david-deboer/hera-cad/Node/PCB/PCB022618/README.txt

The DSUB9 cutouts on the front panel are too small for the connectors.
For the connectors to fit properly, file out 20 mills on each angled side
of the cutout.
