david-deboer/hera-cad/graphics/IMG_1570.jpg

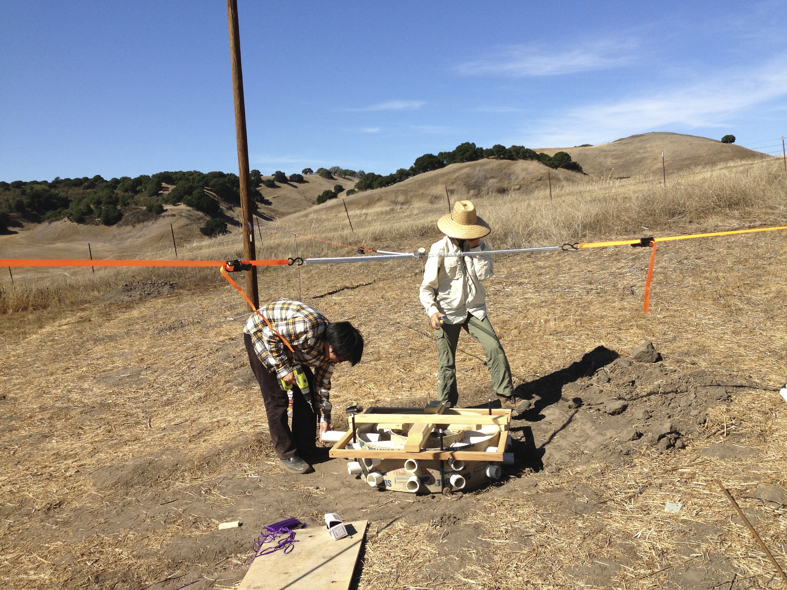
graphics/IMG_1570.jpg
