david-deboer/hera-cad/HERAbackdrop.jpg

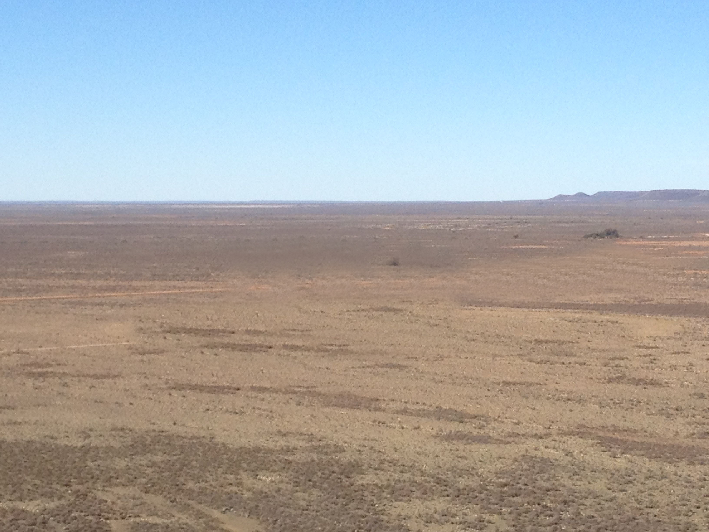
HERAbackdrop.jpg
