david-deboer/hera-cad/Node/Concept-ICTS/ICTS-20170411/image001.jpg

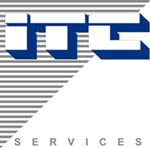
Node/Concept-ICTS/ICTS-20170411/image001.jpg
