david-deboer/hera-cad/Node/fullNewNode.png

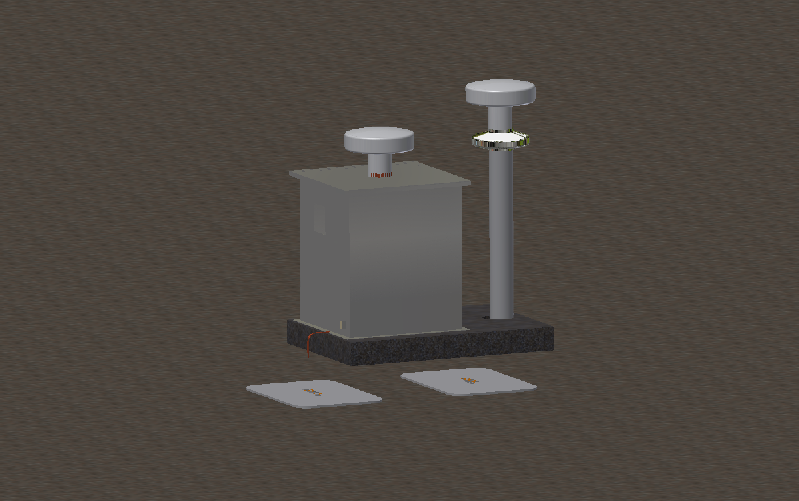
Node/fullNewNode.png
