david-deboer/hera-cad/Node/NMT/BB_OUTLINE.png

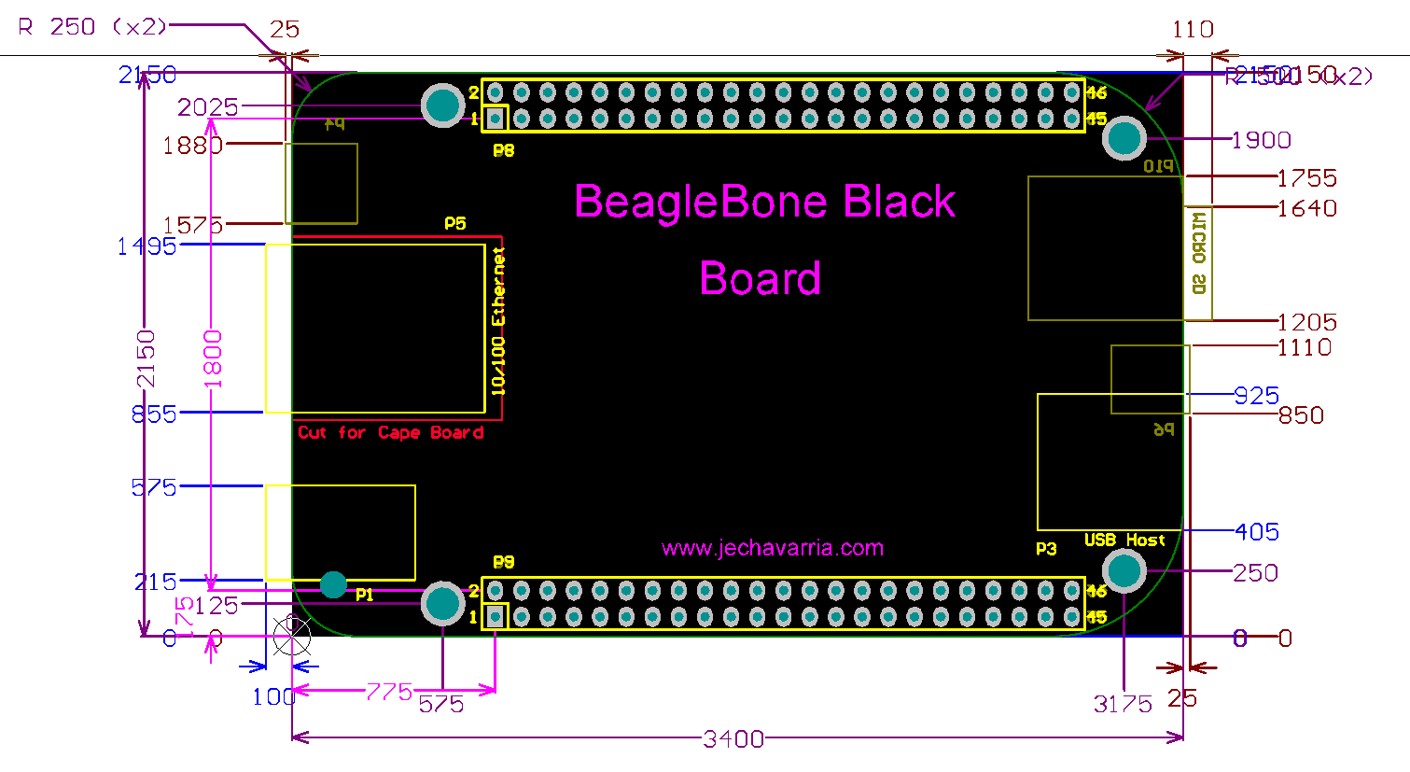
Node/NMT/BB_OUTLINE.png
