david-deboer/hera-cad/Node/node1.png

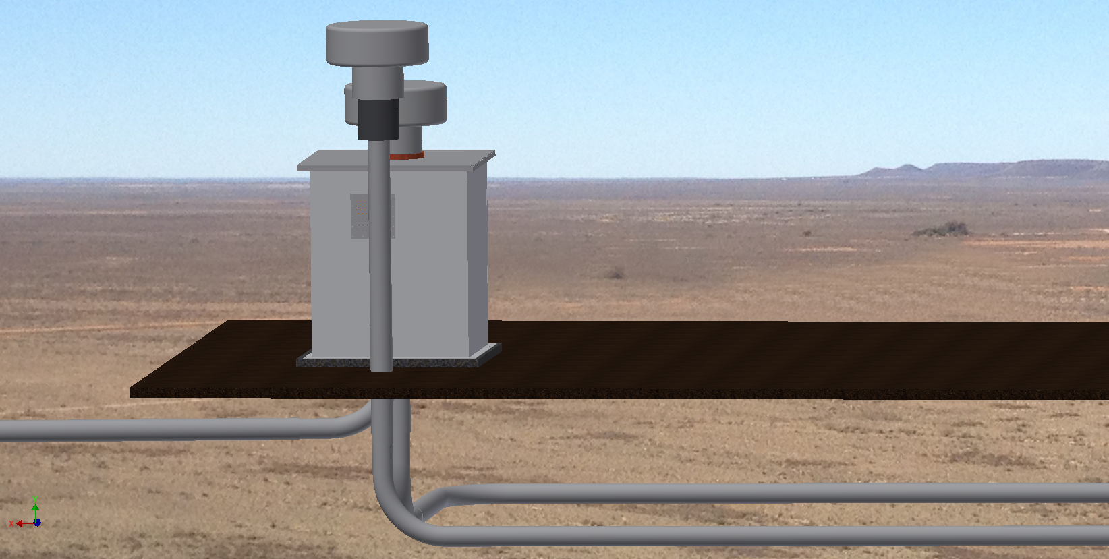
Node/node1.png
