david-deboer/hera-cad/Node/node3.png

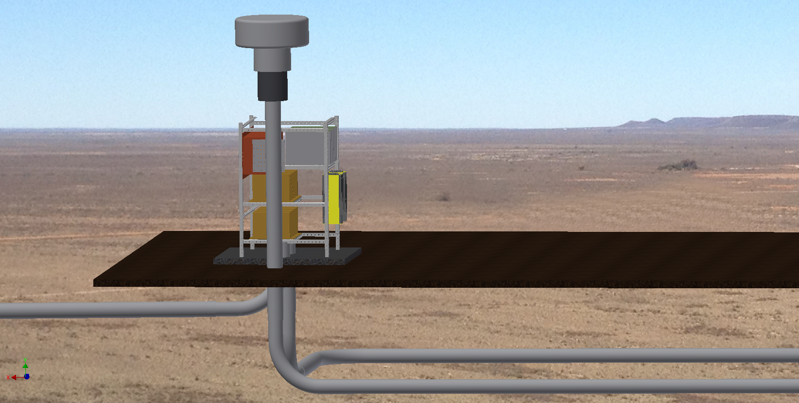
Node/node3.png
