david-deboer/hera-cad/Node/node4.png

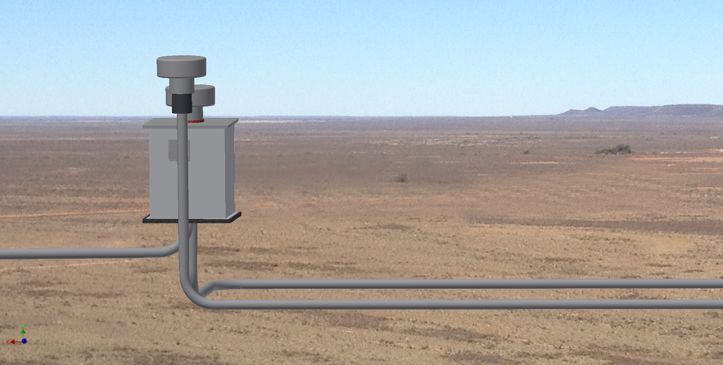
Node/node4.png
