david-deboer/hera-cad/Node/node_c.bmp

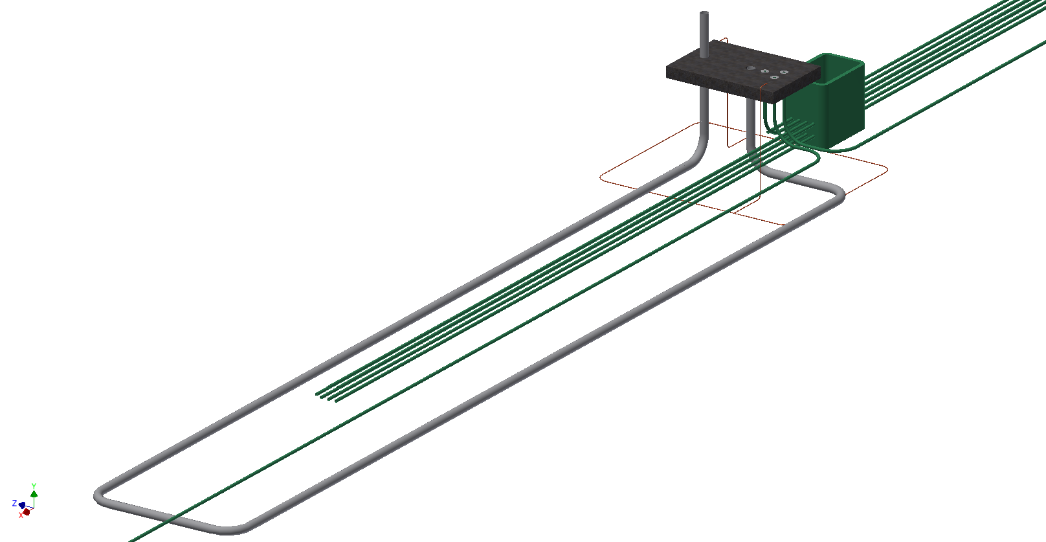
Node/node_c.bmp
