david-deboer/hera-cad/Node/PCB/PCB022618/arduino-pcb-mech-imperial.png

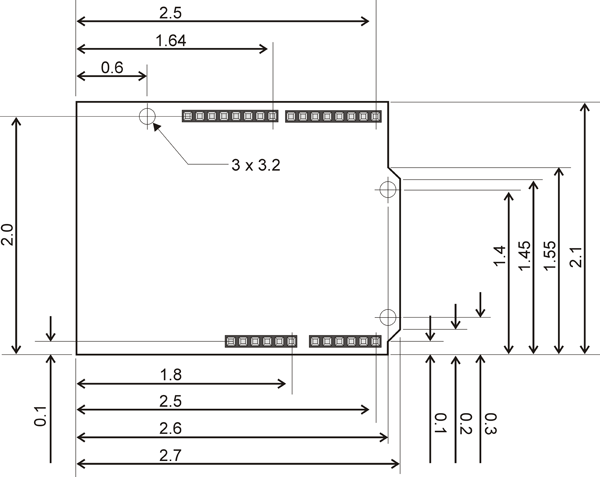
Node/PCB/PCB022618/arduino-pcb-mech-imperial.png
