david-deboer/hera-cad/PDFs/Node/grounding_layout2.PNG

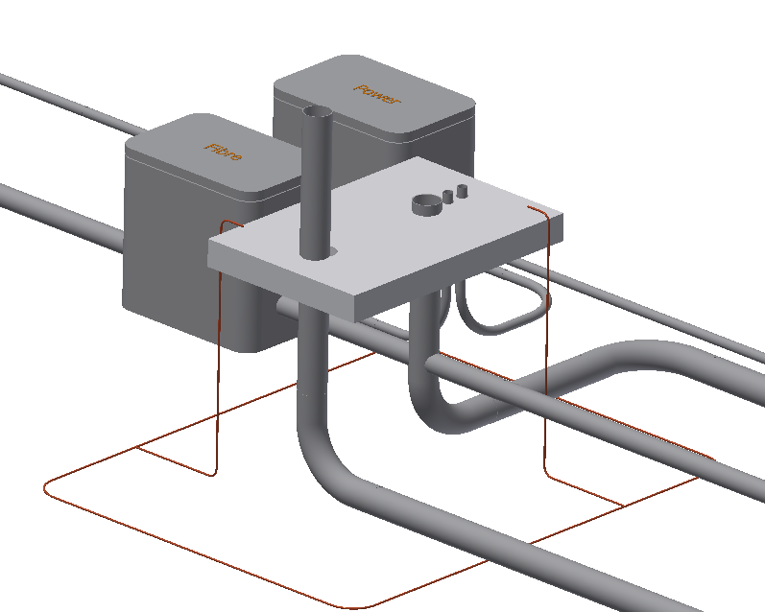
PDFs/Node/grounding_layout2.PNG
