david-deboer/hera-cad/PDFs/Node/grounding_layout.PNG

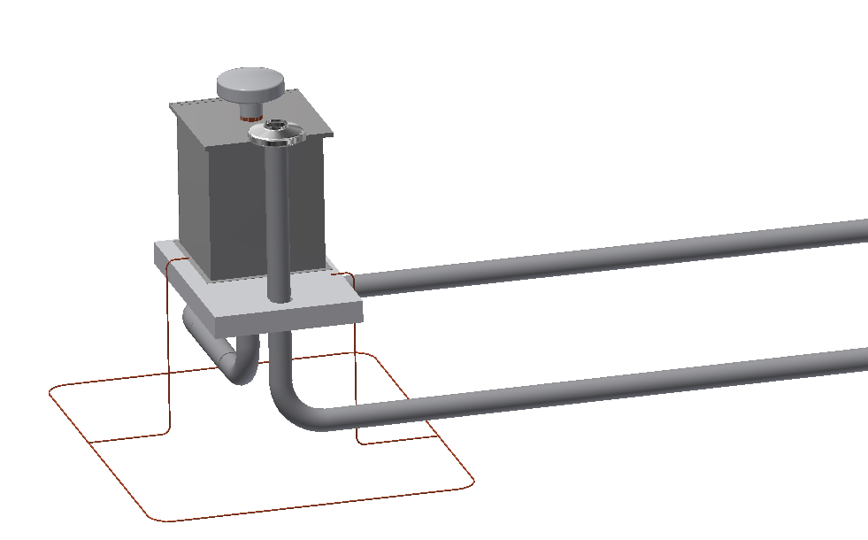
PDFs/Node/grounding_layout.PNG
