david-deboer/hera-cad/bom.xls

Sheet: PARTS LIST
ITEM | QTY | PART NUMBER | DESCRIPTION | ESTIMATED COST | FILE NAME
1 | 3 | 0D | anchor D for feed | $4.00 | D.ipt
2 | 24 | 0T2split | split 2" pvc T | $5.00 | pvc_T_2in_modSplit.ipt
3 | 19 | 0eye_ss_375 | 0.375 stainless eyebolt | $3.00 | *Varies*
4 | 1 | 0fasteners | catch all for fasteners | $200.00 | plat.ipt
5 | 1 | 0nut_ss_375 | 0.375 stainless nut | $0.30 | nut_ss_375.ipt
6 | 9 | 0pulley | feed pulley | $5.00 | pulley.ipt
7 | 6 | 0pvc_T_0.75 | 3/4" PVC Tee | $1.00 | pvc_T_0.75in.ipt
8 | 24 | 0pvc_T_2in | Support PVC T | $3.00 | pvc_T_2in.ipt
9 | 6 | 0spring | feed strong spring | $8.00 | spring.ipt
13 | 4 | 2f1ah | Arm holder | $5.00 | dipoleArmHold.ipt
14 | 4 | 2f1ar | Feed arm pipe rest | $8.00 | dipoleArmRest.ipt
15 | 4 | 2f1arm | Feed arm pipe | $8.00 | dipoleArm.ipt
16 | 2 | 2f1bd | Feed bottom disk | $10.00 | *Varies*
17 | 2 | 2f1col | Feed mast collar | $30.00 | collar.ipt
18 | 4 | 2f1ds | Feed disk spacer | $2.00 | dipoleDiscSpacer.ipt
19 | 1 | 2f1mast | Feed mast | $1.00 | dipoleMast.ipt
21 | 1 | 2f2al | Feed backplane support crosspiece | $20.00 | bpSupCross.ipt
22 | 6 | 2f2ao | Feed backplane support cross piece | $10.00 | bpSupOuter.ipt
23 | 6 | 2f2arc | feed backplane pvc arc | $2.00 | bpSupArc.ipt
24 | 2 | 2f2ax1 | Feed backplane support interior piece | $10.00 | bpSupInner1.ipt
25 | 2 | 2f2ax2 | Feed backplane support interior piece 2 | $10.00 | bpSupInner2.ipt
26 | 6 | 2f2barm | PVC arm for feed backplane | $2.00 | bpSupArm.ipt
27 | 1 | 2f2surf | Feed backplane conducting surface | $10.00 | bpScreen.ipt
28 | 1 | 2f3kcl | feed central tension line | $5.00 | centralLine.ipt
29 | 1 | 2f3lna | Feed lna dummy load | $250.00 | lna.ipt
30 | 1 | 2h1sin | Hub inner sonotube | $5.00 | sonotubeInner.ipt
31 | 1 | 2h1sout | Hub outer sonotube | $15.00 | sonotubeOuter.ipt
32 | 1 | 2h2cond | Hub signal/power conduit | $1.00 | conduit.ipt
33 | 24 | 2h2slv | Hub mating sleeve | $1.00 | *Varies*
34 | 1 | 2h3rbb | Hub rebar cross bar | $1.00 | rebarbar.ipt
35 | 1 | 2h3rbc | Hub rebar circle | $1.00 | rebarcircle.ipt
36 | 1 | 2h4cem | Hub cement | $8.00 | cement.ipt
38 | 21 | 2p1h37 | end holder 37 degree | $10.00 | end37.ipt
39 | 21 | 2p1hh | end horizontal holder | $20.00 | endHoriz.ipt
42 | 3 | 2p2kfs | Kevlar feed support | $5.00 | kevlarFeed.ipt
43 | 3 | 2p2pol | support pole | $60.00 | pole.ipt
44 | 9 | 2p2ps37 | Pole stand support 37 degree | $4.00 | poleStand37.ipt
45 | 9 | 2p2ps45 | pole stand support 45 degree | $2.00 | poleStand45.ipt
46 | 9 | 2p2psh1 | pole stand support horizontal 1 | $2.00 | poleStandHoriz1.ipt
47 | 9 | 2p2psh2 | pole stand support horizontal 2 | $2.00 | poleStandHoriz2.ipt
48 | 9 | 2p2psh3 | Pole stand support horizontal 3 | $2.00 | poleStandHoriz3.ipt
49 | 9 | 2p2psv | Pole stand vertical support | $2.00 | poleStandVert.ipt
52 | 9 | 2p3cem | Support stand cement | $10.00 | postCement.ipt
54 | 9 | 2p3post | Support stand post | $20.00 | post.ipt
55 | 9 | 2p3pse | post screen extender | $10.00 | postExtender.ipt
56 | 27 | 2p3reb | Support stand rebar | $0.20 | postRebar.ipt
58 | 9 | 2p3sono | Support stand sonotube | $3.00 | postSonotube.ipt
59 | 12 | 2p4irsh | intermediate rim spar holder | $5.00 | rimIntermediateSparHolder.ipt
60 | 12 | 2p4rim | rim piece | $10.00 | rimHoriz.ipt
61 | 12 | 2p5Tmod | modified 2" support pvc | $8.00 | pvc_T_2in_modPipe.ipt
62 | 12 | 2p5rss | Hub radial support spar | $3.20 | sparHoriz.ipt
63 | 12 | 2p5vss | support vertical spar | $2.00 | sparVert.ipt
66 | 12 | 2r1isp | 2" PVC radial spar (24') | $18.00 | sparIntermediate.ipt
68 | 24 | 2r2scs | spar cross support holder | $1.00 | cross.ipt
69 | 12 | 2r3pA | surface panel A | $15.00 | panelA.ipt
70 | 24 | 2r3pB | surface panel B | $15.00 | *Varies*
71 | 24 | 2r3pC | surface panel C | $10.00 | panelC.ipt
72 | 24 | 2r3pD | surface panel D | $10.00 | panelD.ipt
73 | 24 | 2r3pE | surface panel E | $10.00 | panelE.ipt
74 | 12 | 2r4sci | screen - intermediate | $20.00 | screenInt.ipt
81 | 18 | 1p2poscr | Pole screen holder | $10.00 | *Varies*
86 | 12 | heightMarker |  |  | heightMarker.ipt
88 | 1 | ramp |  |  | ramp.ipt
89 | 21 | endWoodblock |  |  | endWoodblock.ipt
91 | 12 | 2r1spar | full pvc spar | $25.00 | sparFull.ipt
92 | 24 | 2p6fs1 | inner furring strip | $1.00 | furringStrip1.ipt
93 | 24 | 2p6fs2 | second furring strip | $1.00 | furringStrip2.ipt
94 | 1 | matingBoard |  |  | matingBoard.ipt
95 | 21 | endChannelB |  |  | endChannel.ipt
96 | 21 | endChannel_MIR |  |  | endChannel_MIR.ipt
97 | 21 | endBlock |  |  | endBlock.ipt
98 | 2.854 in | 9916-BLK.Wire1 | 9916-BLK |  | feedAssembly.ShortRF.iam
99 | 2.559 in | 9916-BLK.Wire2 | 9916-BLK |  | feedAssembly.ShortRF.iam
100 | 2.773 in | 9916-BLK.Wire3 | 9916-BLK |  | feedAssembly.ShortRF.iam
101 | 2.867 in | 9916-BLK.Wire4 | 9916-BLK |  | feedAssembly.ShortRF.iam
102 | 3 | 0winch | winch to hoist feed | $25.00 | winch.ipt
103 | 3 | 0wrab | thick right angle for winch | $8.00 | thickRightAngle.ipt
104 | 1 | totalStation |  |  | totalStation.ipt
105 | 1 | vertex |  |  | vertex.ipt
106 | 21 | endcapTarget |  |  | endcapTarget.ipt
107 | 21 | screw_10 |  |  | screw_8.ipt
108 | 27 | washer_3_8 |  |  | washer_3-8.ipt
109 | 27 | lagBolt_38 |  |  | lagBolt_3-8.ipt
110 | 21 | angleBracket |  |  | angleBracket.ipt
113 | 9 | feedCableStay1 |  |  | feedCableStay1.ipt
114 | 9 | feedCableStay2 |  |  | feedCableStay2.ipt
115 | 12 | 2p3ph | post horizontal holder | $2.00 | postStandHoriz.ipt
116 | 12 | 2p3s37 | Post stand support 37 degree | $1.00 | postStand37.ipt
117 | 3 | kevlarCentering |  |  | centeringKevlar.ipt
118 | 1 | ringCentering |  |  | centeringRing.ipt
119 | 4 | hubjig_side1 |  |  | *Varies*
120 | 2 | hubjig_cross |  |  | hubjig_cross.ipt
121 | 2 | hubjig_spacer |  |  | hubjig_spacer.ipt
122 | 2 | hubjig_blocks |  |  | hubjig_block.ipt
123 | 4 | hubjig_tab |  |  | hubjig_tab.ipt
124 | 12 | sparSplit2_5 |  |  | sparSplit2_5.ipt

Sheet: PARTS_LIST
ITEM | QTY | PART NUMBER | DESCRIPTION | ESTIMATED COST | FILE NAME
1 | 3 | 0D | anchor D for feed | $4.00 | D.ipt
2 | 24 | 0T2split | split 2" pvc T | $5.00 | pvc_T_2in_modSplit.ipt
3 | 19 | 0eye_ss_375 | 0.375 stainless eyebolt | $3.00 | *Varies*
4 | 1 | 0fasteners | catch all for fasteners | $200.00 | plat.ipt
5 | 1 | 0nut_ss_375 | 0.375 stainless nut | $0.30 | nut_ss_375.ipt
6 | 9 | 0pulley | feed pulley | $5.00 | pulley.ipt
7 | 6 | 0pvc_T_0.75 | 3/4" PVC Tee | $1.00 | pvc_T_0.75in.ipt
8 | 24 | 0pvc_T_2in | Support PVC T | $3.00 | pvc_T_2in.ipt
9 | 6 | 0spring | feed strong spring | $8.00 | spring.ipt
13 | 4 | 2f1ah | Arm holder | $5.00 | dipoleArmHold.ipt
14 | 4 | 2f1ar | Feed arm pipe rest | $8.00 | dipoleArmRest.ipt
15 | 4 | 2f1arm | Feed arm pipe | $8.00 | dipoleArm.ipt
16 | 2 | 2f1bd | Feed bottom disk | $10.00 | *Varies*
17 | 2 | 2f1col | Feed mast collar | $30.00 | collar.ipt
18 | 4 | 2f1ds | Feed disk spacer | $2.00 | dipoleDiscSpacer.ipt
19 | 1 | 2f1mast | Feed mast | $1.00 | dipoleMast.ipt
21 | 1 | 2f2al | Feed backplane support crosspiece | $20.00 | bpSupCross.ipt
22 | 6 | 2f2ao | Feed backplane support cross piece | $10.00 | bpSupOuter.ipt
23 | 6 | 2f2arc | feed backplane pvc arc | $2.00 | bpSupArc.ipt
24 | 2 | 2f2ax1 | Feed backplane support interior piece | $10.00 | bpSupInner1.ipt
25 | 2 | 2f2ax2 | Feed backplane support interior piece 2 | $10.00 | bpSupInner2.ipt
26 | 6 | 2f2barm | PVC arm for feed backplane | $2.00 | bpSupArm.ipt
27 | 1 | 2f2surf | Feed backplane conducting surface | $10.00 | bpScreen.ipt
28 | 1 | 2f3kcl | feed central tension line | $5.00 | centralLine.ipt
29 | 1 | 2f3lna | Feed lna dummy load | $250.00 | lna.ipt
30 | 1 | 2h1sin | Hub inner sonotube | $5.00 | sonotubeInner.ipt
31 | 1 | 2h1sout | Hub outer sonotube | $15.00 | sonotubeOuter.ipt
32 | 1 | 2h2cond | Hub signal/power conduit | $1.00 | conduit.ipt
33 | 24 | 2h2slv | Hub mating sleeve | $1.00 | sleeve.ipt
34 | 1 | 2h3rbb | Hub rebar cross bar | $1.00 | rebarbar.ipt
35 | 1 | 2h3rbc | Hub rebar circle | $1.00 | rebarcircle.ipt
36 | 1 | 2h4cem | Hub cement | $8.00 | cement.ipt
38 | 21 | 2p1h37 | end holder 37 degree | $10.00 | end37.ipt
39 | 21 | 2p1hh | end horizontal holder | $20.00 | endHoriz.ipt
42 | 3 | 2p2kfs | Kevlar feed support | $5.00 | kevlarFeed.ipt
43 | 3 | 2p2pol | support pole | $60.00 | pole.ipt
44 | 9 | 2p2ps37 | Pole stand support 37 degree | $4.00 | poleStand37.ipt
45 | 9 | 2p2ps45 | pole stand support 45 degree | $2.00 | poleStand45.ipt
46 | 9 | 2p2psh1 | pole stand support horizontal 1 | $2.00 | poleStandHoriz1.ipt
47 | 9 | 2p2psh2 | pole stand support horizontal 2 | $2.00 | poleStandHoriz2.ipt
48 | 9 | 2p2psh3 | Pole stand support horizontal 3 | $2.00 | poleStandHoriz3.ipt
49 | 9 | 2p2psv | Pole stand vertical support | $2.00 | poleStandVert.ipt
52 | 9 | 2p3cem | Support stand cement | $10.00 | postCement.ipt
54 | 9 | 2p3post | Support stand post | $20.00 | post.ipt
55 | 9 | 2p3pse | post screen extender | $10.00 | postExtender.ipt
56 | 27 | 2p3reb | Support stand rebar | $0.20 | postRebar.ipt
58 | 9 | 2p3sono | Support stand sonotube | $3.00 | postSonotube.ipt
59 | 12 | 2p4irsh | intermediate rim spar holder | $5.00 | rimIntermediateSparHolder.ipt
60 | 12 | 2p4rim | rim piece | $10.00 | rimHoriz.ipt
61 | 12 | 2p5Tmod | modified 2" support pvc | $8.00 | pvc_T_2in_modPipe.ipt
62 | 12 | 2p5rss | Hub radial support spar | $3.20 | sparHoriz.ipt
63 | 12 | 2p5vss | support vertical spar | $2.00 | sparVert.ipt
66 | 12 | 2r1isp | 2" PVC radial spar (24') | $18.00 | sparIntermediate.ipt
68 | 24 | 2r2scs | spar cross support holder | $1.00 | cross.ipt
69 | 12 | 2r3pA | surface panel A | $15.00 | panelA.ipt
70 | 24 | 2r3pB | surface panel B | $15.00 | *Varies*
71 | 24 | 2r3pC | surface panel C | $10.00 | panelC.ipt
72 | 24 | 2r3pD | surface panel D | $10.00 | panelD.ipt
73 | 24 | 2r3pE | surface panel E | $10.00 | panelE.ipt
74 | 12 | 2r4sci | screen - intermediate | $20.00 | screenInt.ipt
81 | 18 | 1p2poscr | Pole screen holder | $10.00 | *Varies*
86 | 12 | heightMarker |  |  | heightMarker.ipt
88 | 1 | ramp |  |  | ramp.ipt
89 | 21 | endWoodblock |  |  | endWoodblock.ipt
91 | 12 | 2r1spar | full pvc spar | $25.00 | sparFull.ipt
92 | 24 | 2p6fs1 | inner furring strip | $1.00 | furringStrip1.ipt
93 | 24 | 2p6fs2 | second furring strip | $1.00 | furringStrip2.ipt
94 | 1 | matingBoard |  |  | matingBoard.ipt
95 | 21 | endChannelB |  |  | endChannel.ipt
96 | 21 | endChannel_MIR |  |  | endChannel_MIR.ipt
97 | 21 | endBlock |  |  | endBlock.ipt
98 | 2.854 in | 9916-BLK.Wire1 | 9916-BLK |  | feedAssembly.ShortRF.iam
99 | 2.559 in | 9916-BLK.Wire2 | 9916-BLK |  | feedAssembly.ShortRF.iam
100 | 2.773 in | 9916-BLK.Wire3 | 9916-BLK |  | feedAssembly.ShortRF.iam
101 | 2.867 in | 9916-BLK.Wire4 | 9916-BLK |  | feedAssembly.ShortRF.iam
102 | 3 | 0winch | winch to hoist feed | $25.00 | winch.ipt
103 | 3 | 0wrab | thick right angle for winch | $8.00 | thickRightAngle.ipt
104 | 1 | totalStation |  |  | totalStation.ipt
105 | 1 | vertex |  |  | vertex.ipt
106 | 21 | endcapTarget |  |  | endcapTarget.ipt
107 | 21 | screw_10 |  |  | screw_8.ipt
108 | 27 | washer_3_8 |  |  | washer_3-8.ipt
109 | 27 | lagBolt_38 |  |  | lagBolt_3-8.ipt
110 | 21 | angleBracket |  |  | angleBracket.ipt
113 | 9 | feedCableStay1 |  |  | feedCableStay1.ipt
114 | 9 | feedCableStay2 |  |  | feedCableStay2.ipt
115 | 12 | 2p3ph | post horizontal holder | $2.00 | postStandHoriz.ipt
116 | 12 | 2p3s37 | Post stand support 37 degree | $1.00 | postStand37.ipt
117 | 3 | kevlarCentering |  |  | centeringKevlar.ipt
118 | 1 | ringCentering |  |  | centeringRing.ipt
119 | 4 | hubjig_side1 |  |  | *Varies*
120 | 2 | hubjig_cross |  |  | hubjig_cross.ipt
121 | 2 | hubjig_spacer |  |  | hubjig_spacer.ipt
122 | 2 | hubjig_blocks |  |  | hubjig_block.ipt
123 | 4 | hubjig_tab |  |  | hubjig_tab.ipt
