david-deboer/hera-cad/procurement.xlsx

Sheet: PARTS_LIST
ITEM | QTY | PART NUMBER | DESCRIPTION | FILE NAME
1 | 1 | 0fasteners | catch all for fasteners | plat.ipt
2 | 1 | 2h | Hub | hub.iam
2.1 | 1 | 2h1sin | Hub inner sonotube | sonotubeInner.ipt | x
2.2 | 1 | 2h1sout | Hub outer sonotube | sonotubeOuter.ipt | x
2.3 | 1 | 2h2cond | Hub signal/power conduit | conduit.ipt
2.4 | 24 | 2h2slv | Hub mating sleeve | sleeve.ipt
2.5 | 1 | 2h3rbb | Hub rebar cross bar | rebarbar.ipt
2.6 | 1 | 2h3rbc | Hub rebar circle | rebarcircle.ipt
2.7 | 1 | 2h4cem | Hub cement | cement.ipt
3 | 3 | poleAssembly |  | poleAssembly.iam
3.1 | 1 | 2p2pol | support pole | pole.ipt
3.2 | 3 | poleStand |  | poleStandVertAssy.iam
3.2.1 | 1 | 2p2psv | Pole stand vertical support | poleStandVert.ipt
3.2.2 | 1 | 2p2ps45 | pole stand support 45 degree | poleStand45.ipt
3.2.3 | 1 | 2p2psh1 | pole stand support horizontal 1 | poleStandHoriz1.ipt
3.2.9 | 2 | 1p2poscr | Pole screen holder | *Varies*
3.2.10 | 3 | washer_3_8 |  | washer_3-8.ipt
3.2.11 | 3 | lagBolt_38 |  | lagBolt_3-8.ipt
3.3 | 6 | 0eye_ss_375 | 0.375 stainless eyebolt | *Varies*
3.5 | 1 | heightMarker |  | heightMarker.ipt
3.6 | 3 | poleStandHorizAssyB |  | poleStandHorizAssy.iam
3.7 | 3 | 0pulley | feed pulley | pulley.ipt
3.8 | 1 | winchAssembly |  | winchAssembly.iam
3.9 | 3 | feedCableStay |  | feedCableStay.iam
4 | 9 | postAssembly |  | postAssembly.iam
4.1 | 1 | 2p3sono | Support stand sonotube | postSonotube.ipt
4.2 | 3 | 2p3reb | Support stand rebar | postRebar.ipt
4.3 | 1 | 2p3post | Support stand post | post.ipt
4.4 | 1 | 2p3pse | post screen extender | postExtender.ipt
4.5 | 1 | 2p3cem | Support stand cement | postCement.ipt
4.9 | 1 | heightMarker |  | heightMarker.ipt
4.11 | 1 | postStandSupport |  | postStandSupport.iam
6 | 12 | sparAssembly |  | sparAssembly.iam
6.1 | 1 | 2p5rss | Hub radial support spar | sparHoriz.ipt
6.2 | 1 | 2p5Tmod | modified 2" support pvc | pvc_T_2in_modPipe.ipt
6.3 | 1 | 2p5vss | support vertical spar | sparVert.ipt
6.4 | 1 | 0pvc_T_2in | Support PVC T | pvc_T_2in.ipt
7 | 12 | crossAssembly |  | crossAssembly.iam
7.1 | 2 | 0T2split | split 2" pvc T | pvc_T_2in_modSplit.ipt
7.2 | 2 | 2r2scs | spar cross support holder | cross.ipt
7.3 | 1 | 0pvc_T_2in | Support PVC T | pvc_T_2in.ipt
8 | 12 | 2r1isp | 2" PVC radial spar (24') | sparIntermediate.ipt
9 | 12 | 2r3pA | surface panel A | panelA.ipt
10 | 24 | 2r3pE | surface panel E | panelE.ipt
11 | 12 | rimAssembly |  | rimAssembly.iam
11.1 | 1 | 2p4rim | rim piece | rimHoriz.ipt
11.2 | 1 | 2p4irsh | intermediate rim spar holder | rimIntermediateSparHolder.ipt
12 | 1 | 2f | Feed assembly | feedAssembly.iam
12.1 | 1 | 2f2 | Feed backplane support assembly | bpSupAssembly.iam
12.1.1 | 1 | 2f2al | Feed backplane support crosspiece | bpSupCross.ipt
12.1.2 | 6 | 2f2ao | Feed backplane support cross piece | bpSupOuter.ipt
12.1.3 | 2 | 2f2ax1 | Feed backplane support interior piece | bpSupInner1.ipt
12.1.4 | 2 | 2f2ax2 | Feed backplane support interior piece 2 | bpSupInner2.ipt
12.1.5 | 1 | 2f1col | Feed mast collar | collar.ipt
12.1.6 | 6 | 2f2barm | PVC arm for feed backplane | bpSupArm.ipt
12.1.7 | 1 | 0eye_ss_375 | 0.375 stainless eyebolt | eyebolt_ss_375.ipt
12.1.8 | 1 | 0nut_ss_375 | 0.375 stainless nut | nut_ss_375.ipt
12.1.9 | 6 | 0pvc_T_0.75 | 3/4" PVC Tee | pvc_T_0.75in.ipt
12.1.10 | 6 | 2f2arc | feed backplane pvc arc | bpSupArc.ipt
12.1.11 | 1 | 2f2surf | Feed backplane conducting surface | bpScreen.ipt
12.1.12 | 3 | 0D | anchor D for feed | D.ipt
12.2 | 1 | 2f1 | Feed dipole | dipole.iam
12.2.1 | 2 | 2f1bd | Feed bottom disk | *Varies*
12.2.3 | 4 | 2f1arm | Feed arm pipe | dipoleArm.ipt
12.2.4 | 4 | 2f1ds | Feed disk spacer | dipoleDiscSpacer.ipt
12.2.6 | 1 | 2f1col | Feed mast collar | collar.ipt
12.2.7 | 1 | 2f1mast | Feed mast | dipoleMast.ipt
12.2.8 | 4 | 2f1ah | Arm holder | dipoleArmHold.ipt
12.2.9 | 4 | 2f1ar | Feed arm pipe rest | dipoleArmRest.ipt
12.2.10 | 1 | matingBoard |  | matingBoard.ipt
12.3 | 1 | 2f3lna | Feed lna dummy load | lna.ipt
12.4 | 3 | 0spring | feed strong spring | spring.ipt
12.5 | 1 | 2f3kcl | feed central tension line | centralLine.ipt
12.7 | 1 | feedAssembly.ShortRF |  | feedAssembly.ShortRF.iam
14 | 3 | 2p2kfs | Kevlar feed support | kevlarFeed.ipt
21 | 24 | 2r3pB | surface panel B | *Varies*
22 | 24 | 2r3pC | surface panel C | panelC.ipt
23 | 24 | 2r3pD | surface panel D | panelD.ipt
24 | 12 | 2r4sci | screen - intermediate | screenInt.ipt
26 | 1 | ramp |  | ramp.ipt
27 | 12 | 2r1spar | full pvc spar | sparFull.ipt
28 | 24 | 2p6fs1 | inner furring strip | furringStrip1.ipt
29 | 24 | 2p6fs2 | second furring strip | furringStrip2.ipt
30 | 1 | totalStation |  | totalStation.ipt
31 | 1 | vertex |  | vertex.ipt
33 | 3 | postStandSupport |  | postStandSupport.iam
34 | 1 | centering |  | centering.iam
35 | 1 | hubjig |  | hubjig.iam

Sheet: Procurement
Poles
30 | 7+ m | 6-8" diameter
 |  |  |  |  | Meters needed
Hubs
25 | 1' | 36" sonotube (in 10" lengths)
25 | 1' | 18" sonotube (in 10" lengths)
30 | 10' | 3"conduit (in 12" lengths) |  |  | 7.62
40 | 10' | 2.5" conduit (in 12" lengths) |  |  | 10.16
20 | 10' | 3/8" rebar
PVC
1775 | 10' | 2" sch 40 pvc | 71 |  | 450.85
1500 |  | 2" T | 60
900 |  | 2" couplers | 36
 |  |  |  | 741.68 | 914.4

Sheet: SA
 |  |  |  | Antenna Number
Item | qty | #/antenna | qty/antenna | 19 | 37 | 91 | 331 | 352 | Unit
spar (long) | 7.45 | 12 | 89.4 | 1698.6 | 3307.8 | 8135.4 | 29591.4 | 31468.8 | m
spar (short) | 3.07 | 12 | 36.84 | 699.96 | 1363.08 | 3352.44 | 12194.04 | 12967.68 | m
support (horiz) | 3 | 12 | 36 | 684 | 1332 | 3276 | 11916 | 12672 | m
support (vert) | 0.5 | 12 | 6 | 114 | 222 | 546 | 1986 | 2112 | m
63mm PVC-M class 20 | 14.02 | 12 | 168.24 | 3196.56 | 6224.88 | 15309.84 | 55687.44 | 59220.48 | m
90mm PVC-M class 20 | 0.3 | 12 | 3.6 | 68.4 | 133.2 | 327.6 | 1191.6 | 1267.2 | m
63mm T couplers | 1 | 12 | 12 | 228 | 444 | 1092 | 3972 | 4224 | m
63mm couplers | 1 | 12 | 12 | 228 | 444 | 1092 | 3972 | 4224 | m
rim (wood 40x150mm x 3.7m) | 3.66 | 12 | 43.92 | 834.48 | 1625.04 | 3996.72 | 14537.52 | 15459.84 | m
concrete | 1 | 1 | 1 | 19 | 37 | 91 | 331 | 352 | m3
poles |  |  |  | 27 | 48 | 108 | 363 | 426 | #
posts | 3 |  |  | 129 | 243 | 579 | 2049 | 2238 | #
mesh (10x10mm welded square - 1.2m rolls) | 180 | 1 | 180 | 3420 | 6660 | 16380 | 59580 | 63360 | m2
chicken wire (1.5m rolls?) | 131.9468915 | 1 | 131.9468915 | 2506.990938 | 4882.034984 | 12007.16712 | 43674.42107 | 46445.30579 | m2
kevlar guy line | 12 | 3 | 36 | 684 | 1332 | 3276 | 11916 | 12672 | m
high-tension springs | 1 | 3 | 3 | 57 | 111 | 273 | 993 | 1056 | #
feed backplanes (assembled light structure) | 1 | 1 | 1 | 19 | 37 | 91 | 331 | 352 | #
feed support plate (welded structure) | 1 | 1 | 1 | 19 | 37 | 91 | 331 | 352 | #
ratchet hoist | 1 | 3 |  | 81 | 144 | 324 | 1089 | 1278 | #
support endcaps (welded structure) | 1 | 12 | 12 | 228 | 444 | 1092 | 3972 | 4224 | #
