david-deboer/hera-cad/Node/SNAP_V2/Design Data/XLS/en-US/Thread.xls

Sheet: ANSI Unified Screw Threads
I Q | ANSI Unified Screw Threads |  | Sort Order -1 |  | External |  |  |  |  |  |  | Internal
 |  |  |  |  |  | Major Dia |  | Pitch Dia |  | Minor Dia |  |  | Minor Dia |  | Pitch Dia |  | Major Dia |  | Tap Drill
Size | Size Suffix | Thread Designation | Custom Thread Designation | TPI | Class | Max | Min | Max | Min | Max | Min | Class | Min | Max | Min | Max | Min | Max | Basic
0.0118 |  | 30-318 UNM | 30-318 UNM | 318 | 2A | 0.0118 | 0.0112 | 0.0098 | 0.0092 | 0.0080 |  | 2B | 0.0085 | 0.0100 | 0.0098 | 0.0103 | 0.0120 |  | 0.0083
0.0138 |  | 35-282 UNM | 35-282 UNM | 282 | 2A | 0.0138 | 0.0131 | 0.0115 | 0.0109 | 0.0095 |  | 2B | 0.0101 | 0.0117 | 0.0115 | 0.0121 | 0.0140 |  | 0.0096
0.0157 |  | 40-254 UNM | 40-254 UNM | 254 | 2A | 0.0157 | 0.0150 | 0.0132 | 0.0126 | 0.0110 |  | 2B | 0.0117 | 0.0134 | 0.0132 | 0.0138 | 0.0160 |  | 0.0110
0.0177 |  | 45-254 UNM | 45-254 UNM | 254 | 2A | 0.0177 | 0.0170 | 0.0152 | 0.0145 | 0.0130 |  | 2B | 0.0136 | 0.0154 | 0.0152 | 0.0158 | 0.0180 |  | 0.0124
0.0197 |  | 50-203 UNM | 50-203 UNM | 203 | 2A | 0.0197 | 0.0189 | 0.0165 | 0.0158 | 0.0138 |  | 2B | 0.0146 | 0.0166 | 0.0165 | 0.0172 | 0.0200 |  | 0.0138
0.021 |  | 0000-160 NS | 0000-160 NS | 160 | 2A | 0.021 | 0.0195 | 0.0169 | 0.0158 | 0.0128 |  | 2B | 0.0169 | 0.0181 | 0.0169 | 0.0181 | 0.021
0.0217 |  | 55-203 UNM | 55-203 UNM | 203 | 2A | 0.0217 | 0.0208 | 0.0185 | 0.0178 | 0.0157 |  | 2B | 0.0165 | 0.0186 | 0.0185 | 0.0192 | 0.0220 |  | 0.0150
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
2.25 |  | 2 1/4-6 UN | 2 1/4-6 UN | 6 | 3A | 2.25 | 2.2318 | 2.1417 | 2.1351 | 2.0516 |  | 3B | 2.07 | 2.0896 | 2.1417 | 2.1502 | 2.25 |  | 2.0938
2.25 |  | 2 1/4-8 UN | 2 1/4-8 UN | 8 | 2A | 2.2476 | 2.2326 | 2.1664 | 2.1584 | 2.0988 |  | 2B | 2.115 | 2.14 | 2.1688 | 2.1792 | 2.25 |  | 2.125

Sheet: Inch Tapping Threads
I Q X | Inch Tapping Threads |  | Sort Order - 5 |  | External |  |  |  |  |  |  | Internal
 |  |  |  |  |  | Major Dia |  | Pitch Dia |  | Minor Dia |  |  | Minor Dia |  | Pitch Dia |  | Major Dia |  | Tap Drill
Size | Size Suffix | Thread Designation | Custom Thread Designation | TPI | Class | Max | Min | Max | Min | Max | Min | Class | Min | Max | Min | Max | Min | Max | Basic
0.0600 |  | 0-48 | 0-48 | 48 | 2B | 0.0600 | 0.0540 | 0.0480 | 0.0435 | 0.0360 | 0.0330
0.0730 |  | 1-42 | 1-42 | 42 | 2B | 0.0750 | 0.0690 | 0.0620 | 0.0575 | 0.0490 | 0.0460
0.0860 |  | 2-32 | 2-32 | 32 | 2B | 0.0880 | 0.0820 | 0.0760 | 0.0710 | 0.0640 | 0.0600
0.0990 |  | 3-28 | 3-28 | 28 | 2B | 0.1010 | 0.0950 | 0.0880 | 0.0830 | 0.0750 | 0.0710
0.1120 |  | 4-24 | 4-24 | 24 | 2B | 0.1140 | 0.1080 | 0.1000 | 0.0950 | 0.0860 | 0.0820
0.1250 |  | 5-20 | 5-20 | 20 | 2B | 0.1300 | 0.1230 | 0.1120 | 0.1065 | 0.0940 | 0.0900
0.1380 |  | 6-20 | 6-20 | 20 | 2B | 0.1390 | 0.1320 | 0.1215 | 0.1155 | 0.1040 | 0.0990
0.1510 |  | 7-19 | 7-19 | 19 | 2B | 0.1540 | 0.1470 | 0.1345 | 0.1280 | 0.1150 | 0.1090
0.1640 |  | 8-18 | 8-18 | 18 | 2B | 0.1660 | 0.1590 | 0.1440 | 0.1375 | 0.1220 | 0.1160
0.1900 |  | 10-16 | 10-16 | 16 | 2B | 0.1890 | 0.1820 | 0.1650 | 0.1585 | 0.1410 | 0.1350
0.2160 |  | 12-14 | 12-14 | 14 | 2B | 0.2150 | 0.2080 | 0.1895 | 0.1825 | 0.1640 | 0.1570
0.2420 |  | 14-14 | 14-14 | 14 | 2B | 0.2410 | 0.2340 | 0.2130 | 0.2060 | 0.1850 | 0.1780
0.2500 |  | 1/4-14 | 1/4-14 | 14 | 2B | 0.2460 | 0.2370 | 0.2190 | 0.2110 | 0.1920 | 0.1850
0.3125 |  | 5/16-12 | 5/16-12 | 12 | 2B | 0.3150 | 0.3060 | 0.2795 | 0.2710 | 0.2440 | 0.2360
0.3750 |  | 3/8-12 | 3/8-12 | 12 | 2B | 0.3800 | 0.3710 | 0.3445 | 0.3350 | 0.3090 | 0.2990
0.4375 |  | 7/16-10 | 7/16-10 | 10 | 2B | 0.4400 | 0.4290 | 0.3995 | 0.3890 | 0.3590 | 0.3490
0.5000 |  | 1/2-10 | 1/2-10 | 10 | 2B | 0.5040 | 0.4930 | 0.4635 | 0.4530 | 0.4230 | 0.4130

Sheet: Metric Forming Screw Threads
M P X | Metric Forming Screw Threads |  | Sort Order - 6 |  | External |  |  |  |  |  |  | Internal
 |  |  |  |  |  | Major Dia |  | Pitch Dia |  | Minor Dia |  |  | Minor Dia |  | Pitch Dia |  | Major Dia |  | Tap Drill
Size | Size Suffix | Thread Designation | Custom Thread Designation | Pitch | Class | Max | Min | Max | Min | Max | Min | Class | Min | Max | Min | Max | Min | Max | Basic
1.5 |  | 1.5x0.5 | 1.5x0.5 | 0.5 | 6g | 1.520 | 1.380 | 1.215 | 1.110 | 0.910 | 0.840
1.5 |  | ST1.5x0.5 | ST1.5x0.5 | 0.5 | 6g | 1.520 | 1.380 | 1.215 | 1.110 | 0.910 | 0.840
1.9 |  | 1.9x0.6 | 1.9x0.6 | 0.6 | 6g | 1.900 | 1.760 | 1.570 | 1.465 | 1.240 | 1.170
1.9 |  | ST1.9x0.6 | ST1.9x0.6 | 0.6 | 6g | 1.900 | 1.760 | 1.570 | 1.465 | 1.240 | 1.170
2.2 |  | 2.2x0.8 | 2.2x0.8 | 0.8 | 6g | 2.240 | 2.100 | 1.935 | 1.810 | 1.630 | 1.520
2.2 |  | ST2.2x0.8 | ST2.2x0.8 | 0.8 | 6g | 2.240 | 2.100 | 1.935 | 1.810 | 1.630 | 1.520
2.6 |  | 2.6x0.9 | 2.6x0.9 | 0.9 | 6g | 2.570 | 2.430 | 2.235 | 2.115 | 1.900 | 1.800
2.6 |  | ST2.6x0.9 | ST2.6x0.9 | 0.9 | 6g | 2.570 | 2.430 | 2.235 | 2.115 | 1.900 | 1.800
2.9 |  | 2.9x1 | 2.9x1 | 1 | 6g | 2.900 | 2.760 | 2.540 | 2.420 | 2.180 | 2.080
2.9 |  | 2.9x1.1 | 2.9x1.1 | 1.1 | 6g | 2.900 | 2.760 | 2.540 | 2.420 | 2.180 | 2.080
2.9 |  | ST2.9x1.1 | ST2.9x1.1 | 1.1 | 6g | 2.900 | 2.760 | 2.540 | 2.420 | 2.180 | 2.080
2.9 |  | 2.9x1.3 | 2.9x1.3 | 1.3 | 6g | 2.900 | 2.720 | 2.540 | 2.355 | 1.890 | 1.700
2.9 |  | 2.9x1.4 | 2.9x1.4 | 1.4 | 6g | 2.900 | 2.720 | 2.340 | 2.175 | 1.780 | 1.630
3.3 |  | 3.3x1.3 | 3.3x1.3 | 1.3 | 6g | 3.300 | 3.120 | 2.795 | 2.665 | 2.290 | 2.210
3.3 |  | ST3.3x1.3 | ST3.3x1.3 | 1.3 | 6g | 3.300 | 3.120 | 2.795 | 2.665 | 2.290 | 2.210
3.5 |  | 3.5x1.3 | 3.5x1.3 | 1.3 | 6g | 3.530 | 3.350 | 3.085 | 2.930 | 2.640 | 2.510
3.5 |  | ST3.5x1.3 | ST3.5x1.3 | 1.3 | 6g | 3.530 | 3.350 | 3.085 | 2.930 | 2.640 | 2.510
3.5 |  | 3.5x1.6 | 3.5x1.6 | 1.6 | 6g | 3.530 | 3.350 | 2.920 | 2.755 | 2.310 | 2.160
3.5 |  | 3.5x3.2 | 3.5x3.2 | 3.2 | 6g | 3.530 | 3.310 | 2.800 | 2.600 | 2.070 | 1.890
3.9 |  | 3.9x1.3 | 3.9x1.3 | 1.3 | 6g | 3.910 | 3.730 | 3.415 | 3.250 | 2.920 | 2.770
3.9 |  | ST3.9x1.3 | ST3.9x1.3 | 1.3 | 6g | 3.910 | 3.730 | 3.415 | 3.250 | 2.920 | 2.770
3.9 |  | 3.9x1.6 | 3.9x1.6 | 1.6 | 6g | 3.910 | 3.730 | 3.300 | 3.135 | 2.690 | 2.540
3.9 |  | 3.9x3.2 | 3.9x3.2 | 3.2 | 6g | 3.910 | 3.690 | 3.180 | 2.980 | 2.450 | 2.270
4.2 |  | 4.2x1.4 | 4.2x1.4 | 1.4 | 6g | 4.220 | 4.040 | 3.660 | 3.495 | 3.100 | 2.950
4.2 |  | ST4.2x1.4 | ST4.2x1.4 | 1.4 | 6g | 4.220 | 4.040 | 3.660 | 3.495 | 3.100 | 2.950
4.2 |  | 4.2x1.6 | 4.2x1.6 | 1.6 | 6g | 4.220 | 4.040 | 3.610 | 3.445 | 3.000 | 2.850
4.2 |  | 4.2x3.2 | 4.2x3.2 | 3.2 | 6g | 4.220 | 4.000 | 3.380 | 3.180 | 2.540 | 2.360
4.8 |  | 4.8x1.6 | 4.8x1.6 | 1.6 | 6g | 4.800 | 4.620 | 4.190 | 4.025 | 3.580 | 3.430
4.8 |  | ST4.8x1.6 | ST4.8x1.6 | 1.6 | 6g | 4.800 | 4.620 | 4.190 | 4.025 | 3.580 | 3.430
4.8 |  | 4.8x1.8 | 4.8x1.8 | 1.8 | 6g | 4.800 | 4.620 | 4.065 | 3.885 | 3.330 | 3.150
4.8 |  | 4.8x3.2 | 4.8x3.2 | 3.2 | 6g | 4.800 | 4.580 | 3.960 | 3.760 | 3.120 | 2.940
5.5 |  | 5.5x1.8 | 5.5x1.8 | 1.8 | 6g | 5.460 | 5.280 | 4.815 | 4.635 | 4.170 | 3.990
5.5 |  | ST5.5x1.8 | ST5.5x1.8 | 1.8 | 6g | 5.460 | 5.280 | 4.815 | 4.635 | 4.170 | 3.990
6.3 |  | 6.3x1.8 | 6.3x1.8 | 1.8 | 6g | 6.250 | 6.030 | 5.565 | 5.365 | 4.880 | 4.700
6.3 |  | ST6.3x1.8 | ST6.3x1.8 | 1.8 | 6g | 6.250 | 6.030 | 5.565 | 5.365 | 4.880 | 4.700
8.0 |  | 8x2.1 | 8x2.1 | 2.1 | 6g | 8.000 | 7.780 | 7.100 | 6.885 | 6.200 | 5.990
8.0 |  | ST8x2.1 | ST8x2.1 | 2.1 | 6g | 8.000 | 7.780 | 7.100 | 6.885 | 6.200 | 5.990
9.5 |  | 9.5x2.1 | 9.5x2.1 | 2.1 | 6g | 9.650 | 9.430 | 8.750 | 8.510 | 7.850 | 7.590
9.5 |  | ST9.5x2.1 | ST9.5x2.1 | 2.1 | 6g | 9.650 | 9.430 | 8.750 | 8.510 | 7.850 | 7.590

Sheet: ISO Pipe Threads
M Q | ISO Pipe Threads |  | Sort Order - 9 |  | External |  |  |  |  |  |  | Internal
 |  |  |  |  |  | Major Dia |  | Pitch Dia |  | Minor Dia |  |  | Minor Dia |  | Pitch Dia |  | Major Dia |  | Tap Drill
Size | Size Suffix | Thread Designation | Custom Thread Designation | TPI | Class | Max | Min | Max | Min | Max | Min | Class | Min | Max | Min | Max | Min | Max | Basic
7.723 |  | G7.723x0.907 | G 1/16 | 28 | A | 7.723 | 7.509 | 7.142 | 7.035 | 6.561 |  |  | 6.561 | 6.834 | 7.142 | 7.249 | 7.723 |  | 1.5875
7.723 |  | G7.723x0.907 | G 1/16 | 28 | B | 7.723 | 7.509 | 7.142 | 6.928 | 6.561
9.728 |  | G9.728x0.907 | G 1/8 | 28 | A | 9.728 | 9.514 | 9.147 | 9.040 | 8.566 |  |  | 8.566 | 8.848 | 9.147 | 9.254 | 9.728 |  | 3.1750
9.728 |  | G9.728x0.907 | G 1/8 | 28 | B | 9.728 | 9.514 | 9.147 | 8.933 | 8.566
13.157 |  | G13.157x1.337 | G 1/4 | 19 | A | 13.157 | 12.907 | 12.301 | 12.176 | 11.445 |  |  | 11.445 | 11.89 | 12.301 | 12.426 | 13.157 |  | 6.3500
13.157 |  | G13.157x1.337 | G 1/4 | 19 | B | 13.157 | 12.907 | 12.301 | 12.051 | 11.445
16.662 |  | G16.662x1.337 | G 3/8 | 19 | A | 16.662 | 16.412 | 15.806 | 15.681 | 14.950 |  |  | 14.95 | 15.395 | 15.806 | 15.931 | 16.662 |  | 9.5250
16.662 |  | G16.662x1.337 | G 3/8 | 19 | B | 16.662 | 16.412 | 15.806 | 15.556 | 14.950
20.955 |  | G20.955x1.814 | G 1/2 | 14 | A | 20.955 | 20.671 | 19.793 | 19.651 | 18.631 |  |  | 18.631 | 19.172 | 19.793 | 19.935 | 20.955 |  | 12.7000
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
151.130 |  | G151.13x2.309 | G 5 1/2 | 11 | A | 151.130 | 150.696 | 149.651 | 149.434 | 148.172 |  |  | 148.172 | 148.812 | 149.651 | 149.868 | 151.130 |  | 139.7000
151.130 |  | G151.13x2.309 | G 5 1/2 | 11 | B | 151.130 | 150.696 | 149.651 | 149.217 | 148.172
163.830 |  | G163.83x2.309 | G 6 | 11 | A | 163.830 | 163.396 | 162.351 | 162.134 | 160.872 |  |  | 160.872 | 161.512 | 162.351 | 162.568 | 163.830 |  | 152.4000
163.830 |  | G163.83x2.309 | G 6 | 11 | B | 163.830 | 163.396 | 162.351 | 161.917 | 160.872

Sheet: JIS Pipe Threads
M Q | JIS Pipe Threads |  | Sort Order -12 |  | External |  |  |  |  |  |  | Internal
 |  |  |  |  |  | Major Dia |  | Pitch Dia |  | Minor Dia |  |  | Minor Dia |  | Pitch Dia |  | Major Dia |  | Tap Drill
Size | Size Suffix | Thread Designation | Custom Thread Designation | TPI | Class | Max | Min | Max | Min | Max | Min | Class | Min | Max | Min | Max | Min | Max | Basic
7.723 |  | G7.723x0.907 | G 1/16 | 28 | A | 7.723 | 7.509 | 7.142 | 7.035 | 6.561 |  |  | 6.561 | 6.834 | 7.142 | 7.249 | 7.723 |  | 1.5875
7.723 |  | G7.723x0.907 | G 1/16 | 28 | B | 7.723 | 7.509 | 7.142 | 6.928 | 6.561
9.728 |  | G9.728x0.907 | G 1/8 | 28 | A | 9.728 | 9.514 | 9.147 | 9.040 | 8.566 |  |  | 8.566 | 8.848 | 9.147 | 9.254 | 9.728 |  | 3.1750
9.728 |  | G9.728x0.907 | G 1/8 | 28 | B | 9.728 | 9.514 | 9.147 | 8.933 | 8.566
13.157 |  | G13.157x1.337 | G 1/4 | 19 | A | 13.157 | 12.907 | 12.301 | 12.176 | 11.445 |  |  | 11.445 | 11.89 | 12.301 | 12.426 | 13.157 |  | 6.3500
13.157 |  | G13.157x1.337 | G 1/4 | 19 | B | 13.157 | 12.907 | 12.301 | 12.051 | 11.445
16.662 |  | G16.662x1.337 | G 3/8 | 19 | A | 16.662 | 16.412 | 15.806 | 15.681 | 14.950 |  |  | 14.95 | 15.395 | 15.806 | 15.931 | 16.662 |  | 9.5250
16.662 |  | G16.662x1.337 | G 3/8 | 19 | B | 16.662 | 16.412 | 15.806 | 15.556 | 14.950
20.955 |  | G20.955x1.814 | G 1/2 | 14 | A | 20.955 | 20.671 | 19.793 | 19.651 | 18.631 |  |  | 18.631 | 19.172 | 19.793 | 19.935 | 20.955 |  | 12.7000
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
151.130 |  | G151.13x2.309 | G 5 1/2 | 11 | A | 151.130 | 150.696 | 149.651 | 149.434 | 148.172 |  |  | 148.172 | 148.812 | 149.651 | 149.868 | 151.130 |  | 139.7000
151.130 |  | G151.13x2.309 | G 5 1/2 | 11 | B | 151.130 | 150.696 | 149.651 | 149.217 | 148.172
163.830 |  | G163.83x2.309 | G 6 | 11 | A | 163.830 | 163.396 | 162.351 | 162.134 | 160.872 |  |  | 160.872 | 161.512 | 162.351 | 162.568 | 163.830 |  | 152.4000
163.830 |  | G163.83x2.309 | G 6 | 11 | B | 163.830 | 163.396 | 162.351 | 161.917 | 160.872

Sheet: DIN Pipe Threads
M Q | DIN Pipe Threads |  | Sort Order - 18 |  | External |  |  |  |  |  |  | Internal
 |  |  |  |  |  | Major Dia |  | Pitch Dia |  | Minor Dia |  |  | Minor Dia |  | Pitch Dia |  | Major Dia |  | Tap Drill
Size | Size Suffix | Thread Designation | Custom Thread Designation | TPI | Class | Max | Min | Max | Min | Max | Min | Class | Min | Max | Min | Max | Min | Max | Basic
7.723 |  | G7.723x0.907 | G 1/16 | 28 | A | 7.723 | 7.509 | 7.142 | 7.035 | 6.561 |  |  | 6.561 | 6.834 | 7.142 | 7.249 | 7.723 |  | 1.5875
7.723 |  | G7.723x0.907 | G 1/16 | 28 | B | 7.723 | 7.509 | 7.142 | 6.928 | 6.561
9.728 |  | G9.728x0.907 | G 1/8 | 28 | A | 9.728 | 9.514 | 9.147 | 9.040 | 8.566 |  |  | 8.566 | 8.848 | 9.147 | 9.254 | 9.728 |  | 3.1750
9.728 |  | G9.728x0.907 | G 1/8 | 28 | B | 9.728 | 9.514 | 9.147 | 8.933 | 8.566
13.157 |  | G13.157x1.337 | G 1/4 | 19 | A | 13.157 | 12.907 | 12.301 | 12.176 | 11.445 |  |  | 11.445 | 11.89 | 12.301 | 12.426 | 13.157 |  | 6.3500
13.157 |  | G13.157x1.337 | G 1/4 | 19 | B | 13.157 | 12.907 | 12.301 | 12.051 | 11.445
16.662 |  | G16.662x1.337 | G 3/8 | 19 | A | 16.662 | 16.412 | 15.806 | 15.681 | 14.950 |  |  | 14.95 | 15.395 | 15.806 | 15.931 | 16.662 |  | 9.5250
16.662 |  | G16.662x1.337 | G 3/8 | 19 | B | 16.662 | 16.412 | 15.806 | 15.556 | 14.950
20.955 |  | G20.955x1.814 | G 1/2 | 14 | A | 20.955 | 20.671 | 19.793 | 19.651 | 18.631 |  |  | 18.631 | 19.172 | 19.793 | 19.935 | 20.955 |  | 12.7000
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
151.130 |  | G151.13x2.309 | G 5 1/2 | 11 | A | 151.130 | 150.696 | 149.651 | 149.434 | 148.172 |  |  | 148.172 | 148.812 | 149.651 | 149.868 | 151.130 |  | 139.7000
151.130 |  | G151.13x2.309 | G 5 1/2 | 11 | B | 151.130 | 150.696 | 149.651 | 149.217 | 148.172
163.830 |  | G163.83x2.309 | G 6 | 11 | A | 163.830 | 163.396 | 162.351 | 162.134 | 160.872 |  |  | 160.872 | 161.512 | 162.351 | 162.568 | 163.830 |  | 152.4000
163.830 |  | G163.83x2.309 | G 6 | 11 | B | 163.830 | 163.396 | 162.351 | 161.917 | 160.872

Sheet: BSP Pipe Threads
M Q | BSP Pipe Threads |  | Sort Order - 19 |  | External |  |  |  |  |  |  | Internal
 |  |  |  |  |  | Major Dia |  | Pitch Dia |  | Minor Dia |  |  | Minor Dia |  | Pitch Dia |  | Major Dia |  | Tap Drill
Size | Size Suffix | Thread Designation | Custom Thread Designation | TPI | Class | Max | Min | Max | Min | Max | Min | Class | Min | Max | Min | Max | Min | Max | Basic
1/16 |  | G 1/16-28 | G 1/16-28 | 28 | A | 7.723 | 7.509 | 7.142 | 7.035 | 6.561 |  |  | 6.561 | 6.834 | 7.142 | 7.249 | 7.723 |  | 6.6000
1/16 |  | G 1/16-28 | G 1/16-28 | 28 | B | 7.723 | 7.509 | 7.142 | 7.035 | 6.561
1/8 |  | G 1/8-28 | G 1/8-28 | 28 | A | 9.728 | 9.514 | 9.147 | 9.040 | 8.566 |  |  | 8.566 | 8.848 | 9.147 | 9.254 | 9.728 |  | 8.7300
1/8 |  | G 1/8-28 | G 1/8-28 | 28 | B | 9.728 | 9.514 | 9.147 | 9.040 | 8.566
1/4 |  | G 1/4-19 | G 1/4-19 | 19 | A | 13.157 | 12.907 | 12.301 | 12.176 | 11.445 |  |  | 11.445 | 11.89 | 12.301 | 12.426 | 13.157 |  | 11.8000
1/4 |  | G 1/4-19 | G 1/4-19 | 19 | B | 13.157 | 12.907 | 12.301 | 12.176 | 11.445
3/8 |  | G 3/8-19 | G 3/8-19 | 19 | A | 16.662 | 16.412 | 15.806 | 15.681 | 14.950 |  |  | 14.95 | 15.395 | 15.806 | 15.931 | 16.662 |  | 15.2500
3/8 |  | G 3/8-19 | G 3/8-19 | 19 | B | 16.662 | 16.412 | 15.806 | 15.681 | 14.950
1/2 |  | G 1/2-14 | G 1/2-14 | 14 | A | 20.955 | 20.671 | 19.793 | 19.651 | 18.631 |  |  | 18.631 | 19.172 | 19.793 | 19.935 | 20.955 |  | 19.0500
1/2 |  | G 1/2-14 | G 1/2-14 | 14 | B | 20.955 | 20.671 | 19.793 | 19.651 | 18.631
5/8 |  | G 5/8-14 | G 5/8-14 | 14 | A | 22.911 | 22.627 | 21.749 | 21.607 | 20.587 |  |  | 20.587 | 21.128 | 21.749 | 21.891 | 22.911 |  | 21.0000
5/8 |  | G 5/8-14 | G 5/8-14 | 14 | B | 22.911 | 22.627 | 21.749 | 21.607 | 20.587
3/4 |  | G 3/4-14 | G 3/4-14 | 14 | A | 26.441 | 26.157 | 25.279 | 25.137 | 24.117 |  |  | 24.117 | 24.658 | 25.279 | 25.421 | 26.441 |  | 24.5000
3/4 |  | G 3/4-14 | G 3/4-14 | 14 | B | 26.441 | 26.157 | 25.279 | 25.137 | 24.117
7/8 |  | G 7/8-14 | G 7/8-14 | 14 | A | 30.201 | 29.917 | 29.039 | 28.897 | 27.877 |  |  | 27.877 | 28.418 | 29.039 | 29.181 | 30.201 |  | 28.2500
7/8 |  | G 7/8-14 | G 7/8-14 | 14 | B | 30.201 | 29.917 | 29.039 | 28.897 | 27.877
1 |  | G 1-11 | G 1-11 | 11 | A | 33.249 | 32.889 | 31.770 | 31.590 | 30.291 |  |  | 30.291 | 30.931 | 31.77 | 31.95 | 33.249 |  | 30.7500
1 |  | G 1-11 | G 1-11 | 11 | B | 33.249 | 32.889 | 31.770 | 31.590 | 30.291
1 1/4 |  | G 1 1/4-11 | G 1 1/4-11 | 11 | A | 41.910 | 41.550 | 40.431 | 40.251 | 38.952 |  |  | 38.952 | 39.592 | 40.431 | 40.611 | 41.910 |  | 39.5000
1 1/4 |  | G 1 1/4-11 | G 1 1/4-11 | 11 | B | 41.910 | 41.550 | 40.431 | 40.251 | 38.952
1 1/2 |  | G 1 1/2-11 | G 1 1/2-11 | 11 | A | 47.803 | 47.443 | 46.324 | 46.144 | 44.845 |  |  | 44.845 | 45.485 | 46.324 | 46.504 | 47.803 |  | 45.5000
1 1/2 |  | G 1 1/2-11 | G 1 1/2-11 | 11 | B | 47.803 | 47.443 | 46.324 | 46.144 | 44.845
1 3/4 |  | G 1 3/4-11 | G 1 3/4-11 | 11 | A | 53.746 | 53.386 | 52.267 | 52.087 | 50.788 |  |  | 50.788 | 51.428 | 52.267 | 52.447 | 53.746 |  | 51.0000
1 3/4 |  | G 1 3/4-11 | G 1 3/4-11 | 11 | B | 53.746 | 53.386 | 52.267 | 52.087 | 50.788
2 |  | G 2-11 | G 2-11 | 11 | A | 59.614 | 59.254 | 58.135 | 57.955 | 56.656 |  |  | 56.656 | 57.296 | 58.135 | 58.315 | 59.614 |  | 57.0000
2 |  | G 2-11 | G 2-11 | 11 | B | 59.614 | 59.254 | 58.135 | 57.955 | 56.656

Sheet: GB Pipe Threads without seal
M Q | GB Pipe Threads |  | Sort Order - 23 |  | External |  |  |  |  |  |  | Internal
 |  |  |  |  |  | Major Dia |  | Pitch Dia |  | Minor Dia |  |  | Minor Dia |  | Pitch Dia |  | Major Dia |  | Tap Drill
Size | Size Suffix | Thread Designation | Custom Thread Designation | TPI | Class | Max | Min | Max | Min | Max | Min | Class | Min | Max | Min | Max | Min | Max | Basic
7.723 |  | G7.723x0.907 | G 1/16 | 28 | A | 7.723 | 7.509 | 7.142 | 7.035 | 6.561 |  |  | 6.561 | 6.834 | 7.142 | 7.249 | 7.723 |  | 1.5875
7.723 |  | G7.723x0.907 | G 1/16 | 28 | B | 7.723 | 7.509 | 7.142 | 6.928 | 6.561
9.728 |  | G9.728x0.907 | G 1/8 | 28 | A | 9.728 | 9.514 | 9.147 | 9.040 | 8.566 |  |  | 8.566 | 8.848 | 9.147 | 9.254 | 9.728 |  | 3.1750
9.728 |  | G9.728x0.907 | G 1/8 | 28 | B | 9.728 | 9.514 | 9.147 | 8.933 | 8.566
13.157 |  | G13.157x1.337 | G 1/4 | 19 | A | 13.157 | 12.907 | 12.301 | 12.176 | 11.445 |  |  | 11.445 | 11.89 | 12.301 | 12.426 | 13.157 |  | 6.3500
13.157 |  | G13.157x1.337 | G 1/4 | 19 | B | 13.157 | 12.907 | 12.301 | 12.051 | 11.445
16.662 |  | G16.662x1.337 | G 3/8 | 19 | A | 16.662 | 16.412 | 15.806 | 15.681 | 14.950 |  |  | 14.95 | 15.395 | 15.806 | 15.931 | 16.662 |  | 9.5250
16.662 |  | G16.662x1.337 | G 3/8 | 19 | B | 16.662 | 16.412 | 15.806 | 15.556 | 14.950
20.955 |  | G20.955x1.814 | G 1/2 | 14 | A | 20.955 | 20.671 | 19.793 | 19.651 | 18.631 |  |  | 18.631 | 19.172 | 19.793 | 19.935 | 20.955 |  | 12.7000
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
151.130 |  | G151.13x2.309 | G 5 1/2 | 11 | A | 151.130 | 150.696 | 149.651 | 149.434 | 148.172 |  |  | 148.172 | 148.812 | 149.651 | 149.868 | 151.130 |  | 139.7000
151.130 |  | G151.13x2.309 | G 5 1/2 | 11 | B | 151.130 | 150.696 | 149.651 | 149.217 | 148.172
163.830 |  | G163.83x2.309 | G 6 | 11 | A | 163.830 | 163.396 | 162.351 | 162.134 | 160.872 |  |  | 160.872 | 161.512 | 162.351 | 162.568 | 163.830 |  | 152.4000
163.830 |  | G163.83x2.309 | G 6 | 11 | B | 163.830 | 163.396 | 162.351 | 161.917 | 160.872

Sheet: AFBMA Standard Locknuts
I Q | AFBMA Standard Locknuts |  | Sort Order -24 |  | External |  |  |  |  |  |  | Internal
 |  |  |  |  |  | Major Dia |  | Pitch Dia |  | Minor Dia |  |  | Minor Dia |  | Pitch Dia |  | Major Dia |  | Tap Drill
Size | Size Suffix | Thread Designation | Custom Thread Designation | TPI | Class | Max | Min | Max | Min | Max | Min | Class | Min | Max | Min | Max | Min | Max | Basic
0.391 |  | N 00 | N 00-32 | 32 | 3A | 0.3910 | 0.3856 | 0.3707 | 0.3681 | 0.3527 |  | 3B | 0.3572 | 0.3606 | 0.3707 | 0.3733 | 0.3910 |  | 0.3527
0.469 |  | N 01 | N 01-32 | 32 | 3A | 0.4690 | 0.4636 | 0.4487 | 0.4461 | 0.4307 |  | 3B | 0.4352 | 0.4386 | 0.4487 | 0.4513 | 0.4690 |  | 0.4307
0.586 |  | N 02 | N 02-32 | 32 | 3A | 0.5860 | 0.5806 | 0.5657 | 0.5627 | 0.5477 |  | 3B | 0.5522 | 0.5556 | 0.5657 | 0.5687 | 0.5860 |  | 0.5477
0.664 |  | N 03 | N 03-32 | 32 | 3A | 0.6640 | 0.6586 | 0.6437 | 0.6407 | 0.6257 |  | 3B | 0.6302 | 0.6336 | 0.6437 | 0.6467 | 0.6640 |  | 0.6257
0.781 |  | N 04 | N 04-32 | 32 | 3A | 0.7810 | 0.7756 | 0.7607 | 0.7573 | 0.7427 |  | 3B | 0.7472 | 0.7506 | 0.7607 | 0.7641 | 0.7810 |  | 0.7427
0.969 |  | N 05 | N 05-32 | 32 | 3A | 0.9690 | 0.9636 | 0.9487 | 0.9453 | 0.9307 |  | 3B | 0.9352 | 0.9386 | 0.9487 | 0.9521 | 0.9690 |  | 0.9307
1.173 |  | N 06 | N 06-18 | 18 | 3A | 1.1730 | 1.1648 | 1.1369 | 1.1329 | 1.1048 |  | 3B | 1.1129 | 1.1189 | 1.1369 | 1.1409 | 1.1730 |  | 1.1048
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
7.066 |  | TAN 136 | TAN 136-8 | 8 | 3A | 7.0660 | 7.0508 | 6.9848 | 6.9757 | 6.9126
7.472 |  | TAN 138 | TAN 138-8 | 8 | 3A | 7.4720 | 7.4568 | 7.3908 | 7.3817 | 7.3186
7.847 |  | TAN 140 | TAN 140-8 | 8 | 3A | 7.8470 | 7.8318 | 7.7658 | 7.7544 | 7.6936
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
