david-deboer/hera-cad/hub/H1HO-B_a_hub_outer_sheetmetal.dxf

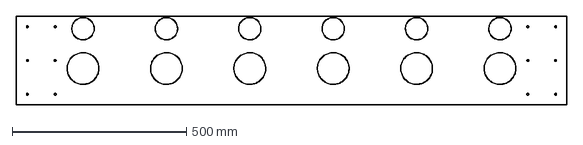
[picture p21: CAD file, 2016-02-03]
hub/H1HO-B_a_hub_outer_sheetmetal.dxf
1581.5 x 254.0 mm
