david-deboer/hera-cad/jigs/hubRingJig.stp

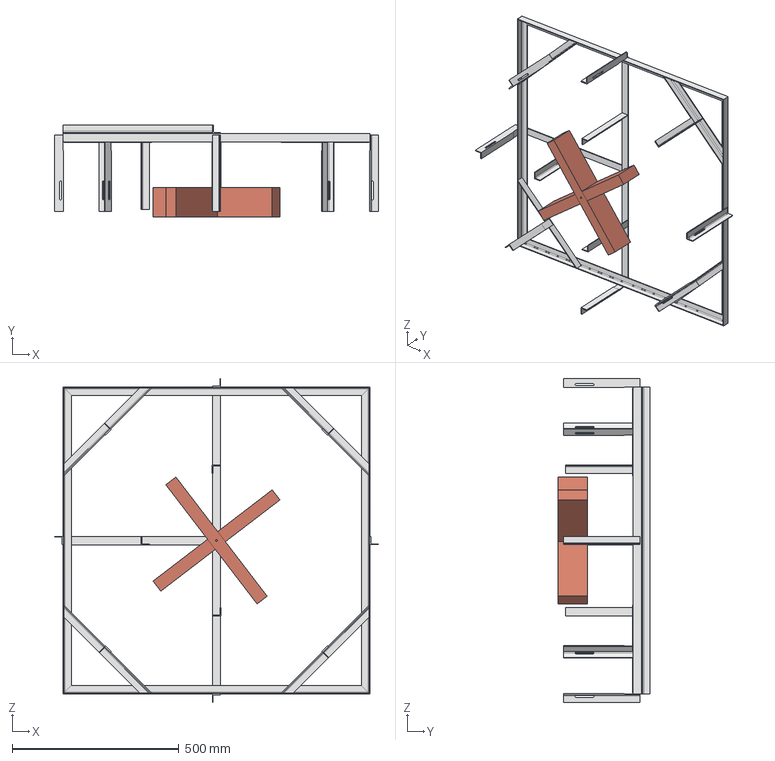
[picture p22: CAD file, 2015-01-15]
jigs/hubRingJig.stp
970.3 x 276.4 x 970.3 mm
