david-deboer/hera-cad/Node/Concept-ICTS/ICTS-20170411/ssl-version/waveguide.stp

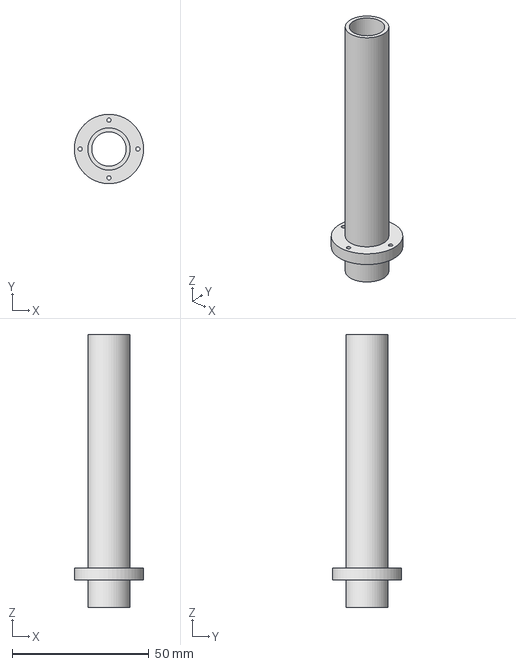
[picture p23: CAD file, 2017-11-21]
Node/Concept-ICTS/ICTS-20170411/ssl-version/waveguide.stp
25.4 x 25.4 x 100.0 mm
