david-deboer/hera-cad/Node/NMT/nmt_bottom.stp

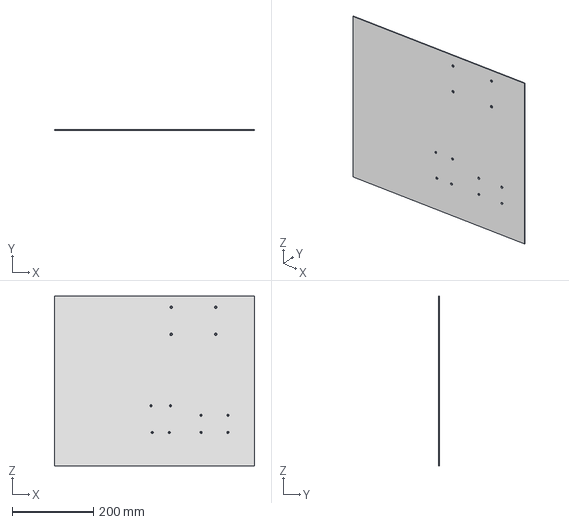
[picture p24: CAD file, 2017-03-25]
Node/NMT/nmt_bottom.stp
492.0 x 1.78 x 417.8 mm
