david-deboer/hera-cad/Node/SNAP_V2/Workspaces/Workspace/3d prototyping/dsub37_cutout_2052.stl

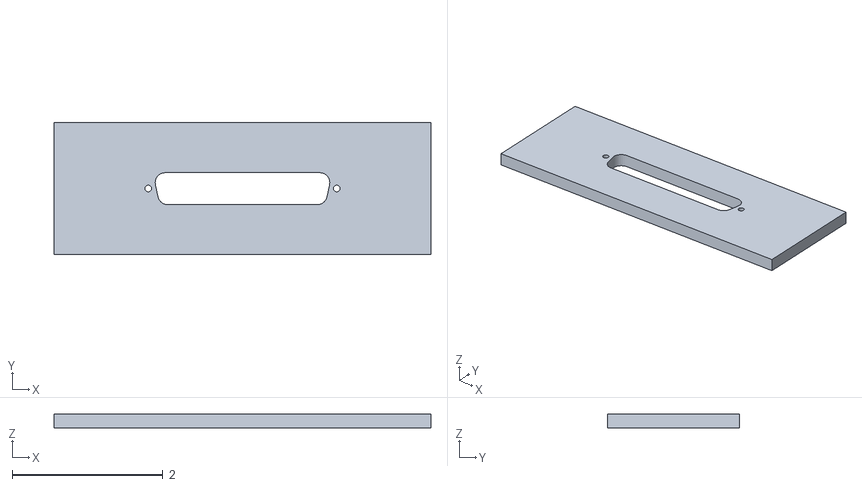
[picture p25: CAD file, 2016-11-03]
Node/SNAP_V2/Workspaces/Workspace/3d prototyping/dsub37_cutout_2052.stl
5.00 x 1.75 x 0.187
