david-deboer/hera-cad/Node/SNAP_V2/Workspaces/Workspace/components/ENG_CVM_CVM_745777-4_D.3d_stp/c-745777-4-d-3d.stp

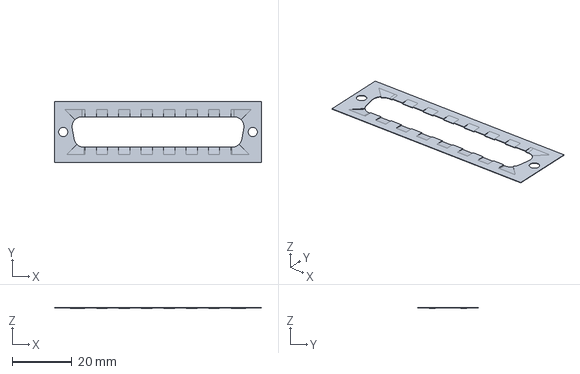
[picture p26: CAD file, 2016-10-25]
Node/SNAP_V2/Workspaces/Workspace/components/ENG_CVM_CVM_745777-4_D.3d_stp/c-745777-4-d-3d.stp
69.3 x 20.3 x 0.406 mm
