david-deboer/hera-cad/Node/SNAP_V2/Workspaces/Workspace/drawings/quote_step_031617/RFT 8x10 Cover-alt-base.stp

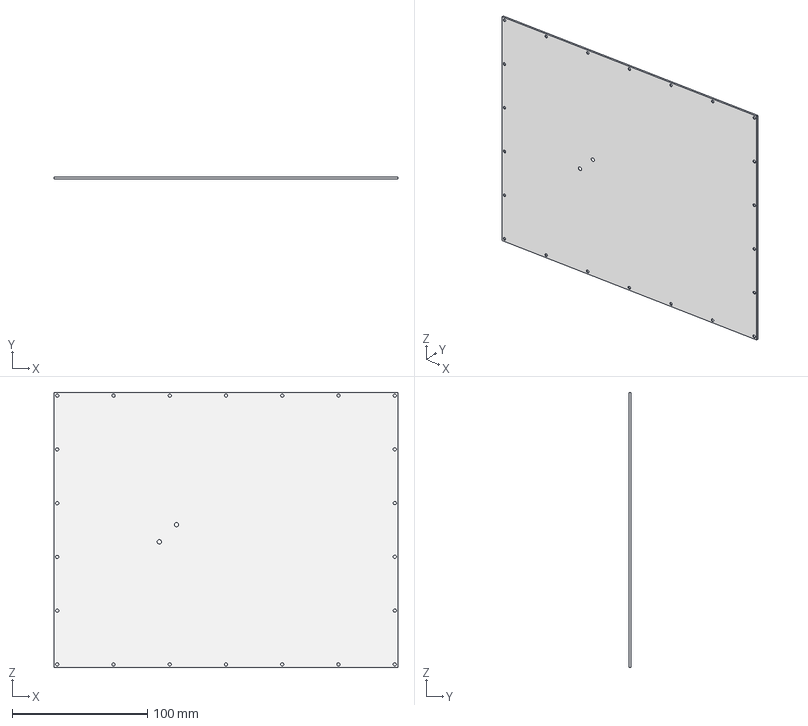
[picture p27: CAD file, 2017-03-25]
Node/SNAP_V2/Workspaces/Workspace/drawings/quote_step_031617/RFT 8x10 Cover-alt-base.stp
254.0 x 1.52 x 203.2 mm
