david-deboer/hera-cad/Node/SNAP_V2/Workspaces/Workspace/SNAP 8x10x1.75 Ver1.stp

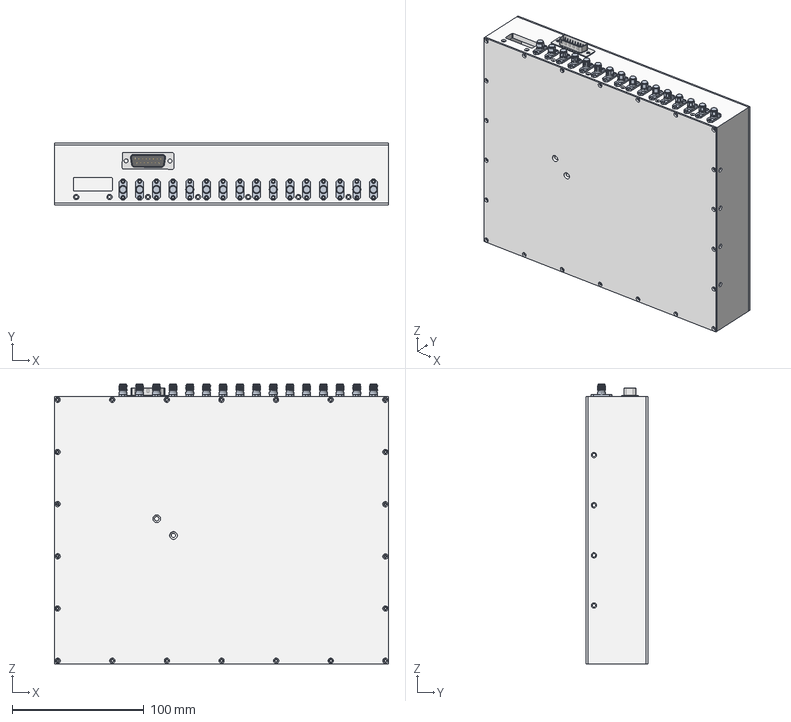
[picture p28: CAD file, 2016-09-06]
Node/SNAP_V2/Workspaces/Workspace/SNAP 8x10x1.75 Ver1.stp
254.0 x 47.5 x 212.7 mm
R58010-175-with SNAP V2 features
132143_iges_file x 16
RFT 8x10 Cover
BOARD
INDC1005X55L_L30
INDC1005X55L_L31
NRAO-LOGO_NOREFDES
MOLEX_SD-74754-0220_M23
SHDRRA14W55P200_7X2_1665X100-1_J11
SHDRV14W55P200_7X2_1665X630H-1_J3
TE_CONN_6367550-5_P3
TO170P1430X470-6N-ALT1_U18
SMA_END_LAUNCH_SMATP1
SMA_END_LAUNCH_SMATP2
SMA_END_LAUNCH_SMATP3
SMA_END_LAUNCH_SMATP4
SMA_END_LAUNCH_SMATP5
SMA_END_LAUNCH_SMATP6
SMA_END_LAUNCH_SMATP7
SMA_END_LAUNCH_SMATP8
SMA_END_LAUNCH_SMATP9
SMA_END_LAUNCH_SMATP10
SMA_END_LAUNCH_SMATP11
SMA_END_LAUNCH_SMATP12
SMA_END_LAUNCH_SMATP13
SMA_END_LAUNCH_SMATP14
SMA_END_LAUNCH_SMATP15
SMA_END_LAUNCH_SMATP16
HDRV254W64P254R1L508T254H838_JP3
HDRV254W64P254R1L508T254H838_JP2
HDRV254W64P254R1L508T254H838_JP1
HDRV254W64P254R1L508T254H838_JP4
HDRV6X2_J9
HDRV6X2_J7
HDRV6X2_J5
HDRV6X2_J6
HDRV2X20_PI2
CAPPRD350W60D820H1170P_C259
CAPPRD350W60D820H1170P_C250
CAPPRD350W60D820H1170P_C241
CAPPRD350W60D820H1170P_C234
CAPPRD350W60D820H1170P_C227
QFN50P500X500X100-28N_U29
FID100X125_NOREFDES x 8
DIOAD1365W102L865D350B_D4
DIOAD1365W102L865D350B_D5
DIOAD1365W102L865D350B_D6
DIOAD1365W102L865D350B_D7
DIOAD1365W102L865D350B_D8
BGA676C100P26X26_2700X2700X260_U25
EMERSON_RFCONN_SMA-V_TP2
FIL_BNX01X_U24
MOLEX_744410010_P2
MOLEX_744410010_P1
SOT89_Q5
SOT89_Q6
QFN80P1000X1000X440-42T320X130X2N-ALT1_U20
HDR_1X2_LOCK_MOLEX_J61
DIOMELF3514_D14
SOT230P700X180-4L050N_Q17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
