david-deboer/hera-cad/element.stp

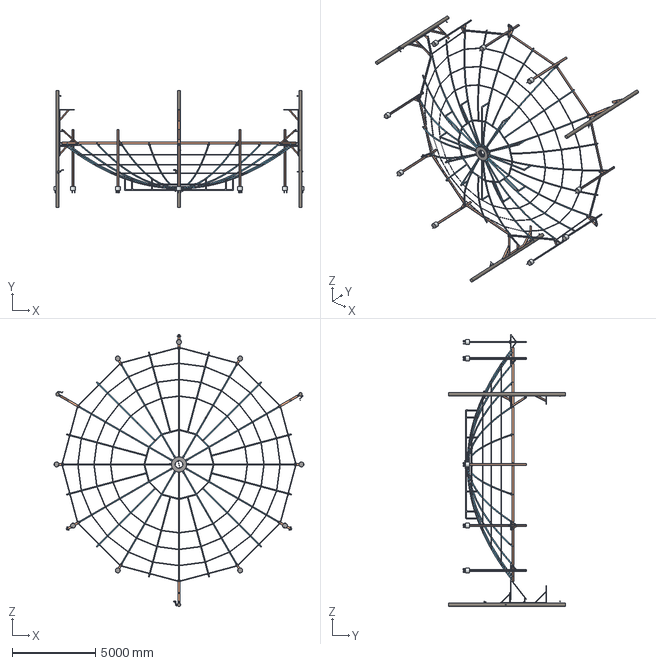
[picture p29: CAD file, 2015-03-26]
element.stp
15004.7 x 7000.0 x 16336.0 mm
