david-deboer/hera-cad/hub/H1HI-B_a_hub_inner_sheetmetal.dxf

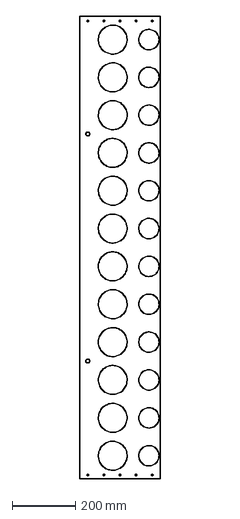
[picture p30: CAD file, 2016-02-03]
hub/H1HI-B_a_hub_inner_sheetmetal.dxf
254.0 x 1462.9 mm
