david-deboer/hera-cad/Node/Concept-ICTS/ICTS-20170411/panel_waveguide_part.dxf

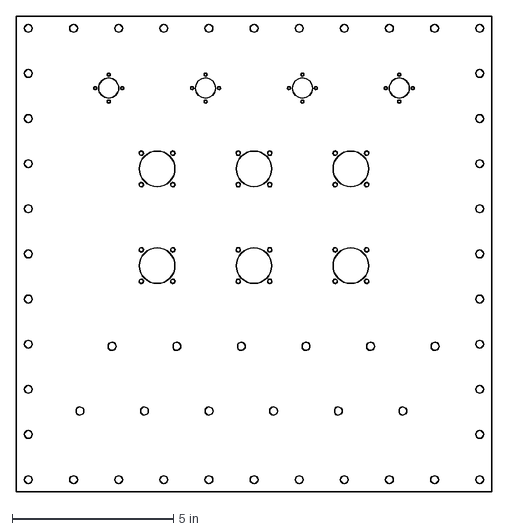
[picture p31: CAD file, 2017-09-29]
Node/Concept-ICTS/ICTS-20170411/panel_waveguide_part.dxf
14.7 x 14.7 in
