david-deboer/hera-cad/Node/Concept-ICTS/ICTS-20170411/ssl-version/panel.stp

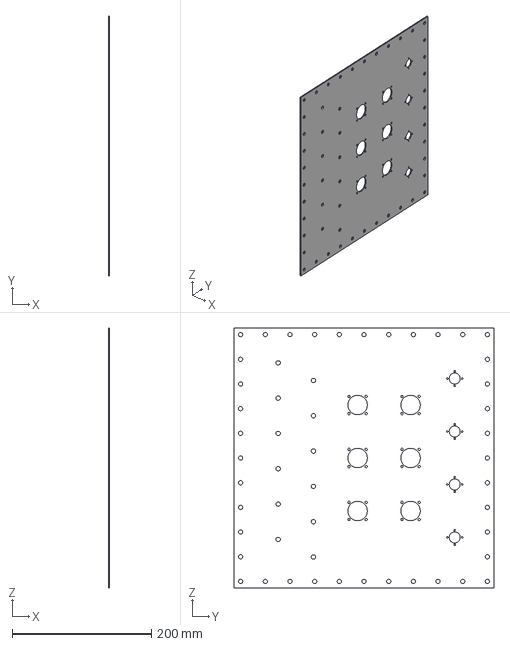
[picture p32: CAD file, 2017-11-21]
Node/Concept-ICTS/ICTS-20170411/ssl-version/panel.stp
2.00 x 374.0 x 374.0 mm
