david-deboer/hera-cad/Node/NMT/nmt_backpanel.stp

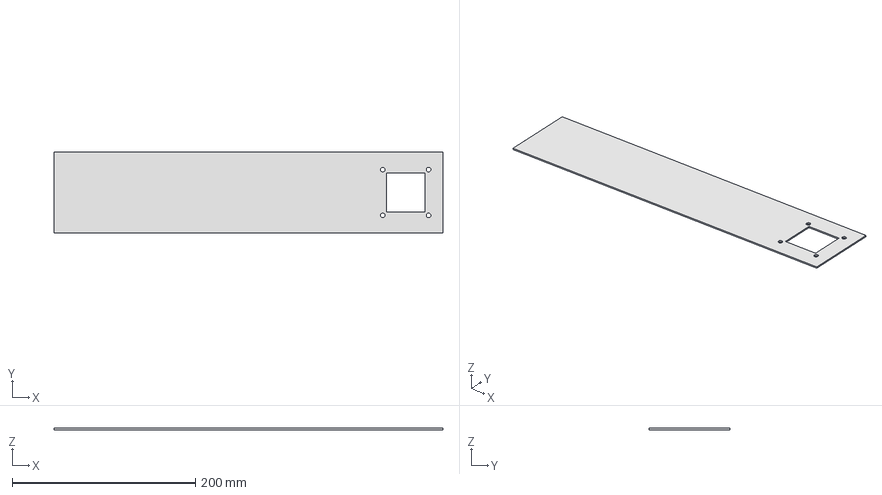
[picture p33: CAD file, 2017-03-25]
Node/NMT/nmt_backpanel.stp
424.9 x 88.1 x 1.65 mm
