david-deboer/hera-cad/Node/PCB/PCB022618/PCB_metalplate.stp

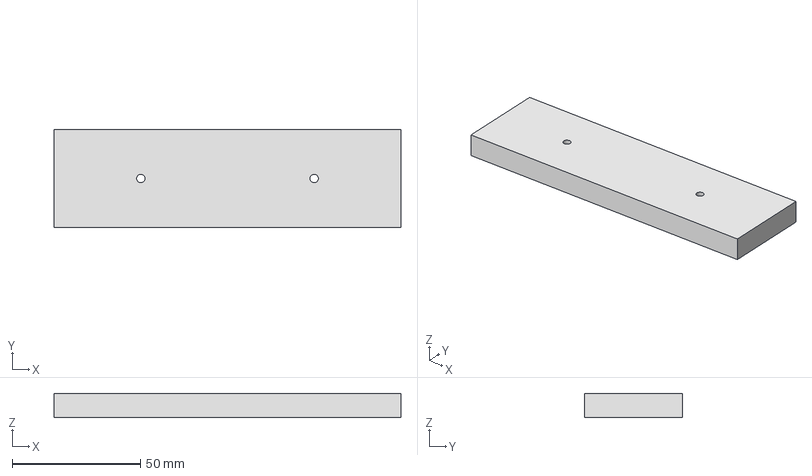
[picture p34: CAD file, 2018-04-02]
Node/PCB/PCB022618/PCB_metalplate.stp
135.3 x 38.1 x 9.52 mm
