david-deboer/hera-cad/Node/SNAP_V2/Workspaces/Workspace/3d prototyping/dsub9_cutout.stl

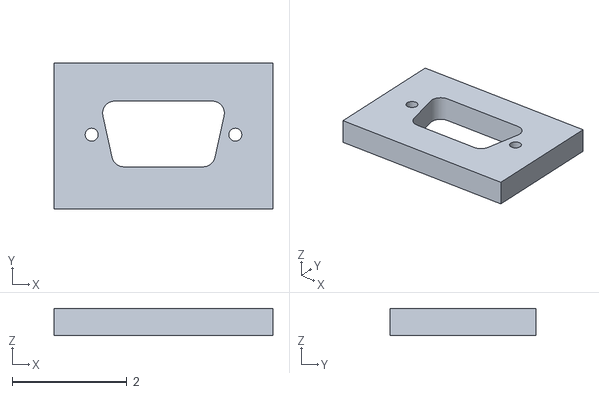
[picture p35: CAD file, 2016-10-25]
Node/SNAP_V2/Workspaces/Workspace/3d prototyping/dsub9_cutout.stl
3.81 x 2.54 x 0.475
