david-deboer/hera-cad/Node/SNAP_V2/Workspaces/Workspace/drawings/quote_step_031617/mezzanineBracketRight.stp

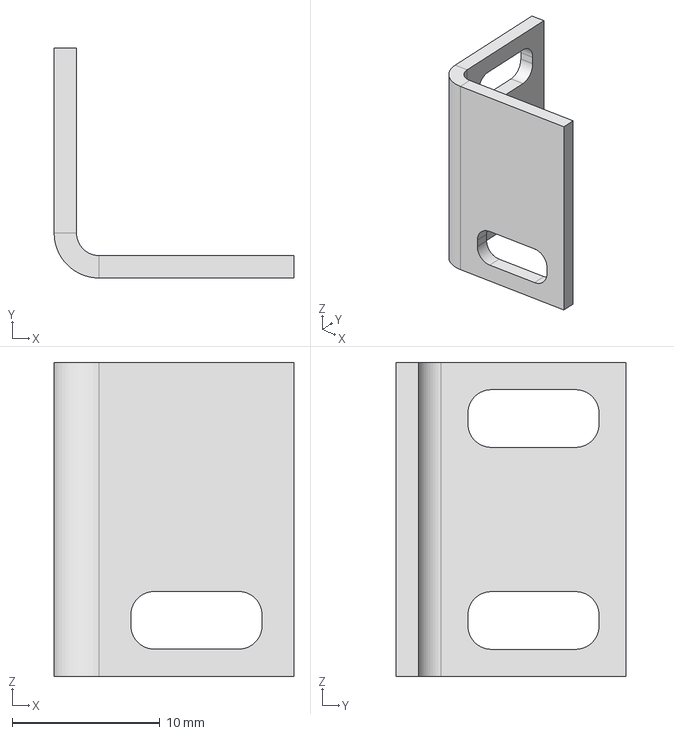
[picture p36: CAD file, 2017-03-25]
Node/SNAP_V2/Workspaces/Workspace/drawings/quote_step_031617/mezzanineBracketRight.stp
16.3 x 15.6 x 21.3 mm
