david-deboer/hera-cad/hub/ringOuter_Split_Flat_MIR.stp

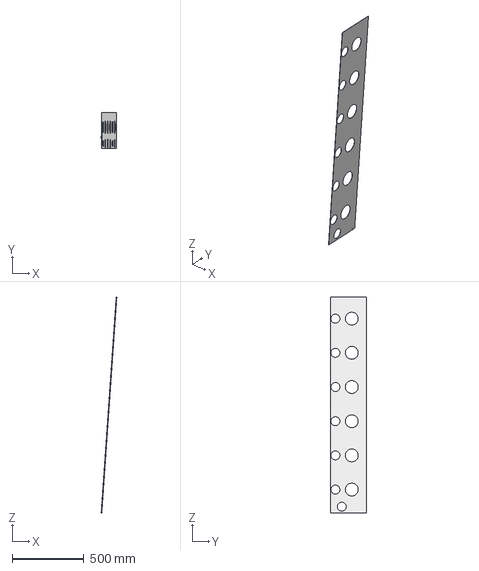
[picture p37: CAD file, 2015-01-30]
hub/ringOuter_Split_Flat_MIR.stp
106.5 x 254.0 x 1508.8 mm
