david-deboer/hera-cad/Node/Concept-ICTS/ICTS-20170411/ssl-version/panel_waveguide.stp

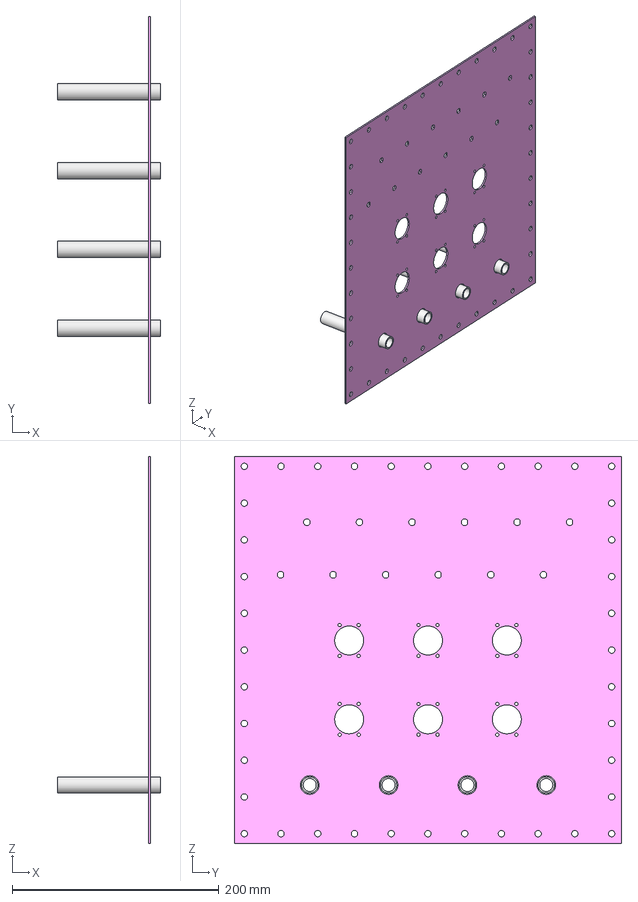
[picture p38: CAD file, 2017-09-29]
Node/Concept-ICTS/ICTS-20170411/ssl-version/panel_waveguide.stp
100.0 x 374.0 x 374.0 mm
waveguide x 4
RD-A001-P001-REV0-cutouts
