david-deboer/hera-cad/Node/PCB/PCB022618/PCB_sidepanel_right_20.stp

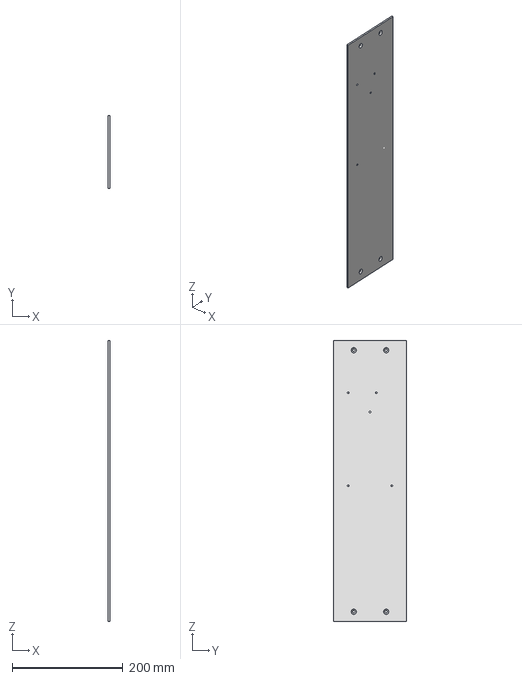
[picture p39: CAD file, 2018-03-14]
Node/PCB/PCB022618/PCB_sidepanel_right_20.stp
3.18 x 132.6 x 508.0 mm
