david-deboer/hera-cad/Node/PDU/PDU_chassis_back.stp

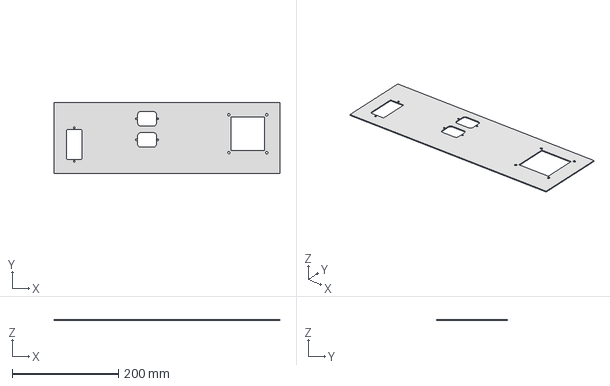
[picture p40: CAD file, 2017-03-25]
Node/PDU/PDU_chassis_back.stp
424.9 x 132.6 x 1.65 mm
