david-deboer/hera-cad/Node/173-E37-113.STEP

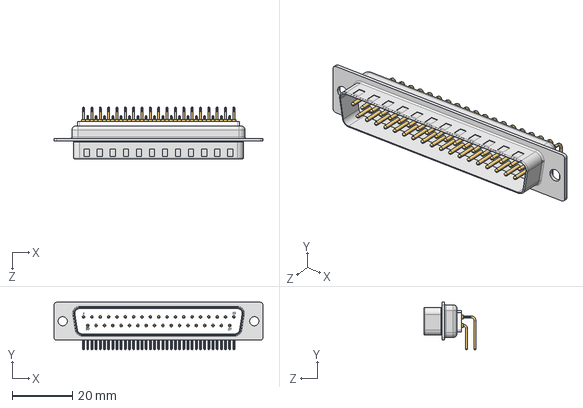
[picture p41: CAD file, 2016-10-06]
Node/173-E37-113.STEP
69.3 x 15.8 x 17.2 mm
