david-deboer/hera-cad/Node/NMT/nmt_frontpanel.stp

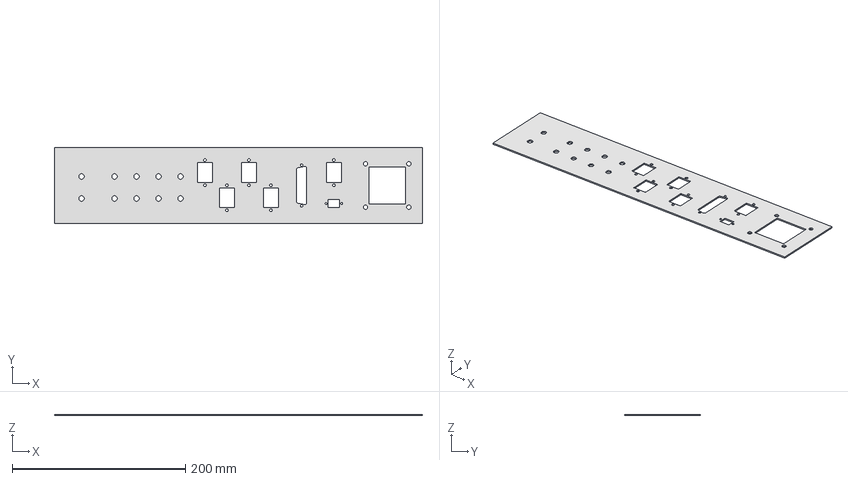
[picture p42: CAD file, 2017-03-25]
Node/NMT/nmt_frontpanel.stp
424.9 x 88.1 x 1.65 mm
