david-deboer/hera-cad/Node/PCB/socorro/PDU_chassis.DXF

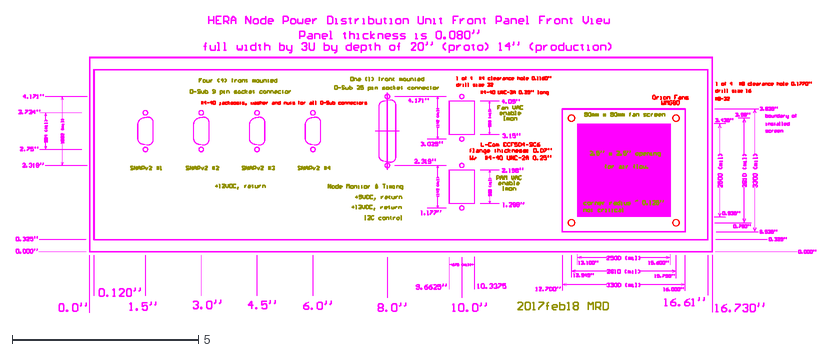
[picture p43: CAD file, 2017-11-21]
Node/PCB/socorro/PDU_chassis.DXF
21.5 x 7.96
