david-deboer/hera-cad/Node/SNAP_V2/Workspaces/Workspace/3d prototyping/dsub37Bracket_right.stl

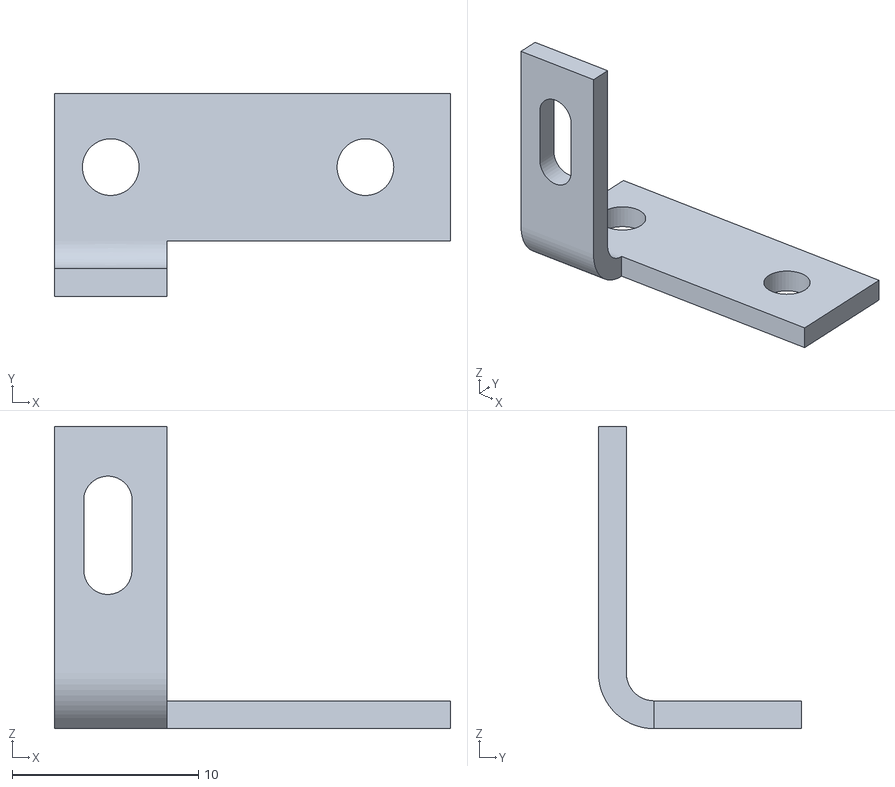
[picture p44: CAD file, 2016-10-25]
Node/SNAP_V2/Workspaces/Workspace/3d prototyping/dsub37Bracket_right.stl
21.3 x 10.9 x 16.3
