david-deboer/hera-cad/Node/NMT/nmt_sidepanel_12in.stp

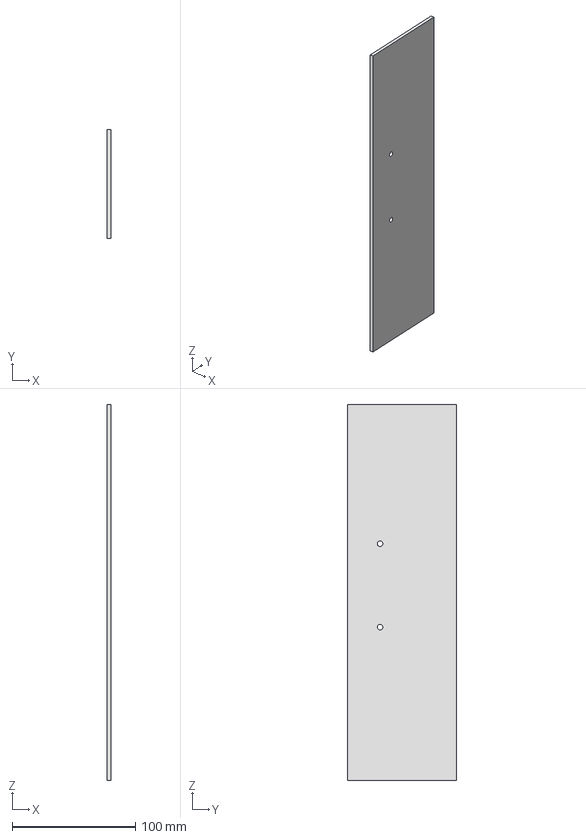
[picture p46: CAD file, 2017-03-25]
Node/NMT/nmt_sidepanel_12in.stp
3.17 x 88.1 x 304.8 mm
