david-deboer/hera-cad/Node/PCB/PCB022618/PCB_bottom.stp

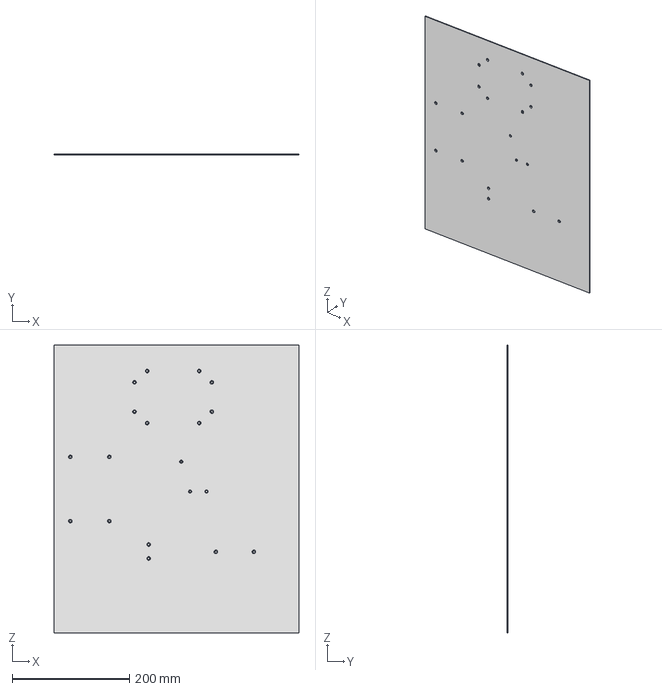
[picture p47: CAD file, 2018-03-14]
Node/PCB/PCB022618/PCB_bottom.stp
417.8 x 1.65 x 492.0 mm
