david-deboer/hera-cad/Node/SNAP_V2/Workspaces/Workspace/components/dsub9API.step

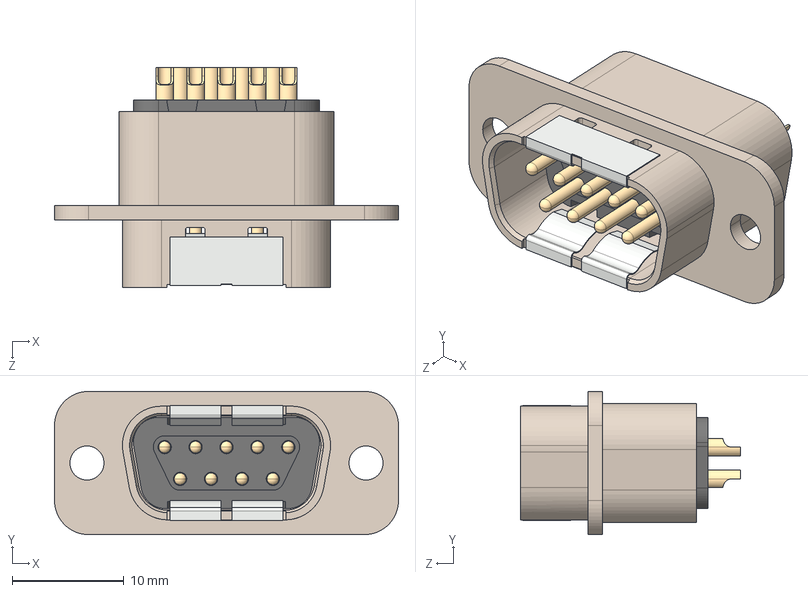
[picture p48: CAD file, 2016-10-25]
Node/SNAP_V2/Workspaces/Workspace/components/dsub9API.step
30.8 x 12.8 x 19.7 mm
