david-deboer/hera-cad/Node/enclosureNode.stp

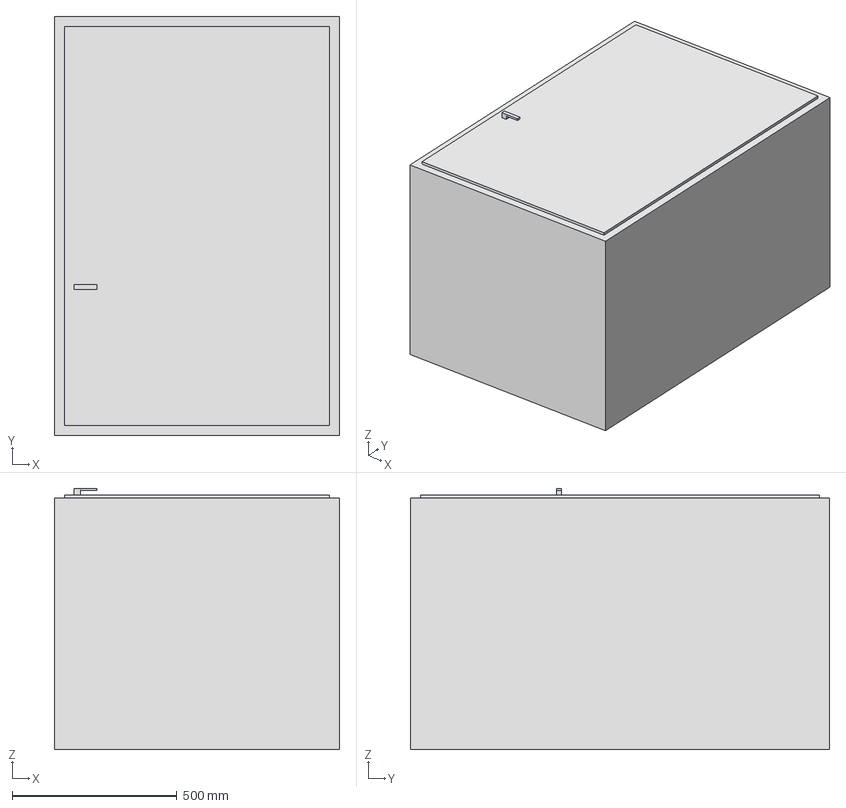
[picture p49: CAD file, 2016-07-19]
Node/enclosureNode.stp
864.0 x 1270.0 x 792.0 mm
