david-deboer/hera-cad/Node/NMT/nmt_sidepanel_20in.stp

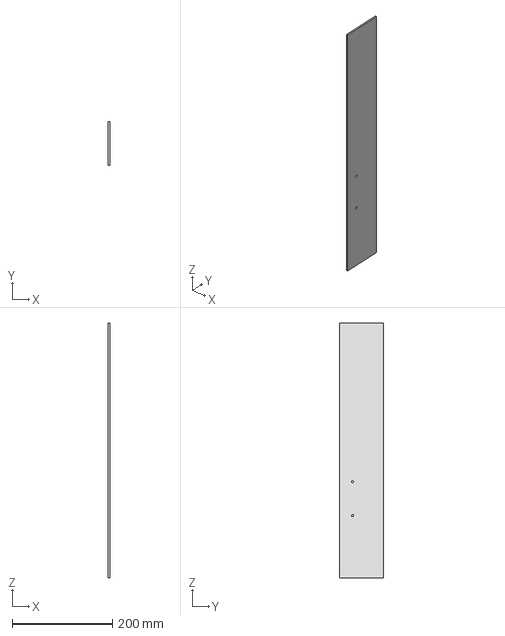
[picture p50: CAD file, 2017-03-25]
Node/NMT/nmt_sidepanel_20in.stp
3.18 x 88.1 x 508.0 mm
