david-deboer/hera-cad/Node/PCB/PCB022618/PCB_brackets.stp

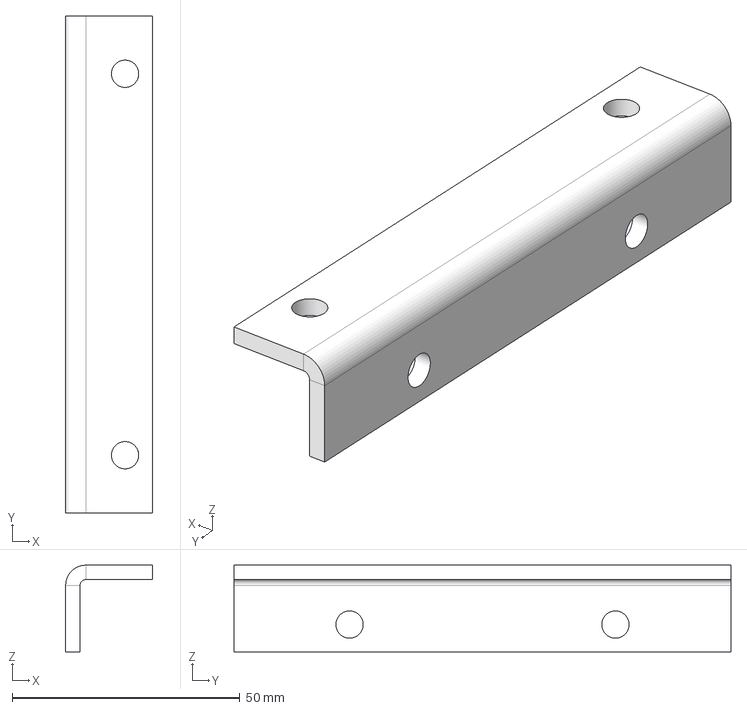
[picture p51: CAD file, 2018-03-14]
Node/PCB/PCB022618/PCB_brackets.stp
19.0 x 109.2 x 19.0 mm
