david-deboer/hera-cad/Node/SNAP_V2/Workspaces/Workspace/components/174E-037-213.STEP

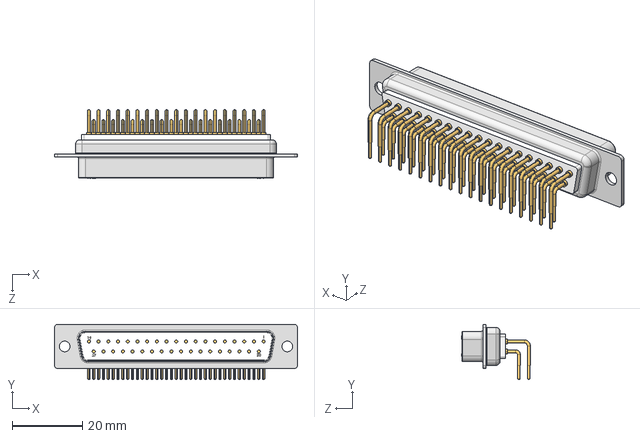
[picture p52: CAD file, 2016-10-25]
Node/SNAP_V2/Workspaces/Workspace/components/174E-037-213.STEP
69.3 x 15.8 x 19.6 mm
