david-deboer/hera-cad/Node/SNAP_V2/Workspaces/Workspace/drawings/quote_step_031617/mounting rail 7.0 x.250 x .250.stp

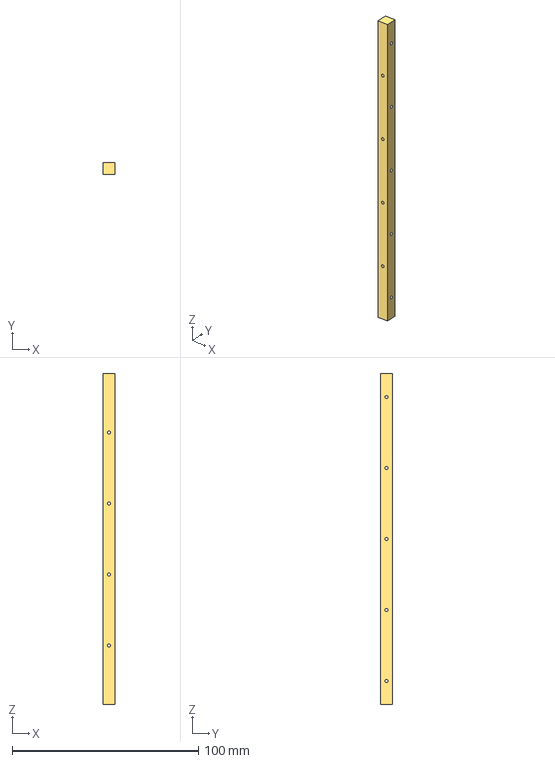
[picture p53: CAD file, 2017-03-25]
Node/SNAP_V2/Workspaces/Workspace/drawings/quote_step_031617/mounting rail 7.0 x.250 x .250.stp
6.35 x 6.35 x 177.8 mm
