david-deboer/hera-cad/Node/PCB/socorro/PDU_chassis_bottom.DXF

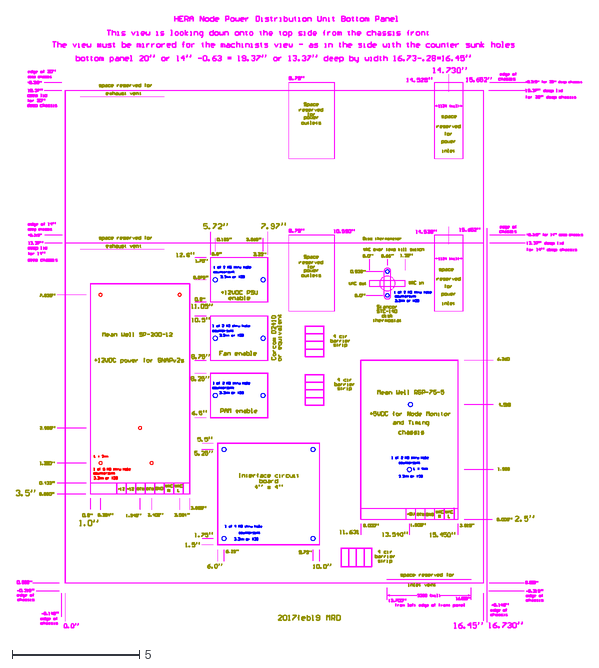
[picture p54: CAD file, 2017-11-21]
Node/PCB/socorro/PDU_chassis_bottom.DXF
22.3 x 24.1
