david-deboer/hera-cad/Node/SNAP_V2/Workspaces/Workspace/components/c-5747024-3-a-3d.stp

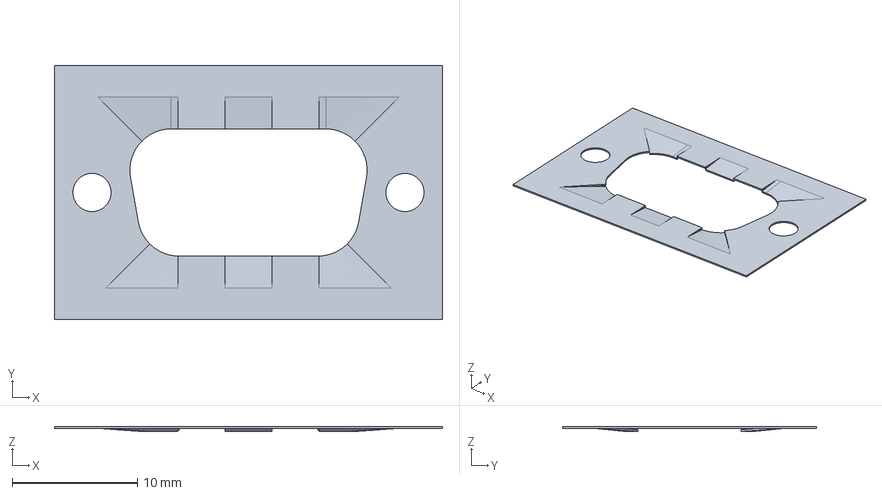
[picture p55: CAD file, 2016-10-25]
Node/SNAP_V2/Workspaces/Workspace/components/c-5747024-3-a-3d.stp
31.0 x 20.3 x 0.406 mm
