david-deboer/hera-cad/Node/PCB/socorro/PDU_chassis_back.DXF

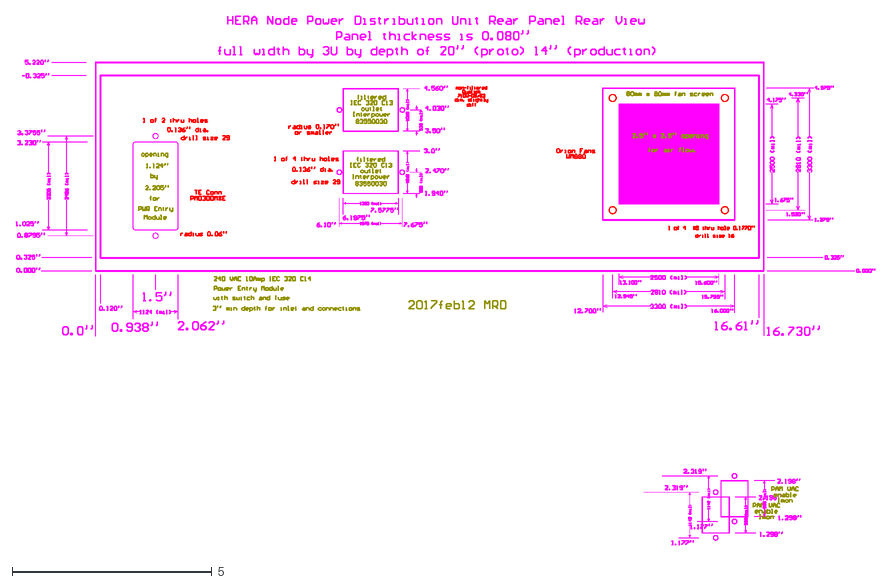
[picture p58: CAD file, 2017-11-21]
Node/PCB/socorro/PDU_chassis_back.DXF
21.5 x 13.2
