david-deboer/hera-cad/Node/SNAP_V2/Workspaces/Workspace/drawings/quote_step_031617/mounting rail 9.0 x.250 x.500-A-sfpcutouts.stp

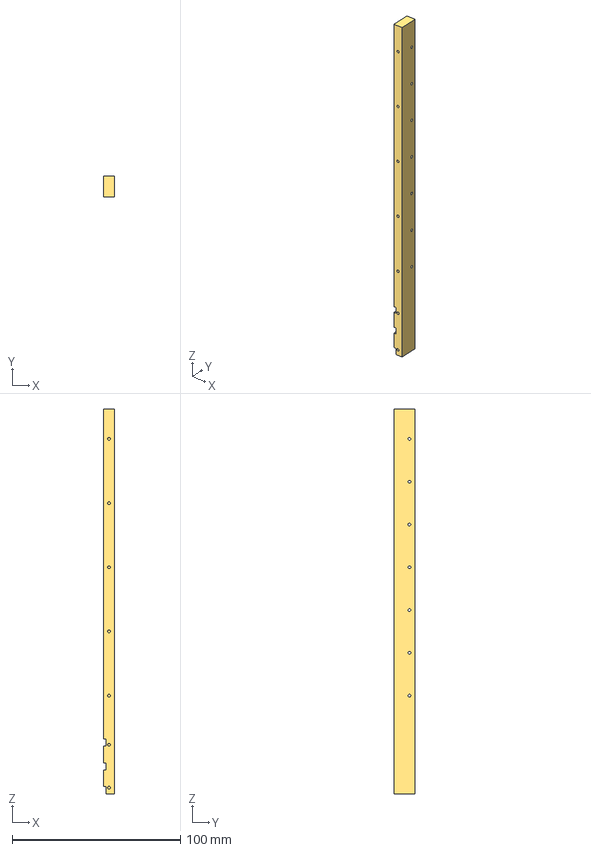
[picture p59: CAD file, 2017-03-25]
Node/SNAP_V2/Workspaces/Workspace/drawings/quote_step_031617/mounting rail 9.0 x.250 x.500-A-sfpcutouts.stp
6.35 x 12.7 x 228.6 mm
