david-deboer/hera-cad/Node/PCB/socorro/PDU_NMT_front.dxf

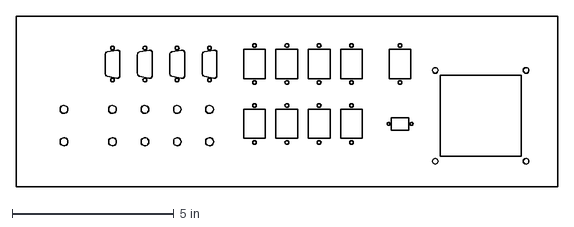
[picture p60: CAD file, 2017-11-21]
Node/PCB/socorro/PDU_NMT_front.dxf
16.7 x 5.26 in
