david-deboer/hera-cad/(list of files, cad)

Other CAD files:
feed/feedAssembly2.dwg
Node/Concept-ICTS/ICTS-20170411/panel_waveguide_assembly.dwg
Node/Concept-ICTS/ICTS-20170411/ssl-version/panel_waveguide_assembly.dwg
heraSite.dwg
Node/FEM_PSU.dwg
Node/Node Layout/node_layout_birdeye.dwg
Node/PCB/PCB022618/white_rabbit_bottom_holes.dwg
Node/PCB/socorro/PCB_sidepanel_left_20.dwg
Node/PDU/PDU_chassis_dsubs.dwg
Node/PDU/updated_drawings_082817/PDU_chassis_decreased_dsubs.dwg
Node/SNAP_mount/ubracket.dwg
Node/SNAP_V2/Templates/English/ANSI (in).dwg
Node/SNAP_V2/Templates/Metric/am_din.dwg
Node/SNAP_V2/Templates/Standard.dwg
Node/SNAP_V2/Workspaces/Workspace/components/dsub37bracket_redraw_right.dwg
Node/SNAP_V2/Workspaces/Workspace/drawings/BOM_front.dwg
Node/SNAP_V2/Workspaces/Workspace/drawings/SNAP Ver2 pack-n-go/Workgroups/NotInProject/SNAP-V2_1_0.dwg
support/endcaps-ChannelVersion/Horizontal channel right.dwg
support/endcaps/H1pe.l_SCa-endCapLeft.dwg
surface/overlapCrossSection.dwg
surface/panels/H1RS-B_Sa-PanelB.dwg
Node/nmt_frontpanel.dwg
Node/PCB/socorro/PCB_sidepanel_right_20.dwg
Node/PDU/dimcheck_PDU_chassis_bottom.dwg
Node/SNAP_mount/uchannel.dwg
Node/SNAP_V2/Templates/English/am_ansi.dwg
Node/SNAP_V2/Templates/Metric/ISO.dwg
Node/SNAP_V2/Workspaces/Workspace/components/dsub37bracket_redraw_left.dwg
Node/SNAP_V2/Workspaces/Workspace/drawings/SNAP 8x10x1.75 Ver1_exploded_side.dwg
support/endcaps-ChannelVersion/HERA_end_cap_right.dwg
surface/panels/H1RS-E_Sa-PanelE.dwg
Node/NMT/nmt_frontpanel_rj45_sc.dwg
Node/NodeLayout.dwg
Node/PCB/socorro/PCB_NMT_bottom.dwg
Node/SNAP_V2/Templates/Metric/am_iso.dwg
Node/SNAP_V2/Workspaces/Workspace/3d prototyping/dsub37_cutout.stl
Node/SNAP_V2/Workspaces/Workspace/components/dsub37bracket_redraw.dwg
Node/SNAP_V2/Workspaces/Workspace/drawings/BOM_top.dwg
Node/SNAP_V2/Workspaces/Workspace/drawings/quote_step_031617/RFT 8x10 Cover.stp
support/endcaps-ChannelVersion/side plate.dwg
surface/panels/H1RS-D_Sa-PanelD.dwg
hub/ringOuter_Split_Flat.stp
Node/PCB/PCB022618/PCB_sidepanel_left_20.stp
Node/PDU/PDU_chassis.stp
Node/SNAP_V2/Templates/Metric/GB.dwg
Node/SNAP_V2/Workspaces/Workspace/drawings/BOM_bottom.dwg
support/endcaps-ChannelVersion/ring support right.dwg
surface/panels/H1RS-C_Sa-PanelC.dwg
Node/Concept-ICTS/ICTS-20170411/ssl-version/panel_waveguide_page2.dwg
Node/node_outline.stp
Node/PCB/socorro/PCB_NMT_front.dwg
Node/PDU/PDU_chassis_bottom.stp
Node/SNAP_V2/Templates/Metric/am_bsi.dwg
Node/SNAP_V2/Workspaces/Workspace/drawings/BOM_left.dwg
surface/panels/H1RS.A_SSA-PanelA.dwg
Node/PCB/socorro/PCB_front_origin.dwg
Node/SNAP_V2/Templates/Metric/ANSI (mm).dwg
Node/SNAP_V2/Workspaces/Workspace/drawings/BOM_top_nolid.dwg
Node/SNAP_V2/Workspaces/Workspace/drawings/quote_drawings_030518_productionRobotics/mounting rail 9.0 x.250 x.500-A-sfpcutouts_pr.dwg
surface/panels/panels.dwg
Node/H3_trench_elevation.dwg
Node/PCB/PCB022618/PCB_bracket.stp
Node/SNAP_V2/Templates/Metric/am_gb.dwg
Node/SNAP_V2/Workspaces/Workspace/drawings/BOM_right.dwg
Node/SNAP_V2/Workspaces/Workspace/drawings/quote_drawings_030518_productionRobotics/mounting rail 7.0 x.250 x .250_pr.dwg
Node/PCB/PCB022618/PCB_back.stp
Node/PCB/socorro/PCB_chassis_back.dwg
Node/SNAP_V2/Templates/Metric/BSI.dwg
Node/SNAP_V2/Workspaces/Workspace/drawings/BOM_back.dwg
Node/SNAP_V2/Workspaces/Workspace/drawings/quote_drawings_030518_productionRobotics/mounting rail 9.0 x.250 x.500-B_pr.dwg
Node/PCB/PCB022618/PCB_front.stp
Node/SNAP_V2/Templates/Metric/JIS.dwg
Node/SNAP_V2/Workspaces/Workspace/drawings/snapEnclosure.dwg
Node/SNAP_V2/Templates/Metric/am_jis.dwg
Node/SNAP_V2/Workspaces/Workspace/drawings/mounting rail 9.0 x.250 x.500-A.dwg
Node/SNAP_V2/Workspaces/Workspace/drawings/quote_step_031617/mezzanineBracketLeft.stp
Node/SNAP_V2/Templates/Metric/GOST.dwg
Node/SNAP_V2/Templates/Metric/DIN.dwg
Node/40mm_flange.ipt
Node/8-32ventScrew.ipt
Node/Acopian-M13-Case.iam
Node/Concept-ICTS/HERA_NODE_SHIELDED_ENCLOSURE_ITC_CONCEPT.iam
Node/Concept-ICTS/HERA_NODE_SHIELDED_ENCLOSURE_ITC_CONCEPT1.ipt
Node/Concept-ICTS/HERA_NODE_SHIELDED_ENCLOSURE_ITC_CONCEPT10.ipt
Node/Concept-ICTS/HERA_NODE_SHIELDED_ENCLOSURE_ITC_CONCEPT11.ipt
Node/Concept-ICTS/HERA_NODE_SHIELDED_ENCLOSURE_ITC_CONCEPT12.ipt
Node/Concept-ICTS/HERA_NODE_SHIELDED_ENCLOSURE_ITC_CONCEPT13.ipt
Node/Concept-ICTS/HERA_NODE_SHIELDED_ENCLOSURE_ITC_CONCEPT14.ipt
Node/Concept-ICTS/HERA_NODE_SHIELDED_ENCLOSURE_ITC_CONCEPT15.ipt
Node/Concept-ICTS/HERA_NODE_SHIELDED_ENCLOSURE_ITC_CONCEPT16.ipt
Node/Concept-ICTS/HERA_NODE_SHIELDED_ENCLOSURE_ITC_CONCEPT17.ipt
Node/Concept-ICTS/HERA_NODE_SHIELDED_ENCLOSURE_ITC_CONCEPT18.ipt
Node/Concept-ICTS/HERA_NODE_SHIELDED_ENCLOSURE_ITC_CONCEPT19.ipt
Node/Concept-ICTS/HERA_NODE_SHIELDED_ENCLOSURE_ITC_CONCEPT2.ipt
Node/Concept-ICTS/HERA_NODE_SHIELDED_ENCLOSURE_ITC_CONCEPT20.ipt
Node/Concept-ICTS/HERA_NODE_SHIELDED_ENCLOSURE_ITC_CONCEPT21.ipt
Node/Concept-ICTS/HERA_NODE_SHIELDED_ENCLOSURE_ITC_CONCEPT3.ipt
Node/Concept-ICTS/HERA_NODE_SHIELDED_ENCLOSURE_ITC_CONCEPT4.ipt
Node/Concept-ICTS/HERA_NODE_SHIELDED_ENCLOSURE_ITC_CONCEPT5.ipt
Node/Concept-ICTS/HERA_NODE_SHIELDED_ENCLOSURE_ITC_CONCEPT6.ipt
Node/Concept-ICTS/HERA_NODE_SHIELDED_ENCLOSURE_ITC_CONCEPT7.ipt
Node/Concept-ICTS/HERA_NODE_SHIELDED_ENCLOSURE_ITC_CONCEPT8.ipt
Node/Concept-ICTS/HERA_NODE_SHIELDED_ENCLOSURE_ITC_CONCEPT9.ipt
Node/Concept-ICTS/ICTS-20170411/EYE-BOLT FREE ISSUE.ipt
Node/Concept-ICTS/ICTS-20170411/P-FHS-M6-18.ipt
Node/Concept-ICTS/ICTS-20170411/RD-A001-P001-REV0-cutouts.ipt
Node/Concept-ICTS/ICTS-20170411/RD-A001-P001-REV0.ipt
Node/Concept-ICTS/ICTS-20170411/RD-A001-P002-REV0.ipt
Node/Concept-ICTS/ICTS-20170411/RD-A001-P003-REV0(Default).ipt
Node/Concept-ICTS/ICTS-20170411/RD-A001-P003.iam
Node/Concept-ICTS/ICTS-20170411/RD-A001-P003_1.iam
Node/Concept-ICTS/ICTS-20170411/RD-A001-P004-REV0.ipt
Node/Concept-ICTS/ICTS-20170411/RD-A001-P006-REV0.ipt
Node/Concept-ICTS/ICTS-20170411/RD-A001-P007-REV0.ipt
Node/Concept-ICTS/ICTS-20170411/RD-A001-P007.iam
Node/Concept-ICTS/ICTS-20170411/RD-A001-P008(Default).iam
Node/Concept-ICTS/ICTS-20170411/RD-A001-P008-REV0.ipt
Node/Concept-ICTS/ICTS-20170411/RD-A001-P009-REV0.ipt
Node/Concept-ICTS/ICTS-20170411/RD-A001-P010-REV0(DefaultSM-FLAT-PATTERN).ipt
Node/Concept-ICTS/ICTS-20170411/RD-A001-P011-REV0.ipt
Node/Concept-ICTS/ICTS-20170411/RD-A001-P012-REV0.ipt
Node/Concept-ICTS/ICTS-20170411/RD-A001-P013-REV0.ipt
Node/Concept-ICTS/ICTS-20170411/RD-A001-P014-REV0.ipt
Node/Concept-ICTS/ICTS-20170411/RD-A001-P015-REV0.ipt
Node/Concept-ICTS/ICTS-20170411/RD-A001-P016-REV0.ipt
Node/Concept-ICTS/ICTS-20170411/RD-A001-P017-REV0(Default).ipt
Node/Concept-ICTS/ICTS-20170411/RD-A001-P018-REV0.ipt
Node/Concept-ICTS/ICTS-20170411/RD-A001-P019-REV0.ipt
Node/Concept-ICTS/ICTS-20170411/RD-A001-P020-REV0.ipt
Node/Concept-ICTS/ICTS-20170411/RD-A001-P021-REV0.ipt
Node/Concept-ICTS/ICTS-20170411/RD-A001-P022-REV0.ipt
Node/Concept-ICTS/ICTS-20170411/RD-A001-P023-REV0.ipt
Node/Concept-ICTS/ICTS-20170411/RD-A001-P024-REV0.ipt
Node/Concept-ICTS/ICTS-20170411/RD-A001-P025-REV0.ipt
Node/Concept-ICTS/ICTS-20170411/RD-A001-P026-REV0.ipt
Node/Concept-ICTS/ICTS-20170411/RD-A001-P027-REV0.ipt
Node/Concept-ICTS/ICTS-20170411/RD-A001-P028-REV0.ipt
Node/Concept-ICTS/ICTS-20170411/RD-A001-P029-REV0.ipt
Node/Concept-ICTS/ICTS-20170411/RD-A001-P030-REV0.ipt
Node/Concept-ICTS/ICTS-20170411/RD-A001-P031-REV0.ipt
Node/Concept-ICTS/ICTS-20170411/RD-A001-P032-REV0.ipt
Node/Concept-ICTS/ICTS-20170411/RD-A001-P033-REV0.ipt
Node/Concept-ICTS/ICTS-20170411/RD-A001-P034-REV0.iam
Node/Concept-ICTS/ICTS-20170411/RD-A001-P034-REV0.ipt
Node/Concept-ICTS/ICTS-20170411/RD-A001-P034-REV0_1.iam
Node/Concept-ICTS/ICTS-20170411/RD-A001-P034-REV0_2.iam
Node/Concept-ICTS/ICTS-20170411/RD-A001-P034-REV0_3.iam
Node/Concept-ICTS/ICTS-20170411/RD-A001-P034-REV0_4.iam
Node/Concept-ICTS/ICTS-20170411/RD-A001-P034-REV0_5.iam
Node/Concept-ICTS/ICTS-20170411/RD-A001-P035-REV0.ipt
Node/Concept-ICTS/ICTS-20170411/RD-A001-P036-REV0.ipt
Node/Concept-ICTS/ICTS-20170411/RD-A002-P000-REV0.iam
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
