david-deboer/hera-cad/surface/splash/splashAssembly.pdf

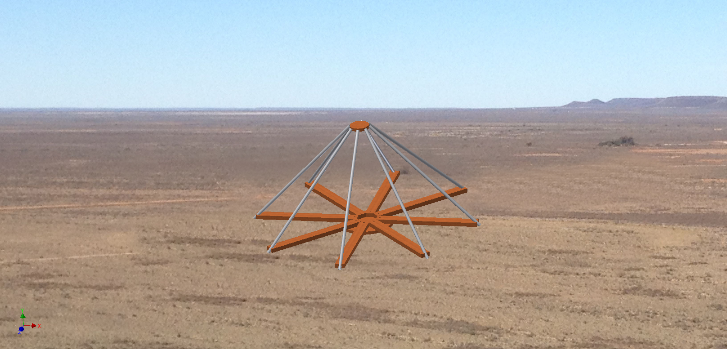
[picture p63: page 1]
