david-deboer/hera-cad/feed/bpSupAssembly.png

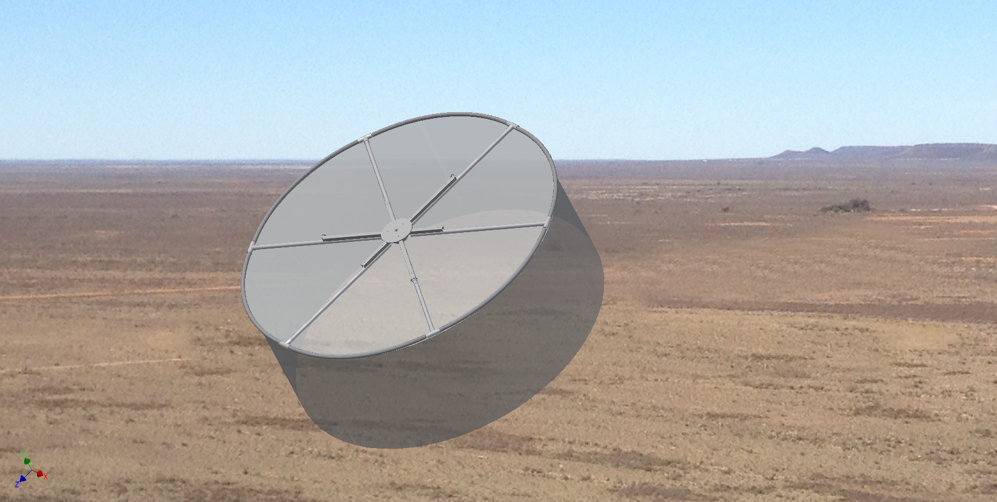
feed/bpSupAssembly.png
