david-deboer/hera-cad/feed/feedAssemblyBottom.png

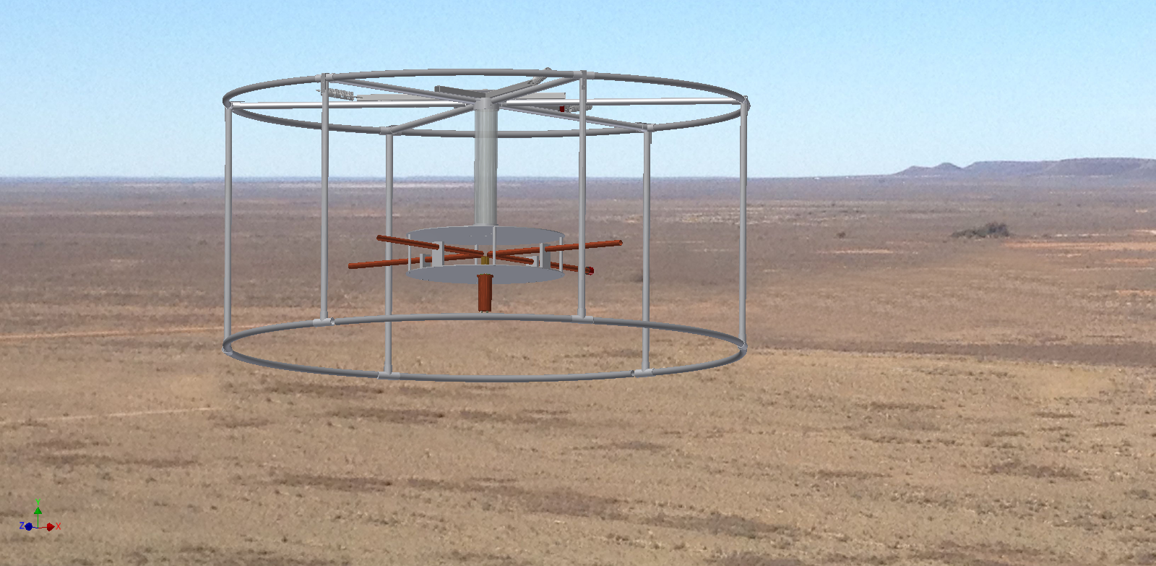
feed/feedAssemblyBottom.png
