david-deboer/hera-cad/feed/feedAssemblyTop.png

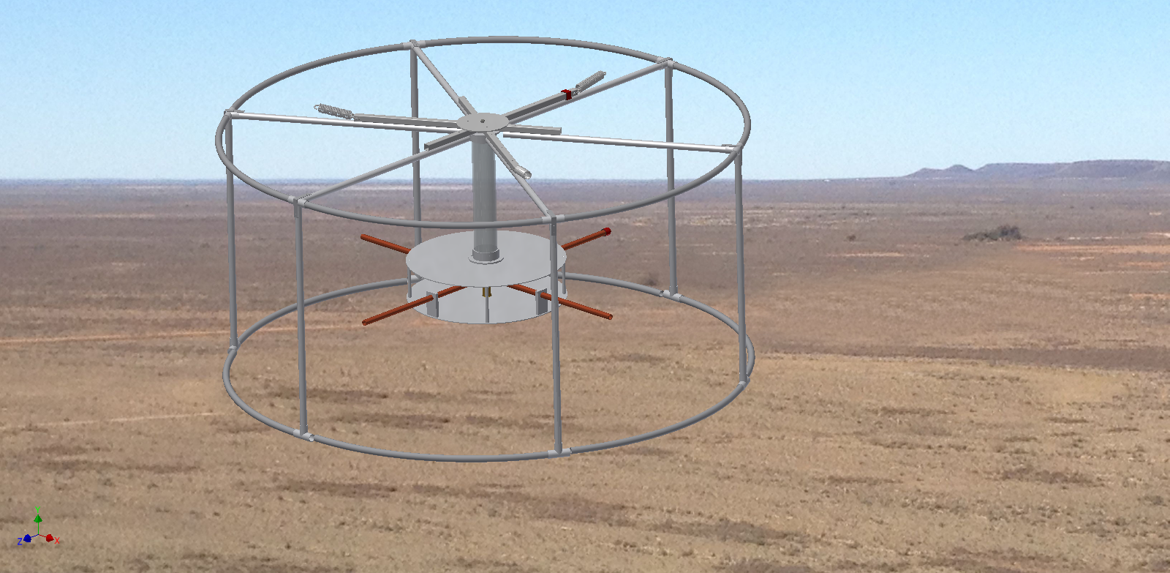
feed/feedAssemblyTop.png
