david-deboer/hera-cad/feed/H2bmA_5a_bpMechSupAssembly.pdf

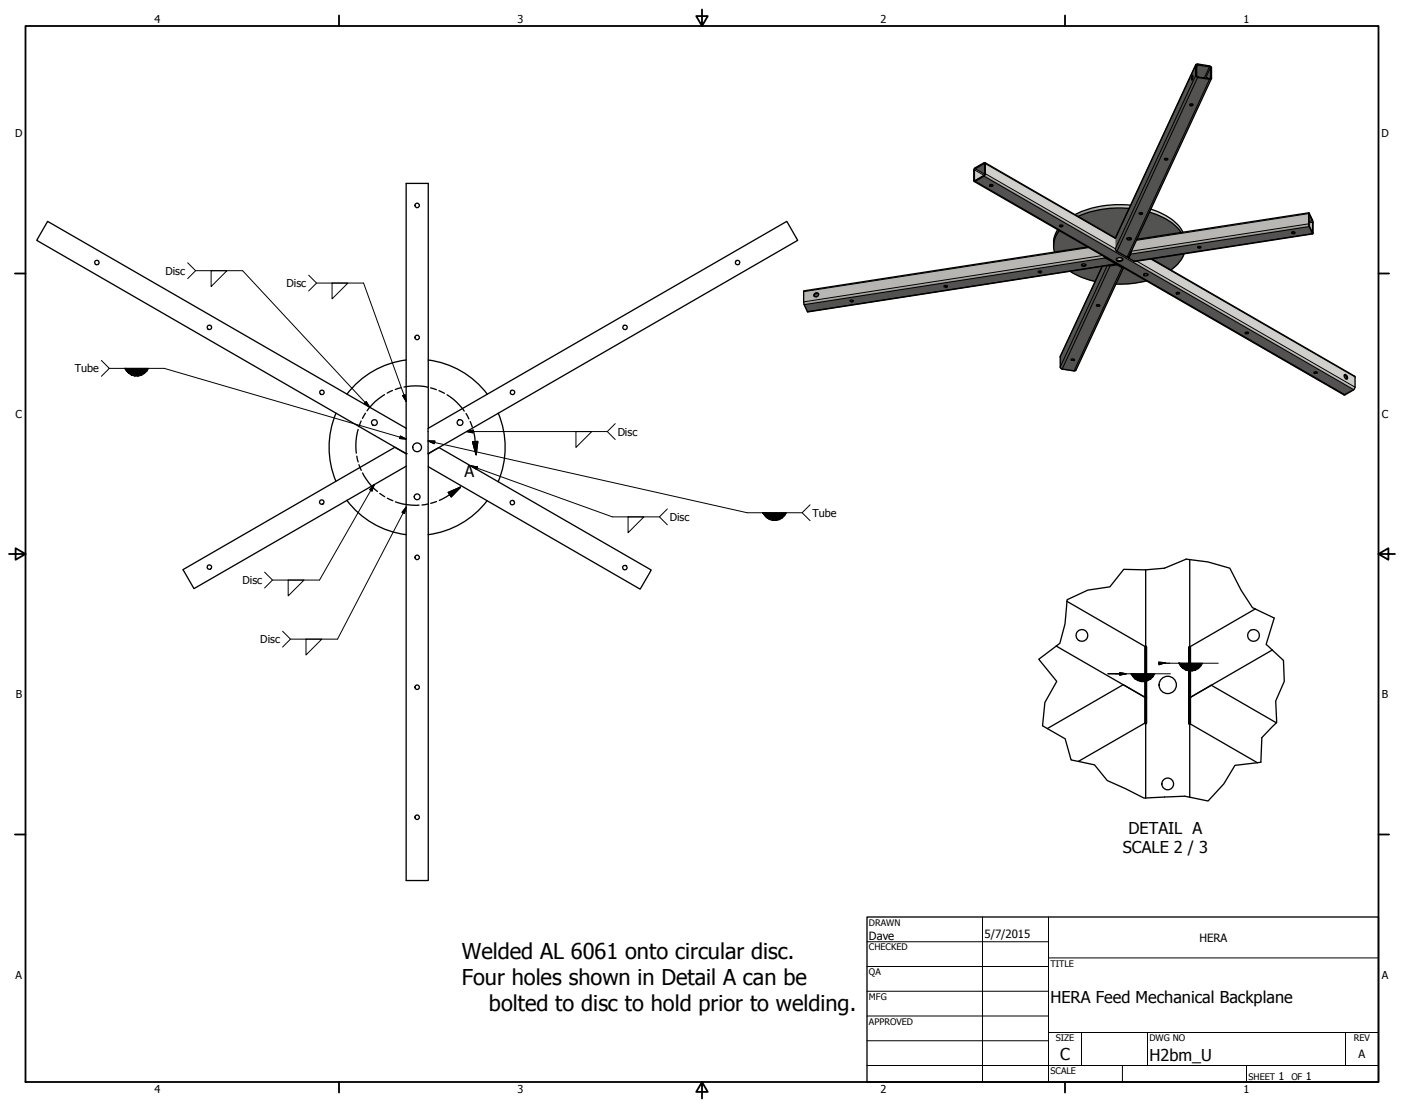
[picture p67: page 1]
DETAIL A SCALE 2 / 3; SHEET 1 OF 1; DRAWN; CHECKED; MFG; APPROVED; Dave; DWG NO H2bm_U; SIZE C; SCALE; HERA; REV A; Disc; Tube

Welded AL 6061 onto circular disc.
Four holes shown in Detail A can be
bolted to disc to hold prior to welding.

TITLE
HERA Feed Mechanical Backplane

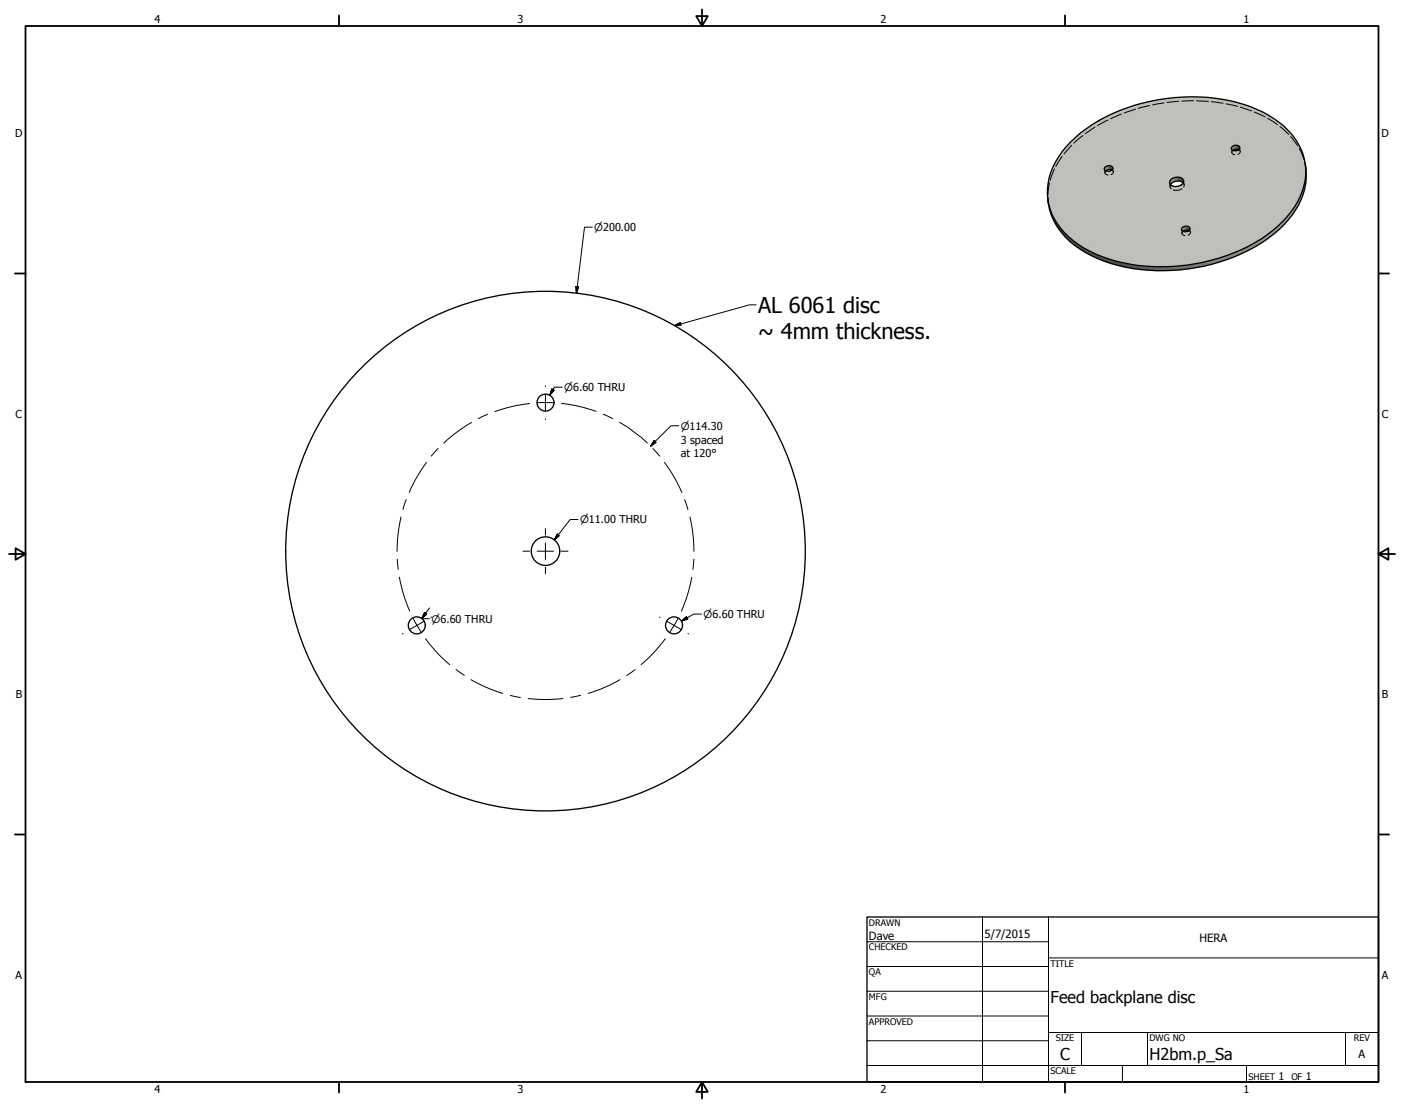
[picture p68: page 2]
DRAWN; CHECKED; MFG; Dave; HERA; P11.00 THRU; P6.60 THRU; AL 6061 disc ~ 4mm thickness.; P114.30 3 spaced at 120°

TITLE
Feed backplane disc

Top | Side

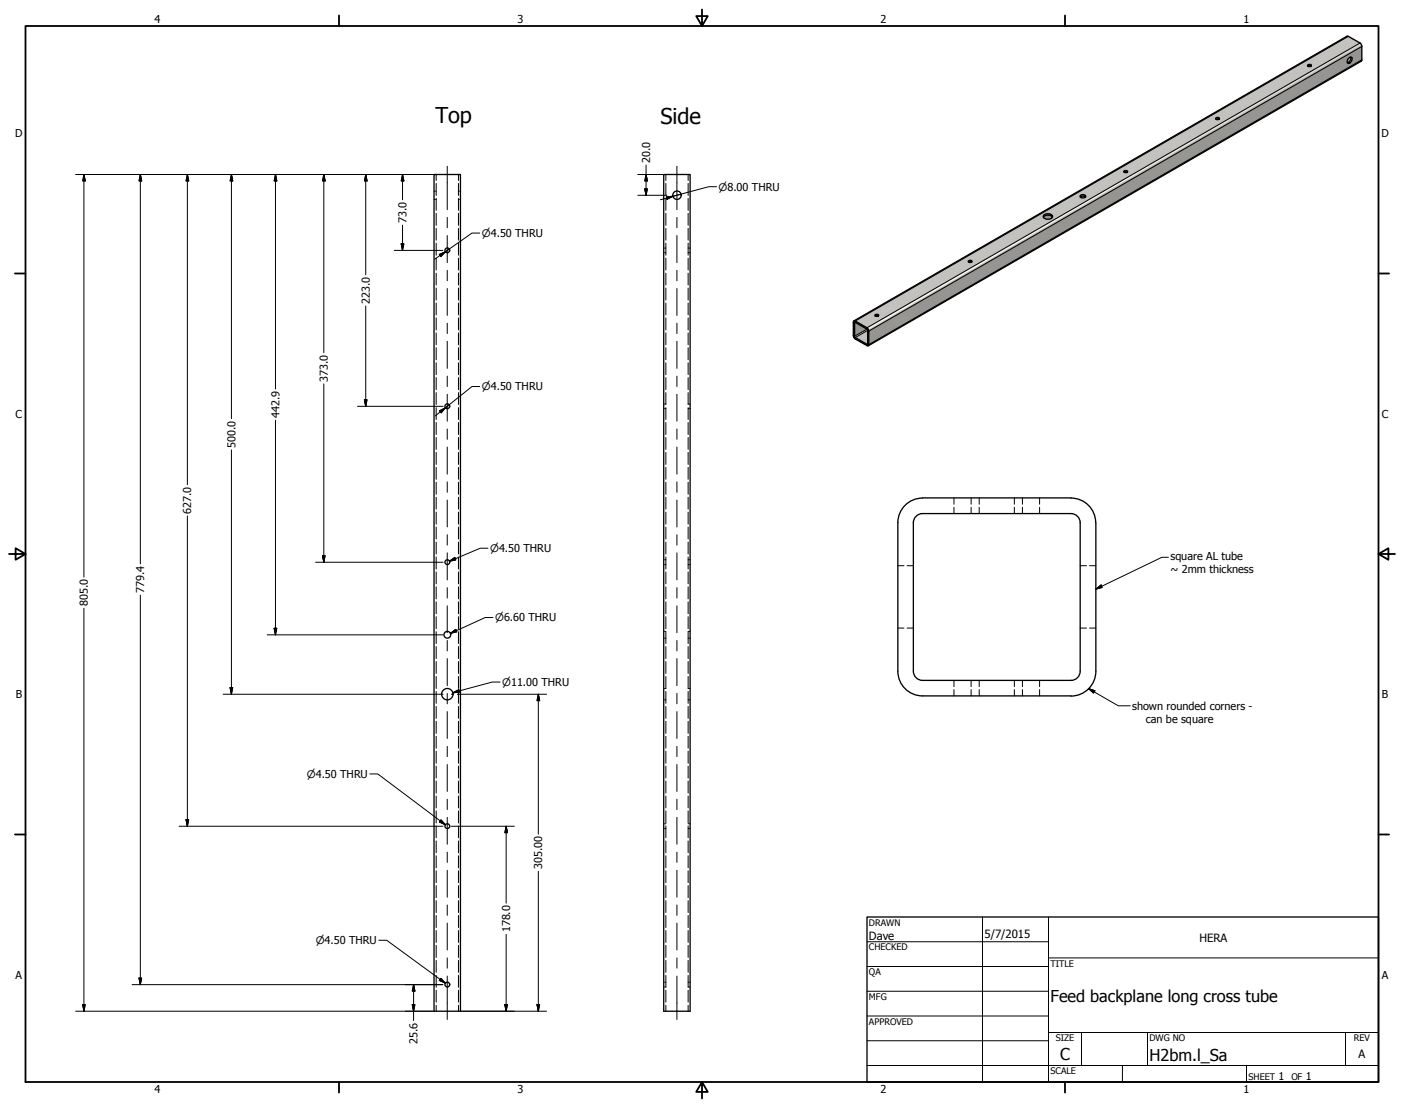
[picture p69: page 3]
DRAWN; CHECKED; MFG; Dave; HERA; P8.00 THRU; P4.50 THRU; P6.60 THRU; P11.00 THRU

square AL tube
~ 2mm thickness

shown rounded corners -
can be square

TITLE
Feed backplane long cross tube

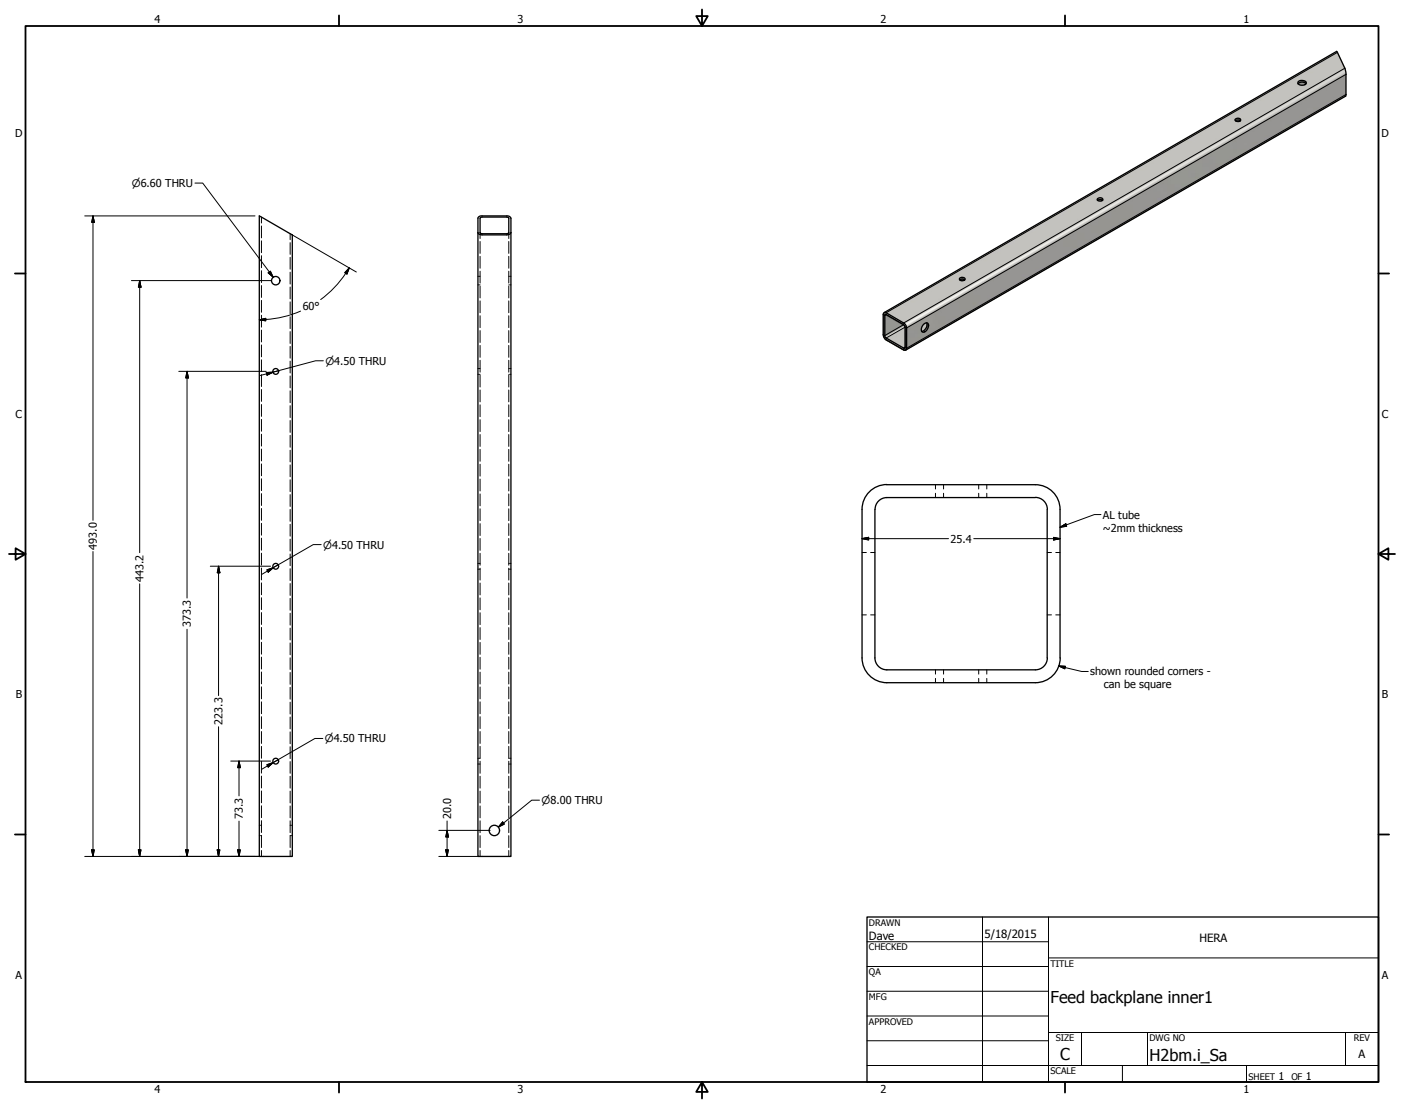
[picture p70: page 4]
DRAWN; CHECKED; MFG; Dave; TITLE Feed backplane inner1; HERA; AL tube ~2mm thickness; P6.60 THRU; P4.50 THRU; P8.00 THRU

shown rounded corners -
can be square

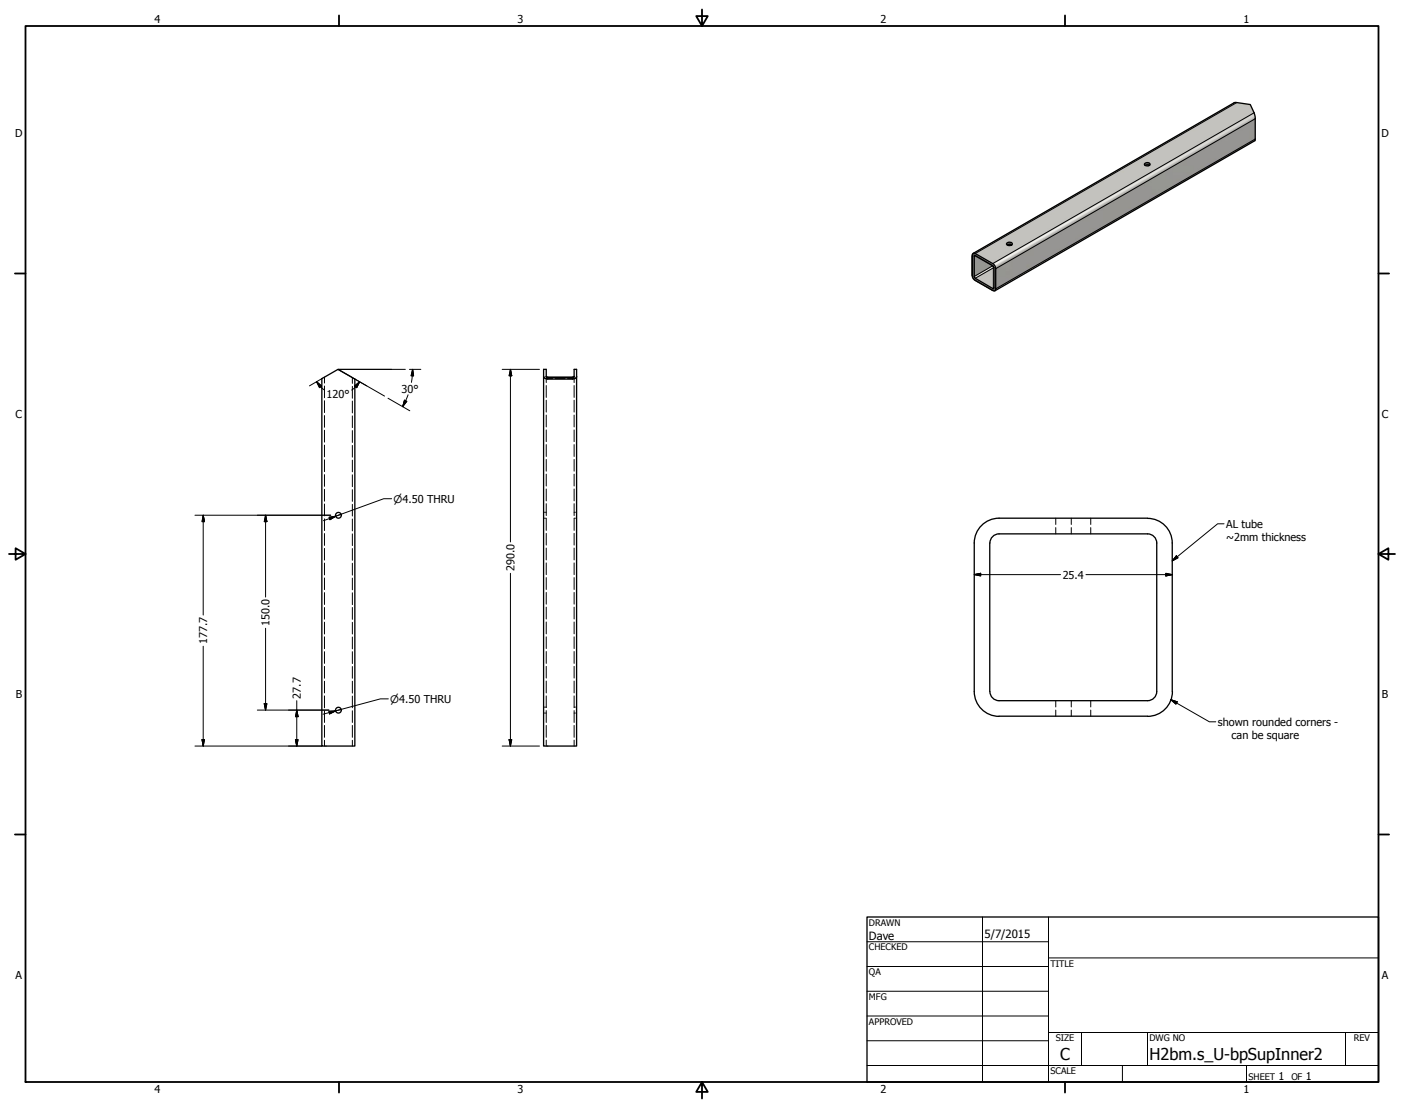
[picture p71: page 5]
DRAWN; CHECKED; MFG; Dave; H2bm.s_U-bpSupInner2; TITLE; P4.50 THRU; AL tube ~2mm thickness

shown rounded corners -
can be square
