david-deboer/hera-cad/surface/H1rcAU_a_crossAssembly-US.pdf

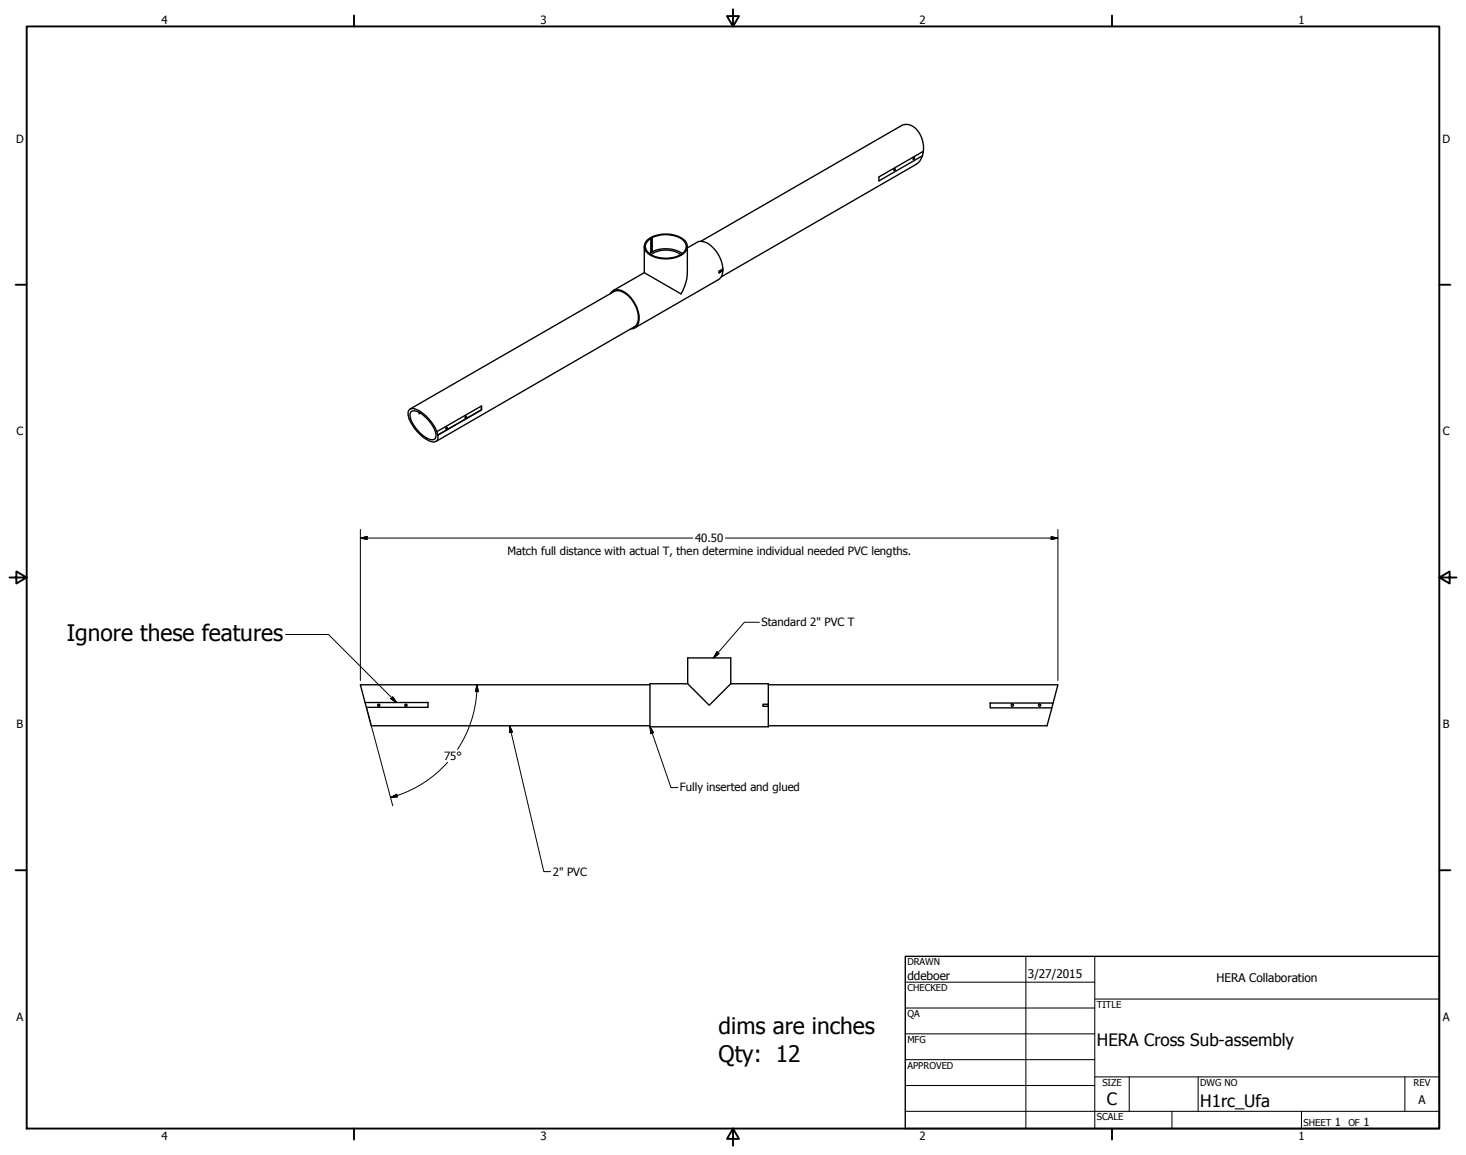
[picture p72: page 1]
SHEET 1 OF 1; DRAWN; CHECKED; MFG; APPROVED; ddeboer; DWG NO H1rc_Ufa; TITLE; SIZE C; SCALE; HERA Collaboration; REV A; Standard 2" PVC T; 2" PVC

Match full distance with actual T, then determine individual needed PVC lengths.

Ignore these features

Fully inserted and glued

dims are inches
Qty: 12

HERA Cross Sub-assembly
