david-deboer/hera-cad/support/H1pvAU_a_sparAssembly.pdf

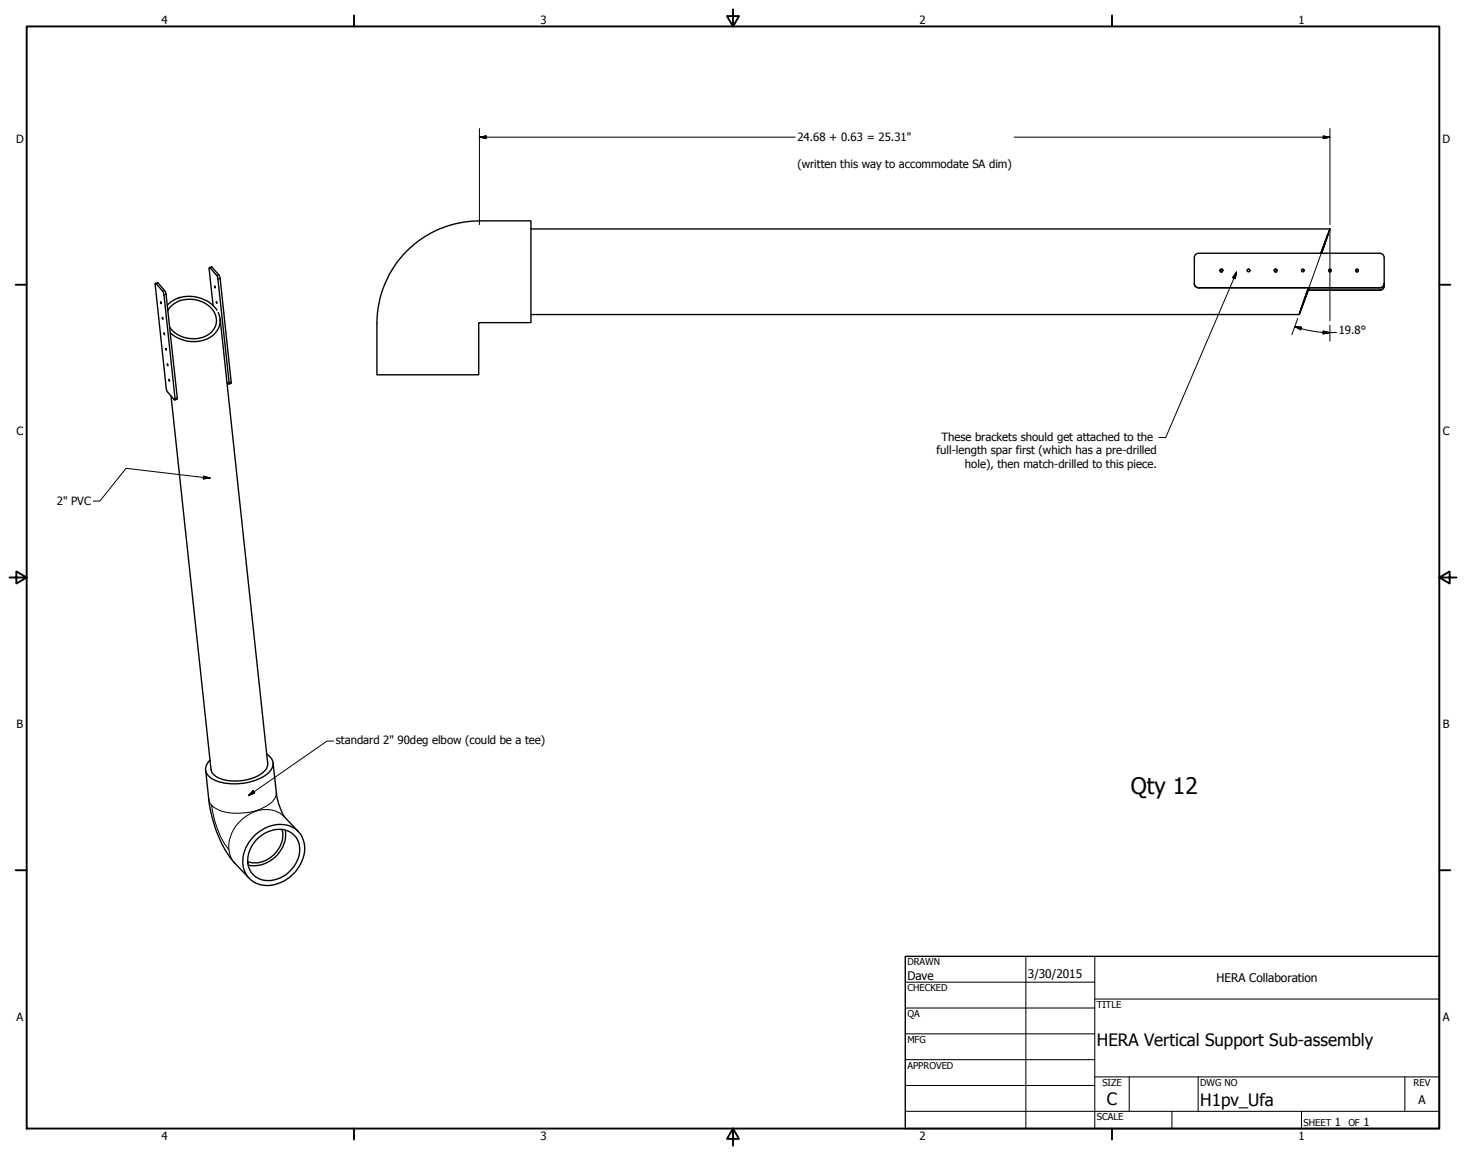
[picture p73: page 1]
SHEET 1 OF 1; DRAWN; CHECKED; MFG; APPROVED; Dave; DWG NO H1pv_Ufa; TITLE; SIZE C; SCALE; HERA Collaboration; REV A; 2" PVC; Qty 12

(written this way to accommodate SA dim)

These brackets should get attached to the
full-length spar first (which has a pre-drilled
hole), then match-drilled to this piece.

standard 2" 90deg elbow (could be a tee)

HERA Vertical Support Sub-assembly
