david-deboer/hera-cad/surface/H1rcA_a_crossAssembly-SA.pdf

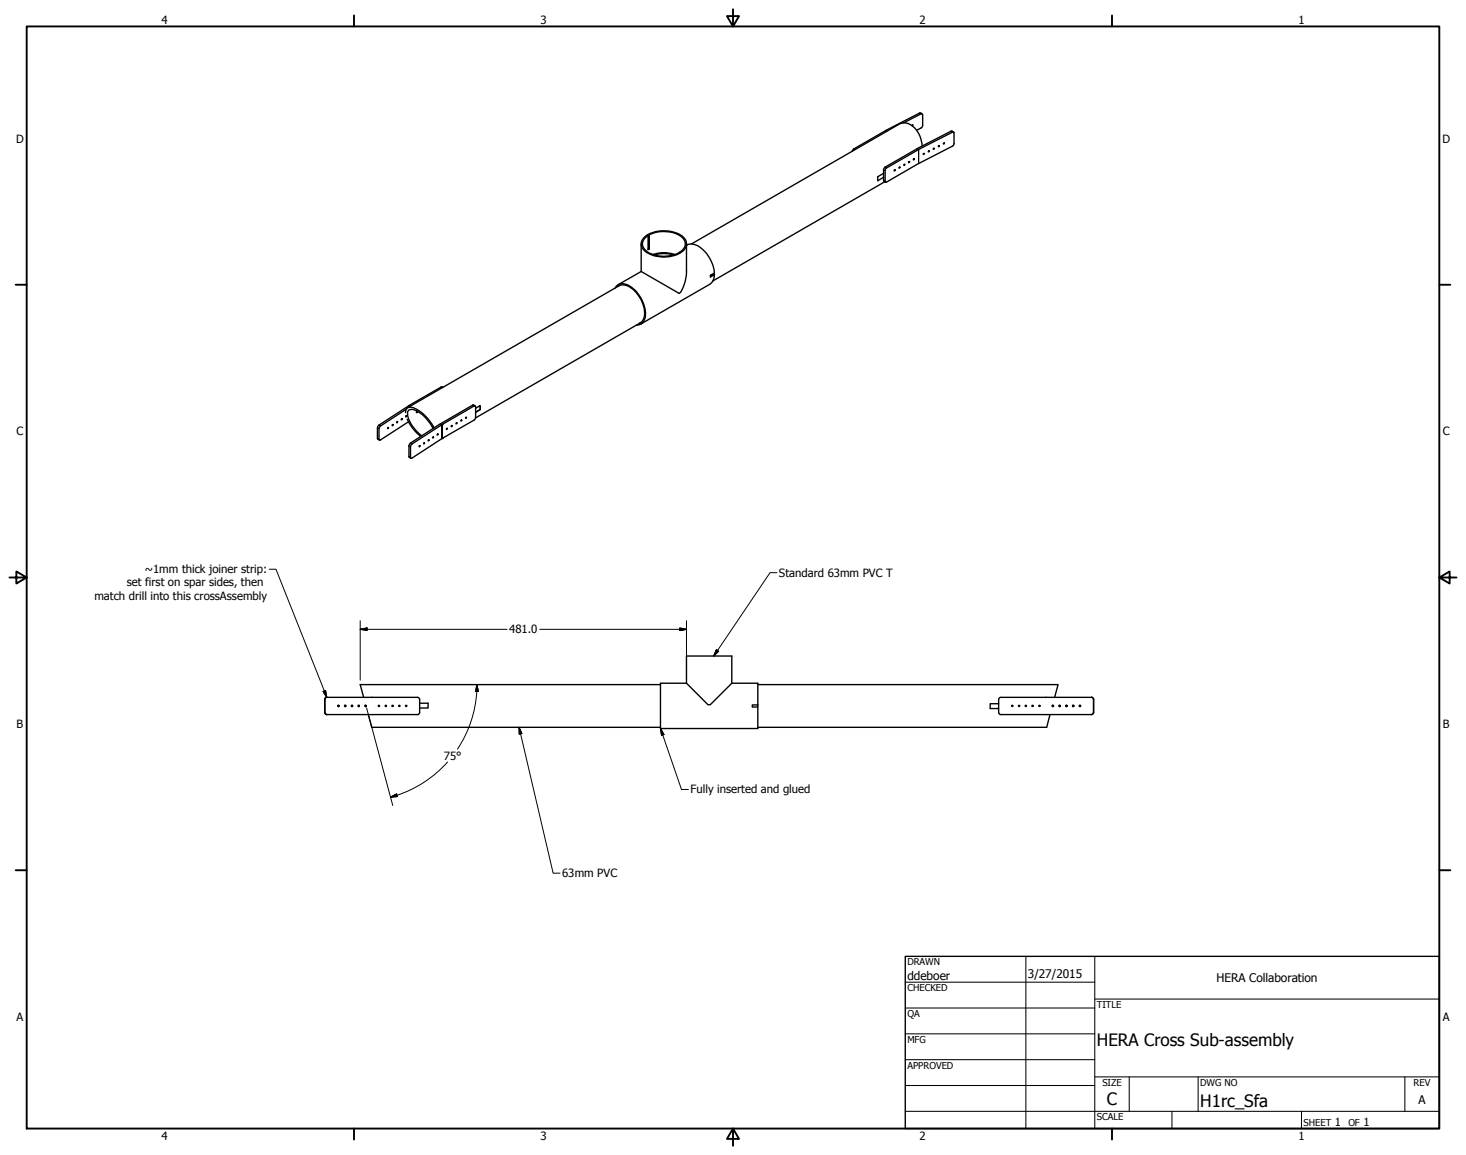
[picture p74: page 1]
SHEET 1 OF 1; DRAWN; CHECKED; MFG; APPROVED; ddeboer; DWG NO H1rc_Sfa; TITLE; SIZE C; SCALE; HERA Collaboration; REV A; Standard 63mm PVC T; 63mm PVC

~1mm thick joiner strip:
set first on spar sides, then
match drill into this crossAssembly

Fully inserted and glued

HERA Cross Sub-assembly
