david-deboer/hera-cad/support/pole/H1plAU_3a_poleAssembly.pdf

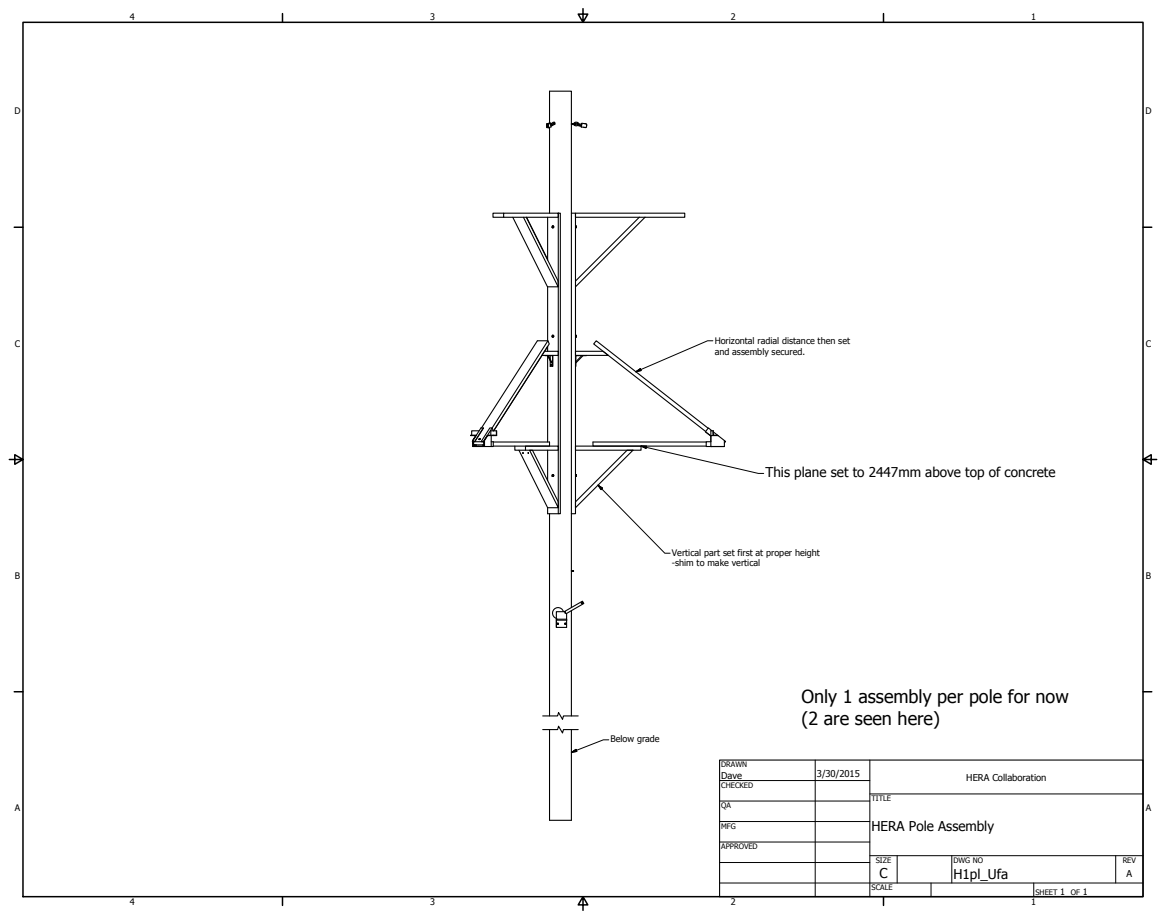
[picture p75: page 1]
SHEET 1 OF 1; DRAWN; CHECKED; MFG; APPROVED; Dave; DWG NO H1pl_Ufa; SIZE C; SCALE; HERA Collaboration; REV A; Below grade

Horizontal radial distance then set
and assembly secured.

This plane set to 2447mm above top of concrete

Vertical part set first at proper height
-shim to make vertical

Only 1 assembly per pole for now
(2 are seen here)

TITLE
HERA Pole Assembly

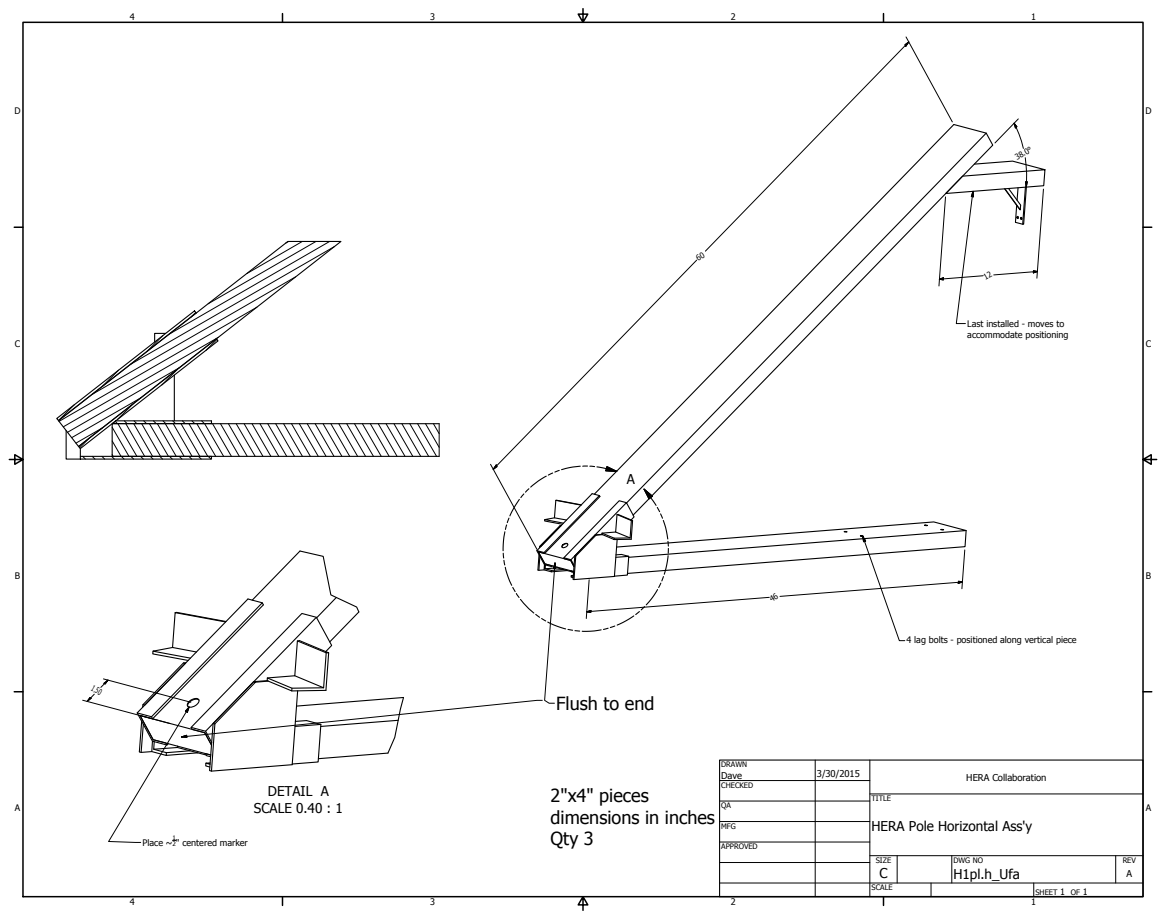
[picture p76: page 2]
DETAIL A SCALE 0.40 : 1; DRAWN; CHECKED; MFG; Dave; H1pl.h_Ufa; HERA Collaboration; Place ~¹ 2" centered marker

Last installed - moves to
accommodate positioning

4 lag bolts - positioned along vertical piece

Flush to end

2"x4" pieces
dimensions in inches
Qty 3

TITLE
HERA Pole Horizontal Ass'y

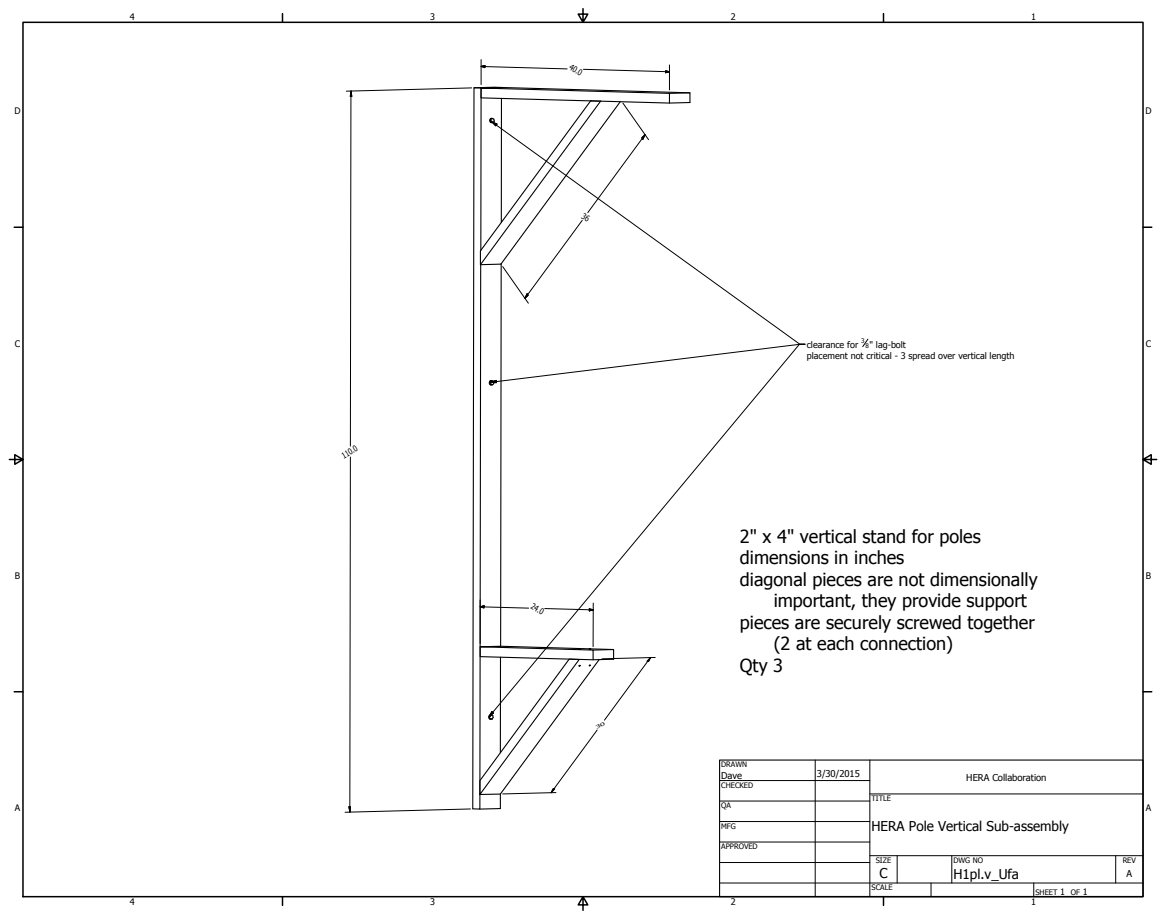
[picture p77: page 3]
DRAWN; CHECKED; MFG; Dave; H1pl.v_Ufa; HERA Collaboration; 8" lag-bolt

clearance for 3
placement not critical - 3 spread over vertical length

2" x 4" vertical stand for poles
dimensions in inches
diagonal pieces are not dimensionally
important, they provide support
pieces are securely screwed together
(2 at each connection)
Qty 3

TITLE
HERA Pole Vertical Sub-assembly
