david-deboer/hera-cad/support/post/H1psAU_a_postAssembly.pdf

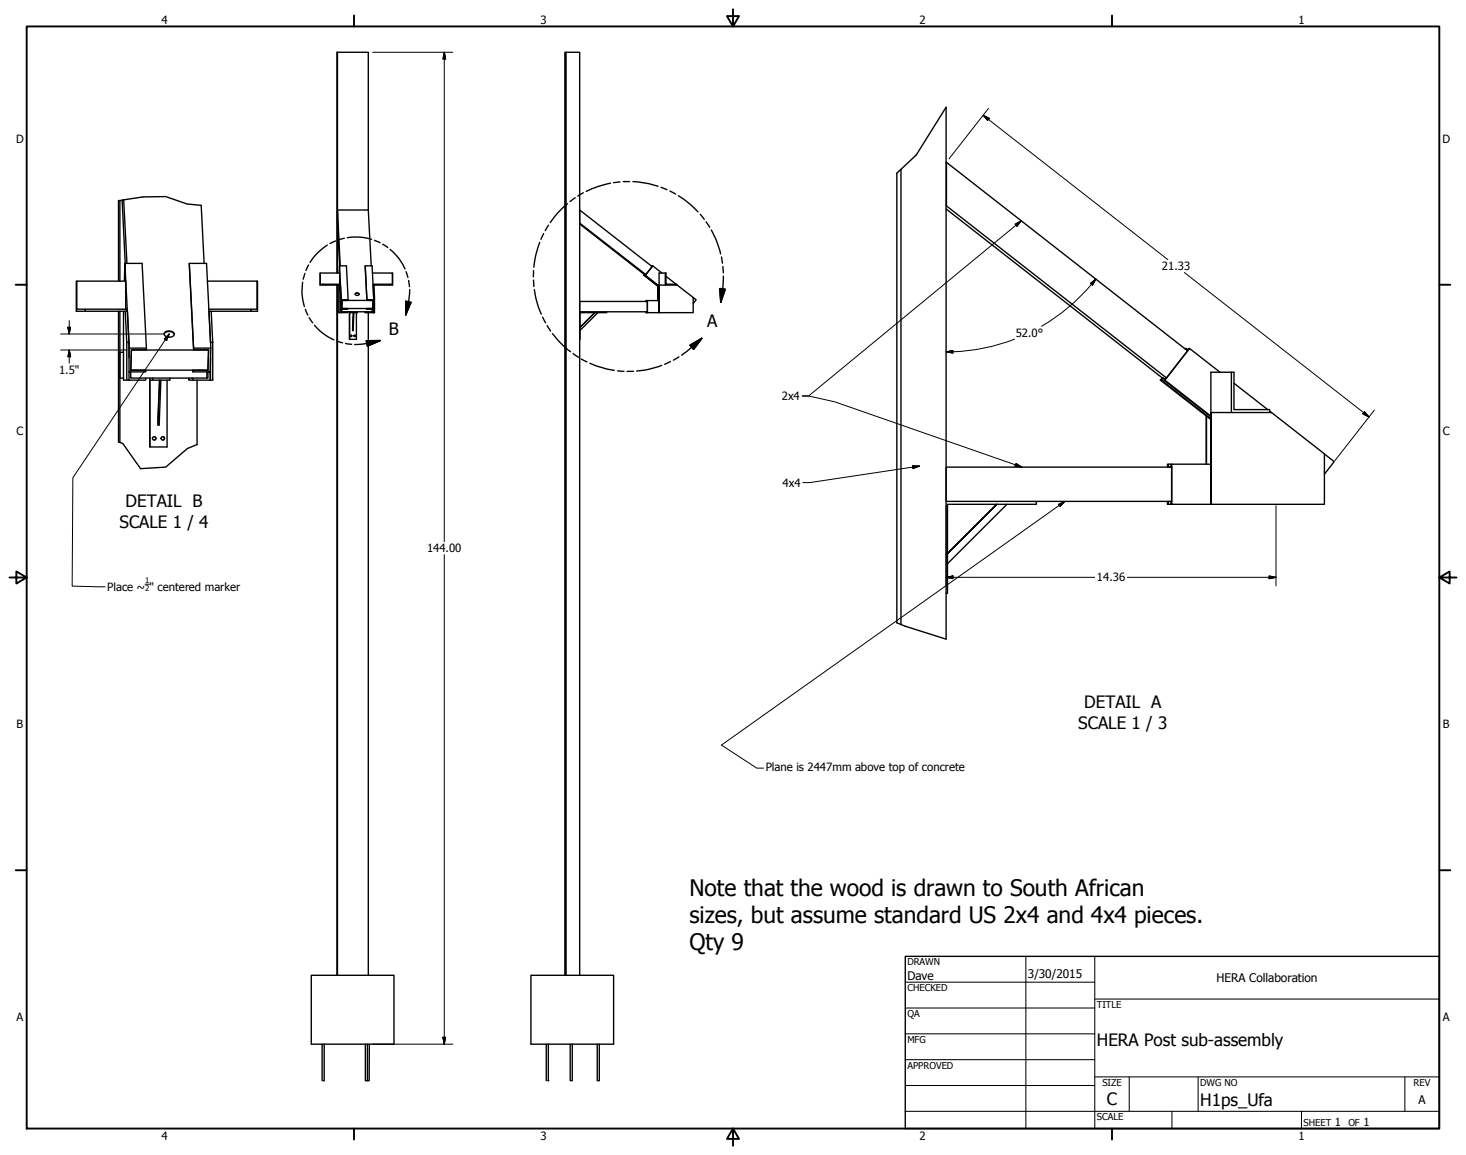
[picture p78: page 1]
DETAIL A SCALE 1 / 3; DETAIL B SCALE 1 / 4; SHEET 1 OF 1; DRAWN; CHECKED; MFG; APPROVED; Dave; DWG NO H1ps_Ufa; TITLE; SIZE C; SCALE; HERA Collaboration; REV A; Place ~; 1 2" centered marker

Plane is 2447mm above top of concrete

Note that the wood is drawn to South African
sizes, but assume standard US 2x4 and 4x4 pieces.
Qty 9

HERA Post sub-assembly
