david-deboer/hera-cad/Node/PDU/updated_drawings_082817/PDU_chassis_decreased_dsubs.pdf

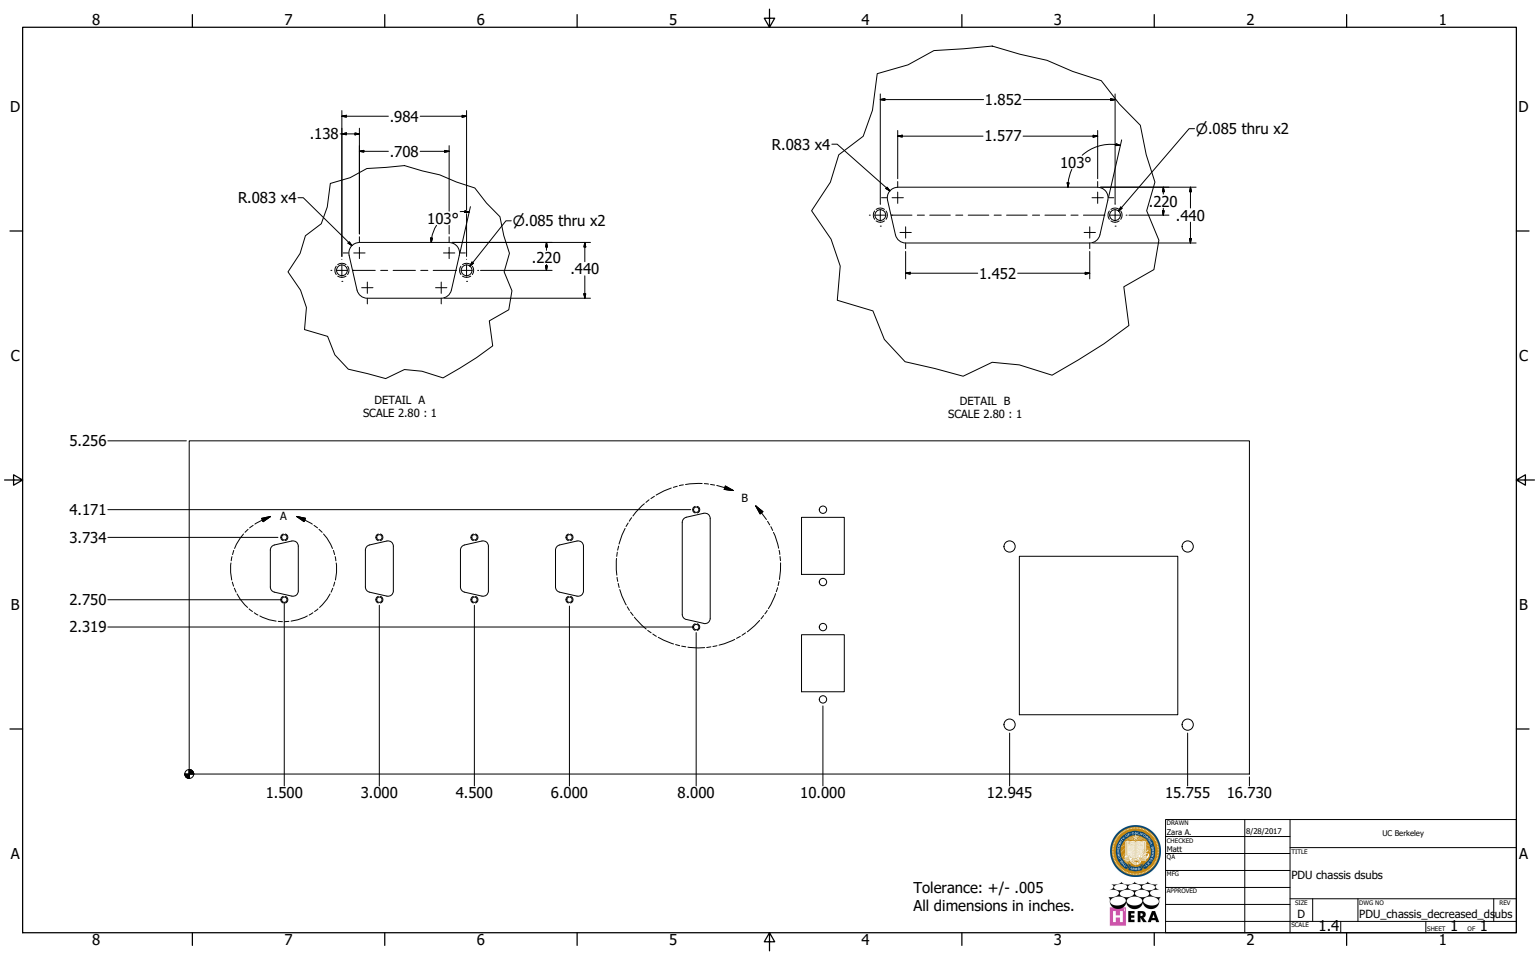
[picture p79: page 1]
DETAIL A SCALE 2.80 : 1; DETAIL B SCALE 2.80 : 1; SHEET 1 OF 1; DRAWN; CHECKED; MFG; APPROVED; Zara A.; Matt; DWG NO PDU_chassis_decreased_dsubs; TITLE; SIZE D; SCALE; UC Berkeley; REV; P.085 thru x2

PDU chassis dsubs

Tolerance: +/- .005
All dimensions in inches.
