david-deboer/hera-cad/Node/PDU/quote_drawings_022317/PDU_chassis.pdf

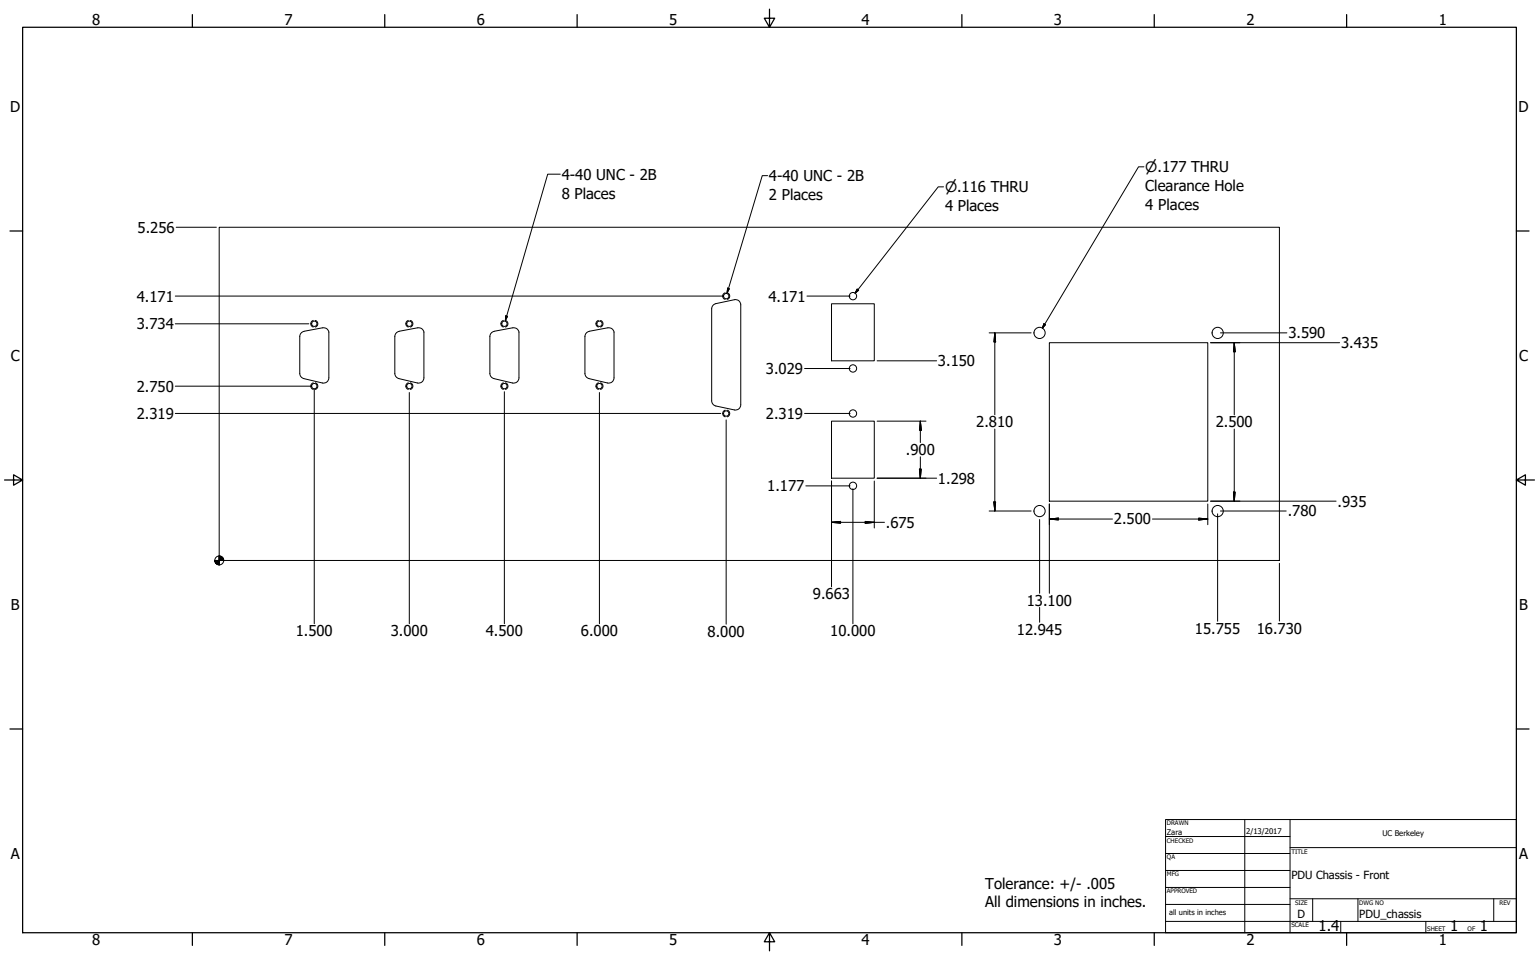
[picture p80: page 1]
SHEET 1 OF 1; DRAWN; CHECKED; MFG; APPROVED; Zara; DWG NO PDU_chassis; TITLE; SIZE D; SCALE; UC Berkeley; REV; 4-40 UNC - 2B 8 Places; 4-40 UNC - 2B 2 Places; P.177 THRU; Clearance Hole 4 Places; P.116 THRU; 4 Places

PDU Chassis - Front

Tolerance: +/- .005
All dimensions in inches.

all units in inches
