david-deboer/hera-cad/Node/PDU/quote_drawings_022317/PDU_chassis_back.pdf

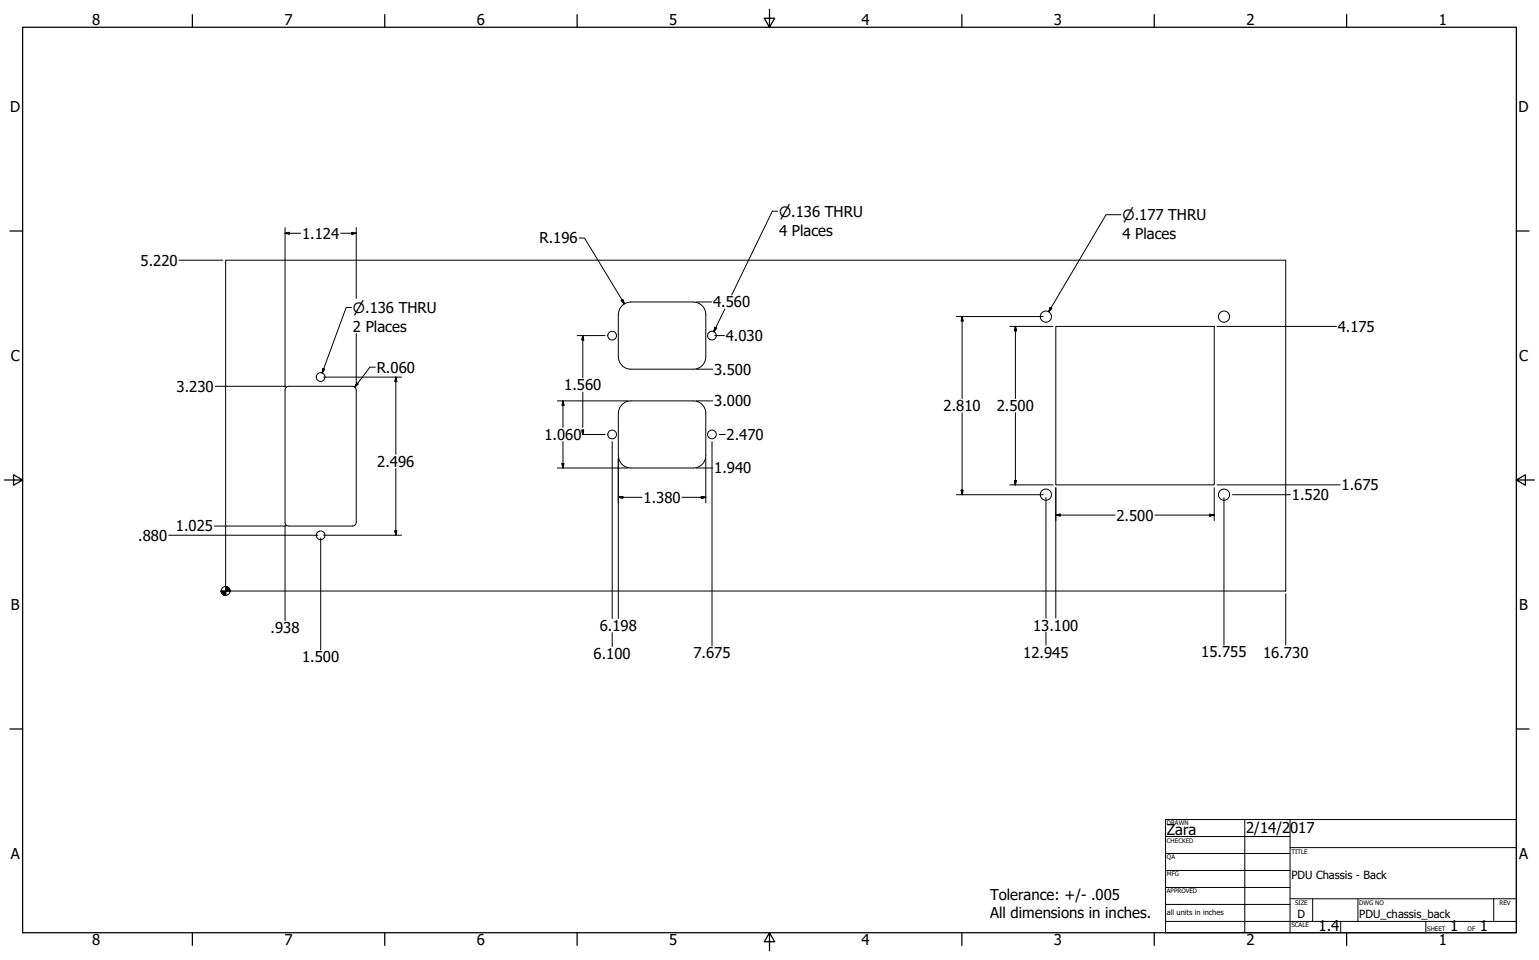
[picture p81: page 1]
SHEET 1 OF 1; DRAWN; CHECKED; MFG; APPROVED; Zara; DWG NO PDU_chassis_back; TITLE; SIZE D; SCALE; REV; P.136 THRU; 2 Places; 4 Places; P.177 THRU

PDU Chassis - Back

Tolerance: +/- .005
All dimensions in inches.

all units in inches
