david-deboer/hera-cad/Node/PDU/quote_drawings_022317/PDU_chassis_bottom.pdf

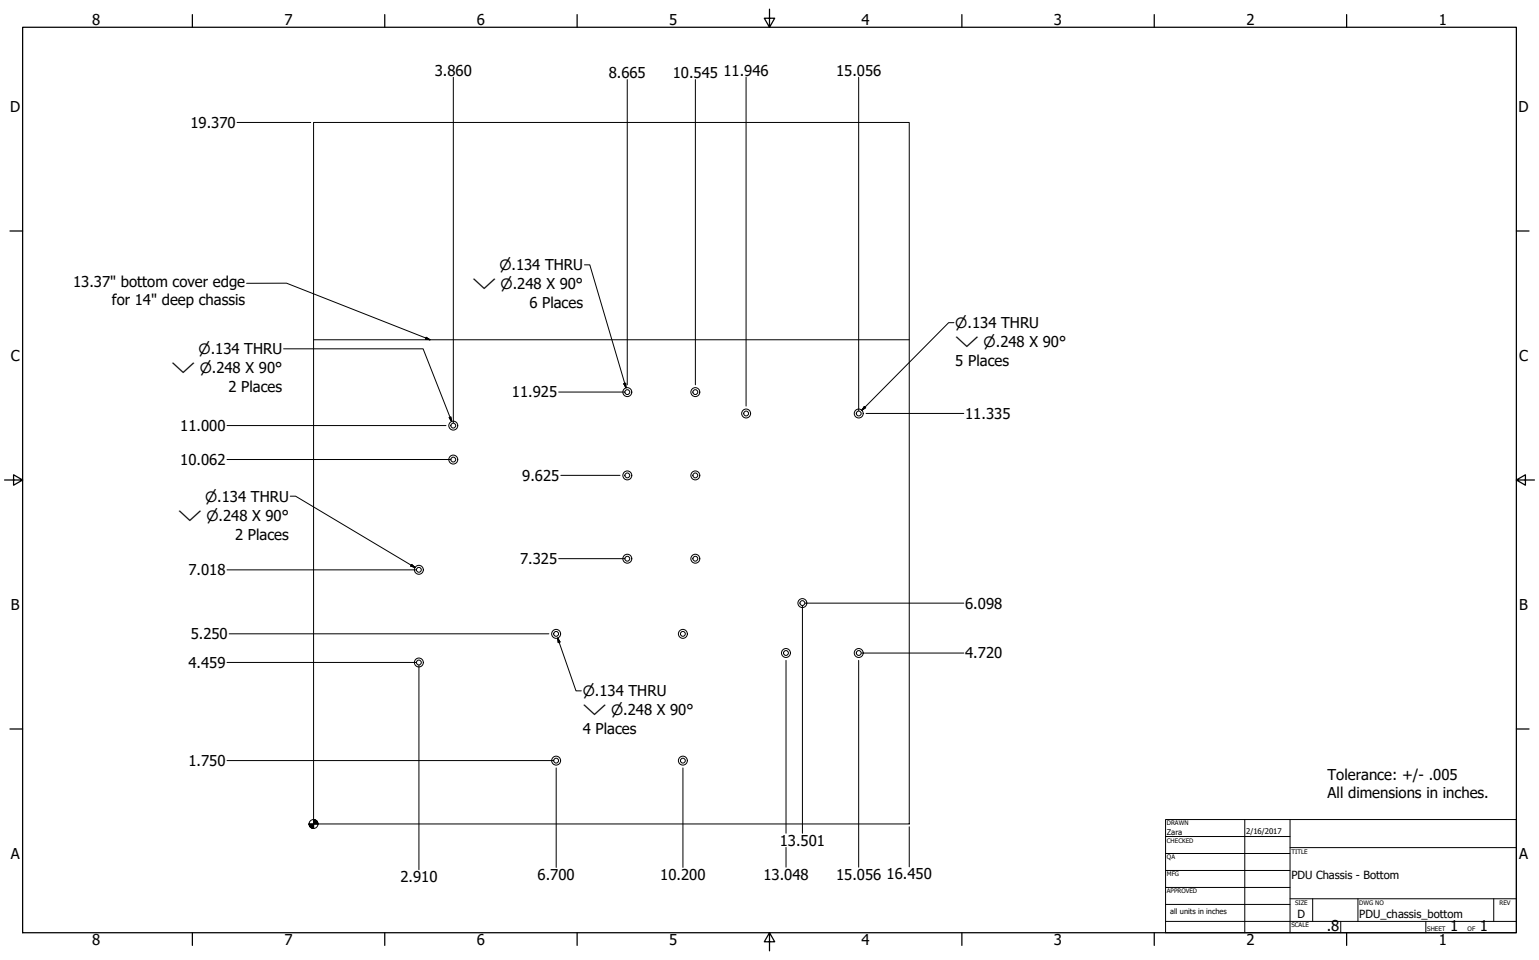
[picture p82: page 1]
SHEET 1 OF 1; DRAWN; CHECKED; MFG; APPROVED; Zara; DWG NO PDU_chassis_bottom; TITLE; SIZE D; SCALE; REV; P.134 THRU Y P.248 X 90°; 5 Places; 6 Places; 4 Places; 2 Places

13.37" bottom cover edge
for 14" deep chassis

Tolerance: +/- .005
All dimensions in inches.

PDU Chassis - Bottom

all units in inches
