david-deboer/hera-cad/Node/PDU/quote_drawings_022317/PDU_chassis_dsubs.pdf

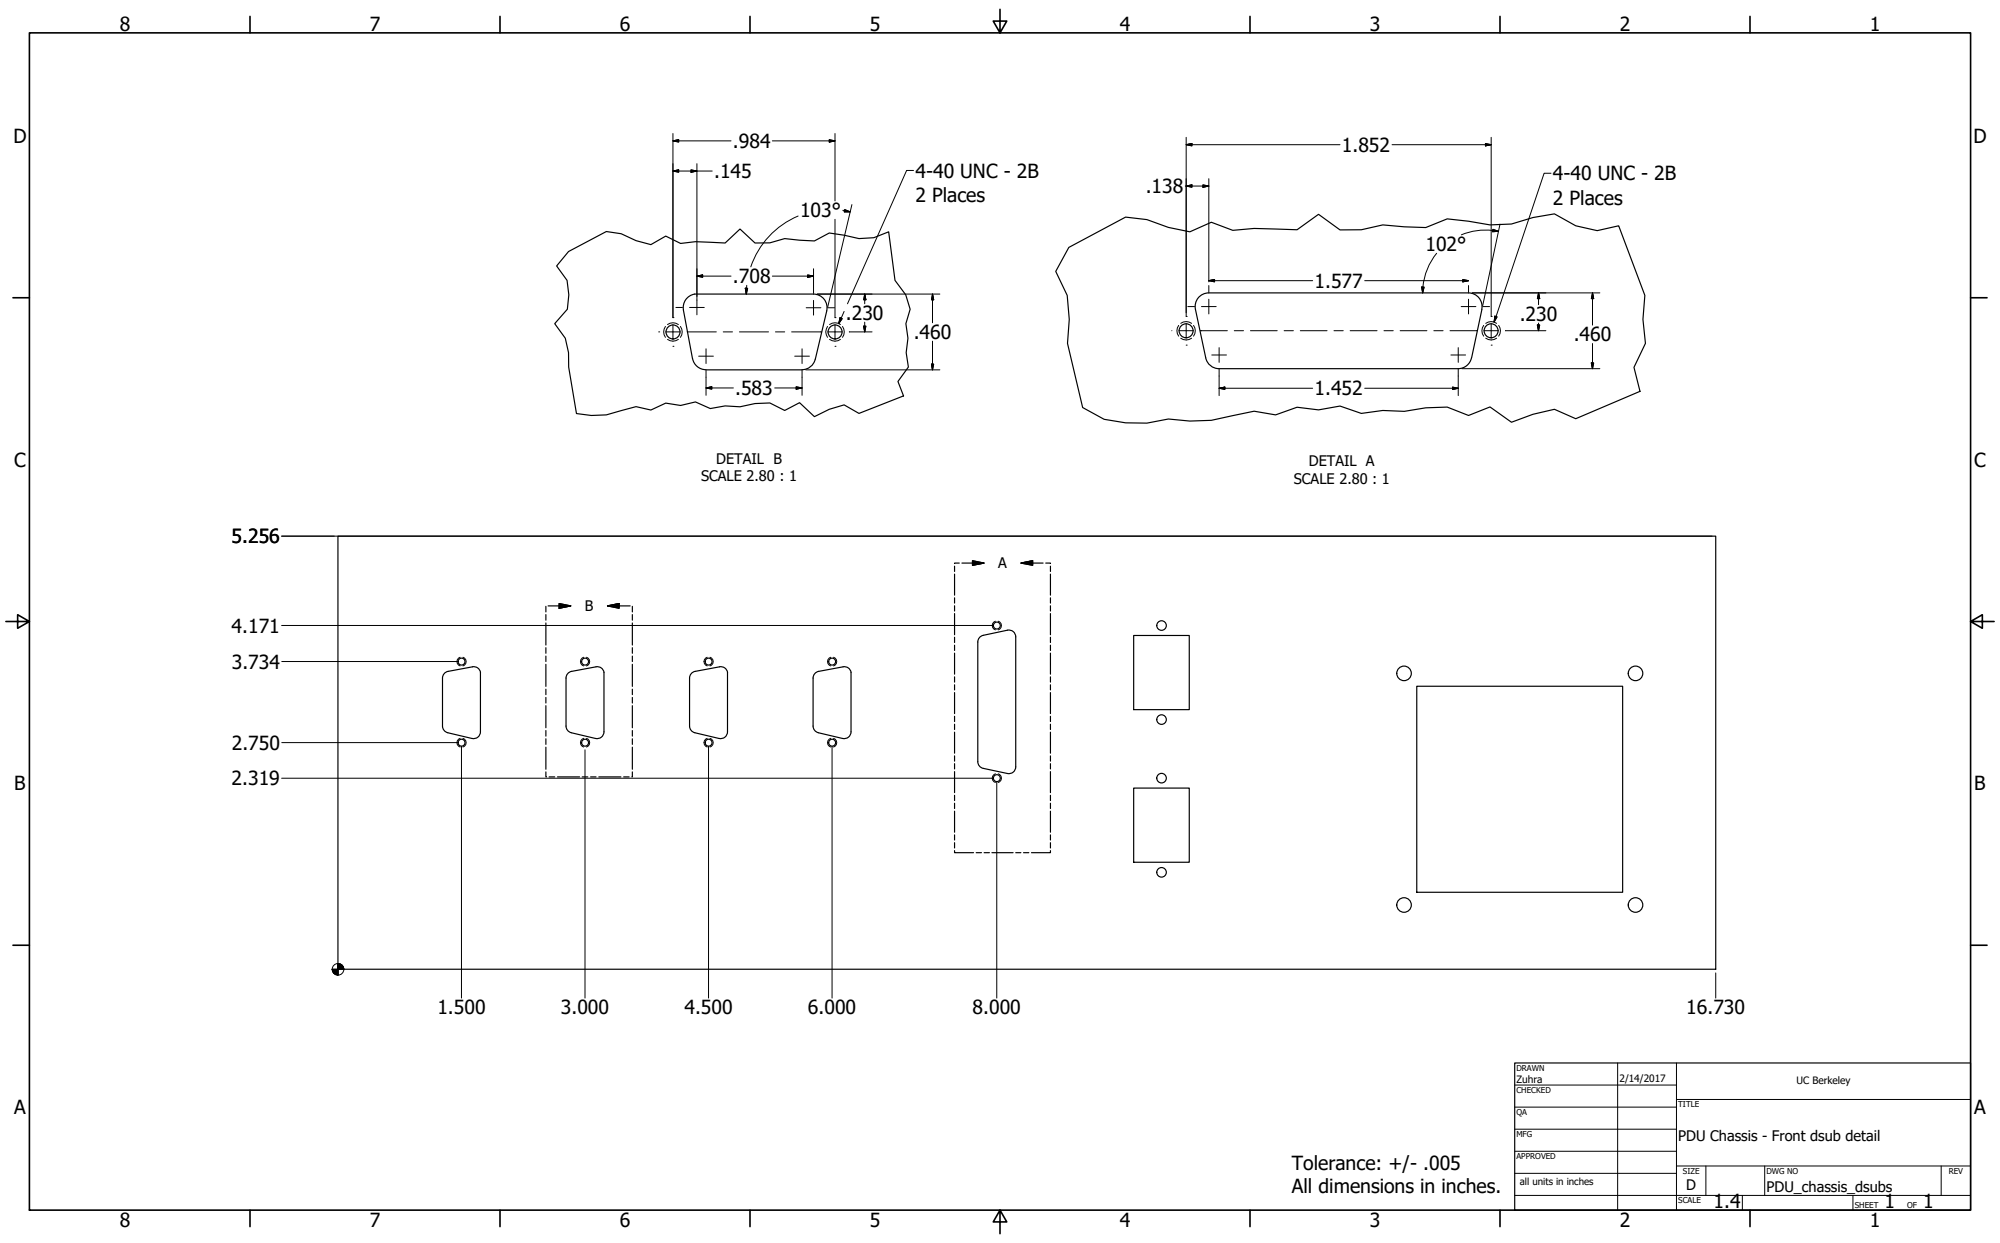
[picture p83: page 1]
DETAIL A SCALE 2.80 : 1; DETAIL B SCALE 2.80 : 1; SHEET 1 OF 1; DRAWN; CHECKED; MFG; APPROVED; Zuhra; DWG NO PDU_chassis_dsubs; TITLE; SIZE D; SCALE; UC Berkeley; REV; 4-40 UNC - 2B 2 Places

PDU Chassis - Front dsub detail

Tolerance: +/- .005
All dimensions in inches.

all units in inches
