david-deboer/hera-cad/PDFs/Element/Support/SupportManufacturingDpk.pdf

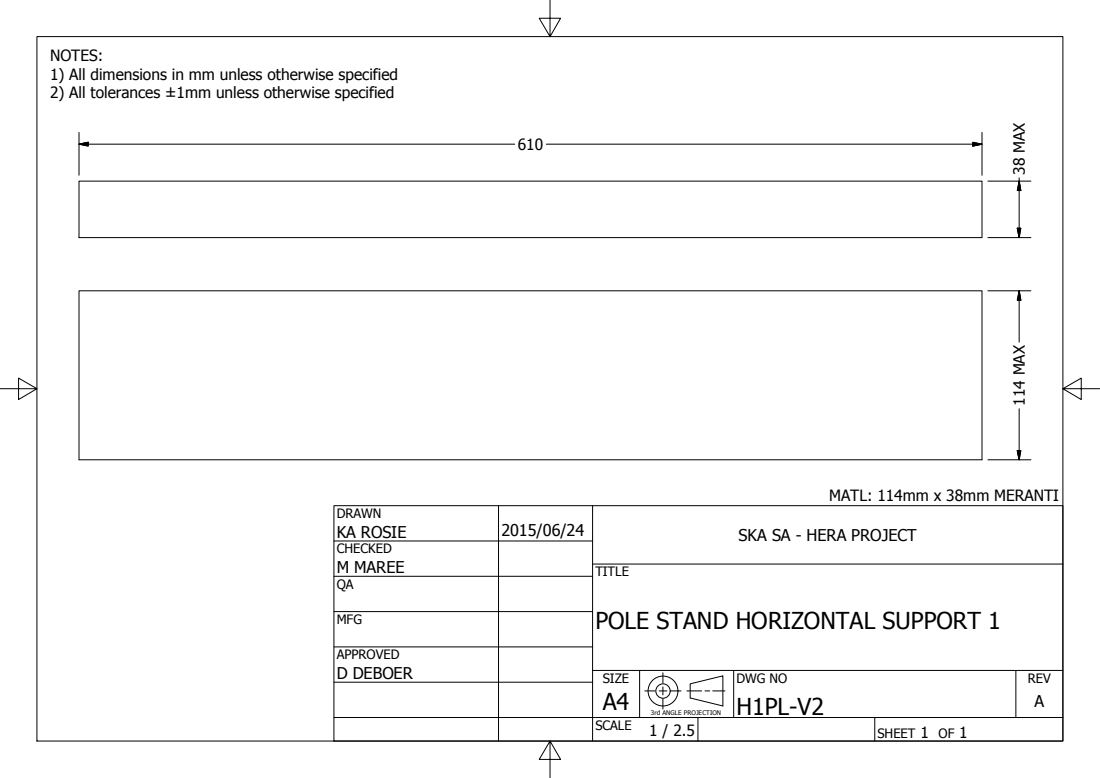
[picture p84: page 1]
SHEET 1 OF 1; DRAWN; CHECKED; MFG; APPROVED D DEBOER; KA ROSIE; M MAREE; DWG NO H1PL-V2; TITLE; SIZE A4; SCALE; REV A; 3rd ANGLE PROJECTION; MATL: 114mm x 38mm MERANTI

NOTES:
1) All dimensions in mm unless otherwise specified
2) All tolerances ±1mm unless otherwise specified

SKA SA - HERA PROJECT

POLE STAND HORIZONTAL SUPPORT 1

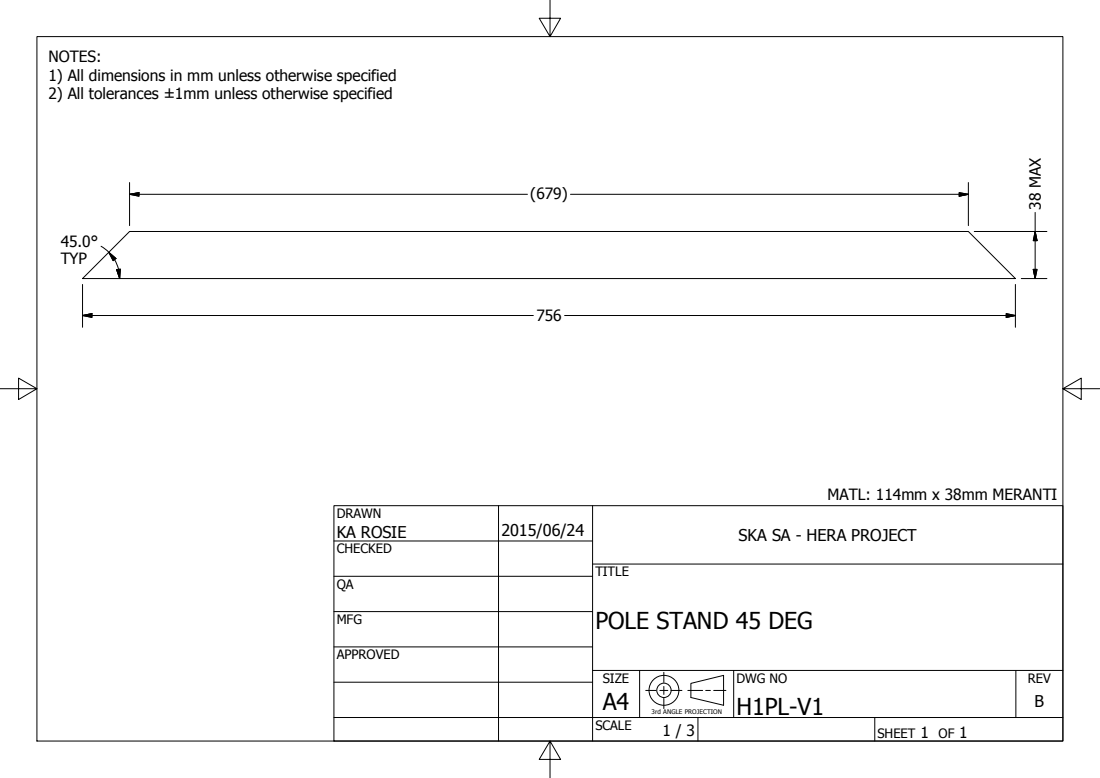
[picture p85: page 2]
DRAWN; CHECKED; MFG; APPROVED; KA ROSIE; DWG NO H1PL-V1; TITLE; SIZE A4; REV B; 45.0° TYP; MATL: 114mm x 38mm MERANTI

1) All dimensions in mm unless otherwise specified
2) All tolerances ±1mm unless otherwise specified

SKA SA - HERA PROJECT

POLE STAND 45 DEG

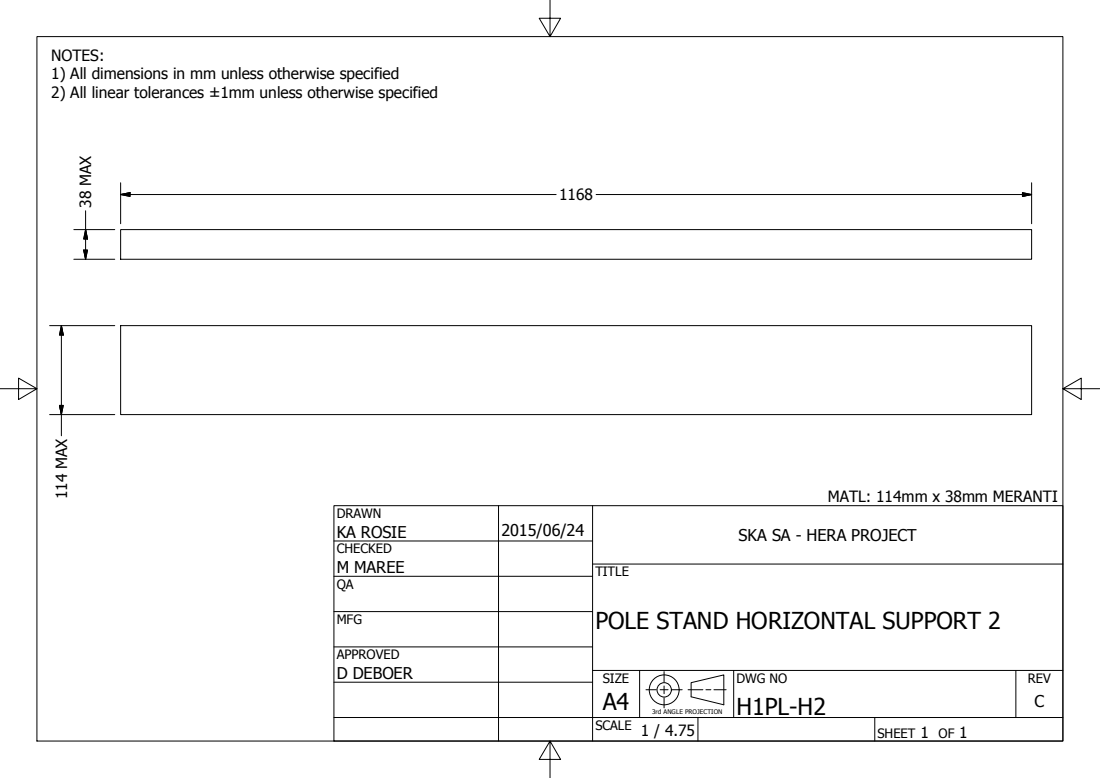
[picture p86: page 3]
DRAWN; CHECKED; MFG; APPROVED D DEBOER; KA ROSIE; M MAREE; DWG NO H1PL-H2; TITLE; SIZE A4; REV C; MATL: 114mm x 38mm MERANTI

1) All dimensions in mm unless otherwise specified
2) All linear tolerances ±1mm unless otherwise specified

SKA SA - HERA PROJECT

POLE STAND HORIZONTAL SUPPORT 2

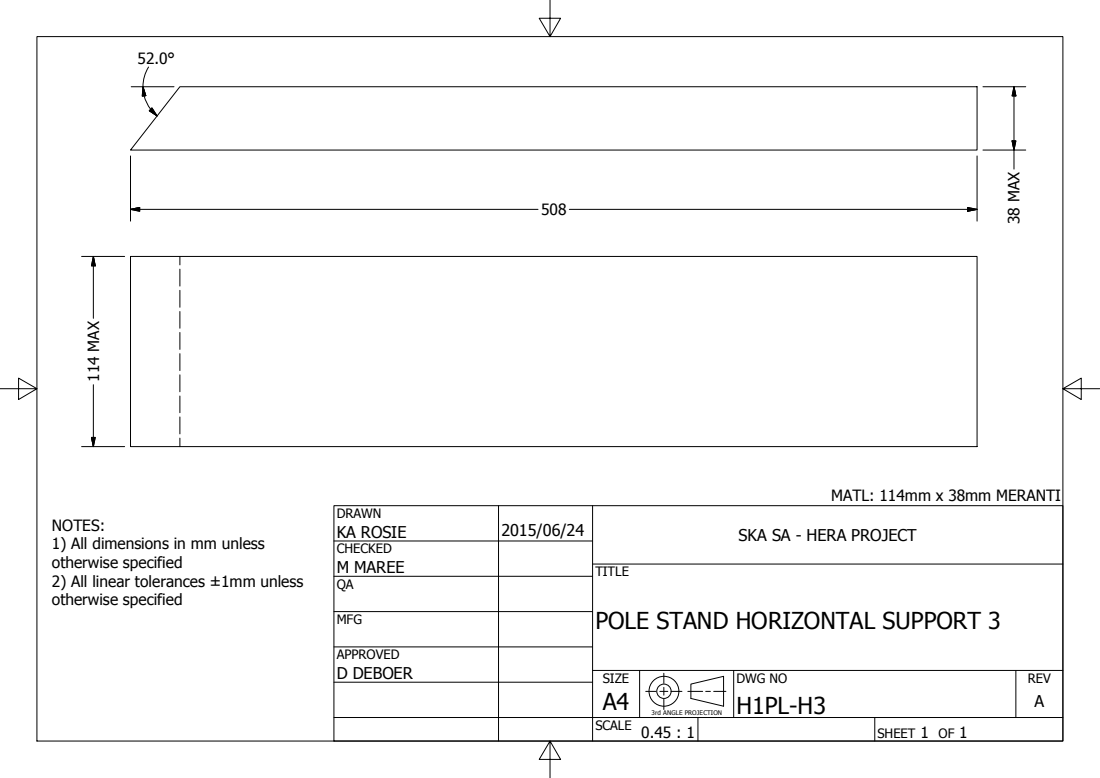
[picture p87: page 4]
DRAWN; CHECKED; MFG; APPROVED D DEBOER; KA ROSIE; M MAREE; DWG NO H1PL-H3; TITLE; SIZE A4; REV A; MATL: 114mm x 38mm MERANTI

NOTES:
1) All dimensions in mm unless
otherwise specified
2) All linear tolerances ±1mm unless

SKA SA - HERA PROJECT

POLE STAND HORIZONTAL SUPPORT 3

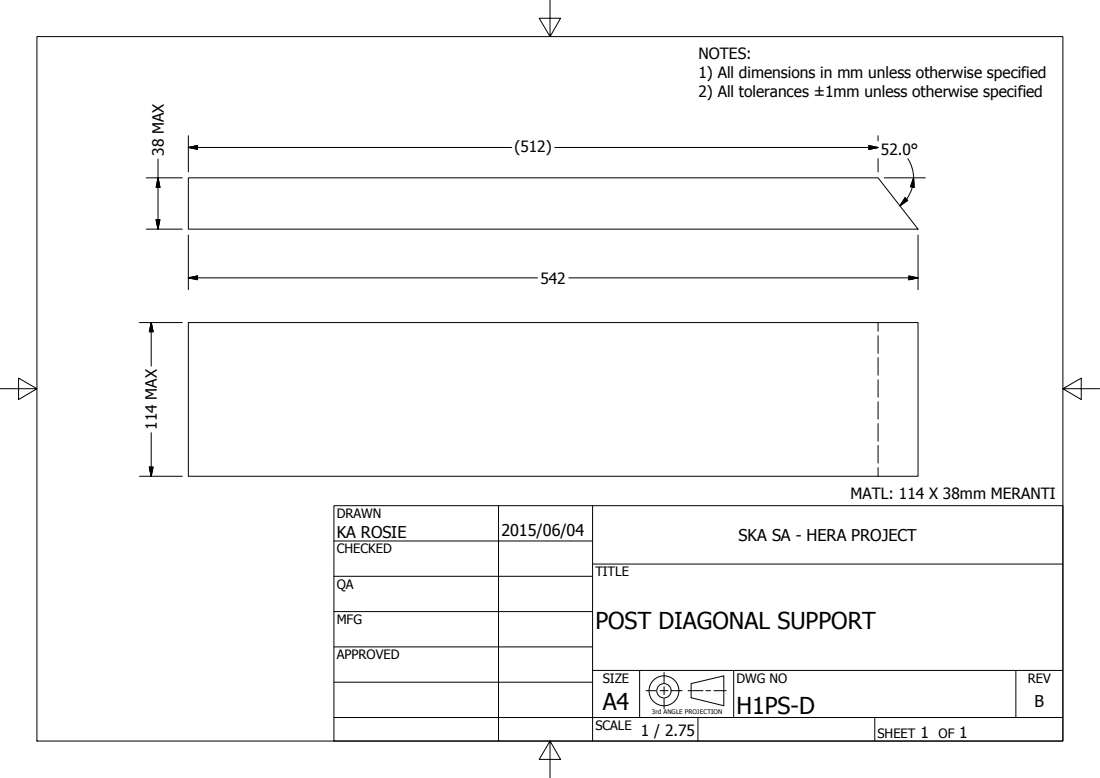
[picture p88: page 5]
DRAWN; CHECKED; MFG; APPROVED; KA ROSIE; DWG NO H1PS-D; TITLE; SIZE A4; REV B; MATL: 114 X 38mm MERANTI

1) All dimensions in mm unless otherwise specified
2) All tolerances ±1mm unless otherwise specified

SKA SA - HERA PROJECT

POST DIAGONAL SUPPORT

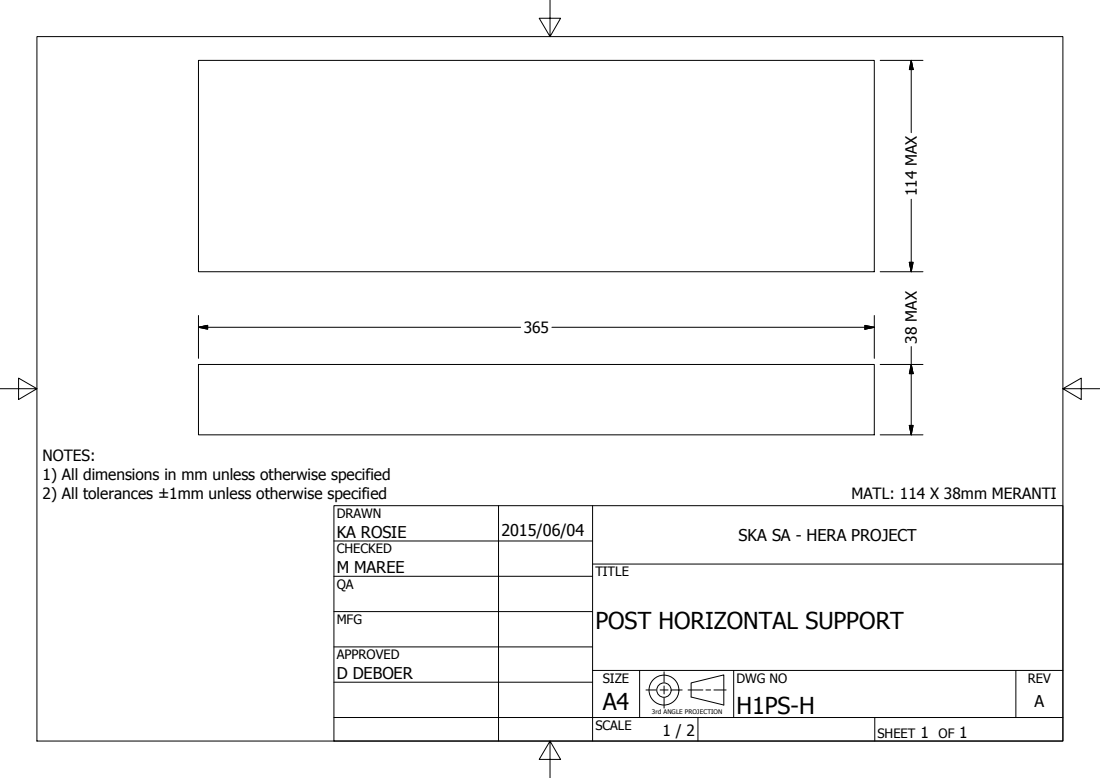
[picture p89: page 6]
DRAWN; CHECKED; MFG; APPROVED D DEBOER; KA ROSIE; M MAREE; DWG NO H1PS-H; TITLE; SIZE A4; REV A; MATL: 114 X 38mm MERANTI

NOTES:
1) All dimensions in mm unless otherwise specified
2) All tolerances ±1mm unless otherwise specified

SKA SA - HERA PROJECT

POST HORIZONTAL SUPPORT

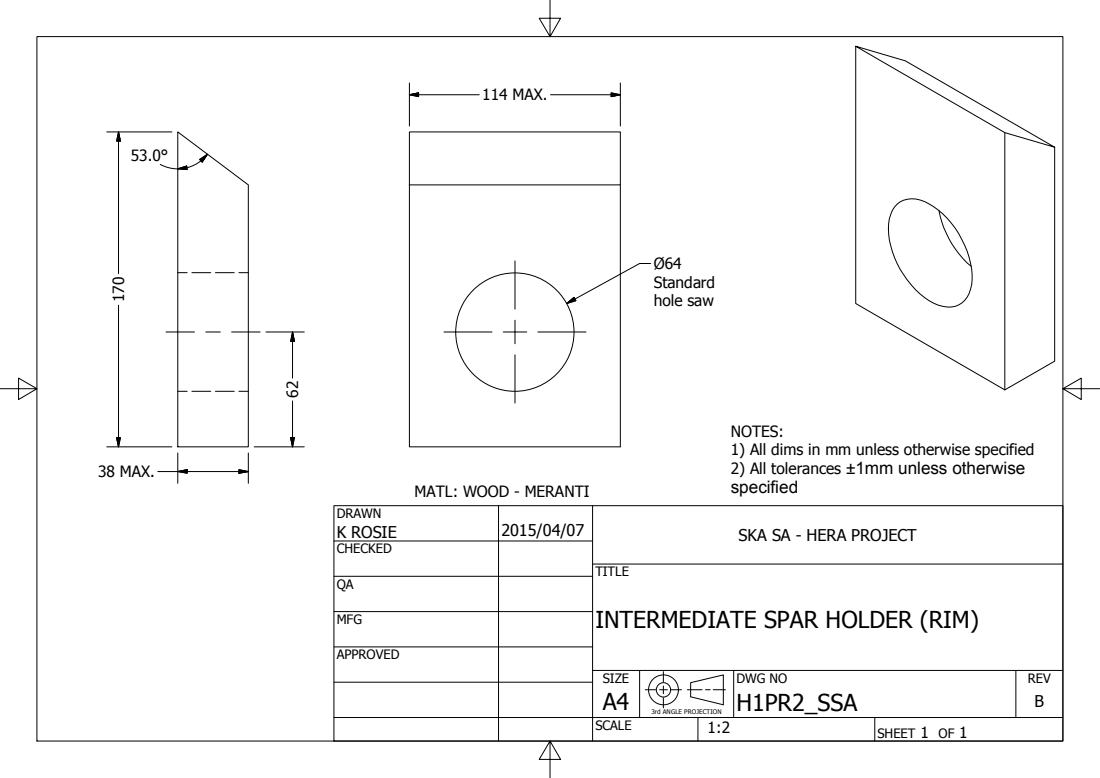
[picture p90: page 7]
DRAWN; CHECKED; MFG; APPROVED; K ROSIE; DWG NO H1PR2_SSA; SIZE A4; REV B; 114 MAX.; 38 MAX.; Ø64 Standard hole saw

NOTES:
1) All dims in mm unless otherwise specified
2) All tolerances ±1mm unless otherwise
specified

MATL: WOOD - MERANTI

SKA SA - HERA PROJECT

TITLE
INTERMEDIATE SPAR HOLDER (RIM)
