david-deboer/hera-cad/PDFs/Element/Surface/H1RC-C_a_crossSparSubAssembly.pdf

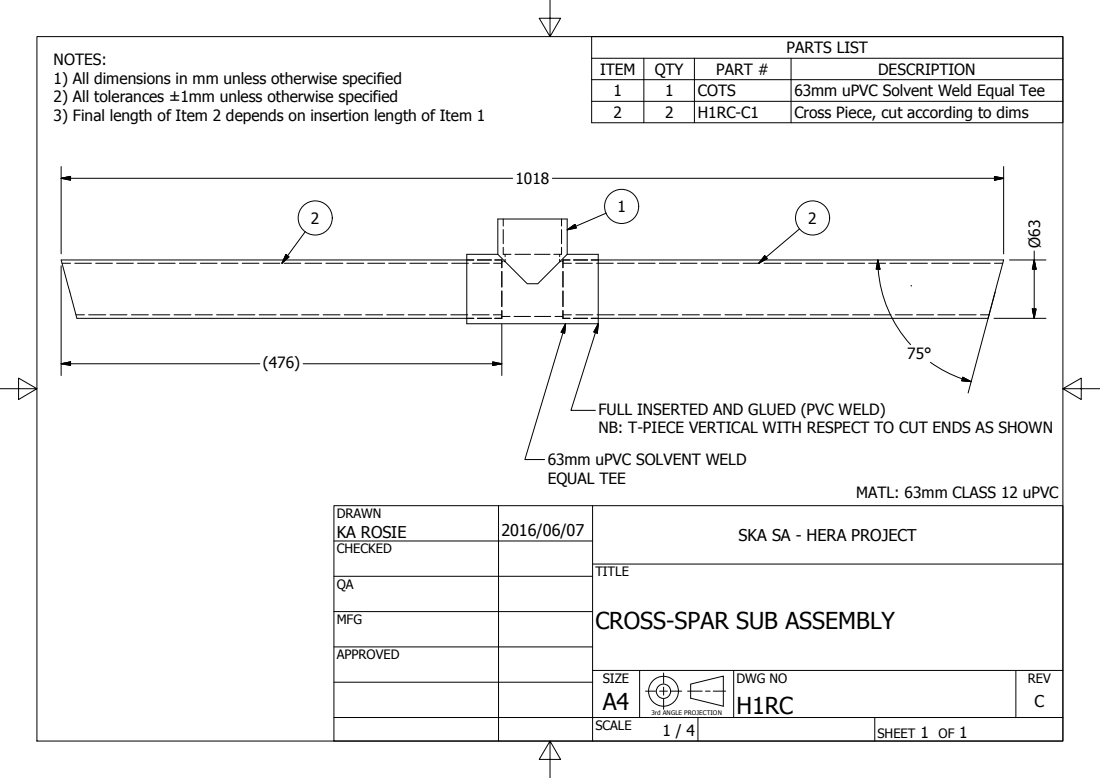
[picture p91: page 1]
PARTS LIST; ITEM; QTY; PART #; DESCRIPTION; COTS; 63mm uPVC Solvent Weld Equal Tee; Cross Piece, cut according to dims; SHEET 1 OF 1; DRAWN; CHECKED; MFG; APPROVED; KA ROSIE; DWG NO H1RC; TITLE; SIZE A4; SCALE; REV C; 3rd ANGLE PROJECTION

NOTES:
1) All dimensions in mm unless otherwise specified
2) All tolerances ±1mm unless otherwise specified
3) Final length of Item 2 depends on insertion length of Item 1

FULL INSERTED AND GLUED (PVC WELD)
NB: T-PIECE VERTICAL WITH RESPECT TO CUT ENDS AS SHOWN

63mm uPVC SOLVENT WELD
EQUAL TEE

MATL: 63mm CLASS 12 uPVC

SKA SA - HERA PROJECT

CROSS-SPAR SUB ASSEMBLY
