david-deboer/hera-cad/PDFs/Element/Feed/H2BM-B_a_bpMechSupAssembly.pdf

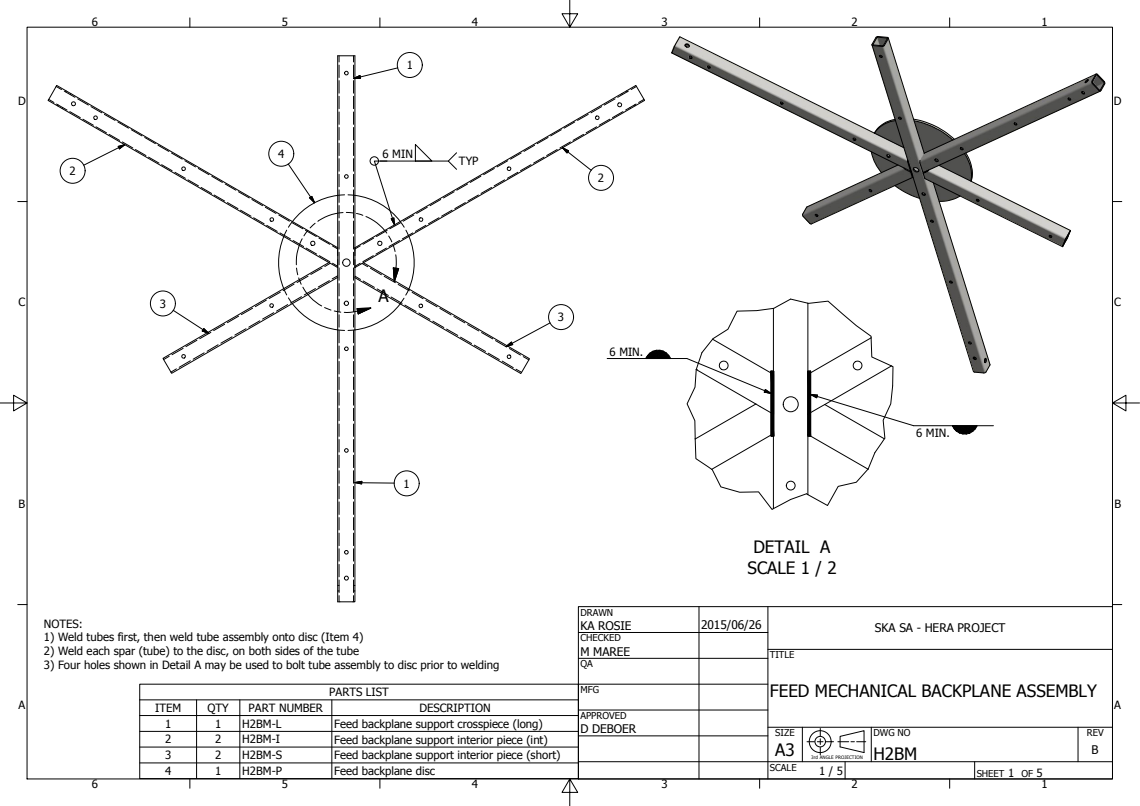
[picture p92: page 1]
DETAIL A SCALE 1 / 2; PARTS LIST; ITEM; QTY; PART NUMBER; DESCRIPTION; Feed backplane support crosspiece (long); Feed backplane support interior piece (int); Feed backplane support interior piece (short); Feed backplane disc; SHEET 1 OF 5; DRAWN; CHECKED; MFG; APPROVED D DEBOER; KA ROSIE; M MAREE; DWG NO H2BM; TITLE; SIZE A3; SCALE; REV B; 3rd ANGLE PROJECTION; 6 MIN.; 6 MIN; TYP

NOTES:
1) Weld tubes first, then weld tube assembly onto disc (Item 4)
2) Weld each spar (tube) to the disc, on both sides of the tube
3) Four holes shown in Detail A may be used to bolt tube assembly to disc prior to welding

SKA SA - HERA PROJECT

FEED MECHANICAL BACKPLANE ASSEMBLY

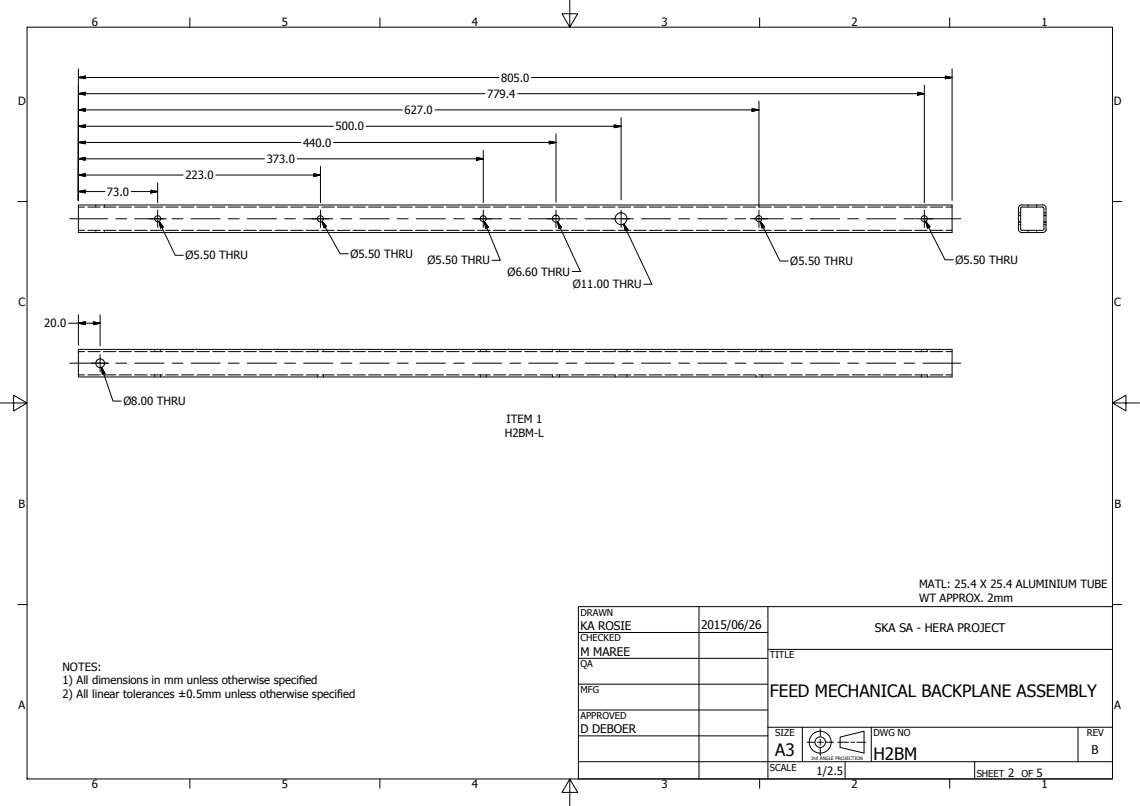
[picture p93: page 2]
DRAWN; CHECKED; MFG; APPROVED D DEBOER; KA ROSIE; M MAREE; DWG NO; TITLE; SIZE; REV; Ø5.50 THRU; Ø6.60 THRU; Ø11.00 THRU; Ø8.00 THRU; ITEM 1 H2BM-L

MATL: 25.4 X 25.4 ALUMINIUM TUBE
WT APPROX. 2mm

SKA SA - HERA PROJECT

NOTES:
1) All dimensions in mm unless otherwise specified
2) All linear tolerances ±0.5mm unless otherwise specified

FEED MECHANICAL BACKPLANE ASSEMBLY

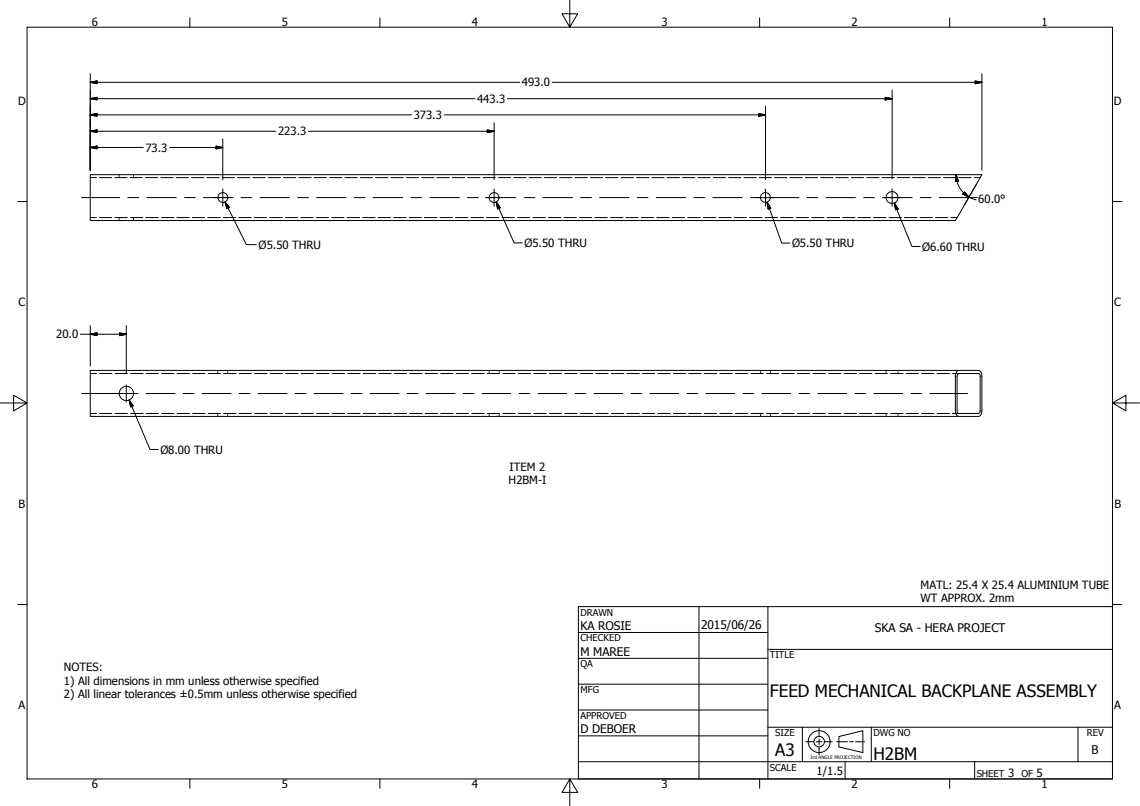
[picture p94: page 3]
DRAWN; CHECKED; MFG; APPROVED D DEBOER; KA ROSIE; M MAREE; DWG NO; TITLE; SIZE; REV; Ø5.50 THRU; Ø6.60 THRU; Ø8.00 THRU; ITEM 2 H2BM-I

MATL: 25.4 X 25.4 ALUMINIUM TUBE
WT APPROX. 2mm

SKA SA - HERA PROJECT

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

FEED MECHANICAL BACKPLANE ASSEMBLY

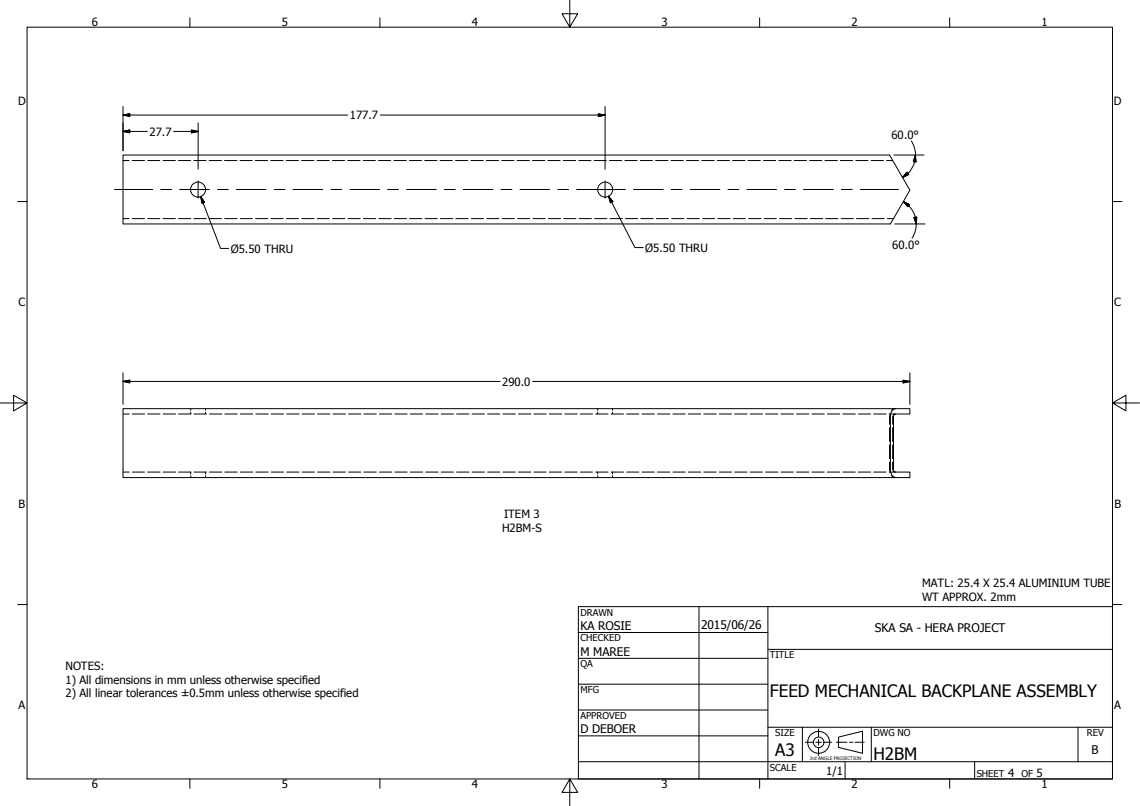
[picture p95: page 4]
DRAWN; CHECKED; MFG; APPROVED D DEBOER; KA ROSIE; M MAREE; DWG NO; TITLE; SIZE; REV; Ø5.50 THRU; ITEM 3 H2BM-S

MATL: 25.4 X 25.4 ALUMINIUM TUBE
WT APPROX. 2mm

SKA SA - HERA PROJECT

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

FEED MECHANICAL BACKPLANE ASSEMBLY

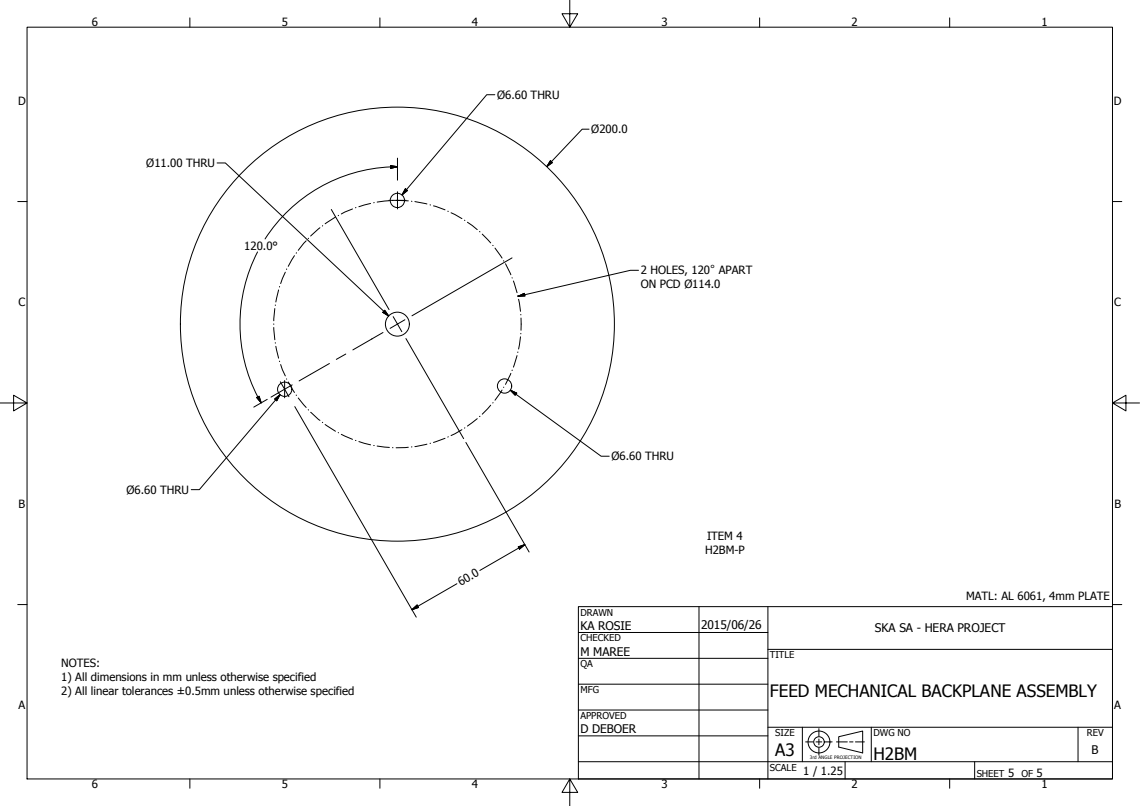
[picture p96: page 5]
DRAWN; CHECKED; MFG; APPROVED D DEBOER; KA ROSIE; M MAREE; DWG NO; TITLE; SIZE; REV; 2 HOLES, 120° APART ON PCD Ø114.0; Ø6.60 THRU; Ø11.00 THRU; ITEM 4 H2BM-P

MATL: AL 6061, 4mm PLATE

SKA SA - HERA PROJECT

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

FEED MECHANICAL BACKPLANE ASSEMBLY
