david-deboer/hera-cad/Node/Concept-ICTS/ICTS-20170411/ssl-version/panel_waveguide_assembly.pdf

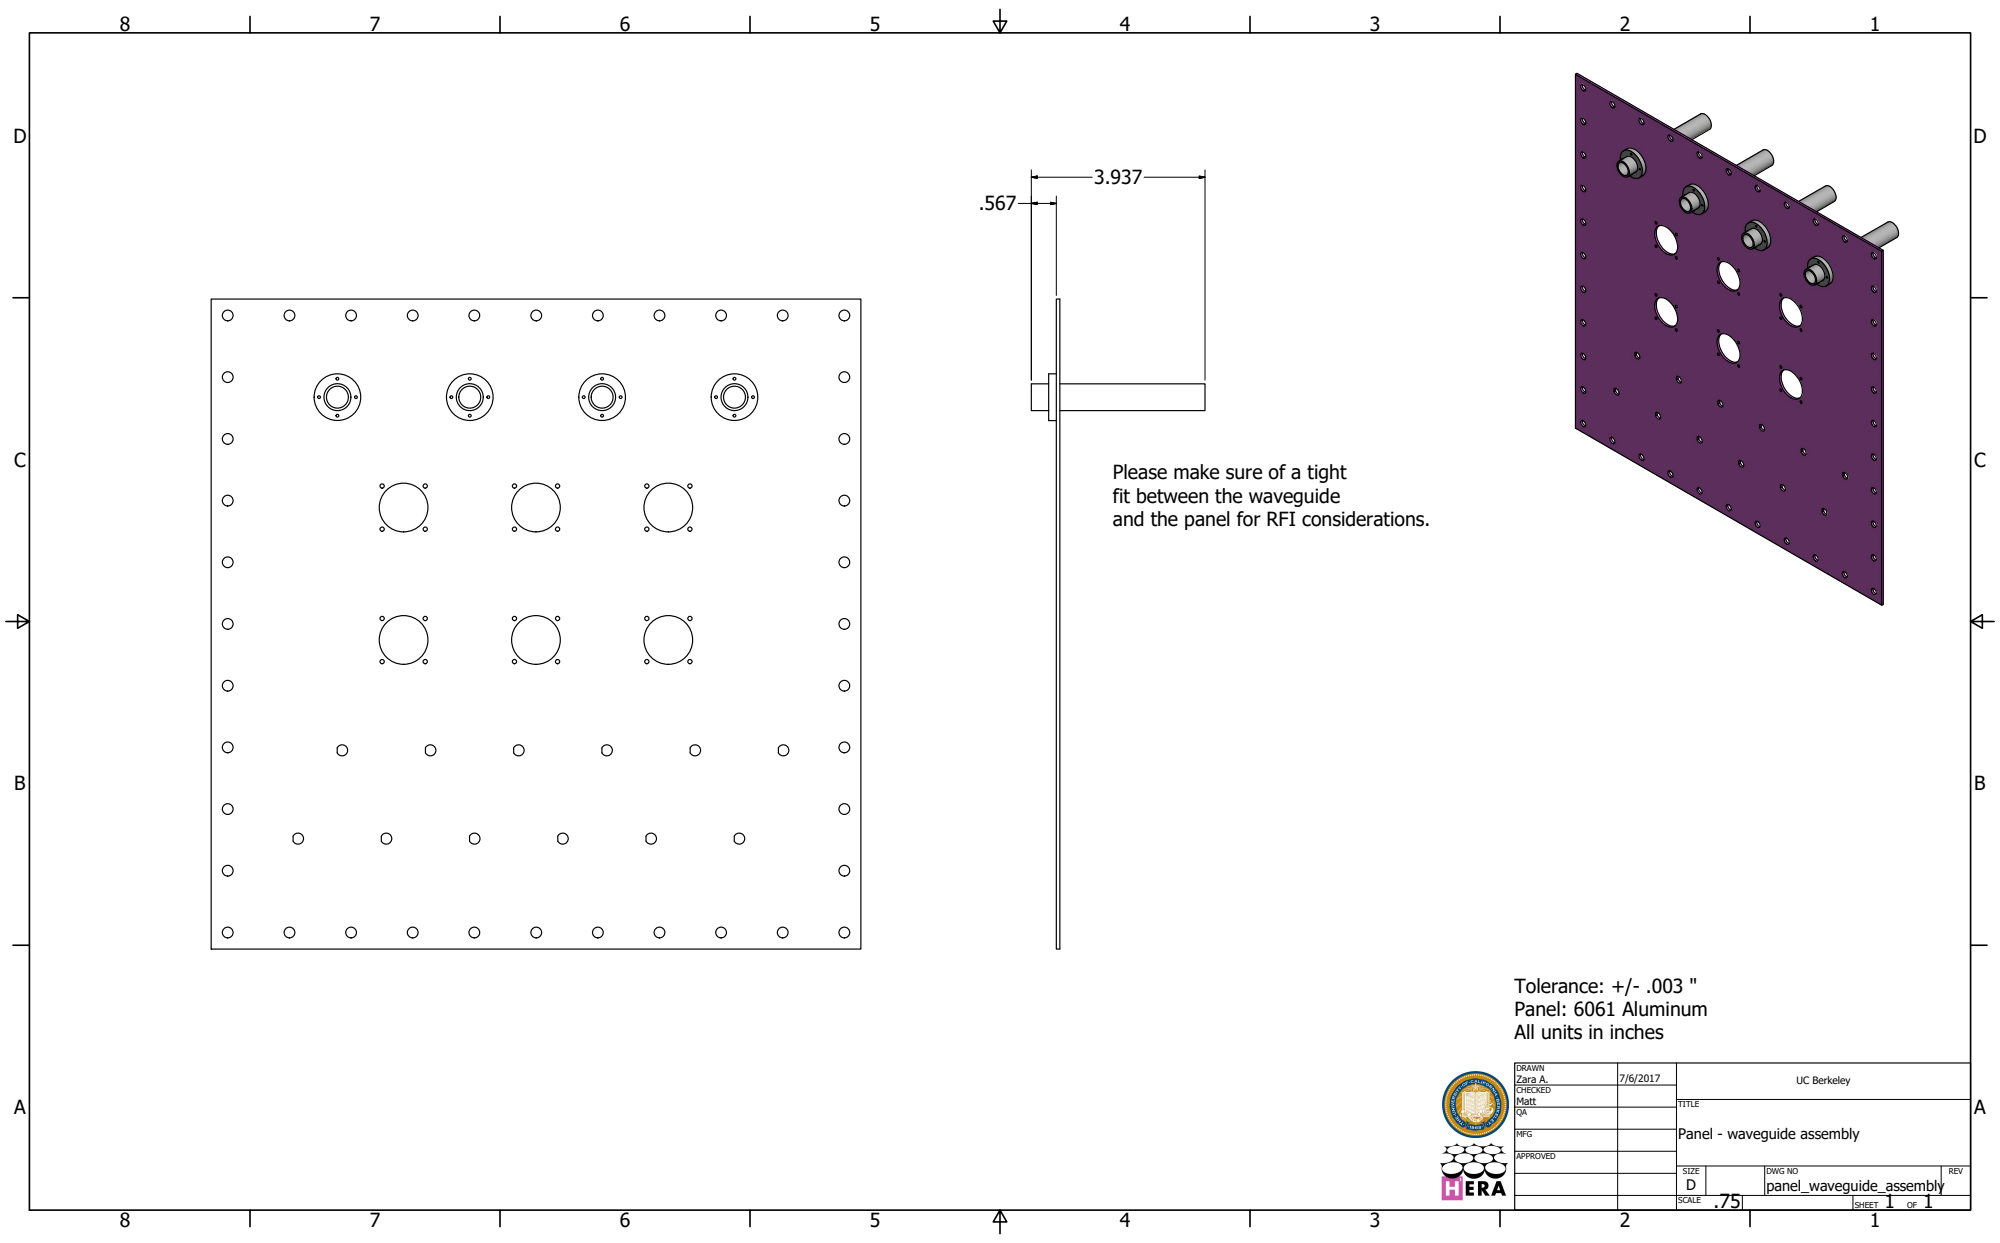
[picture p97: page 1]
SHEET 1 OF 1; DRAWN; CHECKED; MFG; APPROVED; Zara A.; Matt; DWG NO panel_waveguide_assembly; SIZE D; SCALE; UC Berkeley; REV

Please make sure of a tight
fit between the waveguide
and the panel for RFI considerations.

Tolerance: +/- .003 "
Panel: 6061 Aluminum
All units in inches

TITLE
Panel - waveguide assembly
