david-deboer/hera-cad/Node/Concept-ICTS/ICTS-20170411/ssl-version/waveguide.pdf

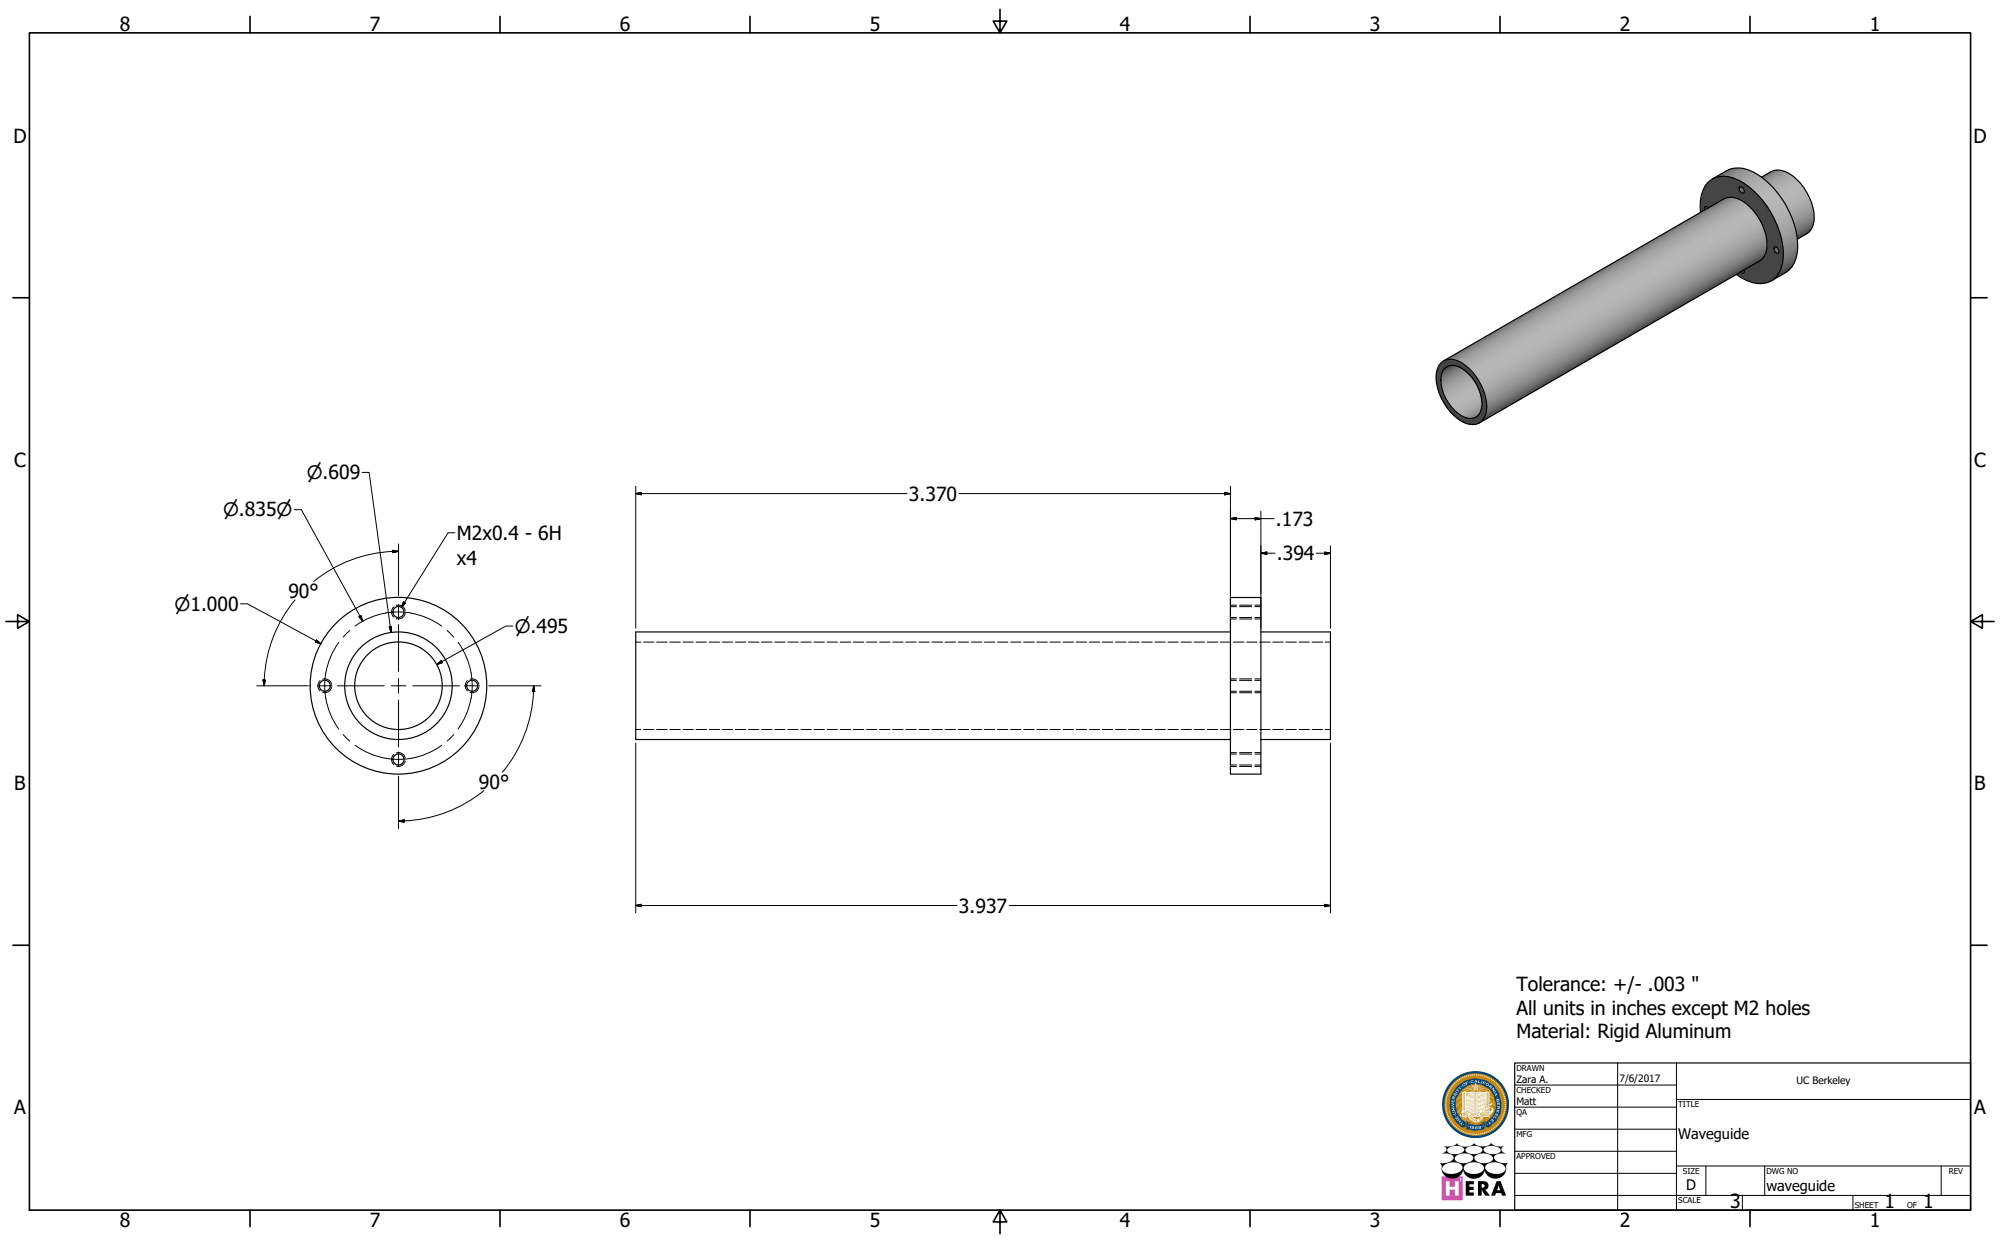
[picture p98: page 1]
SHEET 1 OF 1; DRAWN; CHECKED; MFG; APPROVED; Zara A.; Matt; DWG NO waveguide; TITLE; Waveguide; SIZE D; SCALE; UC Berkeley; REV

Tolerance: +/- .003 "
All units in inches except M2 holes
Material: Rigid Aluminum
