david-deboer/hera-cad/Node/SNAP_V2/Workspaces/Workspace/drawings/quote_step_031617/mounting rail 7.0 x.250 x .250.pdf

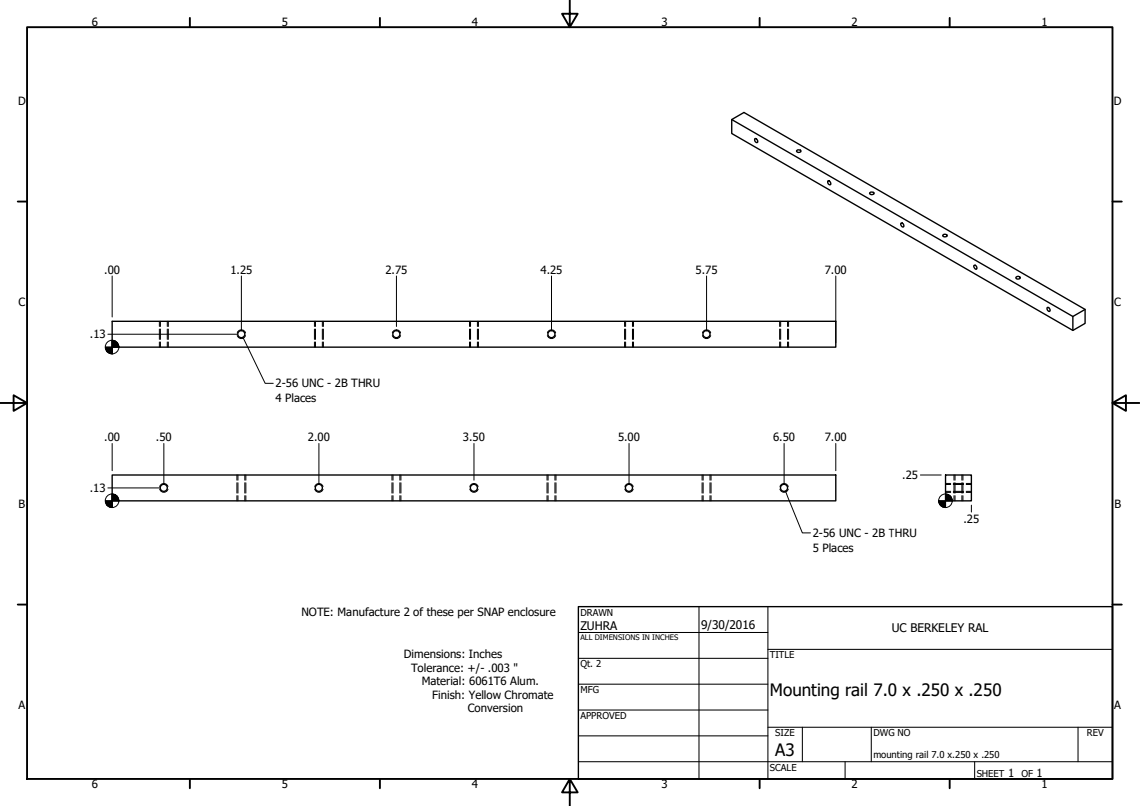
[picture p99: page 1]
SHEET 1 OF 1; DRAWN; MFG; APPROVED; ZUHRA; DWG NO; mounting rail 7.0 x.250 x .250; TITLE; Mounting rail 7.0 x .250 x .250; SIZE A3; SCALE; REV; Conversion; 2-56 UNC - 2B 6HRU; 5 Places; 2-56 UNC - 2B THRU 4 Places

NOTE: Manufacture 2 of these per SNAP enclosure

UC BERKELEY RAL

ALL DIMENSIONS IN INCHES

Dimensions: Inches
Tolerance: +/- .003 "
Material: 6061T6 Alum.
Finish: Yellow Chromate
