david-deboer/hera-cad/Node/SNAP_V2/Workspaces/Workspace/drawings/quote_step_031617/mounting rail 9.0 x.250 x.500-A-sfpcutouts.pdf

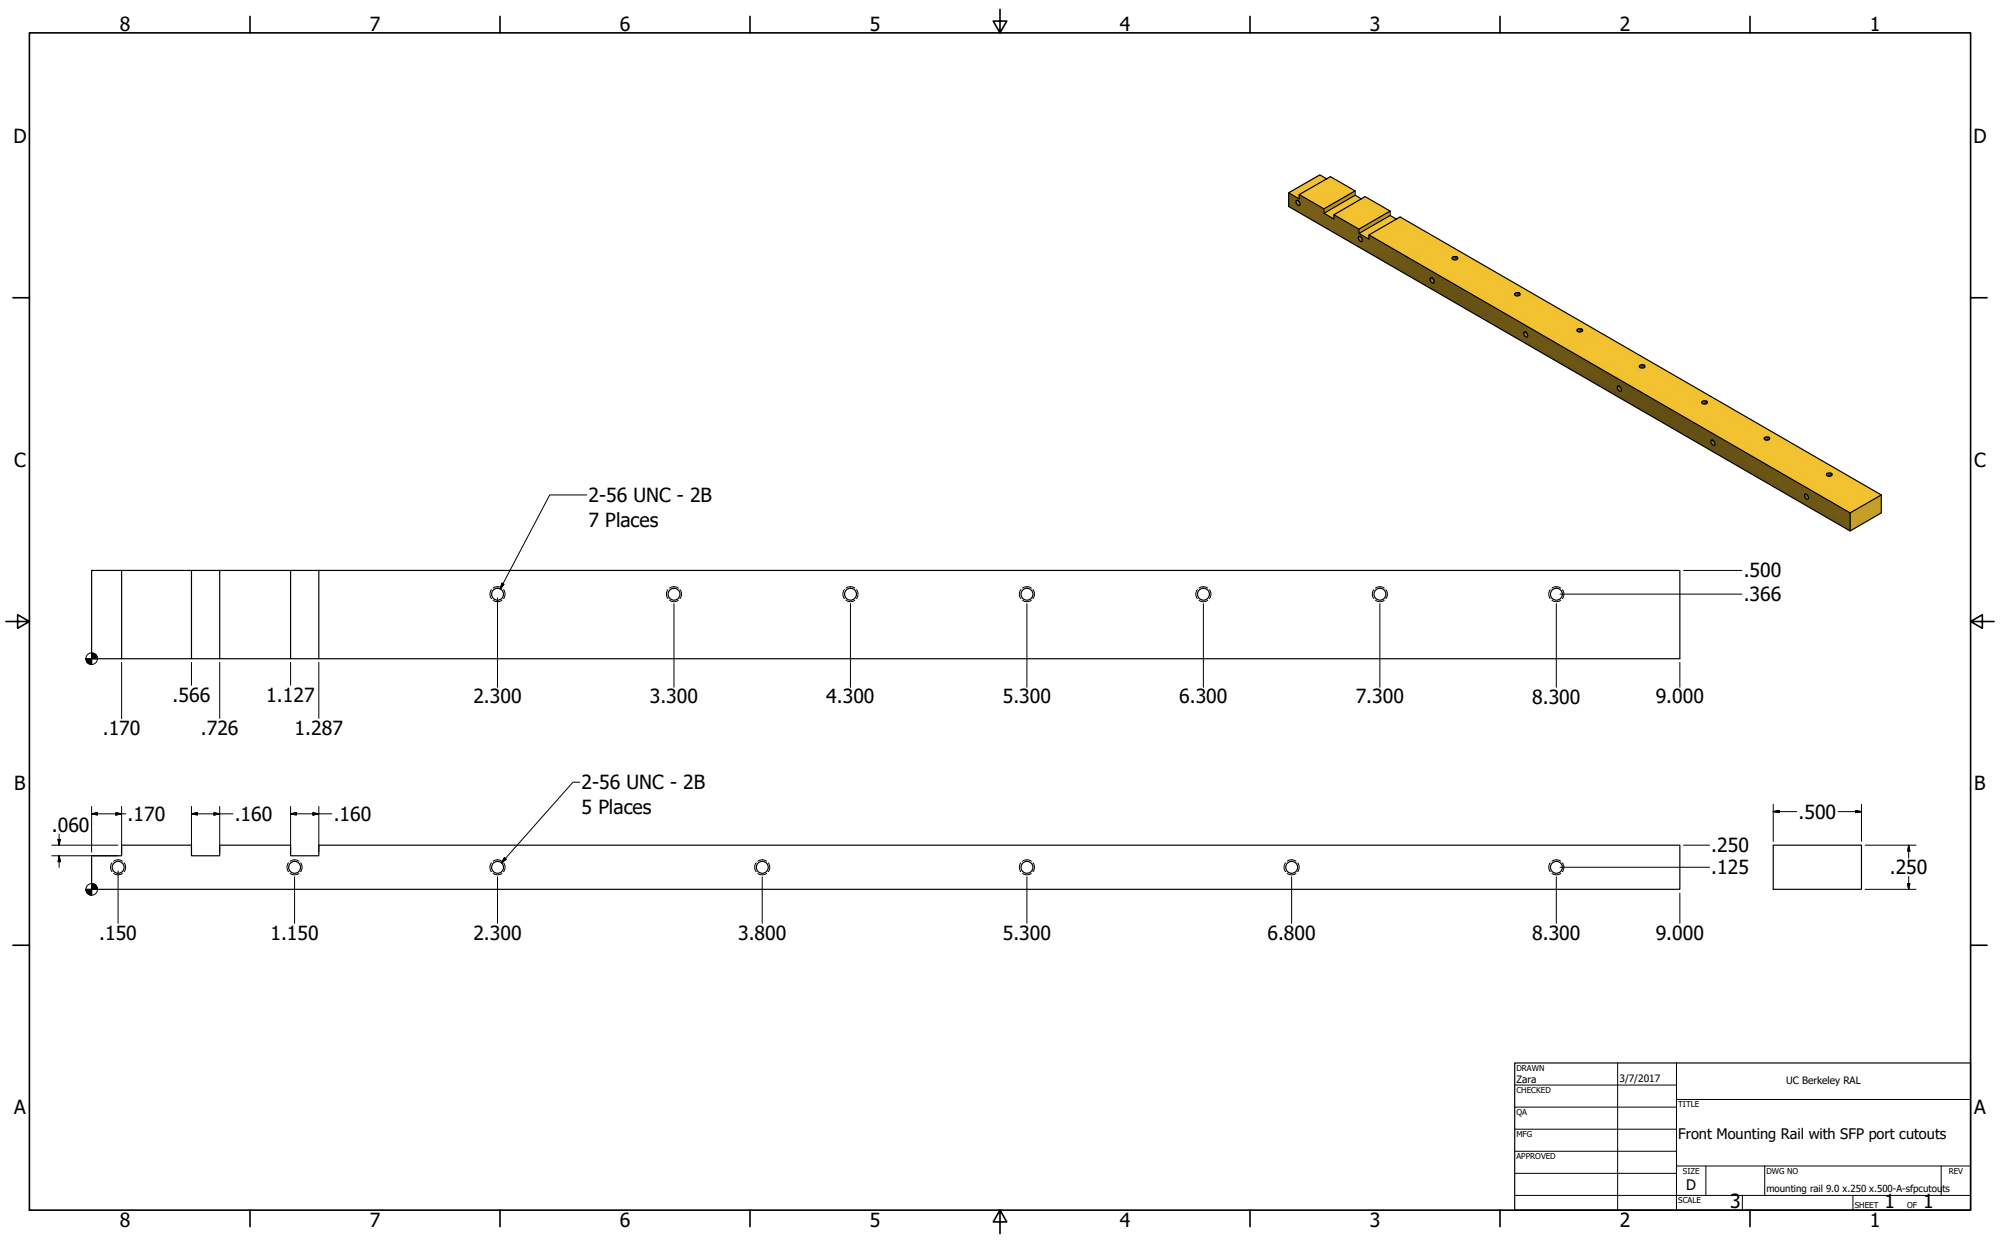
[picture p100: page 1]
SHEET 1 OF 1; DRAWN; CHECKED; MFG; APPROVED; Zara; SIZE D; SCALE; REV; 2-56 UNC - 2B 7 Places; 2-56 UNC - 2B 5 Places

UC Berkeley RAL

TITLE
Front Mounting Rail with SFP port cutouts

DWG NO
mounting rail 9.0 x.250 x.500-A-sfpcutouts
