david-deboer/hera-cad/Node/SNAP_V2/Workspaces/Workspace/drawings/quote_step_031617/mounting rail 9.0 x.250 x.500-B.pdf

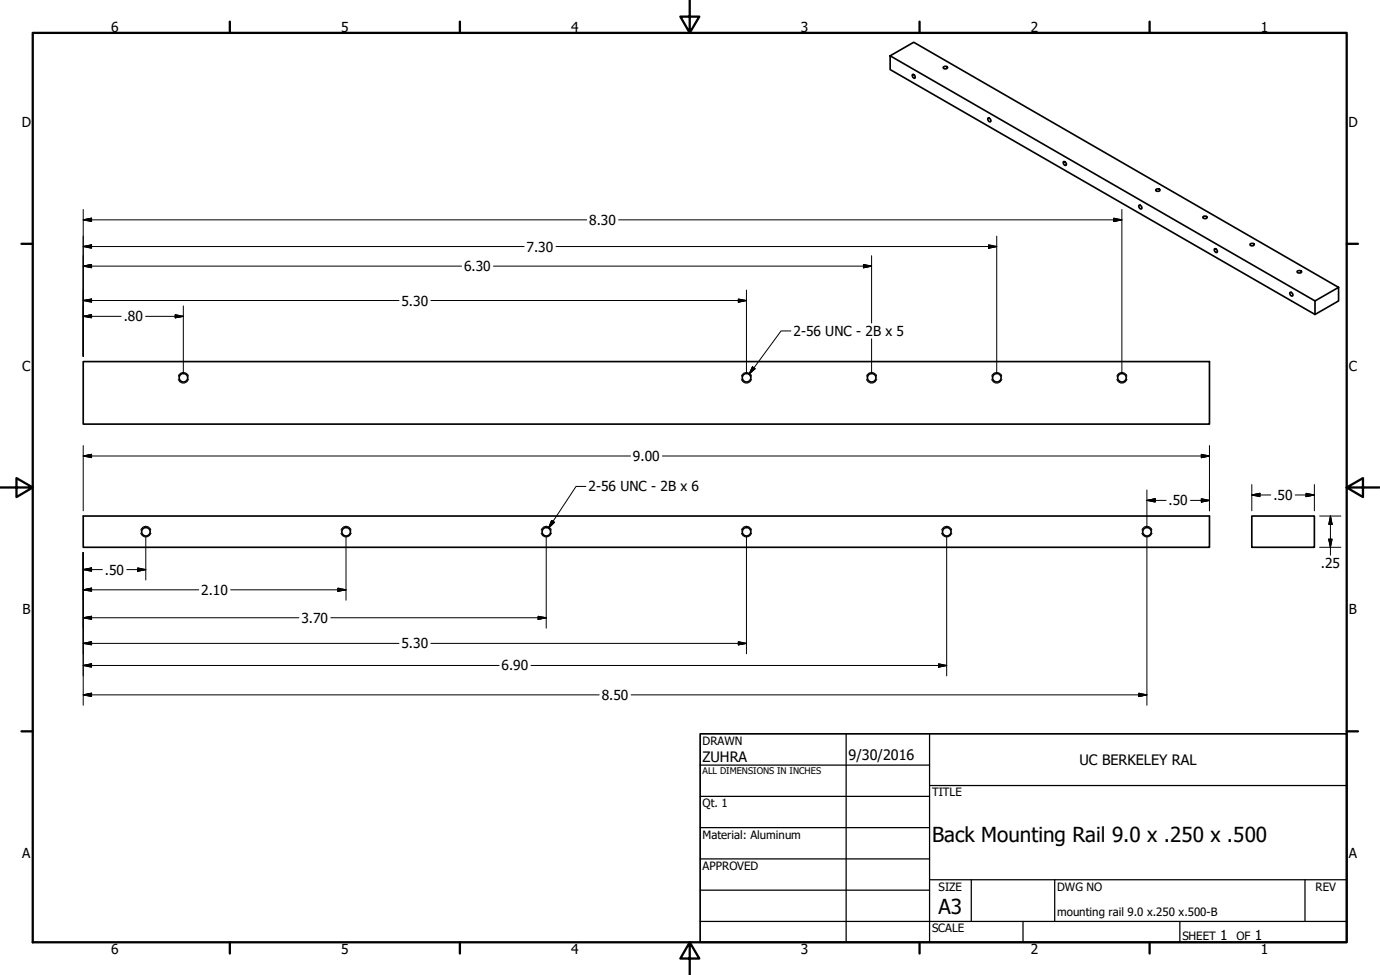
[picture p101: page 1]
SHEET 1 OF 1; DRAWN; Material: Aluminum; APPROVED; ZUHRA; DWG NO; mounting rail 9.0 x.250 x.500-B; SIZE A3; SCALE; REV; 2-56 UNC - 2B x 5; 2-56 UNC - 2B x 6

UC BERKELEY RAL

ALL DIMENSIONS IN INCHES

TITLE
Back Mounting Rail 9.0 x .250 x .500
