david-deboer/hera-cad/Node/SNAP_V2/Workspaces/Workspace/drawings/quote_step_031617/R58010-175_ALL.pdf

## REAR

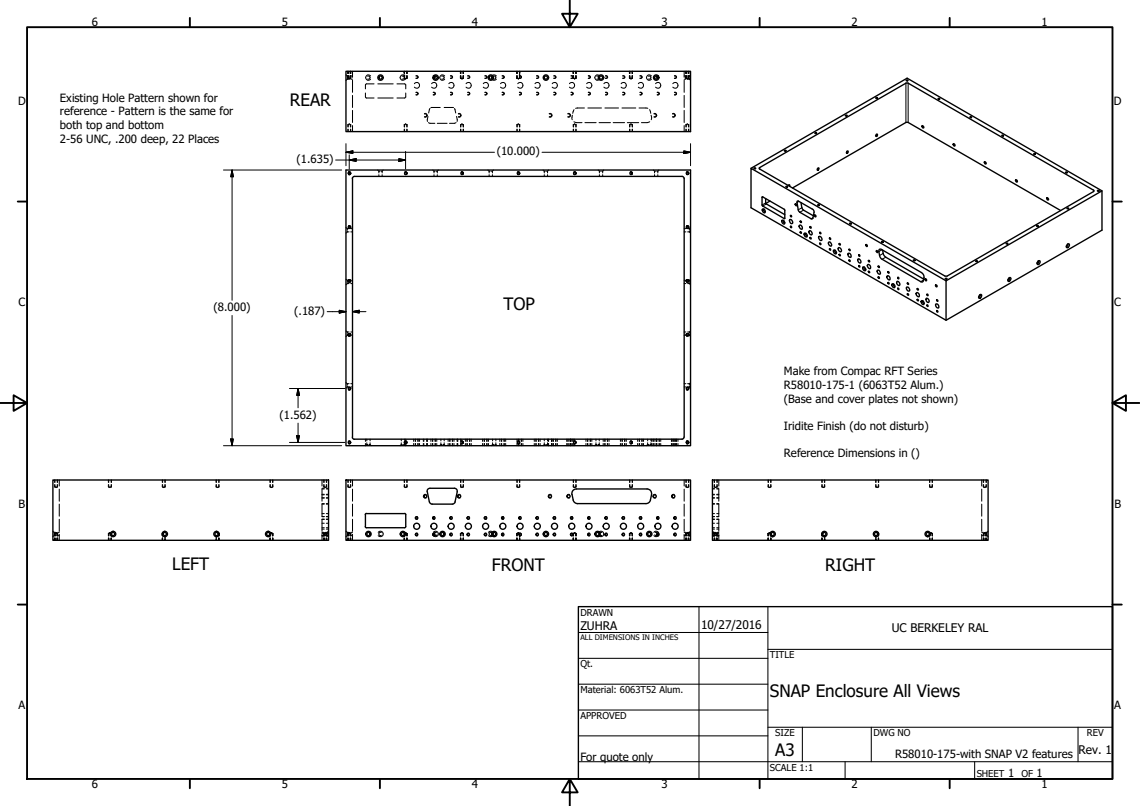
[picture p102: page 1]
FRONT; TOP; LEFT; RIGHT; SHEET 1 OF 1; DRAWN; Material: 6063T52 Alum.; APPROVED; ZUHRA; DWG NO; TITLE; SIZE A3; SCALE 1:1; REV Rev. 1; For quote only; R58010-175-with SNAP V2 features

Existing Hole Pattern shown for
reference - Pattern is the same for
both top and bottom
2-56 UNC, .200 deep, 22 Places

Make from Compac RFT Series
R58010-175-1 (6063T52 Alum.)
(Base and cover plates not shown)

Iridite Finish (do not disturb)

Reference Dimensions in ()

UC BERKELEY RAL

ALL DIMENSIONS IN INCHES

SNAP Enclosure All Views
