david-deboer/hera-cad/Node/SNAP_V2/Workspaces/Workspace/drawings/quote_step_031617/R58010-175_FRONT.pdf

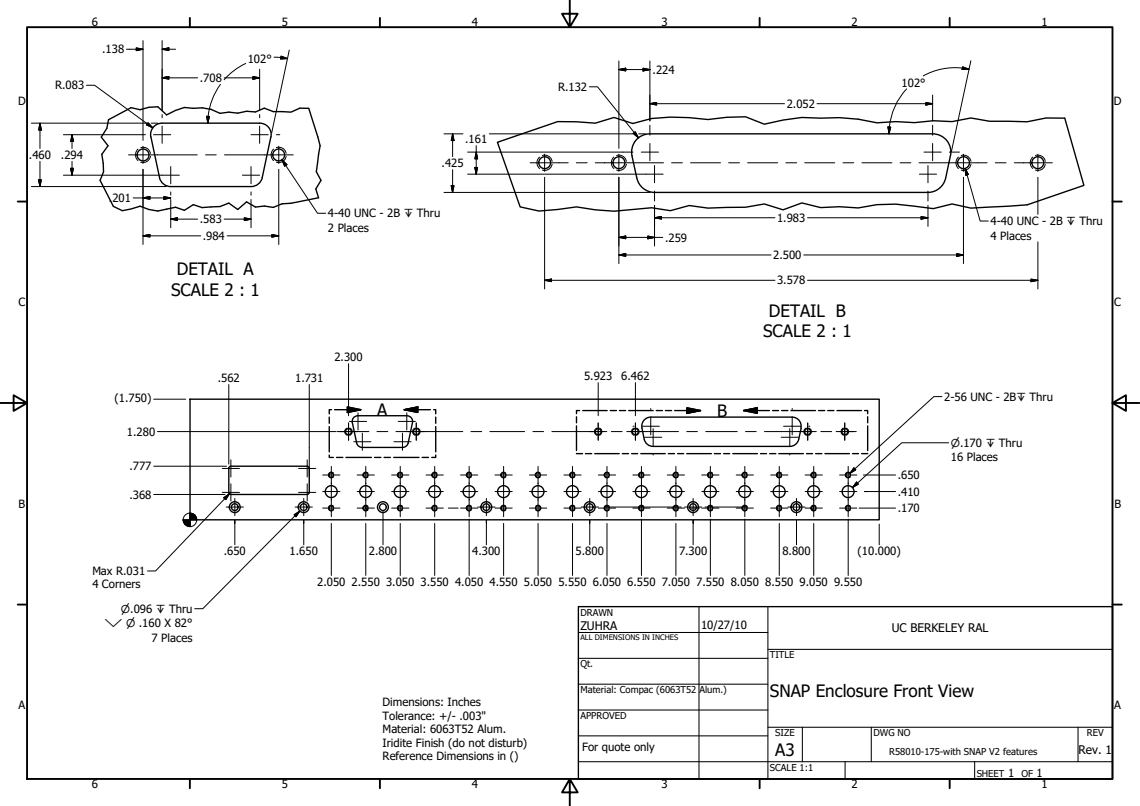
[picture p103: page 1]
DETAIL A SCALE 2 : 1; DETAIL B SCALE 2 : 1; SHEET 1 OF 1; DRAWN; Material: Compac (6063T52; Alum.); APPROVED; ZUHRA; DWG NO; TITLE; SIZE A3; SCALE 1:1; REV; For quote only; R58010-175-with SNAP V2 features; Rev. 1; 4-40 UNC - 2B Z Thru; 2 Places; 4 Places; P.096 Z Thru Y P .160 X 82°; 7 Places; P.170 Z Thru; 16 Places; 2-56 UNC - 2BZ Thru; Max R.031 4 Corners

UC BERKELEY RAL

ALL DIMENSIONS IN INCHES

SNAP Enclosure Front View

Dimensions: Inches
Tolerance: +/- .003"
Material: 6063T52 Alum.
Iridite Finish (do not disturb)
Reference Dimensions in ()
