david-deboer/hera-cad/Node/SNAP_V2/Workspaces/Workspace/drawings/quote_step_031617/R58010-175_LEFT.pdf

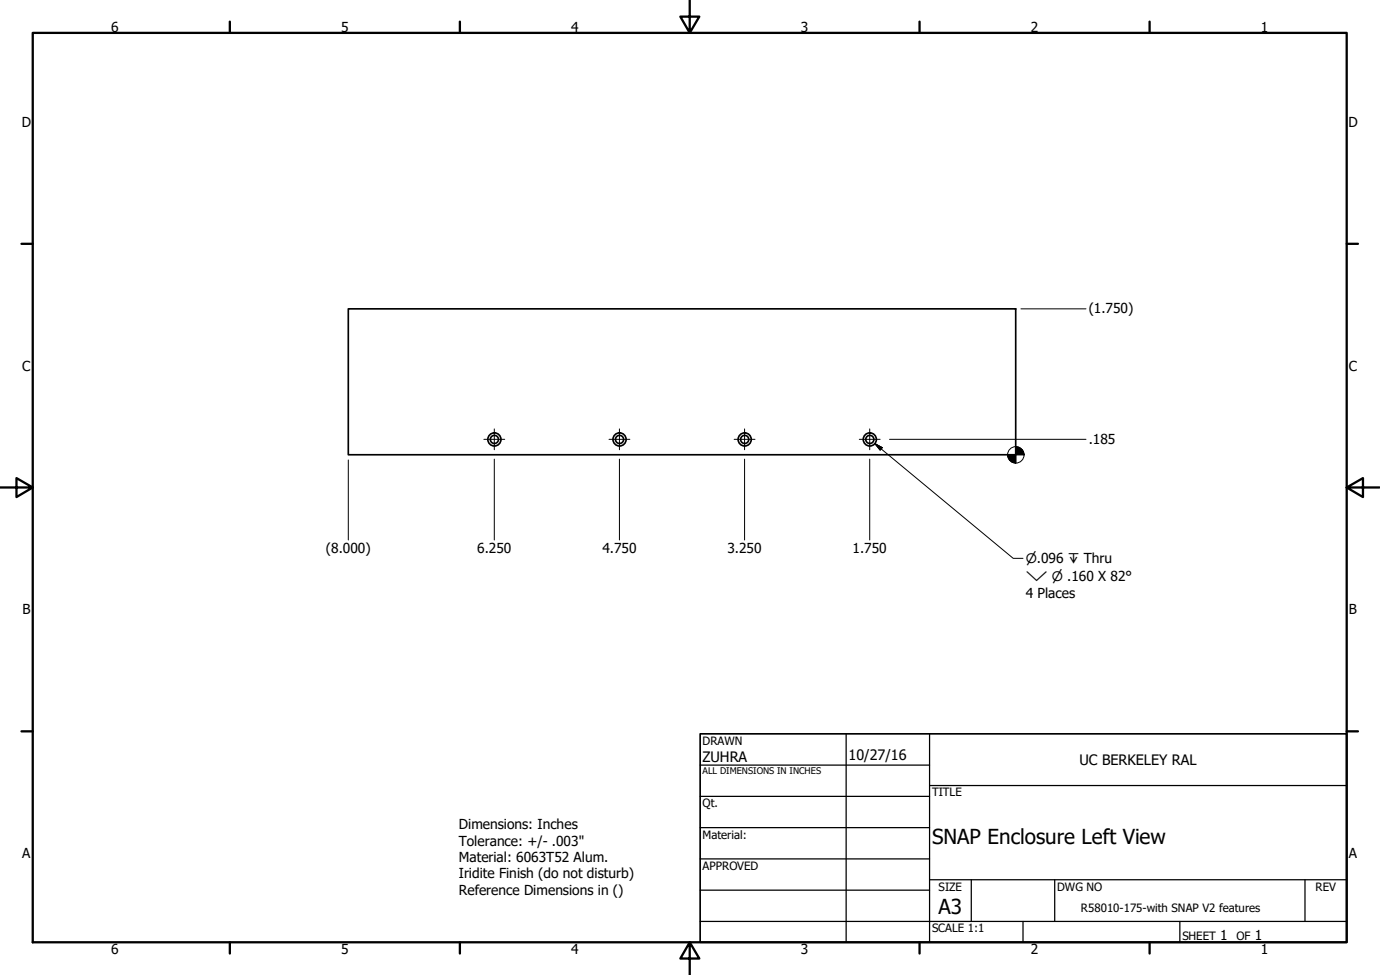
[picture p104: page 1]
SHEET 1 OF 1; DRAWN; Material:; APPROVED; ZUHRA; DWG NO; TITLE; SIZE A3; SCALE 1:1; REV; P.096 Z Thru Y P .160 X 82°; 4 Places

UC BERKELEY RAL

ALL DIMENSIONS IN INCHES

Dimensions: Inches
Tolerance: +/- .003"
Material: 6063T52 Alum.
Iridite Finish (do not disturb)
Reference Dimensions in ()

SNAP Enclosure Left View

R58010-175-with SNAP V2 features
