david-deboer/hera-cad/Node/SNAP_V2/Workspaces/Workspace/drawings/quote_step_031617/R58010-175_RIGHT.pdf

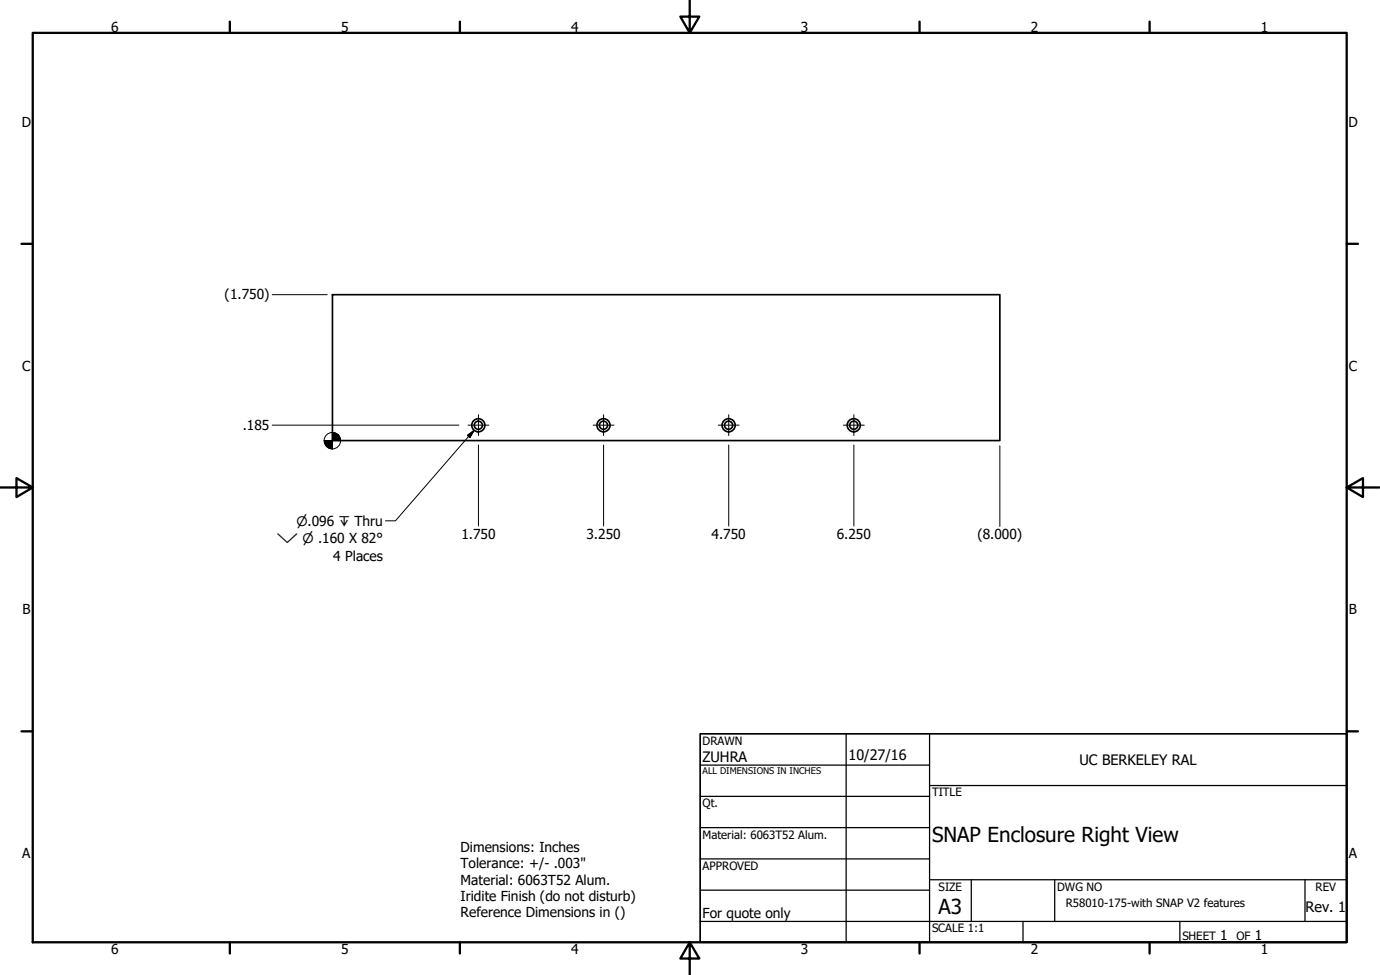
[picture p106: page 1]
SHEET 1 OF 1; DRAWN; Material: 6063T52 Alum.; APPROVED; ZUHRA; SIZE A3; SCALE 1:1; REV Rev. 1; P.096 Z Thru Y P .160 X 82°; 4 Places

UC BERKELEY RAL

ALL DIMENSIONS IN INCHES

TITLE
SNAP Enclosure Right View

Dimensions: Inches
Tolerance: +/- .003"
Material: 6063T52 Alum.
Iridite Finish (do not disturb)
Reference Dimensions in ()

DWG NO
R58010-175-with SNAP V2 features

For quote only
