david-deboer/hera-cad/Node/H3NE-B_A_EnclosureBody.pdf

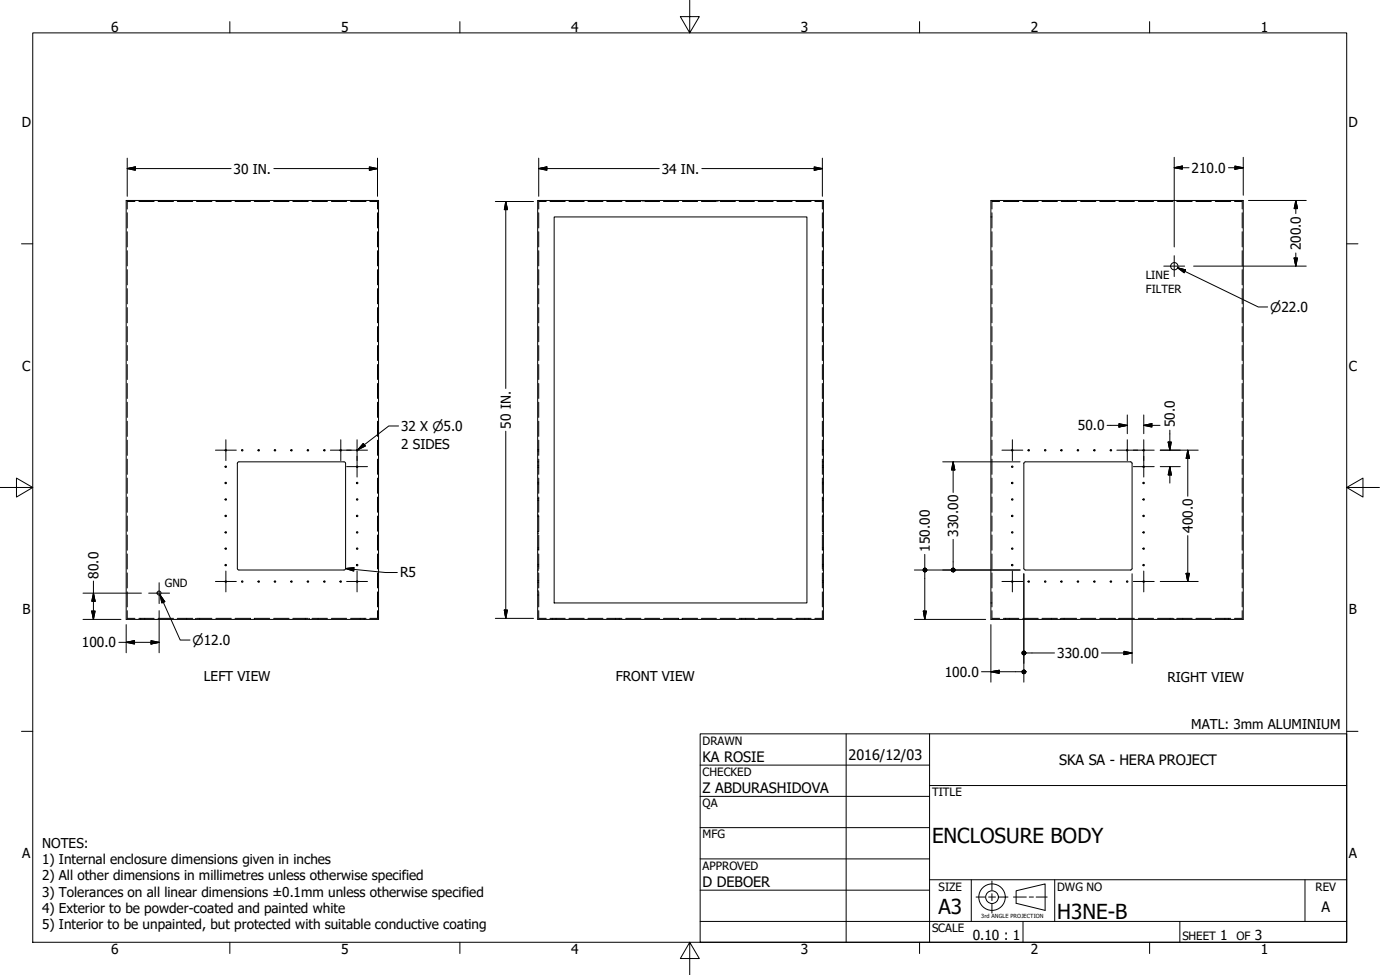
[picture p107: page 1]
SHEET 1 OF 3; DRAWN; CHECKED; MFG; APPROVED D DEBOER; KA ROSIE; Z ABDURASHIDOVA; DWG NO H3NE-B; TITLE; ENCLOSURE BODY; SIZE A3; SCALE; REV A; 2 SIDES; MATL: 3mm ALUMINIUM; 3rd ANGLE PROJECTION; LEFT VIEW; FRONT VIEW; RIGHT VIEW; LINE FILTER; GND

SKA SA - HERA PROJECT

NOTES:
1) Internal enclosure dimensions given in inches
2) All other dimensions in millimetres unless otherwise specified
3) Tolerances on all linear dimensions ±0.1mm unless otherwise specified
4) Exterior to be powder-coated and painted white
5) Interior to be unpainted, but protected with suitable conductive coating

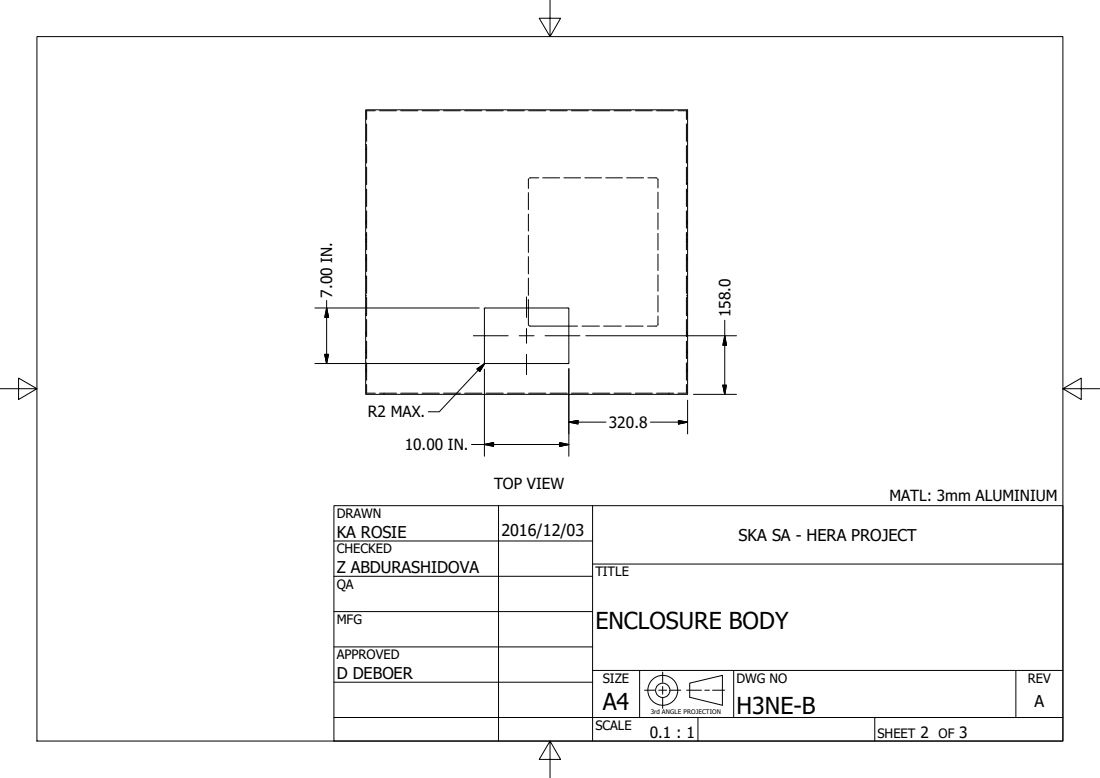
[picture p108: page 2]
DRAWN; CHECKED; MFG; APPROVED D DEBOER; KA ROSIE; Z ABDURASHIDOVA; DWG NO H3NE-B; TITLE; ENCLOSURE BODY; SIZE A4; REV A; TOP VIEW; R2 MAX.; MATL: 3mm ALUMINIUM

SKA SA - HERA PROJECT

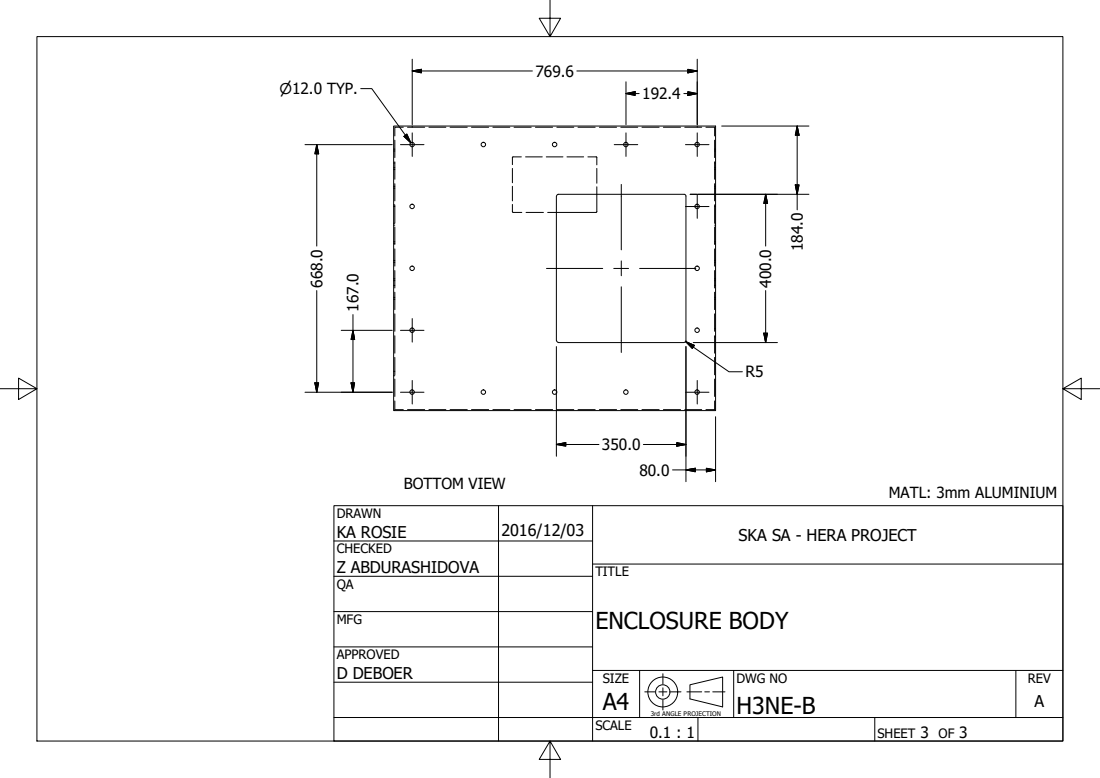
[picture p109: page 3]
DRAWN; CHECKED; MFG; APPROVED D DEBOER; KA ROSIE; Z ABDURASHIDOVA; DWG NO H3NE-B; TITLE; ENCLOSURE BODY; SIZE A4; REV A; P12.0 TYP.; BOTTOM VIEW; MATL: 3mm ALUMINIUM

SKA SA - HERA PROJECT
