david-deboer/hera-cad/Node/H3NE-FF_A_FloorFrame.pdf

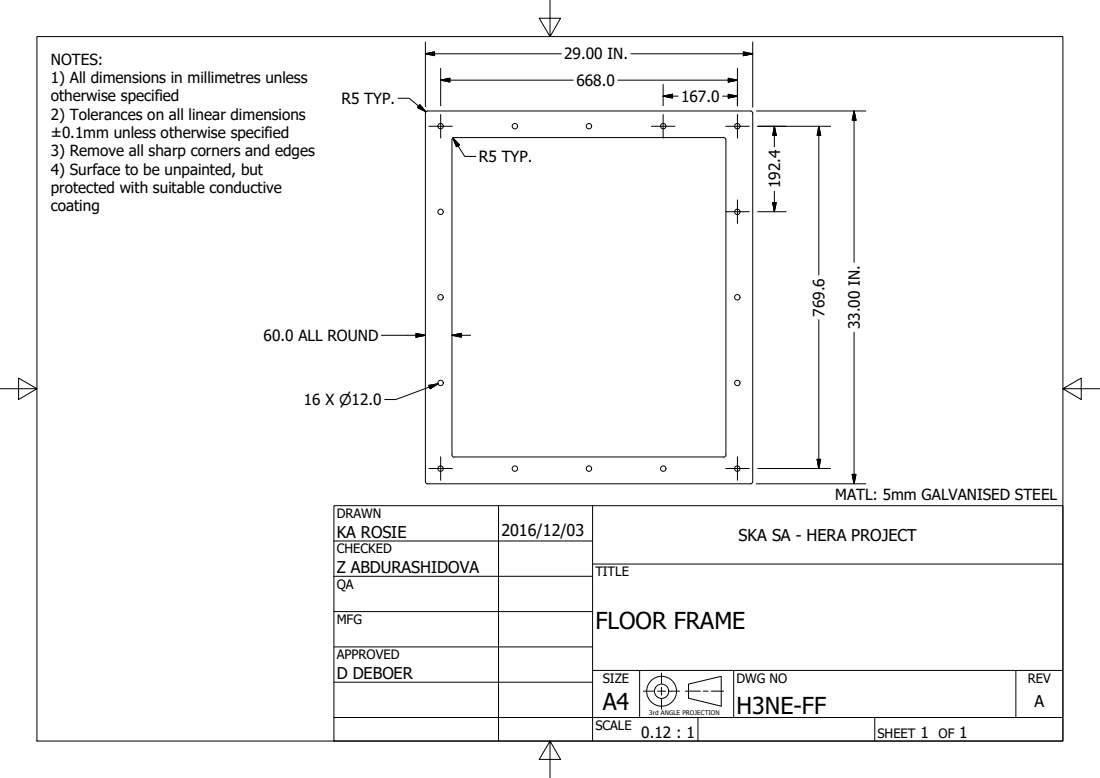
[picture p110: page 1]
SHEET 1 OF 1; DRAWN; CHECKED; MFG; APPROVED D DEBOER; KA ROSIE; Z ABDURASHIDOVA; DWG NO H3NE-FF; TITLE; FLOOR FRAME; SIZE A4; SCALE; REV A; 3rd ANGLE PROJECTION; 60.0 ALL ROUND; R5 TYP.

NOTES:
1) All dimensions in millimetres unless
otherwise specified
2) Tolerances on all linear dimensions
±0.1mm unless otherwise specified
3) Remove all sharp corners and edges
4) Surface to be unpainted, but
protected with suitable conductive
coating

MATL: 5mm GALVANISED STEEL

SKA SA - HERA PROJECT
