david-deboer/hera-cad/Node/H3NE-SB_A_SidePanelBlank.pdf

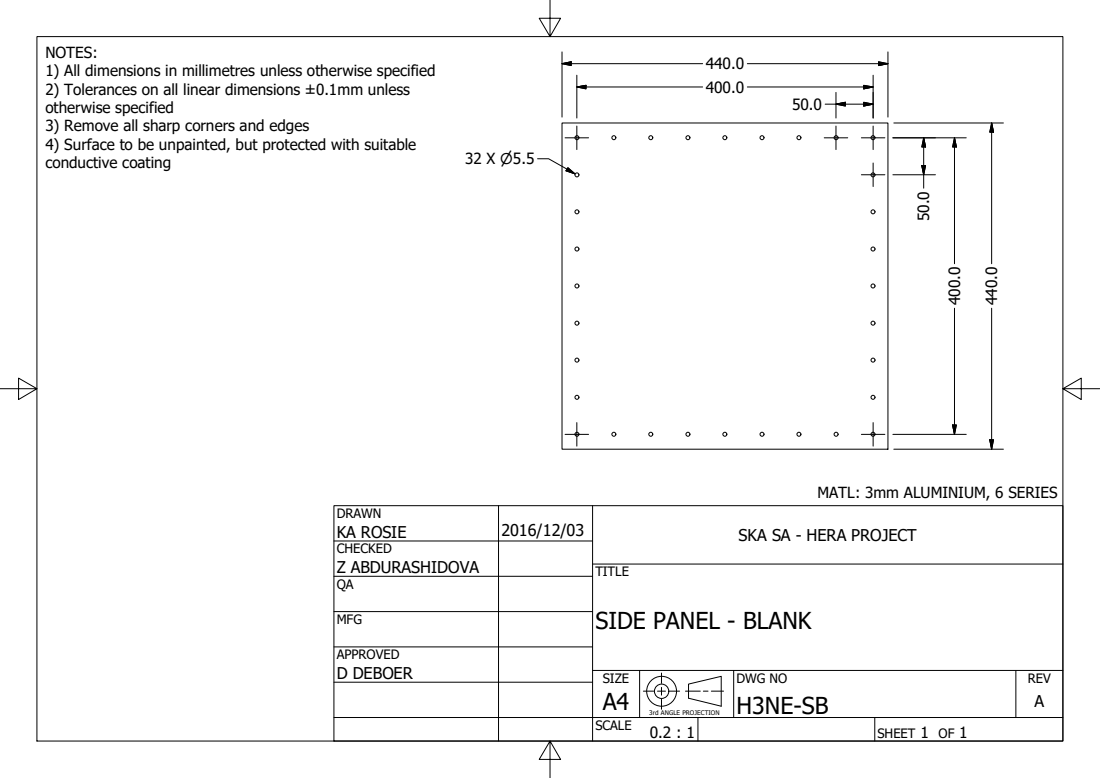
[picture p111: page 1]
SHEET 1 OF 1; DRAWN; CHECKED; MFG; APPROVED D DEBOER; KA ROSIE; Z ABDURASHIDOVA; DWG NO H3NE-SB; TITLE; SIZE A4; SCALE; REV A; 3rd ANGLE PROJECTION

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

MATL: 3mm ALUMINIUM, 6 SERIES

SKA SA - HERA PROJECT

SIDE PANEL - BLANK
