david-deboer/hera-cad/Node/H3NE-SF_A_SidePanelFrame.pdf

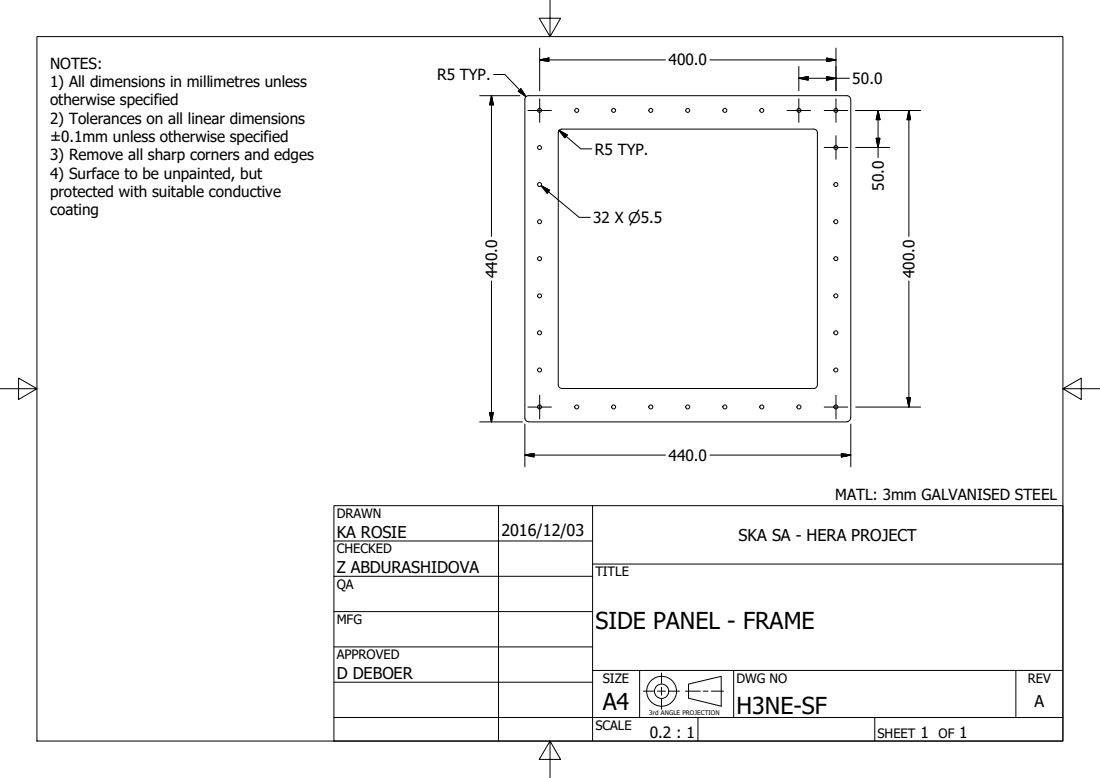
[picture p112: page 1]
SHEET 1 OF 1; DRAWN; CHECKED; MFG; APPROVED D DEBOER; KA ROSIE; Z ABDURASHIDOVA; DWG NO H3NE-SF; TITLE; SIZE A4; SCALE; REV A; 3rd ANGLE PROJECTION; R5 TYP.

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

MATL: 3mm GALVANISED STEEL

SKA SA - HERA PROJECT

SIDE PANEL - FRAME
