david-deboer/hera-cad/Node/H3NE_A_EnclosureAssy.pdf

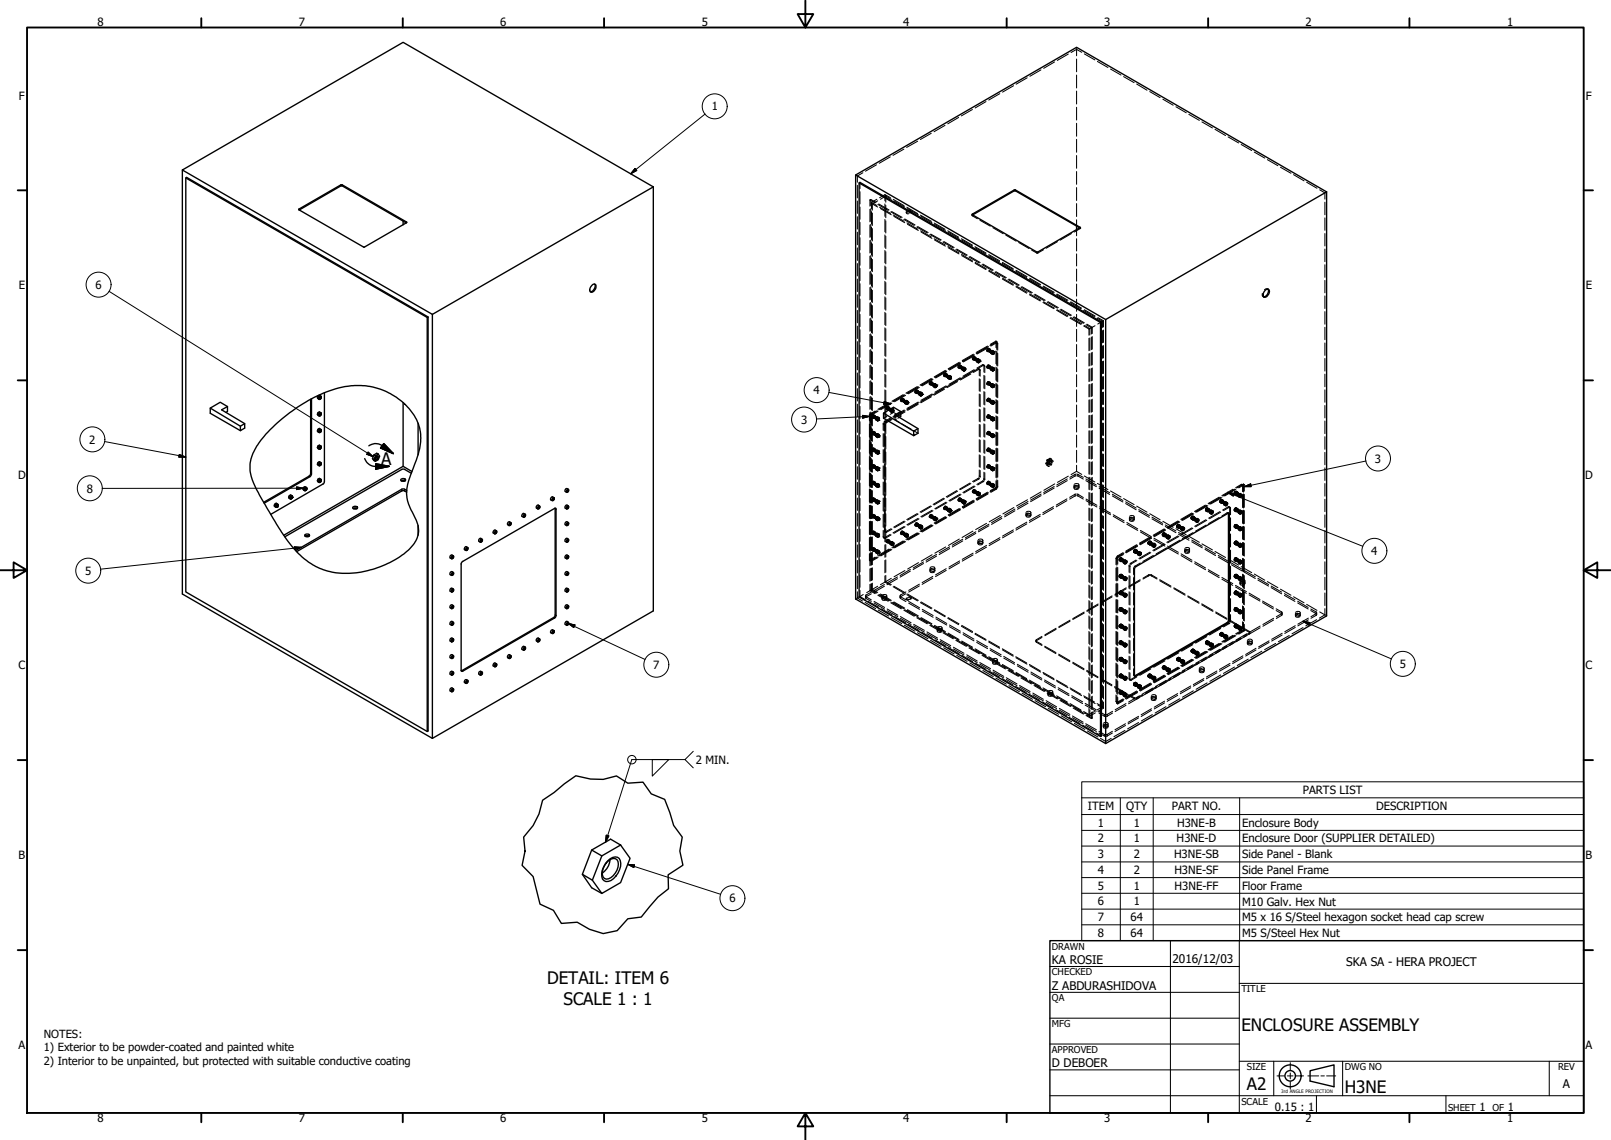
[picture p113: page 1]
DETAIL: ITEM 6 SCALE 1 : 1; PARTS LIST; ITEM QTY; PART NO.; DESCRIPTION; Enclosure Body; Enclosure Door (SUPPLIER DETAILED); Side Panel - Blank; Side Panel Frame; Floor Frame; M10 Galv. Hex Nut; M5 x 16 S/Steel hexagon socket head cap screw; M5 S/Steel Hex Nut; SHEET 1 OF 1; DRAWN; CHECKED; MFG; APPROVED D DEBOER; KA ROSIE; Z ABDURASHIDOVA; DWG NO H3NE; TITLE; ENCLOSURE ASSEMBLY; SIZE A2; SCALE; REV A; 3rd ANGLE PROJECTION; 2 MIN.

SKA SA - HERA PROJECT

NOTES:
1) Exterior to be powder-coated and painted white
2) Interior to be unpainted, but protected with suitable conductive coating
