david-deboer/hera-cad/Node/H3-A_nodeGeneralArrangement.pdf

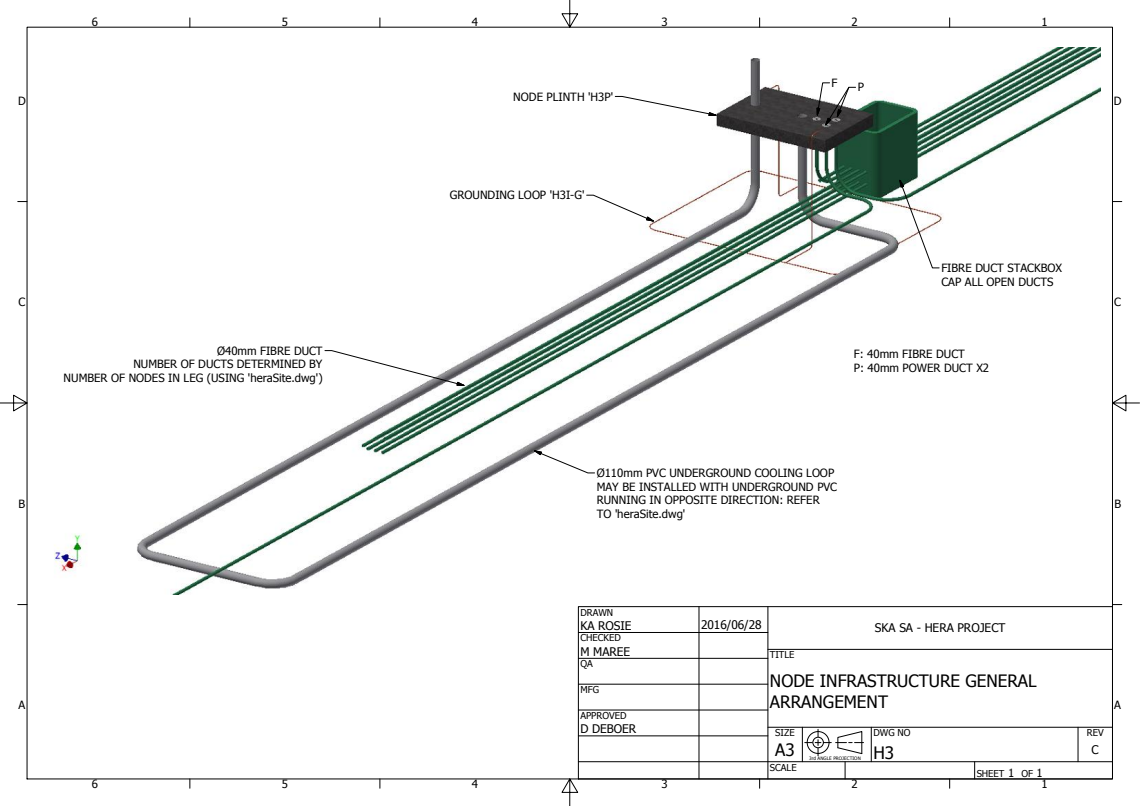
[picture p114: page 1]
SHEET 1 OF 1; DRAWN; CHECKED; MFG; APPROVED D DEBOER; KA ROSIE; M MAREE; DWG NO H3; SIZE A3; SCALE; REV C; 3rd ANGLE PROJECTION; Ø40mm FIBRE DUCT; GROUNDING LOOP 'H3I-G'; NODE PLINTH 'H3P'; F: 40mm FIBRE DUCT P: 40mm POWER DUCT X2

FIBRE DUCT STACKBOX
CAP ALL OPEN DUCTS

NUMBER OF DUCTS DETERMINED BY

NUMBER OF NODES IN LEG (USING 'heraSite.dwg')

Ø110mm PVC UNDERGROUND COOLING LOOP
MAY BE INSTALLED WITH UNDERGROUND PVC
RUNNING IN OPPOSITE DIRECTION: REFER
TO 'heraSite.dwg'

SKA SA - HERA PROJECT

TITLE
NODE INFRASTRUCTURE GENERAL
ARRANGEMENT
