david-deboer/hera-cad/Node/H3_trench_elevation.pdf

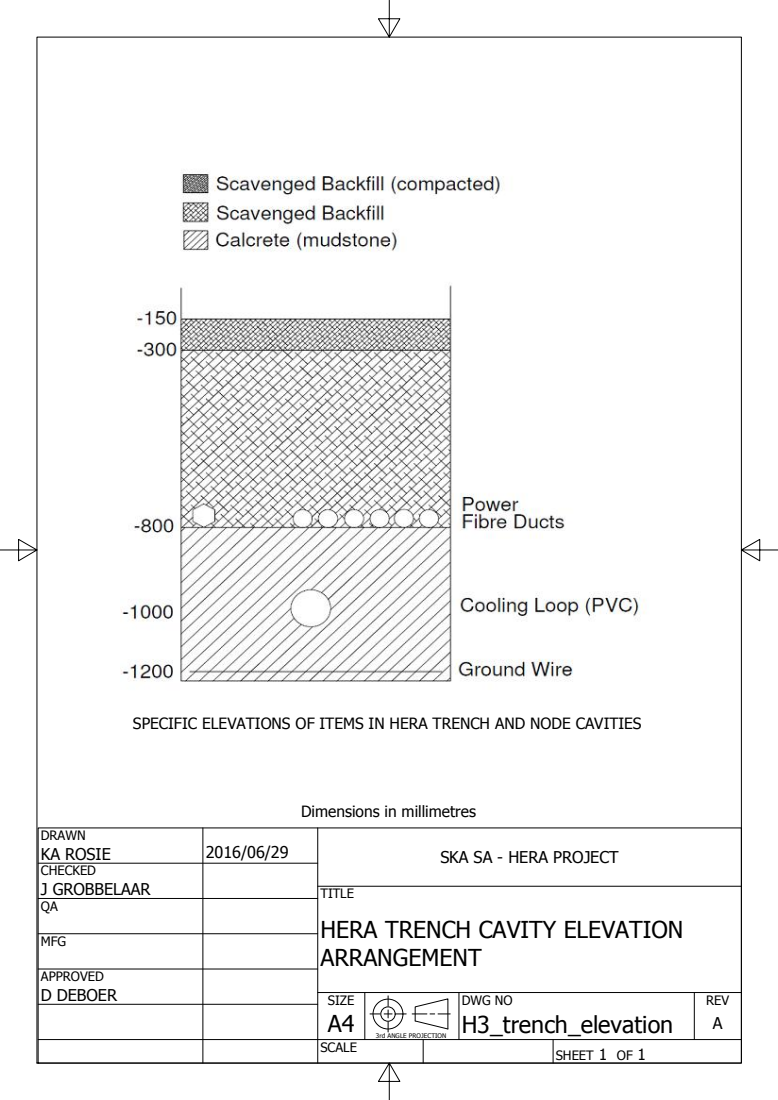
[picture p115: page 1]
SHEET 1 OF 1; DRAWN; CHECKED; MFG; APPROVED D DEBOER; KA ROSIE; J GROBBELAAR; DWG NO H3_trench_elevation; SIZE A4; SCALE; REV A; 3rd ANGLE PROJECTION

SPECIFIC ELEVATIONS OF ITEMS IN HERA TRENCH AND NODE CAVITIES

Dimensions in millimetres

SKA SA - HERA PROJECT

TITLE
HERA TRENCH CAVITY ELEVATION
ARRANGEMENT
