david-deboer/hera-cad/Node/H3P-Ca_plinth.pdf

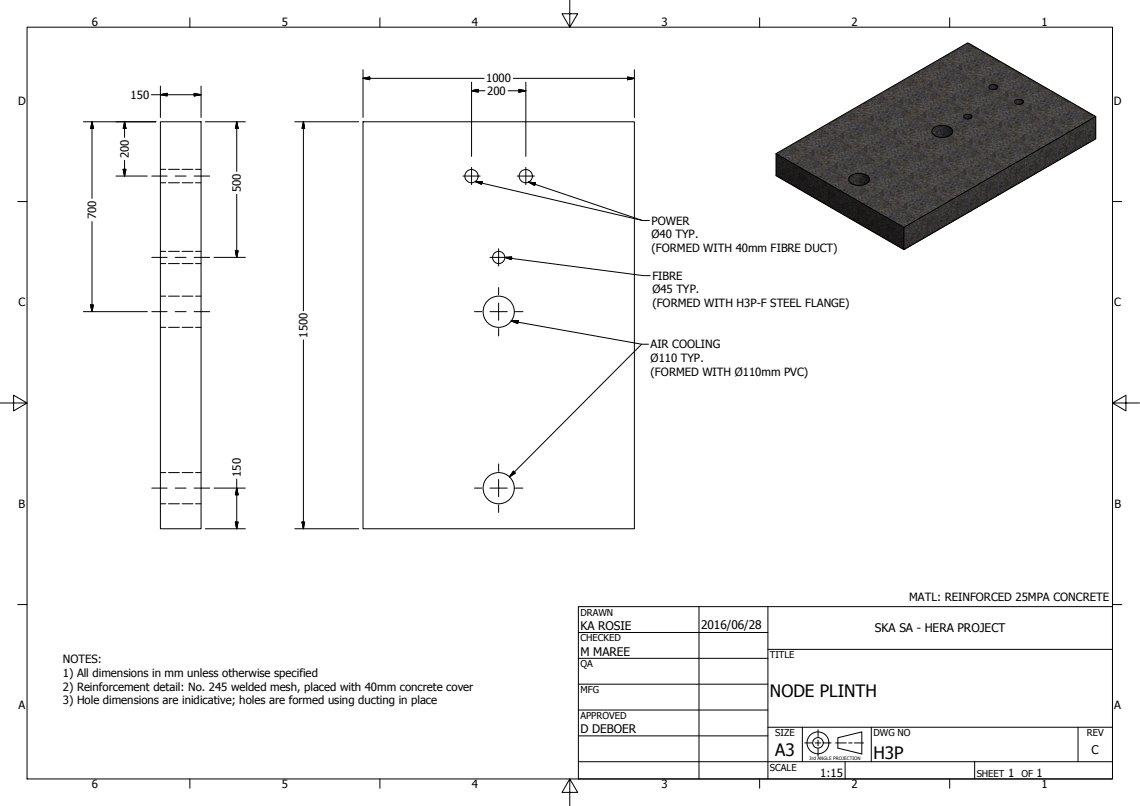
[picture p116: page 1]
SHEET 1 OF 1; DRAWN; CHECKED; MFG; APPROVED D DEBOER; KA ROSIE; M MAREE; DWG NO H3P; TITLE; NODE PLINTH; SIZE A3; SCALE; REV C; 3rd ANGLE PROJECTION

POWER
Ø40 TYP.
(FORMED WITH 40mm FIBRE DUCT)

FIBRE
Ø45 TYP.
(FORMED WITH H3P-F STEEL FLANGE)

AIR COOLING
Ø110 TYP.
(FORMED WITH Ø110mm PVC)

MATL: REINFORCED 25MPA CONCRETE

SKA SA - HERA PROJECT

NOTES:
1) All dimensions in mm unless otherwise specified
2) Reinforcement detail: No. 245 welded mesh, placed with 40mm concrete cover
3) Hole dimensions are inidicative; holes are formed using ducting in place
