david-deboer/hera-cad/feed/H2bm-iA_a_bpSupInner1.pdf

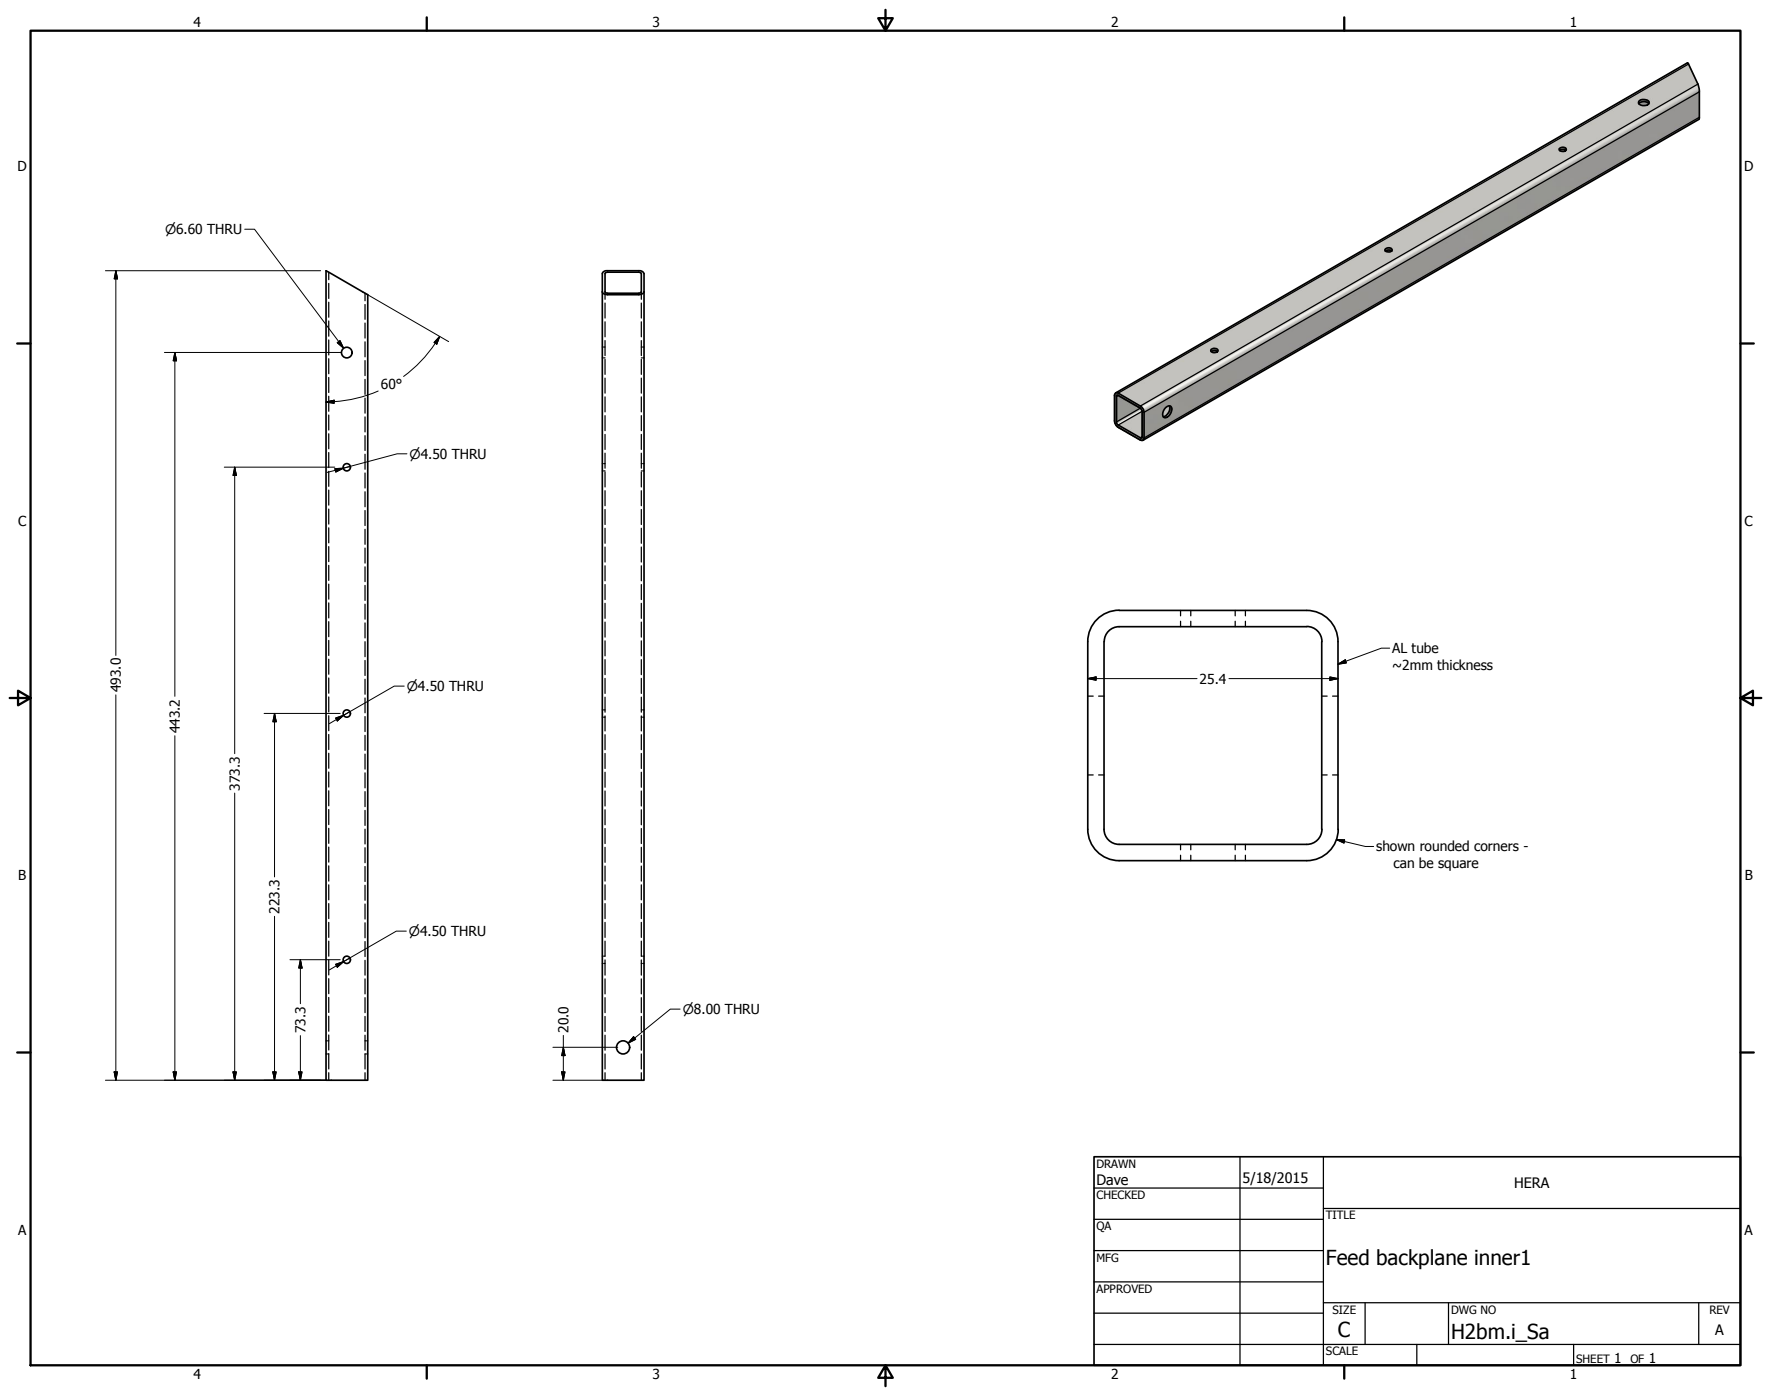
[picture p117: page 1]
SHEET 1 OF 1; DRAWN; CHECKED; MFG; APPROVED; Dave; DWG NO H2bm.i_Sa; TITLE; Feed backplane inner1; SIZE C; SCALE; HERA; REV A; AL tube ~2mm thickness; P6.60 THRU; P4.50 THRU; P8.00 THRU

shown rounded corners -
can be square
