david-deboer/hera-cad/feed/H2bm-iAU_a_bpSupInner1.pdf

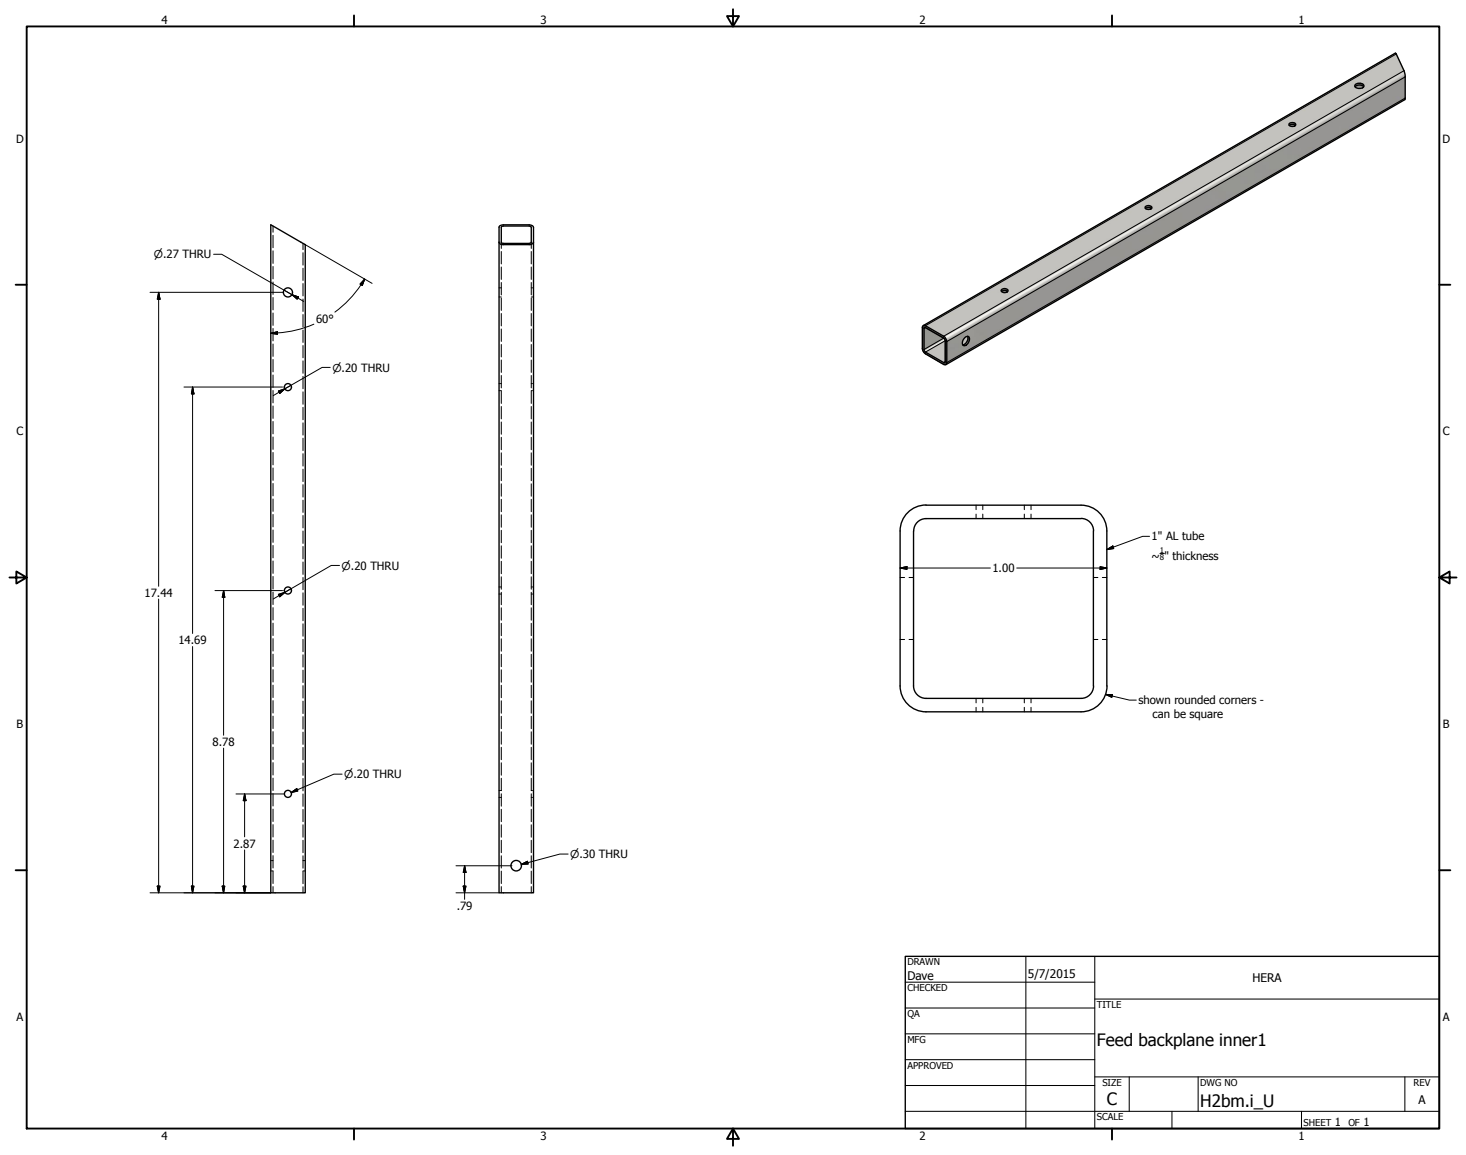
[picture p118: page 1]
SHEET 1 OF 1; DRAWN; CHECKED; MFG; APPROVED; Dave; DWG NO H2bm.i_U; TITLE; Feed backplane inner1; SIZE C; SCALE; HERA; REV A; P.27 THRU; P.20 THRU; P.30 THRU; 1" AL tube; 1 8" thickness

shown rounded corners -
can be square
