david-deboer/hera-cad/feed/H2bm-lA_a_bpSupCross.pdf

Top | Side

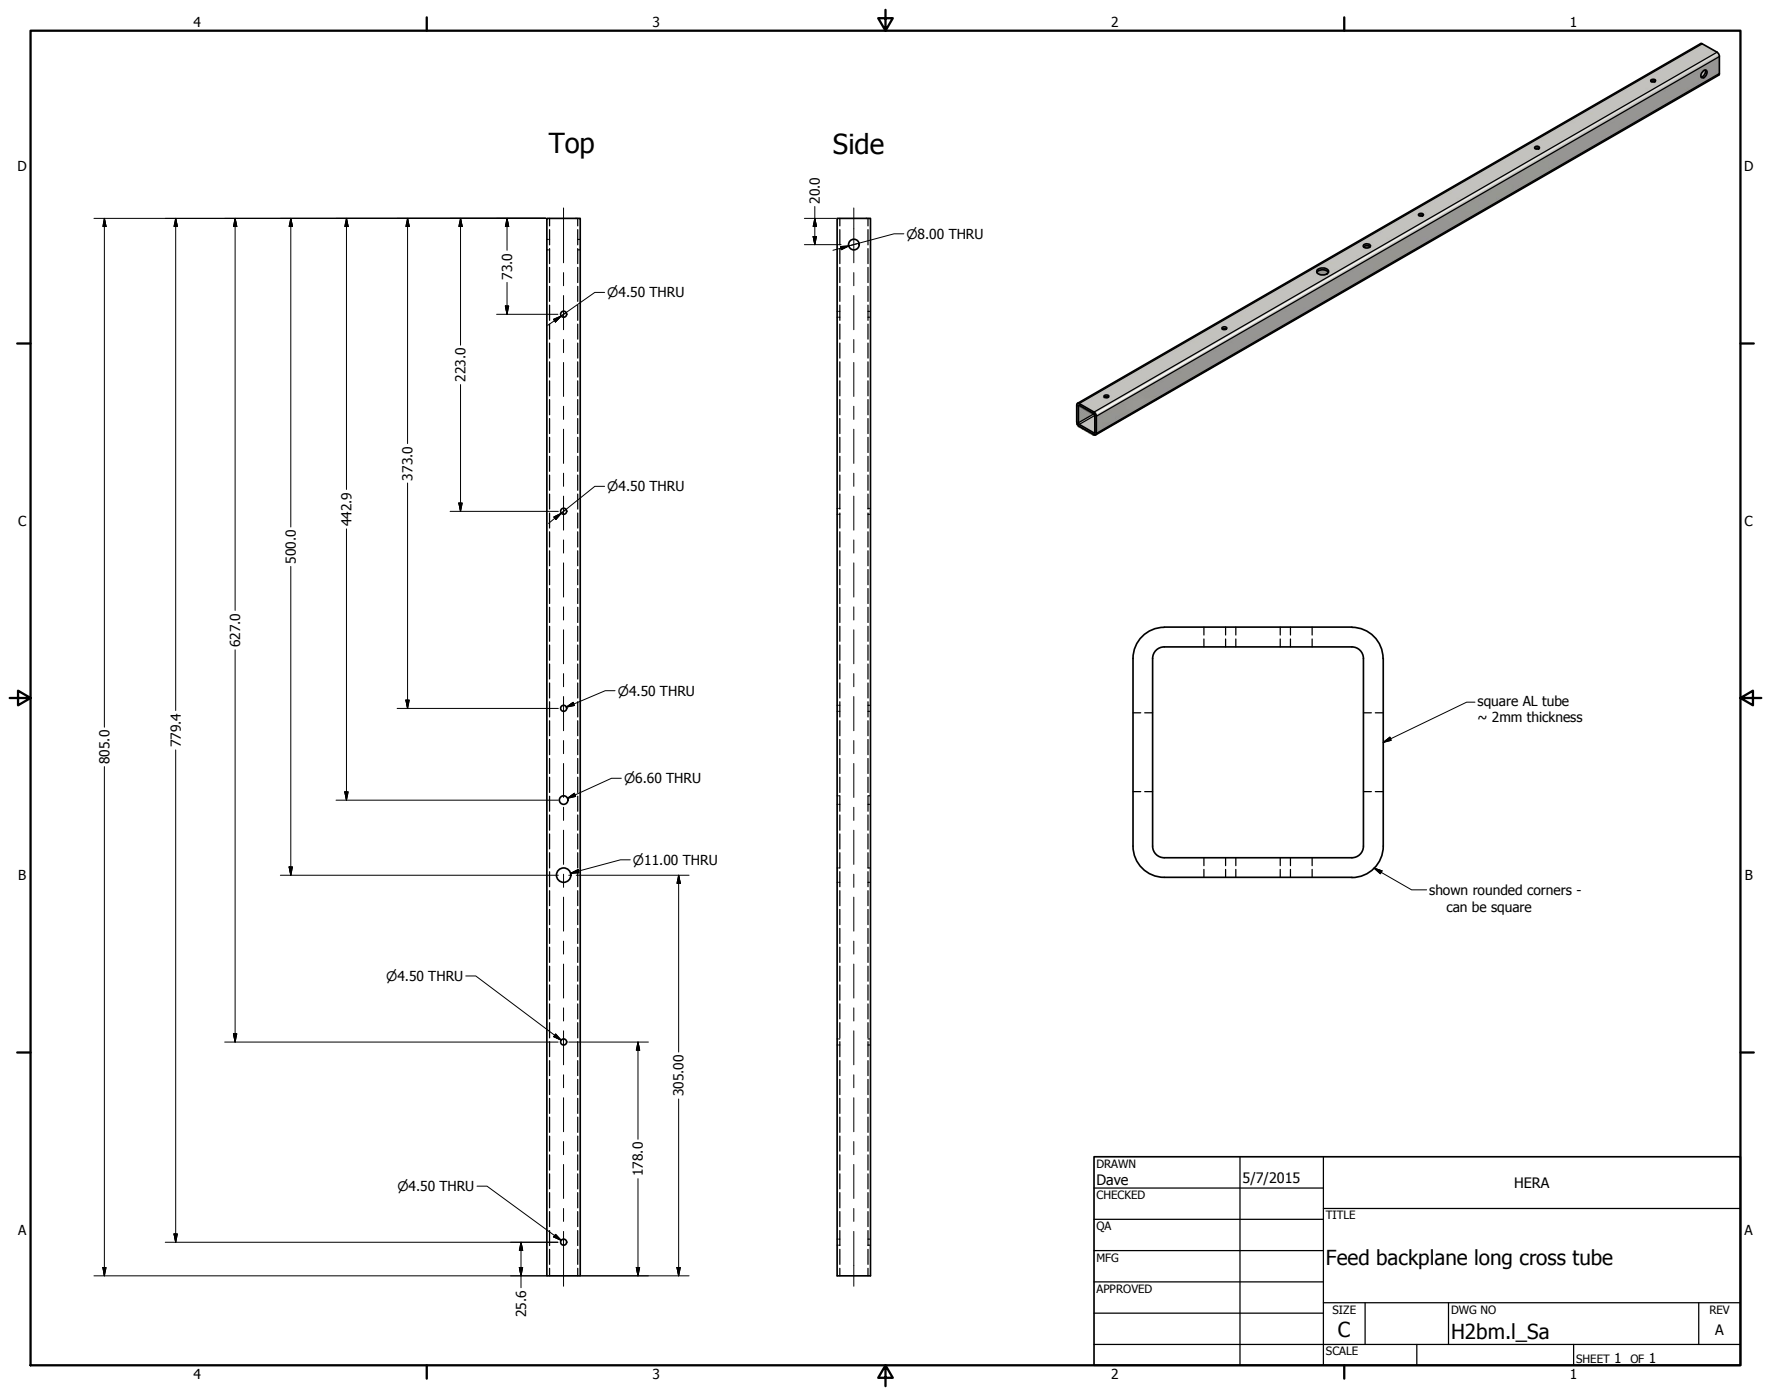
[picture p119: page 1]
SHEET 1 OF 1; DRAWN; CHECKED; MFG; APPROVED; Dave; DWG NO H2bm.l_Sa; SIZE C; SCALE; HERA; REV A; P8.00 THRU; P4.50 THRU; P6.60 THRU; P11.00 THRU

square AL tube
~ 2mm thickness

shown rounded corners -
can be square

TITLE
Feed backplane long cross tube
