david-deboer/hera-cad/feed/H2bm-lAU_a_bpSupCross.pdf

Top | Side

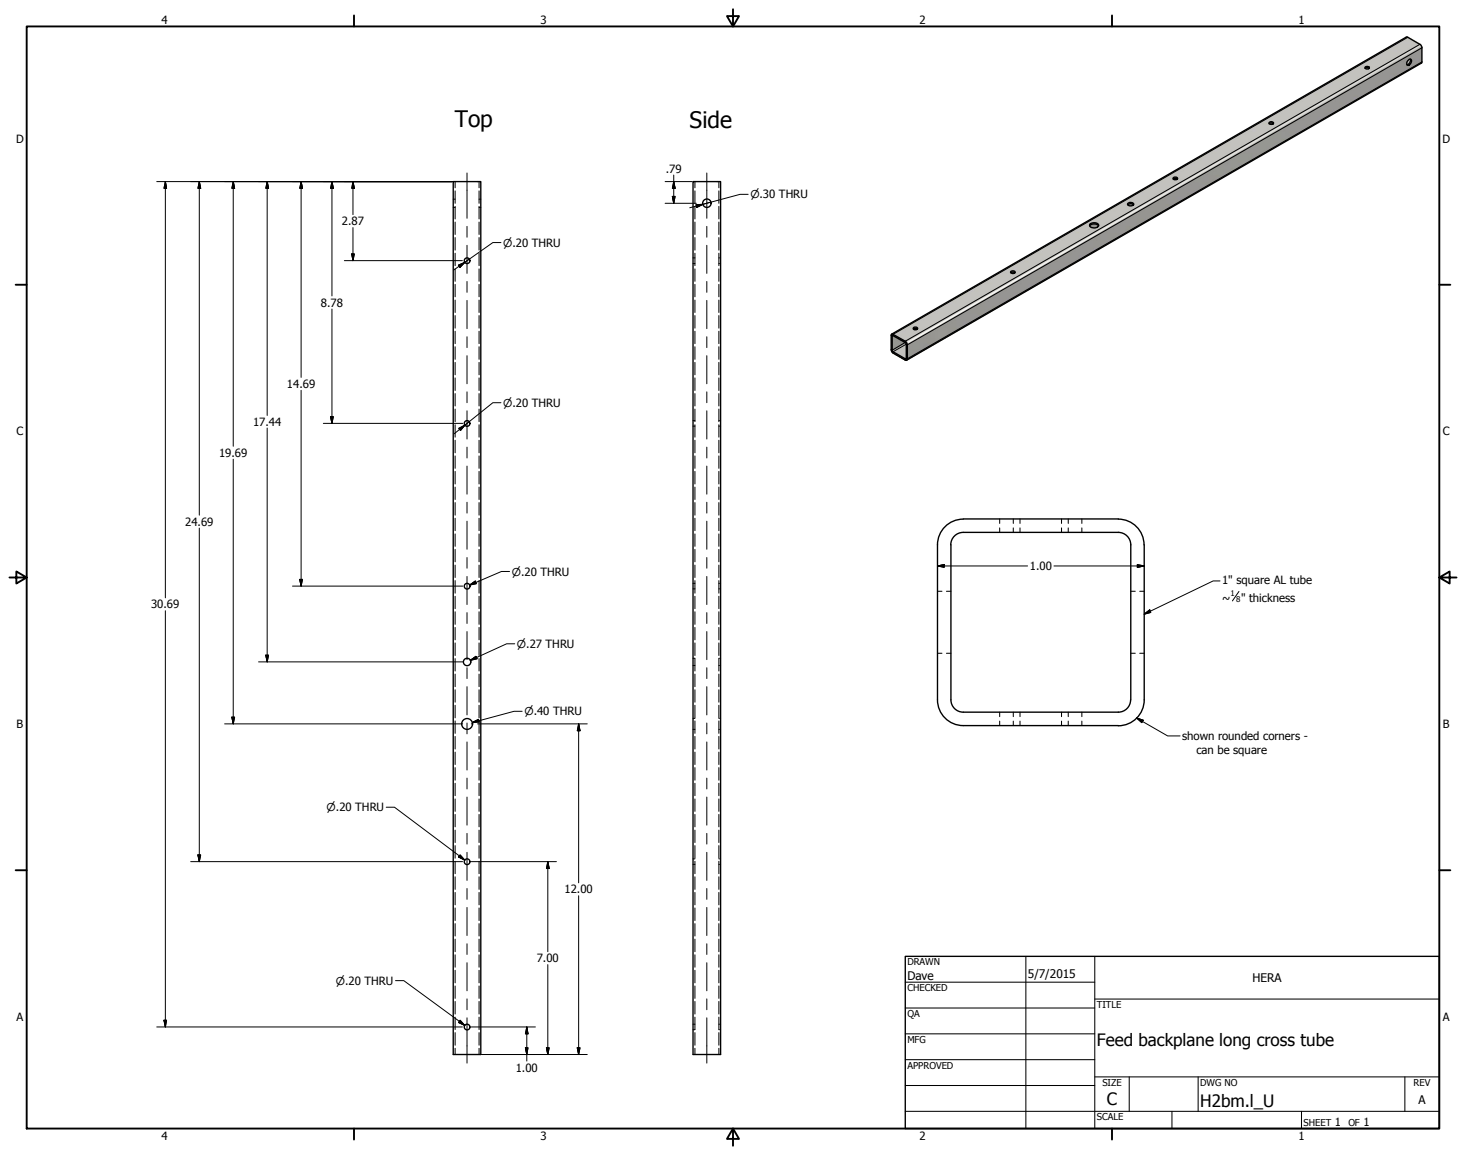
[picture p120: page 1]
SHEET 1 OF 1; DRAWN; CHECKED; MFG; APPROVED; Dave; DWG NO H2bm.l_U; SIZE C; SCALE; HERA; REV A; P.30 THRU; P.20 THRU; P.27 THRU; P.40 THRU; 8" thickness

1" square AL tube

shown rounded corners -
can be square

TITLE
Feed backplane long cross tube
