david-deboer/hera-cad/feed/H2bm-pA_a_bpPlate.pdf

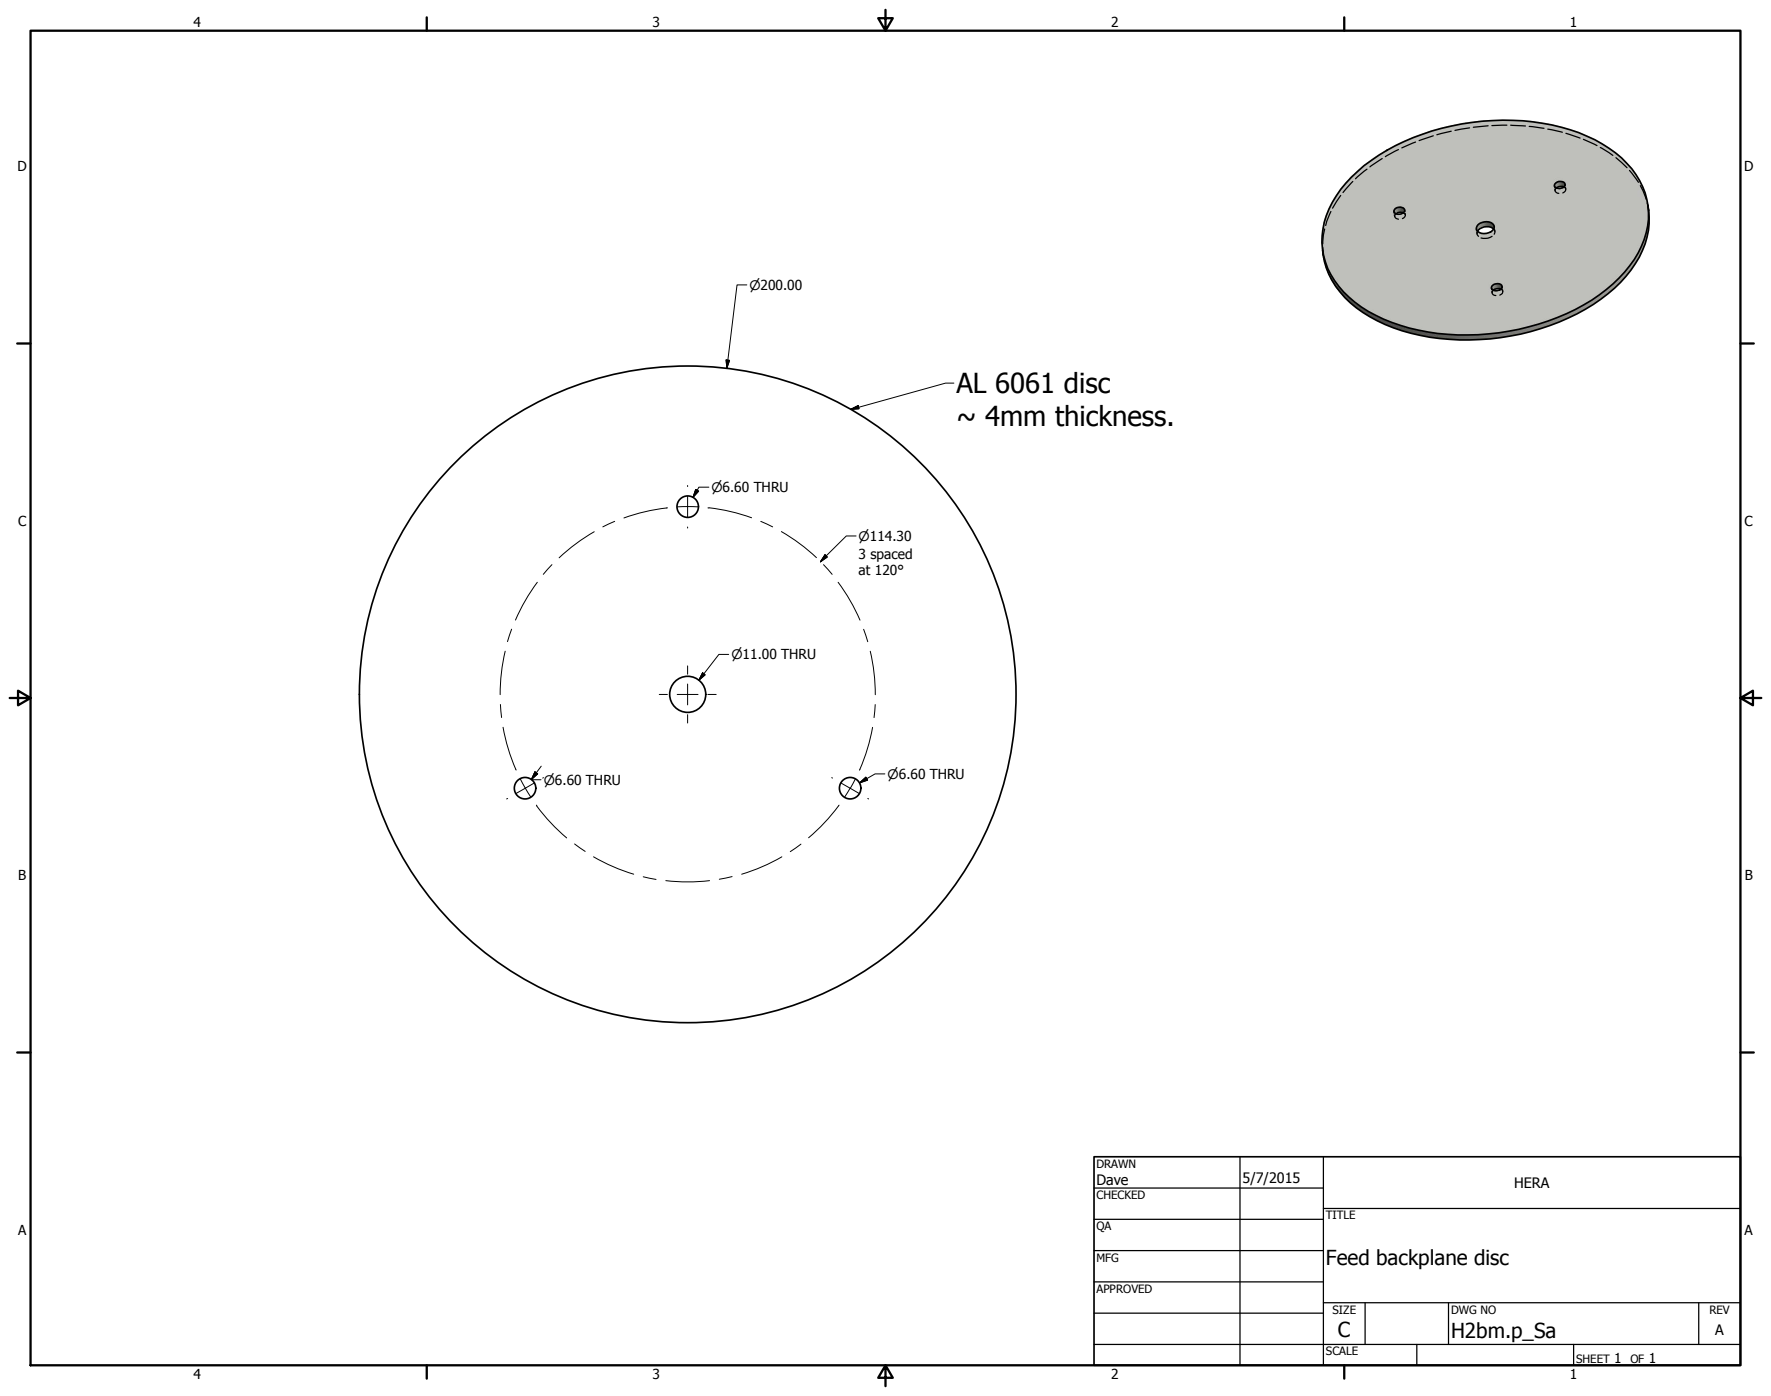
[picture p122: page 1]
SHEET 1 OF 1; DRAWN; CHECKED; MFG; APPROVED; Dave; DWG NO H2bm.p_Sa; TITLE; SIZE C; SCALE; HERA; REV A; P11.00 THRU; P6.60 THRU; AL 6061 disc ~ 4mm thickness.; 3 spaced at 120°

Feed backplane disc
