david-deboer/hera-cad/feed/H2bm-pAU_a_bpPlate.pdf

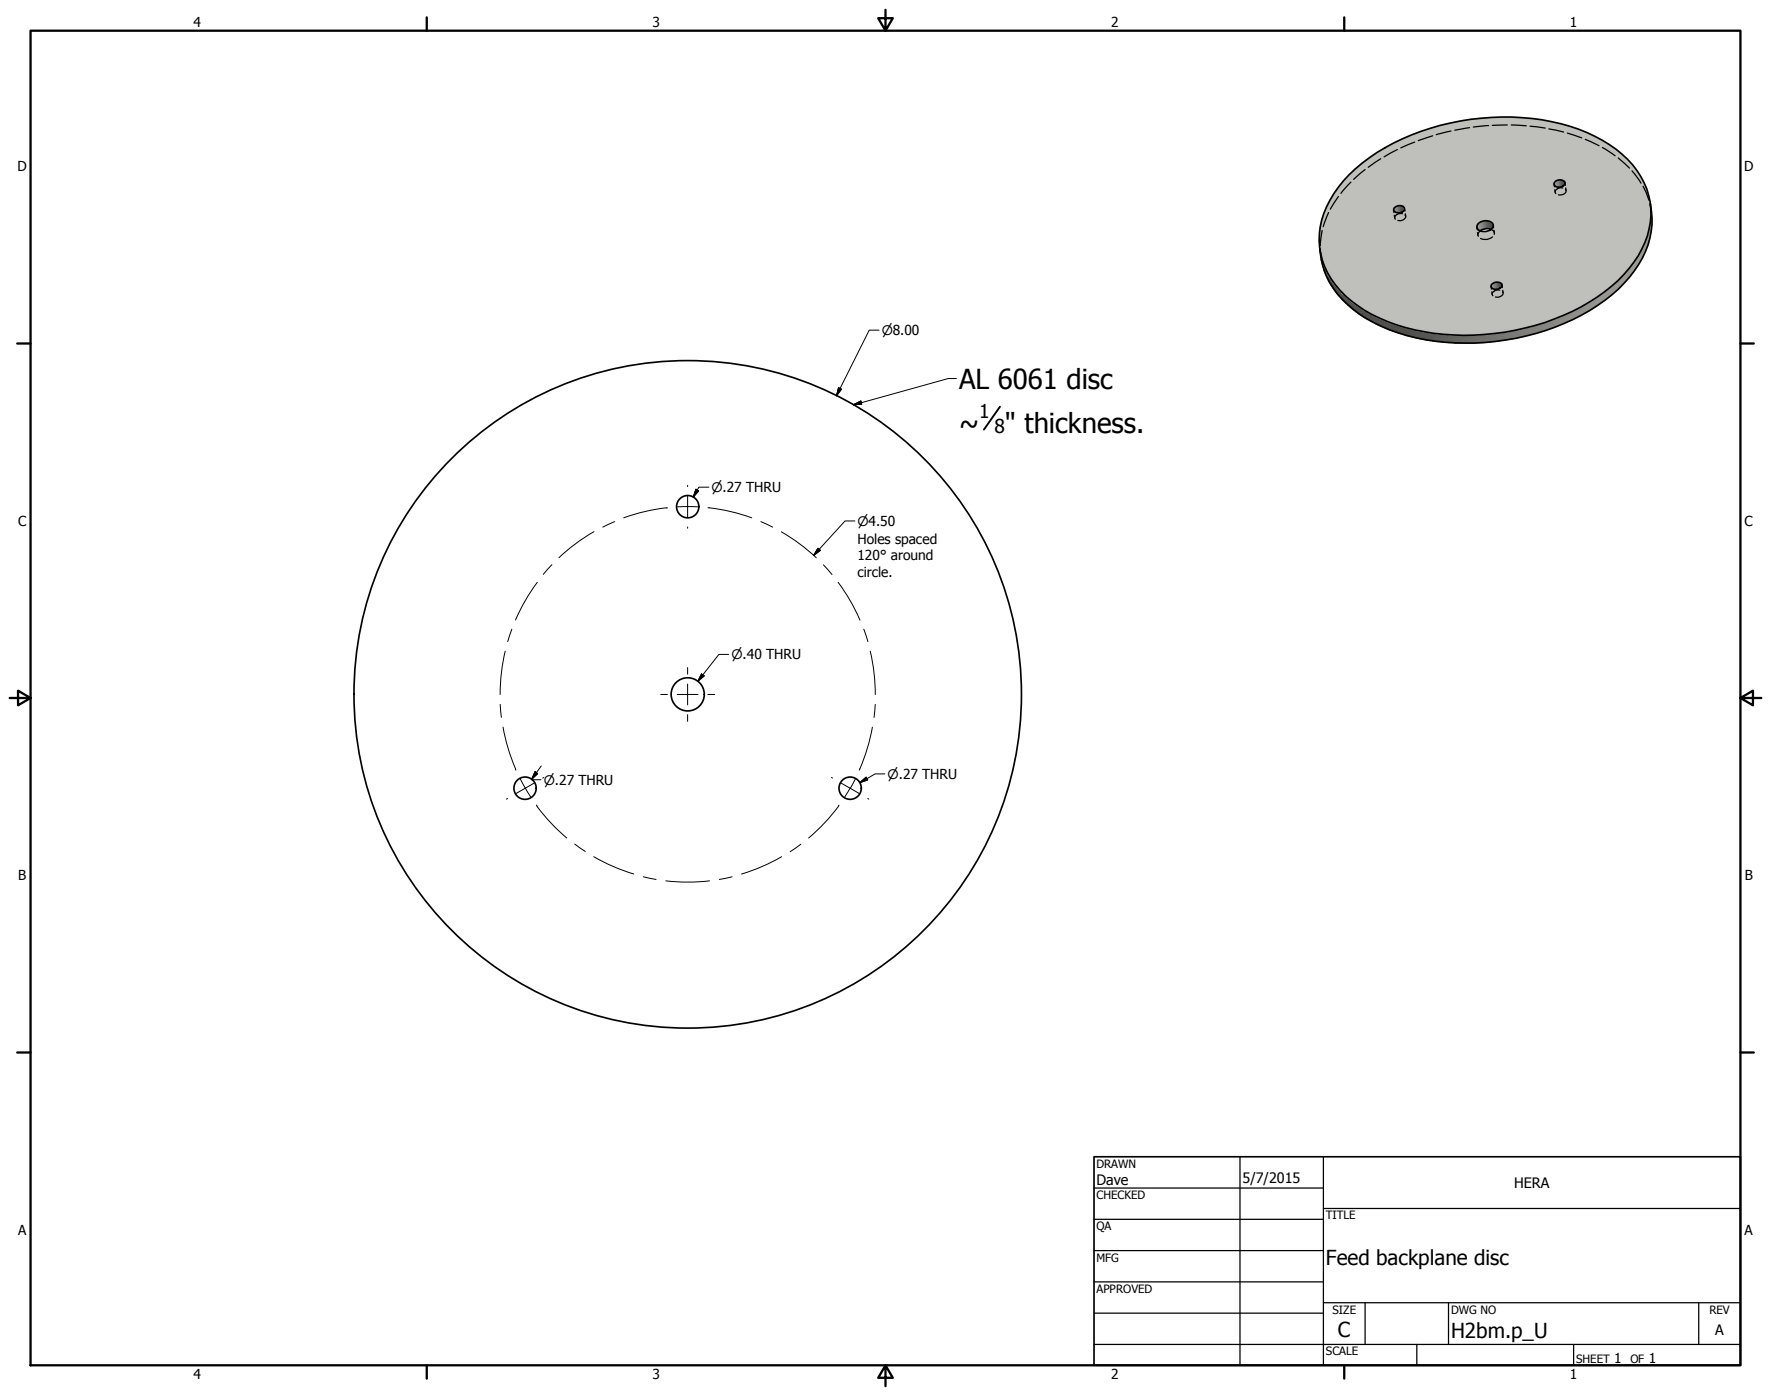
[picture p123: page 1]
SHEET 1 OF 1; DRAWN; CHECKED; MFG; APPROVED; Dave; DWG NO H2bm.p_U; TITLE; SIZE C; SCALE; HERA; REV A; P.40 THRU; P.27 THRU; Holes spaced 120° around circle.; AL 6061 disc; 8" thickness.

Feed backplane disc
