david-deboer/hera-cad/feed/H2bm-pB_a_bpPlate.pdf

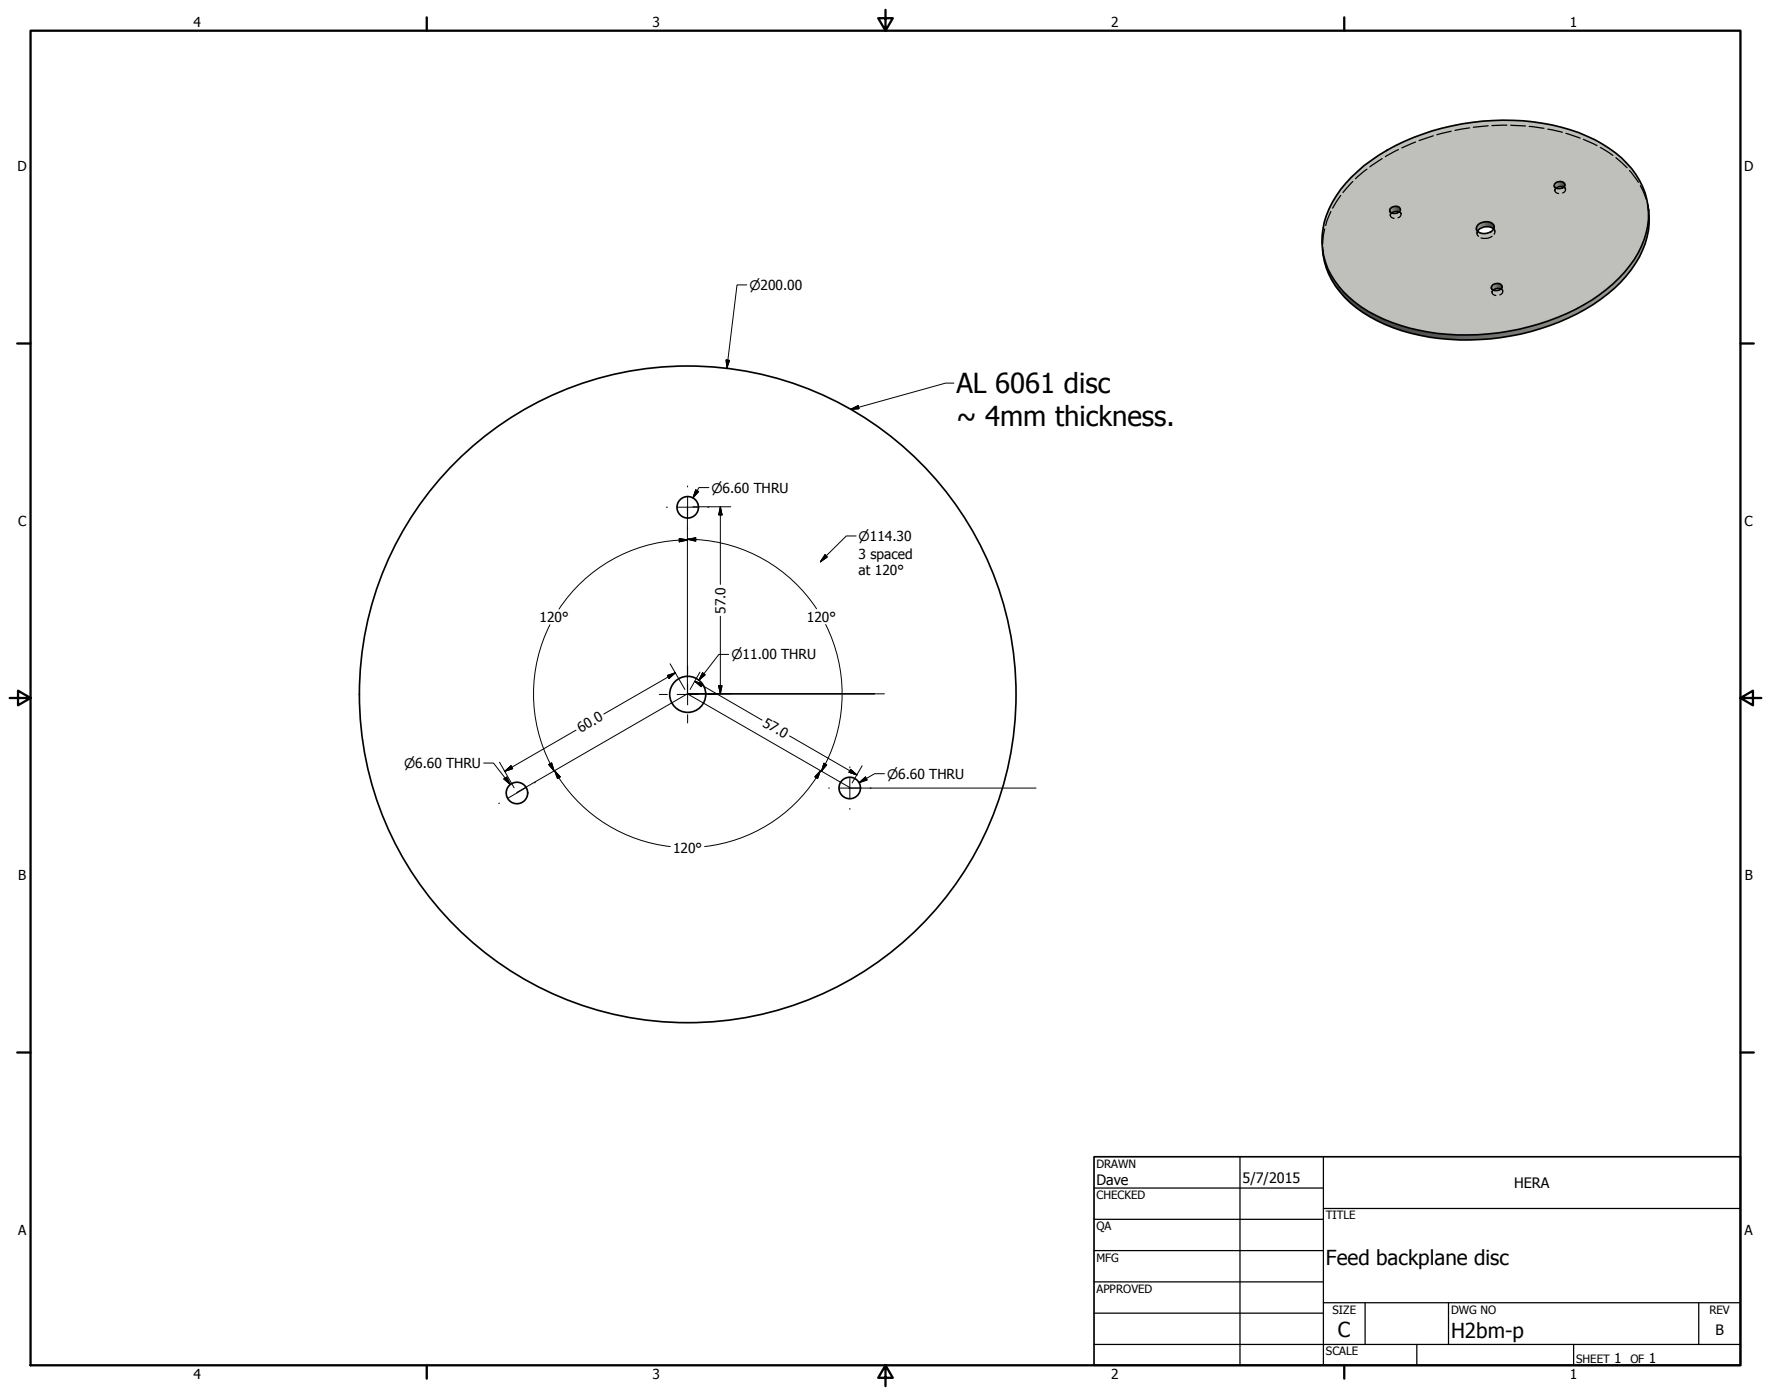
[picture p124: page 1]
SHEET 1 OF 1; DRAWN; CHECKED; MFG; APPROVED; Dave; DWG NO H2bm-p; TITLE; SIZE C; SCALE; HERA; REV B; P11.00 THRU; P6.60 THRU; AL 6061 disc ~ 4mm thickness.; 3 spaced at 120°

Feed backplane disc
