david-deboer/hera-cad/feed/H2bm-sA_a_bpSupInner2.pdf

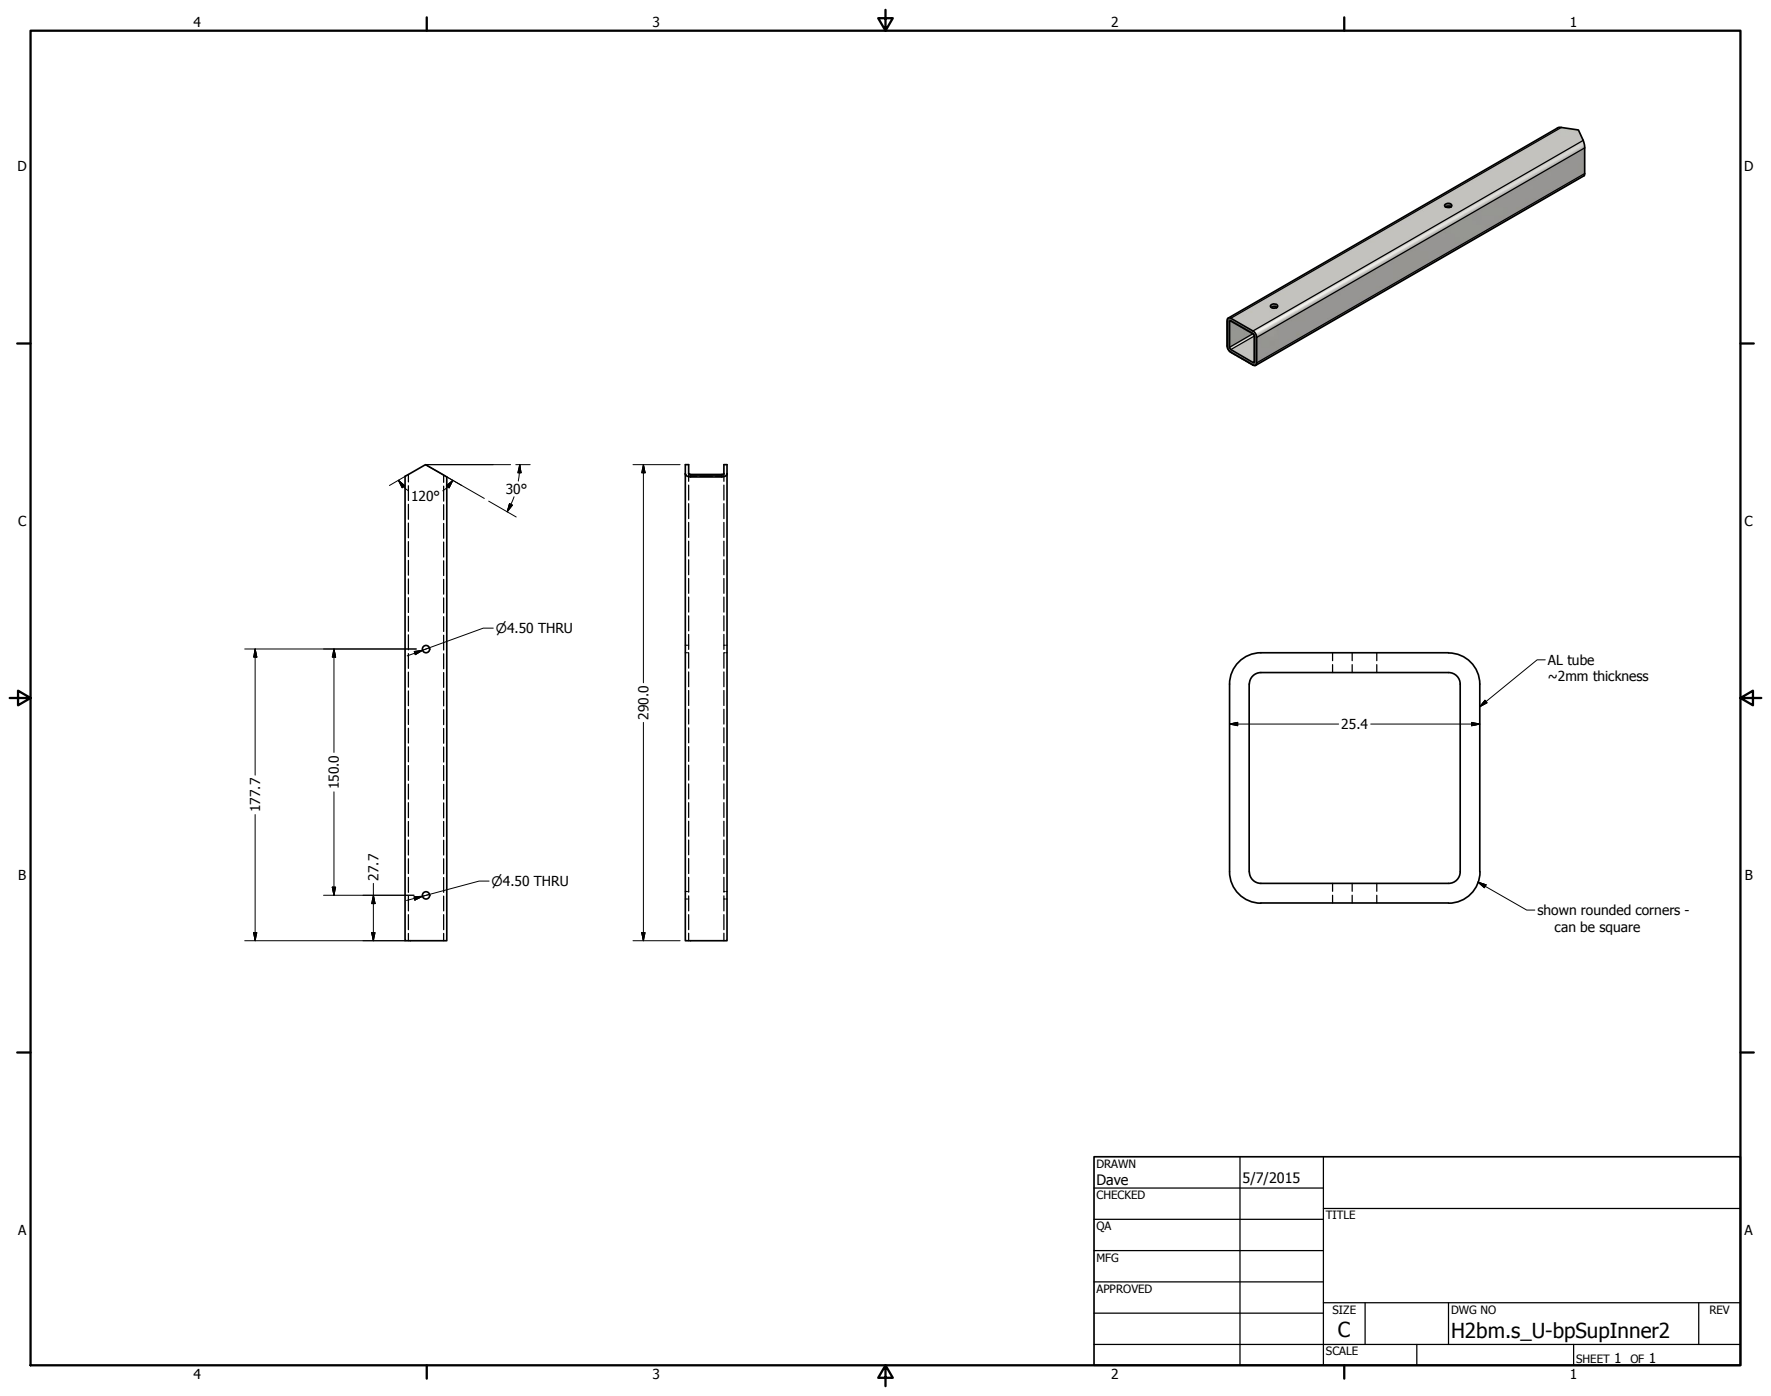
[picture p125: page 1]
SHEET 1 OF 1; DRAWN; CHECKED; MFG; APPROVED; Dave; DWG NO H2bm.s_U-bpSupInner2; TITLE; SIZE C; SCALE; REV; P4.50 THRU; AL tube ~2mm thickness

shown rounded corners -
can be square
