david-deboer/hera-cad/feed/H2bm-sAU_a_bpSupInner2.pdf

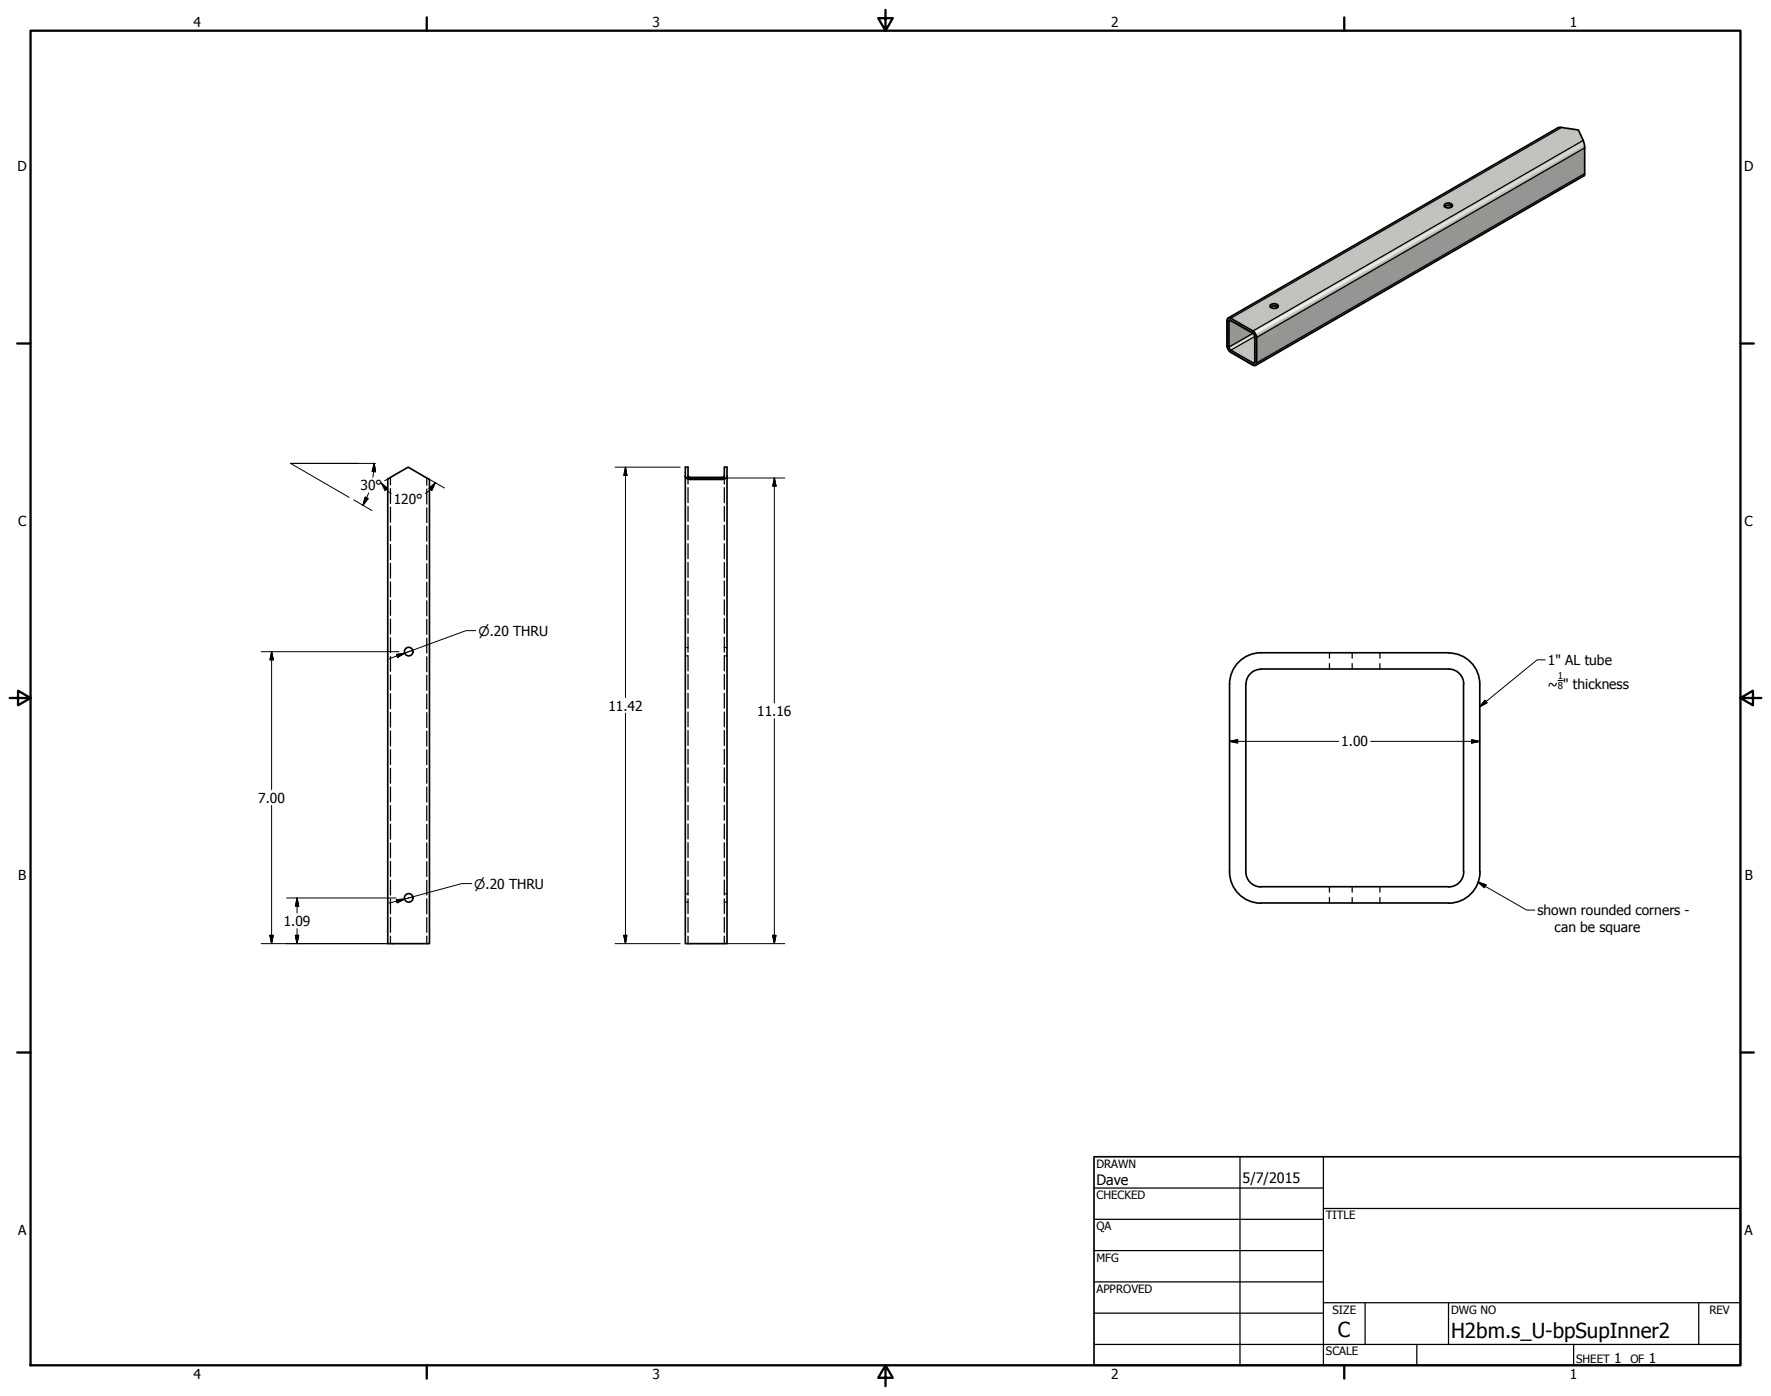
[picture p126: page 1]
SHEET 1 OF 1; DRAWN; CHECKED; MFG; APPROVED; Dave; DWG NO H2bm.s_U-bpSupInner2; TITLE; SIZE C; SCALE; REV; P.20 THRU; 1" AL tube; 1 8" thickness

shown rounded corners -
can be square
