david-deboer/hera-cad/feed/H2cAU_a_collar.pdf

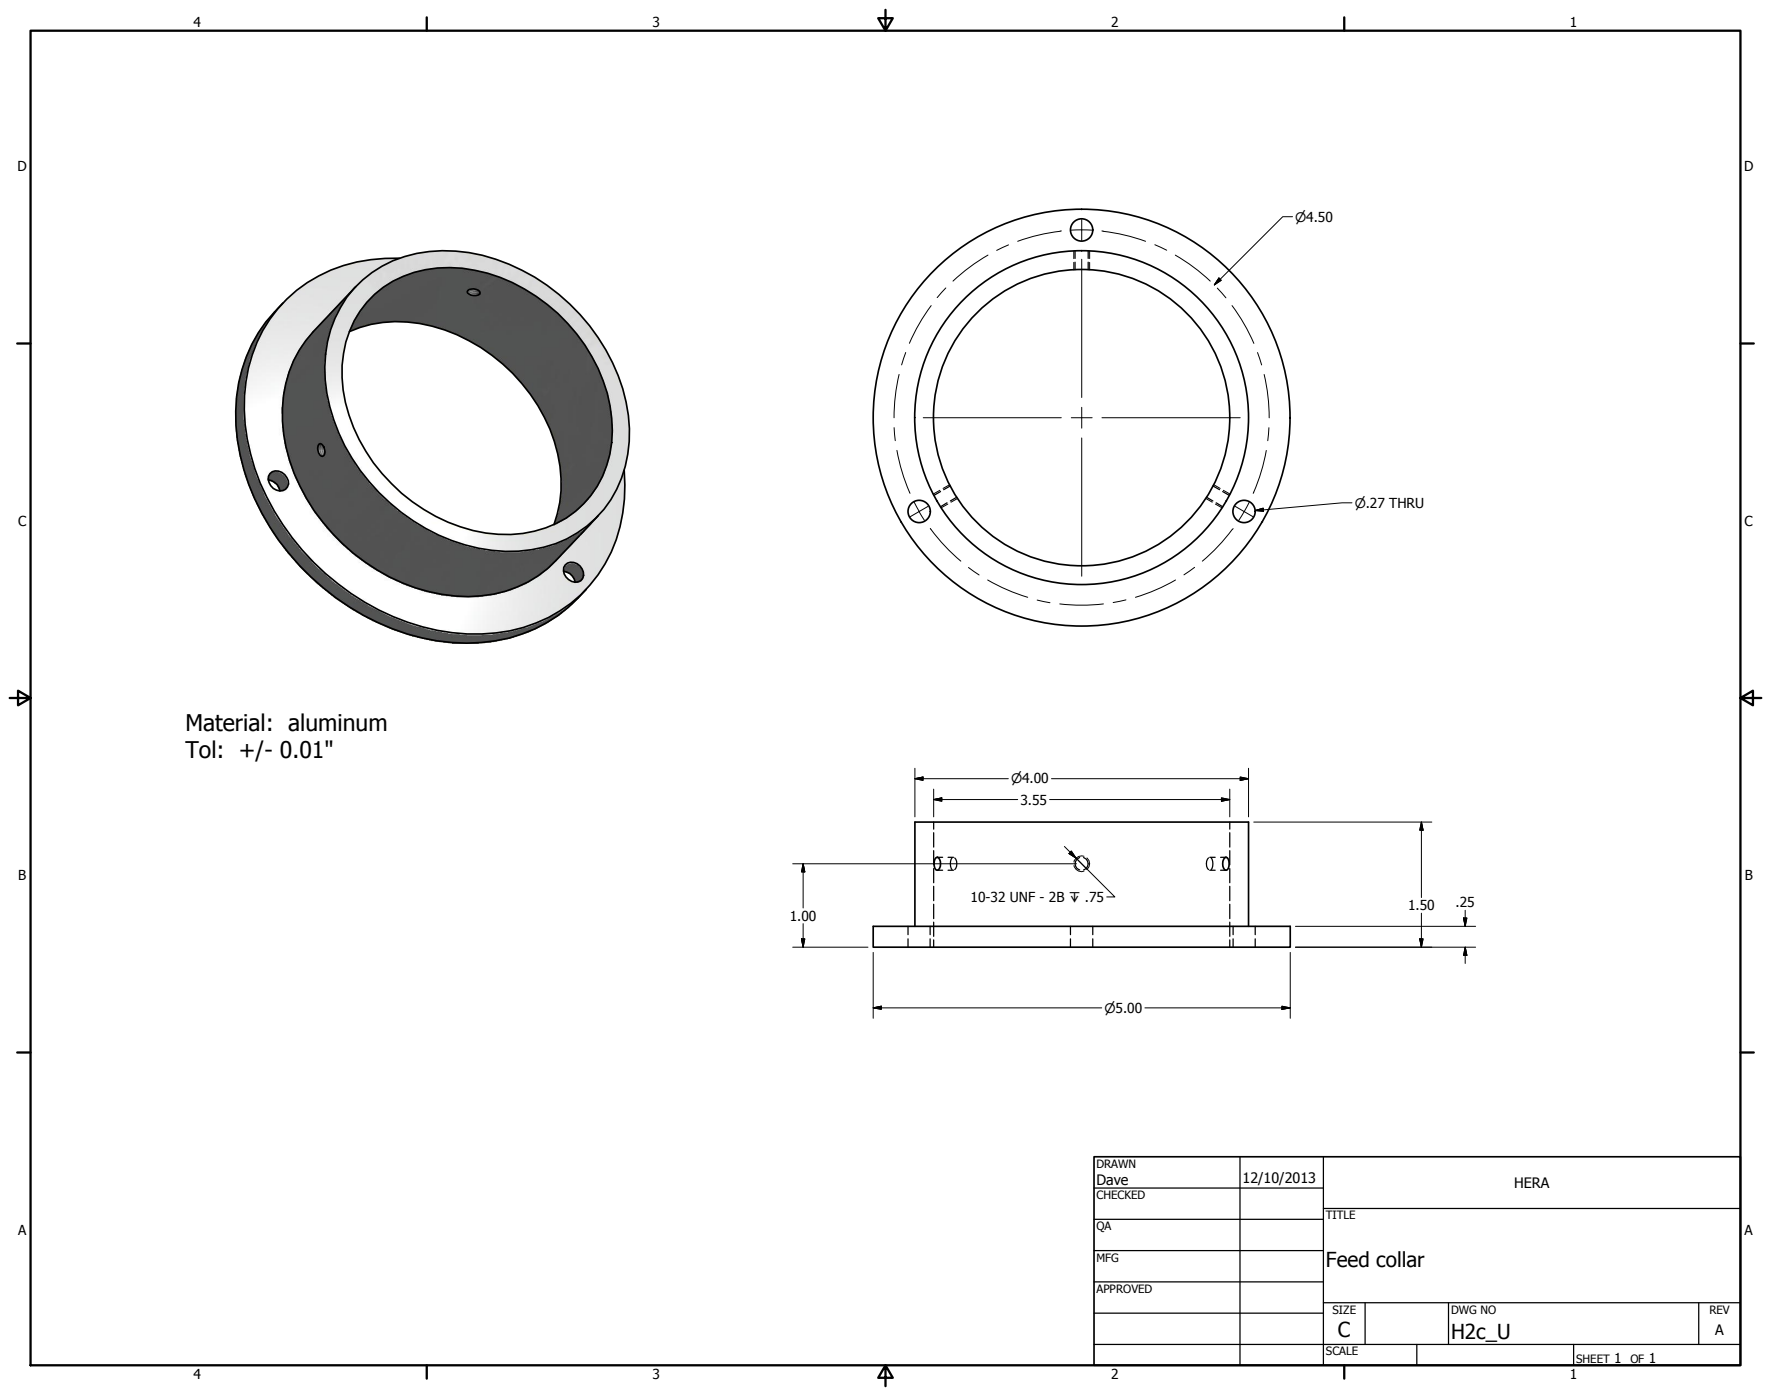
[picture p127: page 1]
SHEET 1 OF 1; DRAWN; CHECKED; MFG; APPROVED; Dave; DWG NO H2c_U; TITLE; Feed collar; SIZE C; SCALE; HERA; REV A; 10-32 UNF - 2B Z .75; Material: aluminum Tol: +/- 0.01"; P.27 THRU
