david-deboer/hera-cad/feed/H2cB_a_collar.pdf

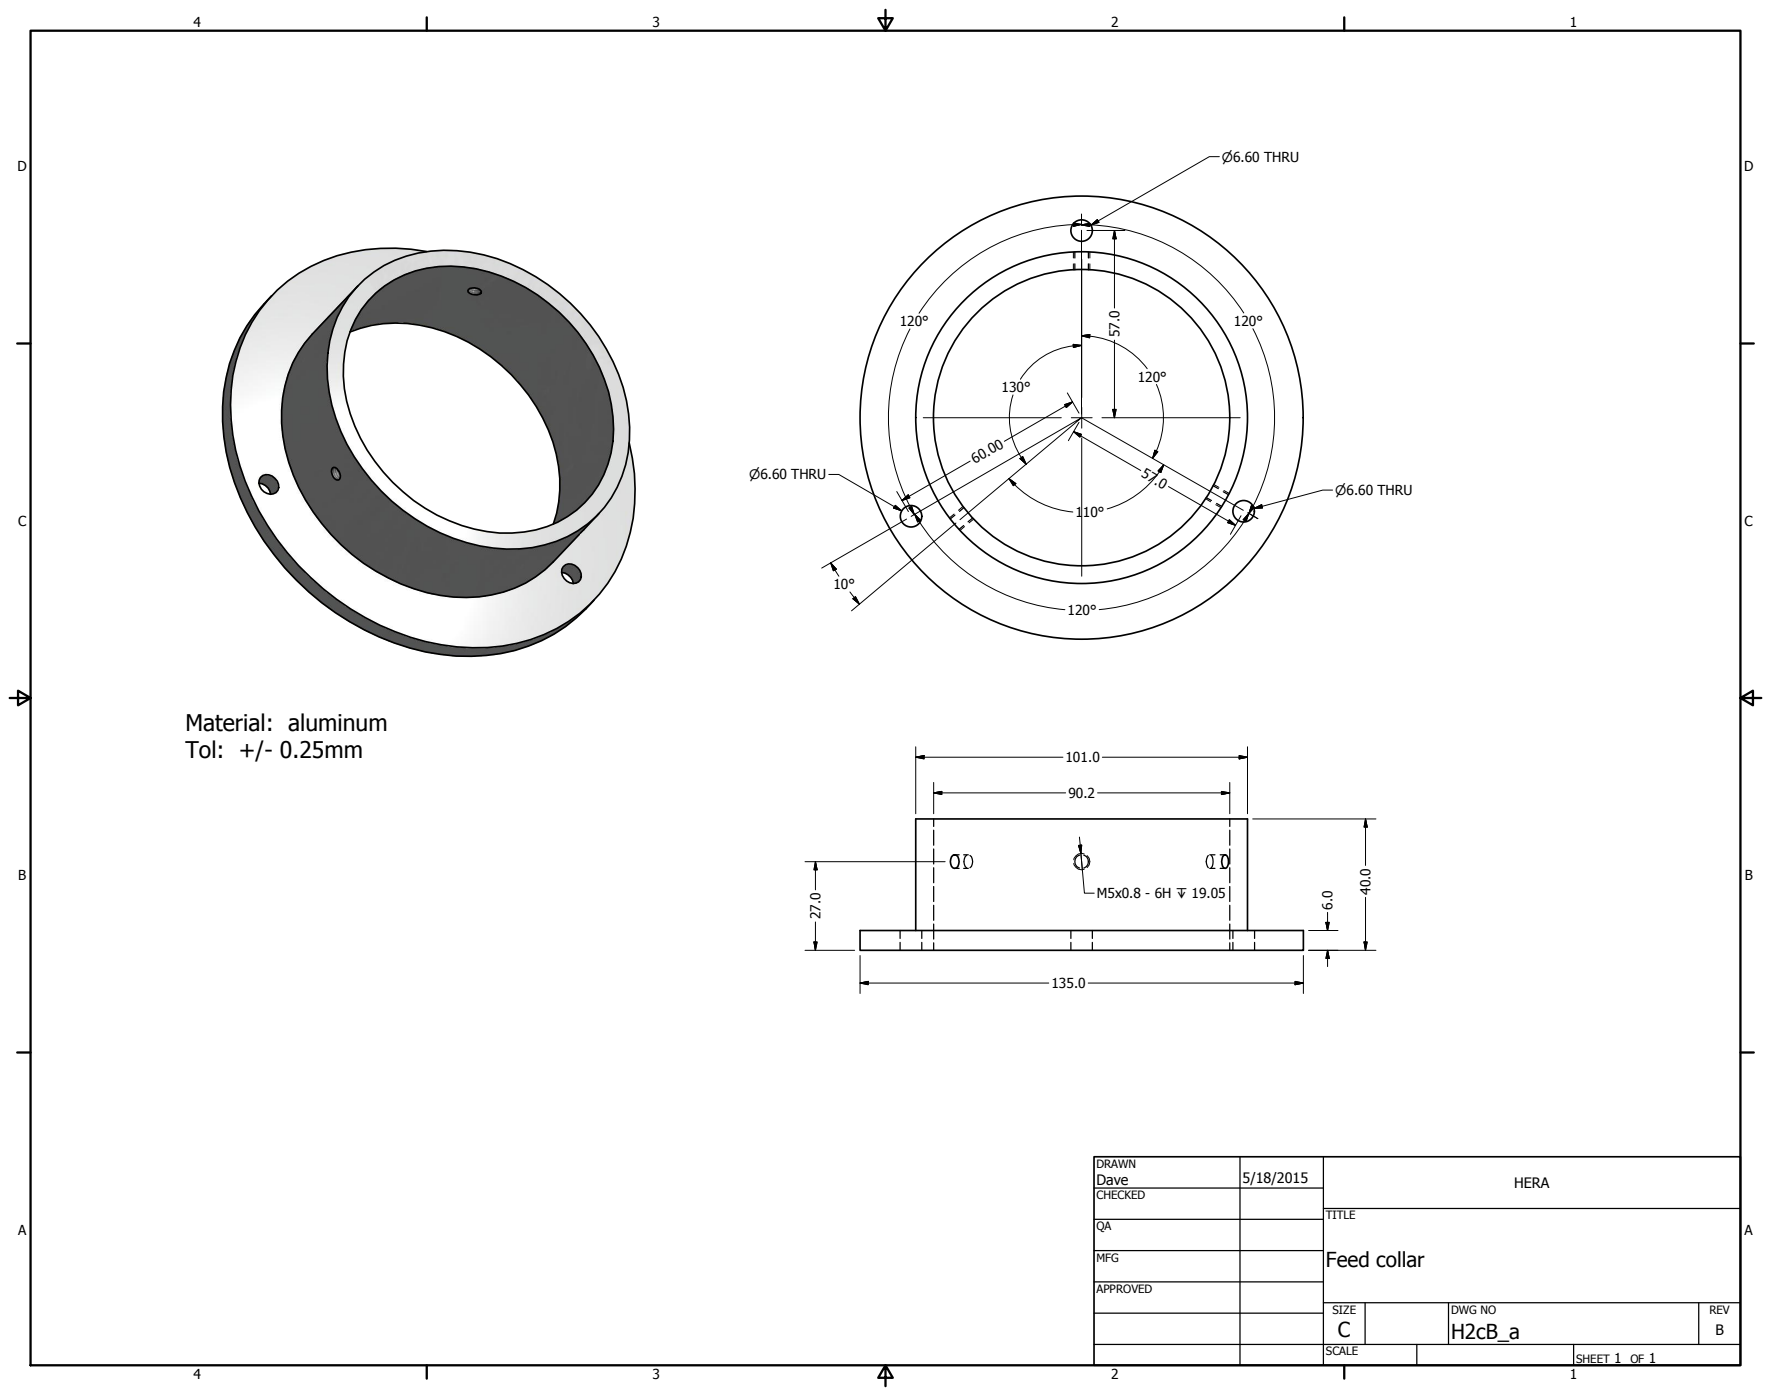
[picture p128: page 1]
SHEET 1 OF 1; DRAWN; CHECKED; MFG; APPROVED; Dave; DWG NO H2cB_a; TITLE; Feed collar; SIZE C; SCALE; HERA; REV B; Material: aluminum; Tol: +/- 0.25mm; P6.60 THRU
