david-deboer/hera-cad/surface/H1rAU_a_spars-US.pdf

# end A

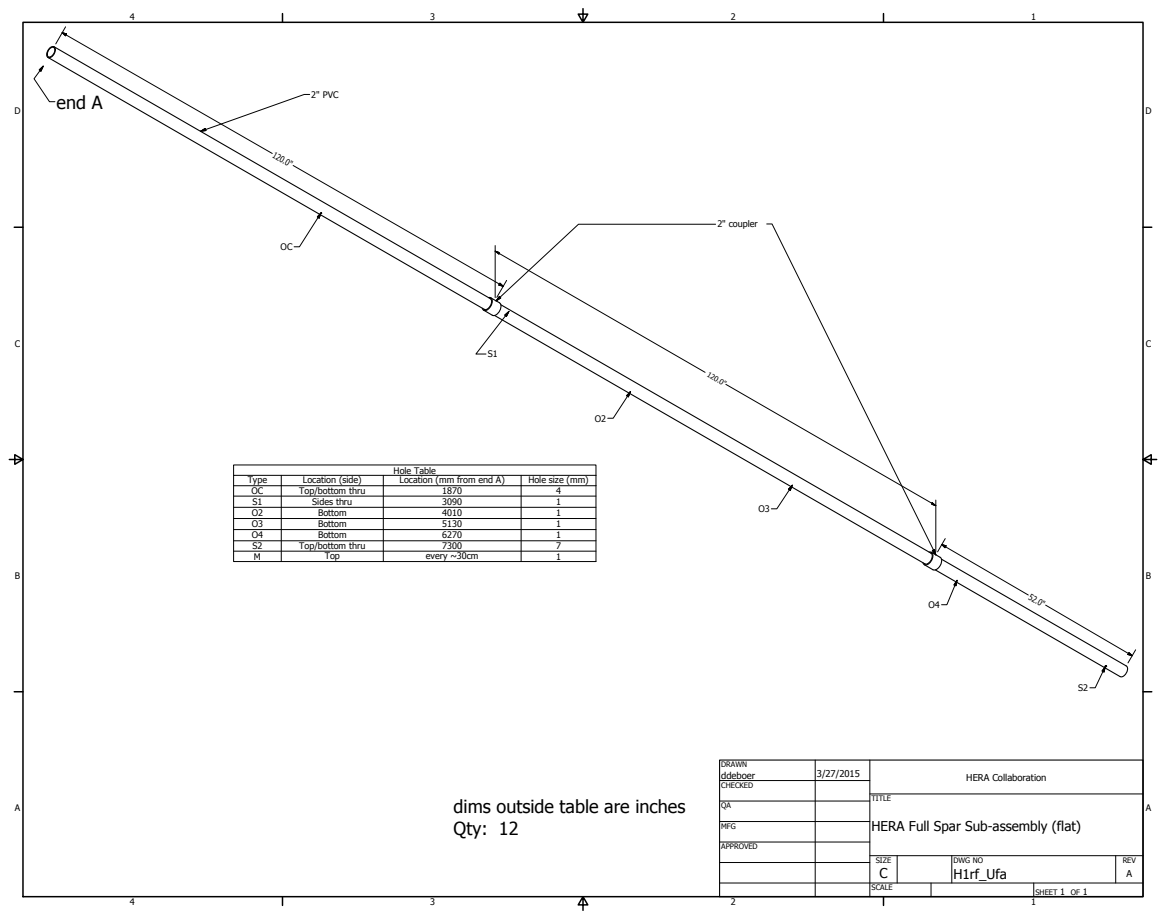
[picture p129: page 1]
SHEET 1 OF 1; DRAWN; CHECKED; MFG; APPROVED; ddeboer; DWG NO H1rf_Ufa; SIZE C; SCALE; HERA Collaboration; REV A; Hole Table; Type; Location (side); Location (mm from end A); Hole size (mm); Top/bottom thru; Sides thru; Bottom; Top; every ~30cm; 2" PVC; 2" coupler

dims outside table are inches
Qty: 12

TITLE
HERA Full Spar Sub-assembly (flat)

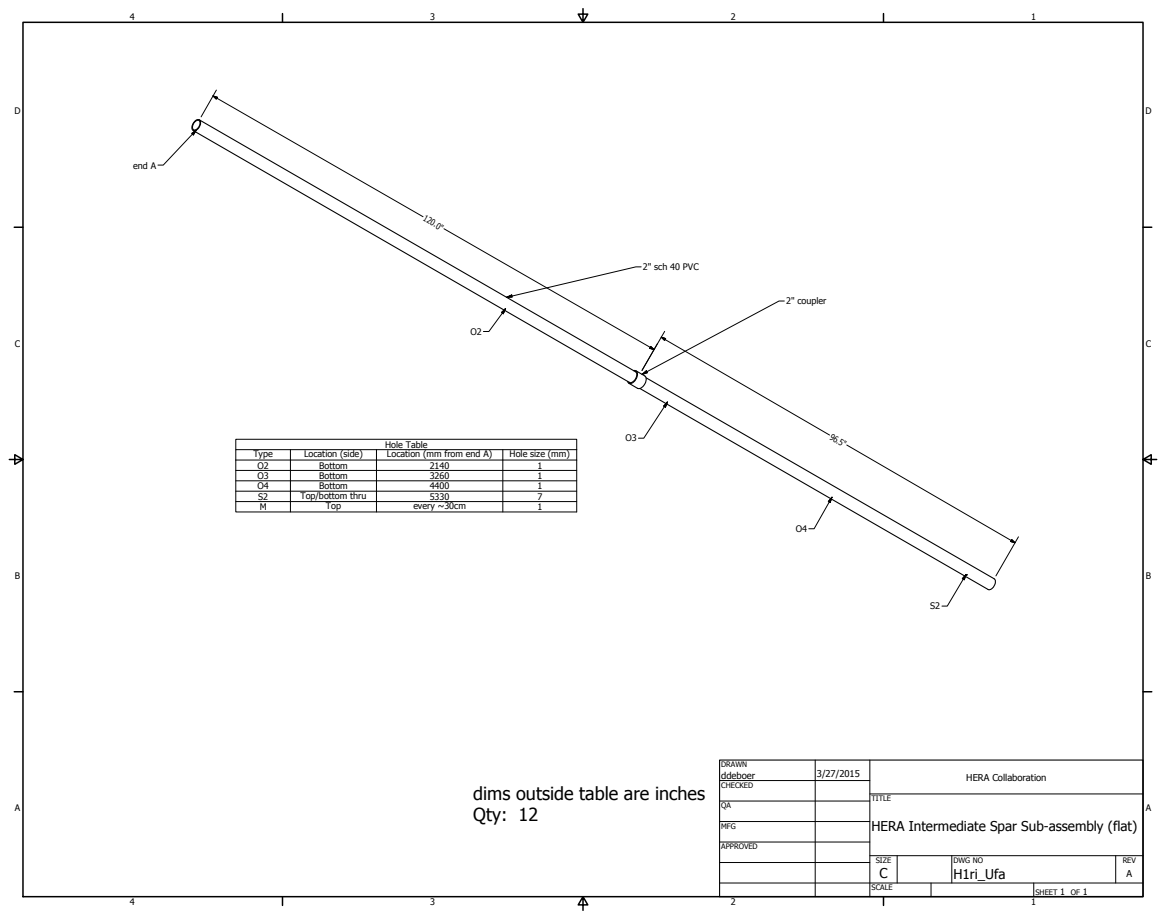
[picture p130: page 2]
DRAWN; CHECKED; MFG; ddeboer; H1ri_Ufa; HERA Collaboration; Hole Table; Type; Location (side); Location (mm from end A); Hole size (mm); Bottom; Top/bottom thru; Top; every ~30cm; 2" coupler; 2" sch 40 PVC; end A

dims outside table are inches
Qty: 12

TITLE
HERA Intermediate Spar Sub-assembly (flat)

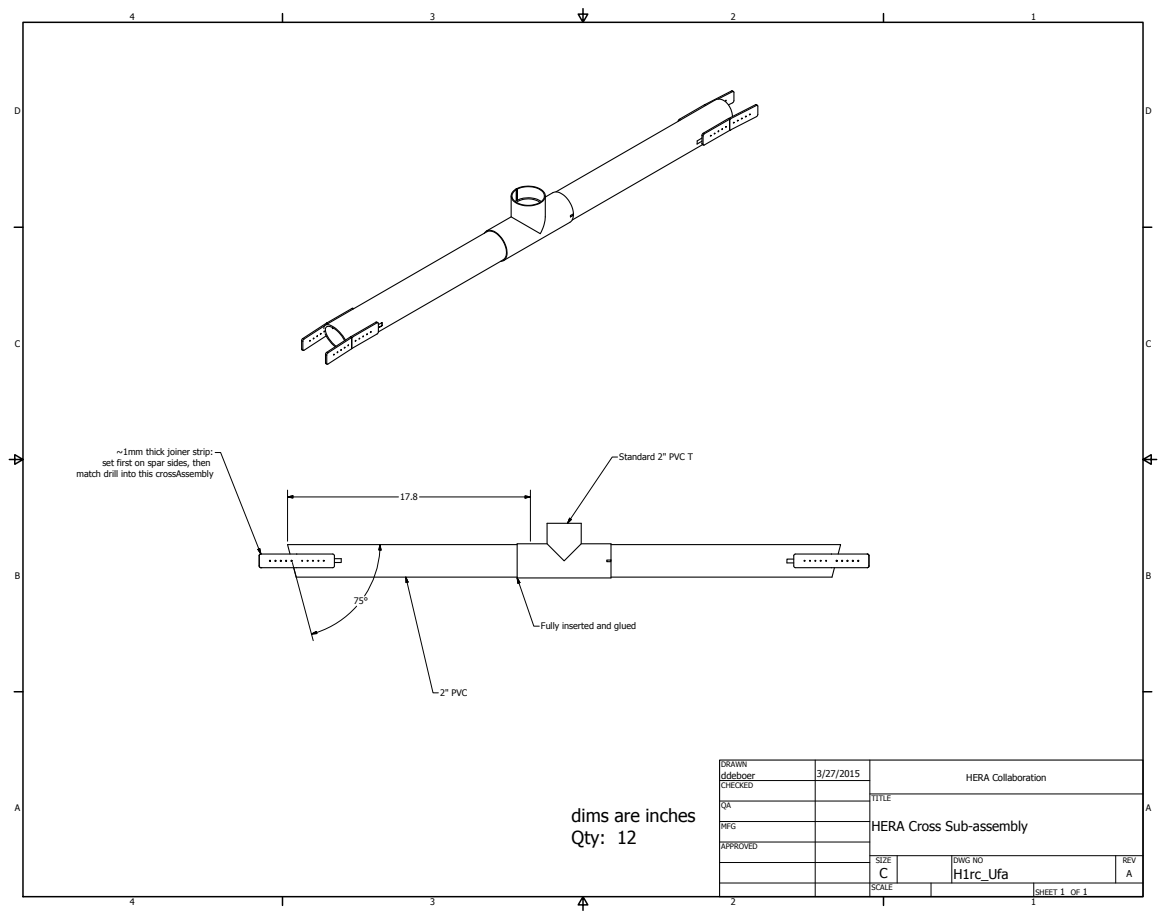
[picture p131: page 3]
DRAWN; CHECKED; MFG; ddeboer; H1rc_Ufa; HERA Collaboration; Standard 2" PVC T; 2" PVC

~1mm thick joiner strip:
set first on spar sides, then
match drill into this crossAssembly

Fully inserted and glued

TITLE
HERA Cross Sub-assembly

dims are inches
Qty: 12
