david-deboer/hera-cad/support/H1pr-sA_a_rimIntermediateSparHolder.pdf

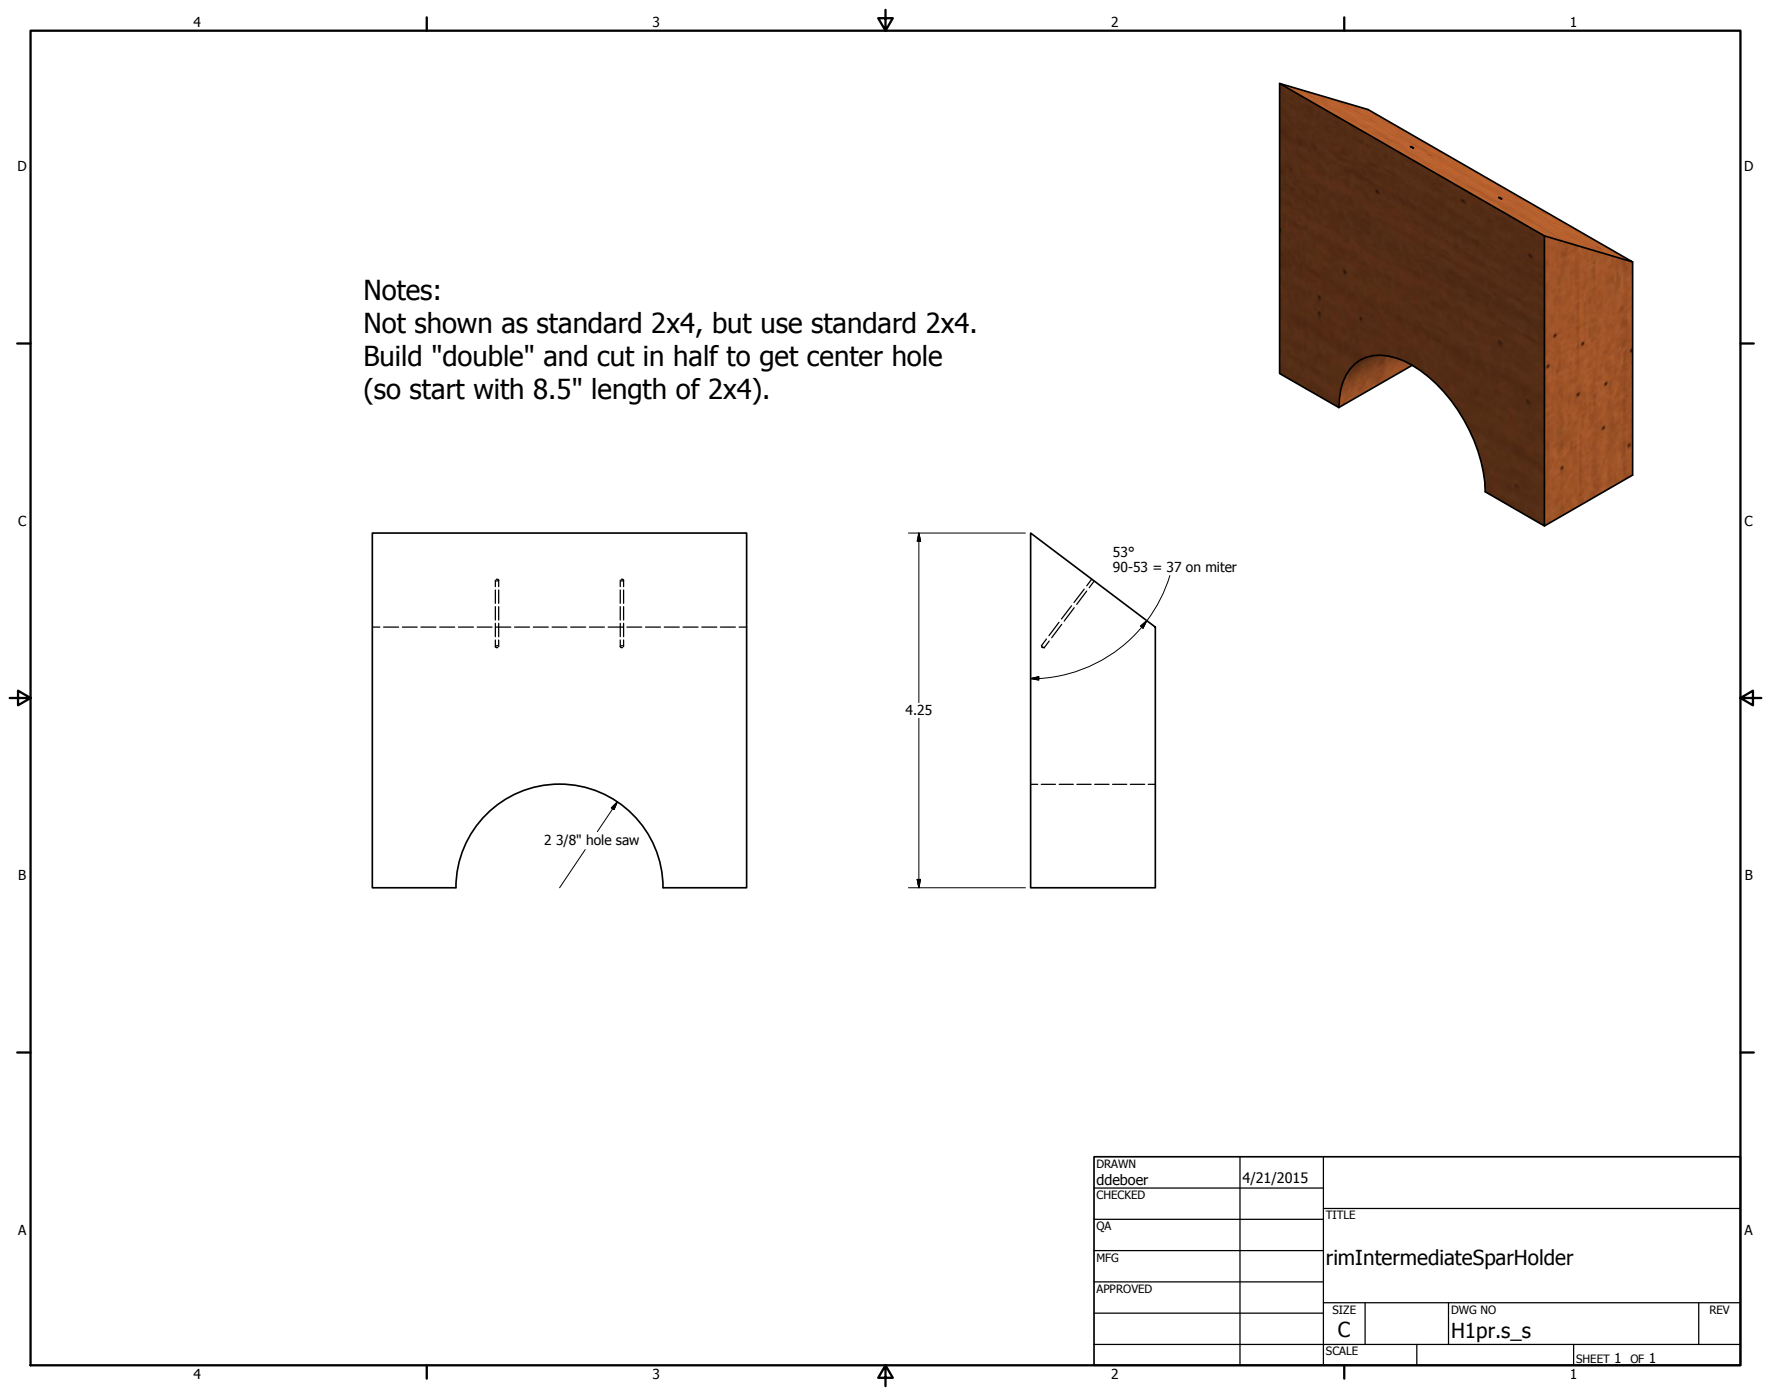
[picture p132: page 1]
SHEET 1 OF 1; DRAWN; CHECKED; MFG; APPROVED; ddeboer; DWG NO H1pr.s_s; TITLE; rimIntermediateSparHolder; SIZE C; SCALE; REV; 53° 90-53 = 37 on miter; 2 3/8" hole saw

Notes:
Not shown as standard 2x4, but use standard 2x4.
Build "double" and cut in half to get center hole
(so start with 8.5" length of 2x4).
