david-deboer/hera-cad/support/H1po-mA_a_overlapStrips.pdf

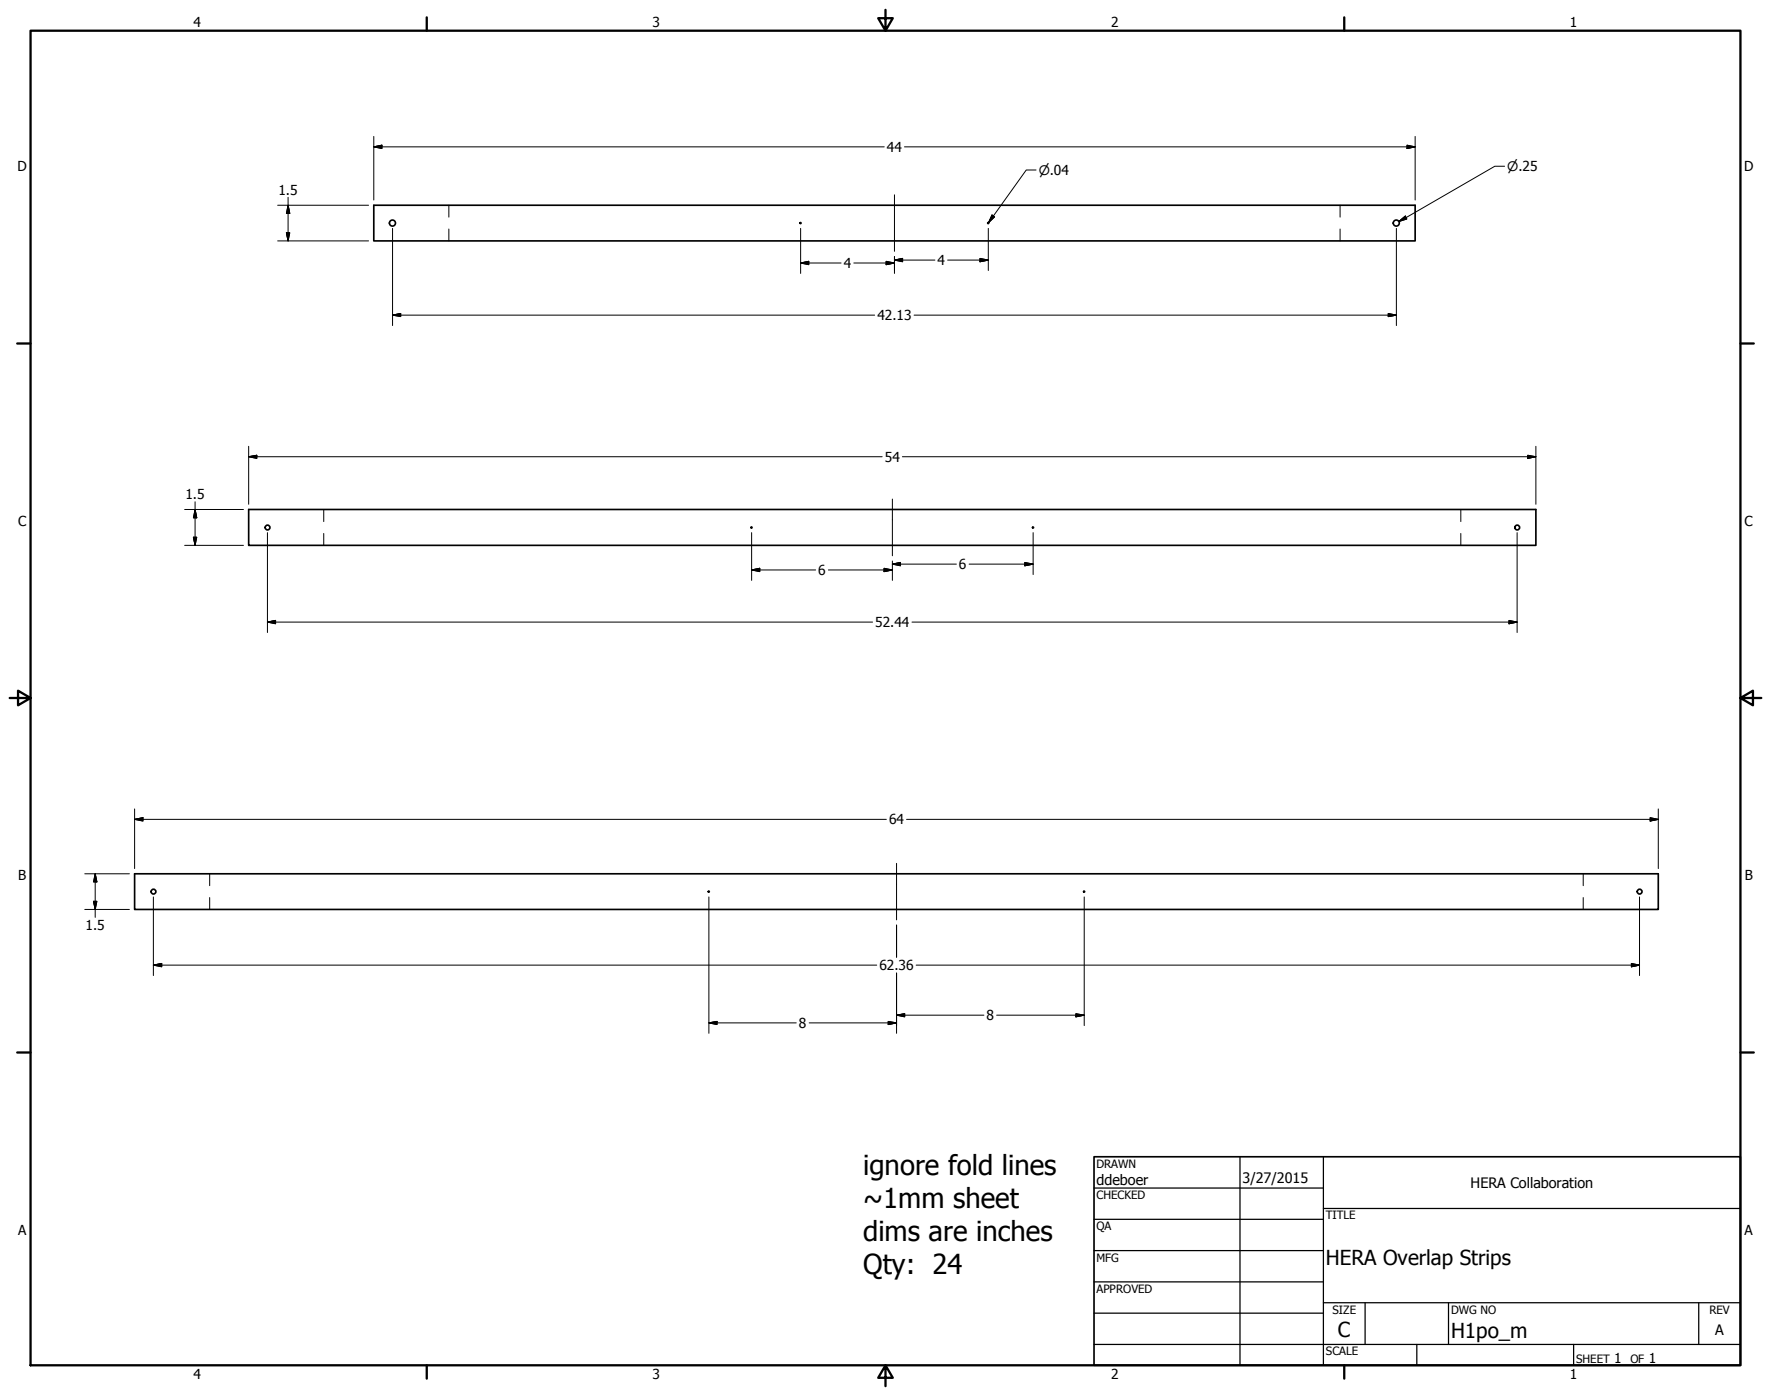
[picture p133: page 1]
SHEET 1 OF 1; DRAWN; CHECKED; MFG; APPROVED; ddeboer; DWG NO H1po_m; TITLE; SIZE C; SCALE; HERA Collaboration; REV A

ignore fold lines
~1mm sheet
dims are inches
Qty: 24

HERA Overlap Strips
