david-deboer/hera-cad/elementOverview.pdf

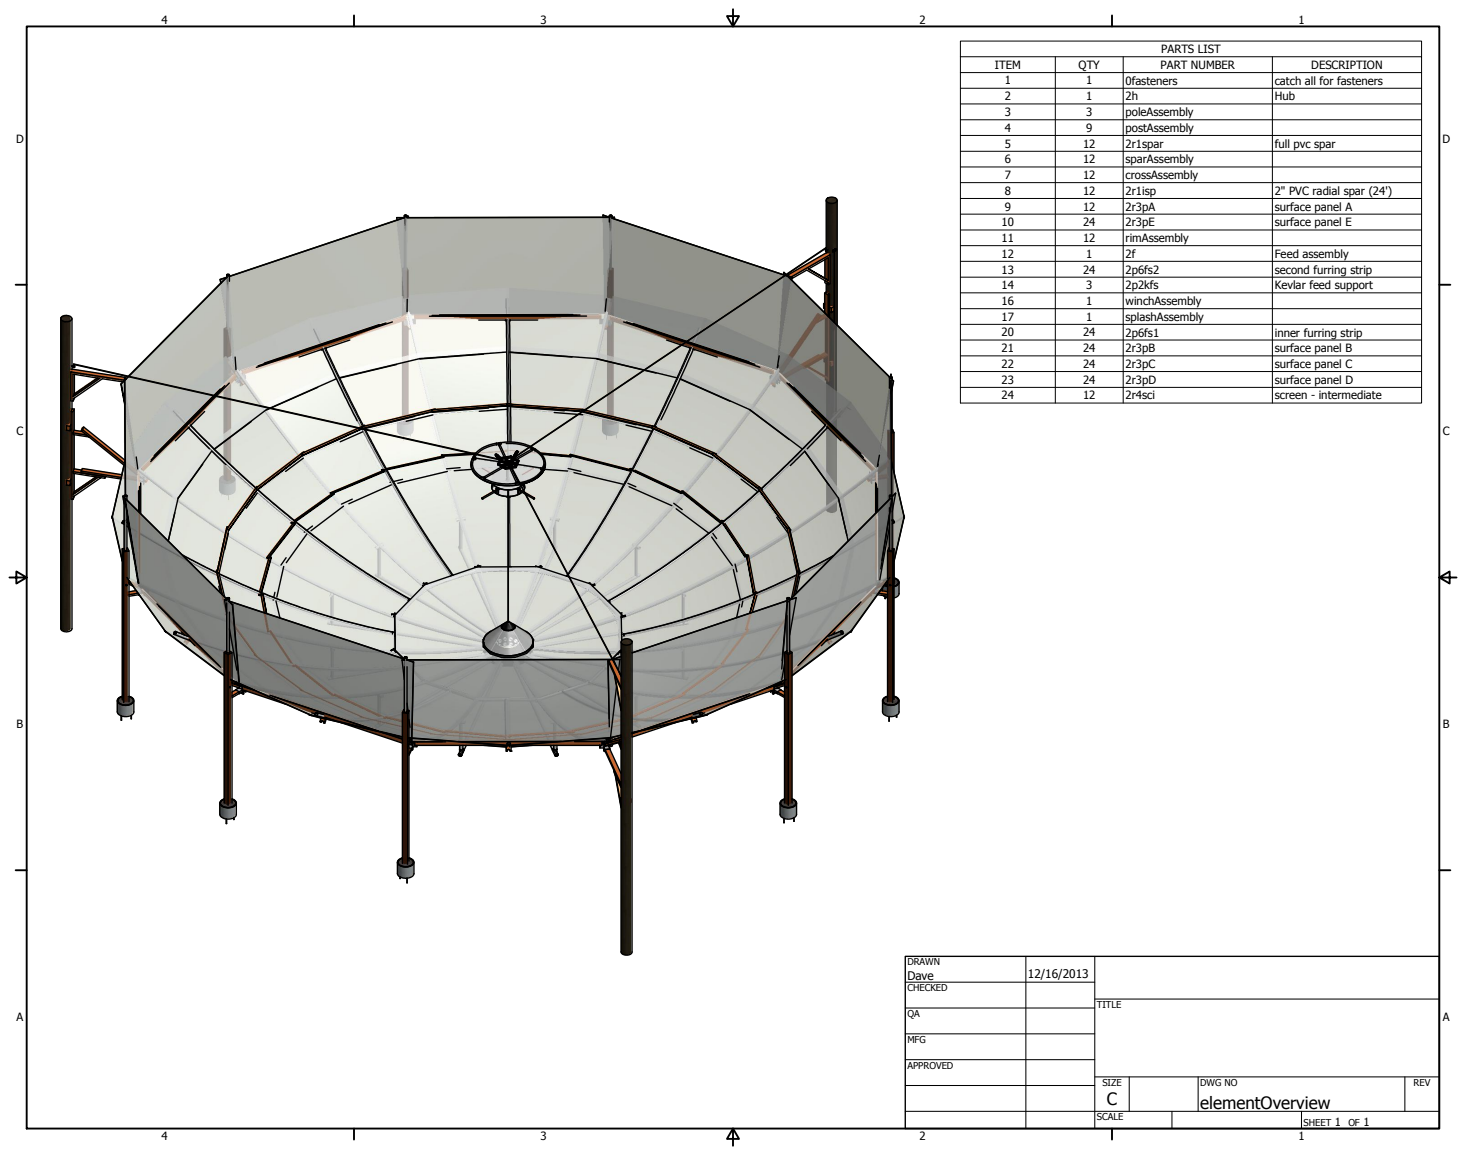
[picture p134: page 1]
all fo; ole; bly; ull p; kfs; vla; pla; ele
