david-deboer/hera-cad/feed/H2bAU_a_pSupAssembly.pdf

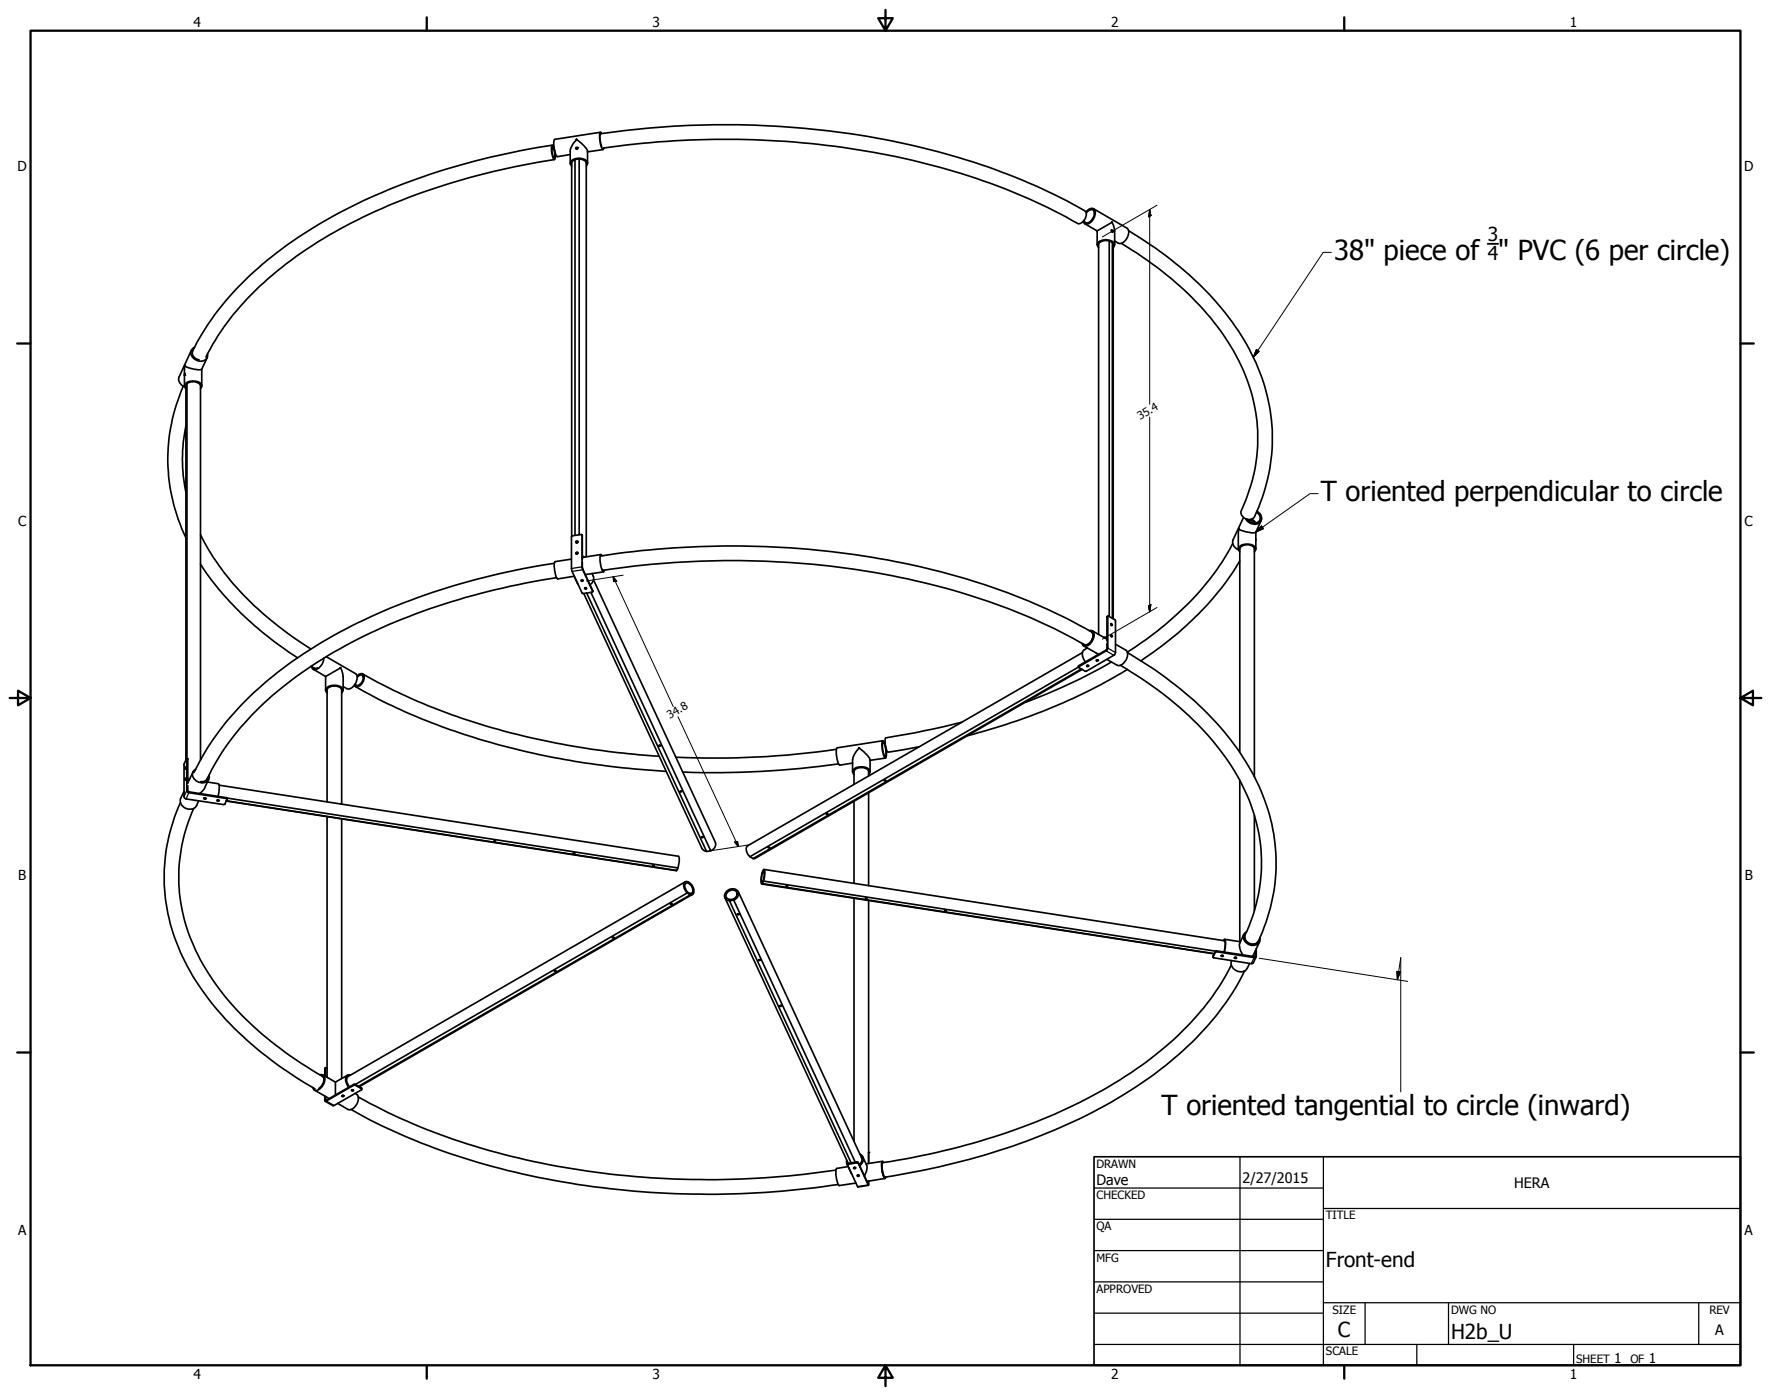
[picture p135: page 1]
SHEET 1 OF 1; DRAWN; CHECKED; MFG; APPROVED; Dave; DWG NO H2b_U; TITLE; Front-end; SIZE C; SCALE; HERA; REV A; 38" piece of

4" PVC (6 per circle)

T oriented perpendicular to circle

T oriented tangential to circle (inward)
