david-deboer/hera-cad/PDFs/Element/Feed/feedAssembly2.pdf

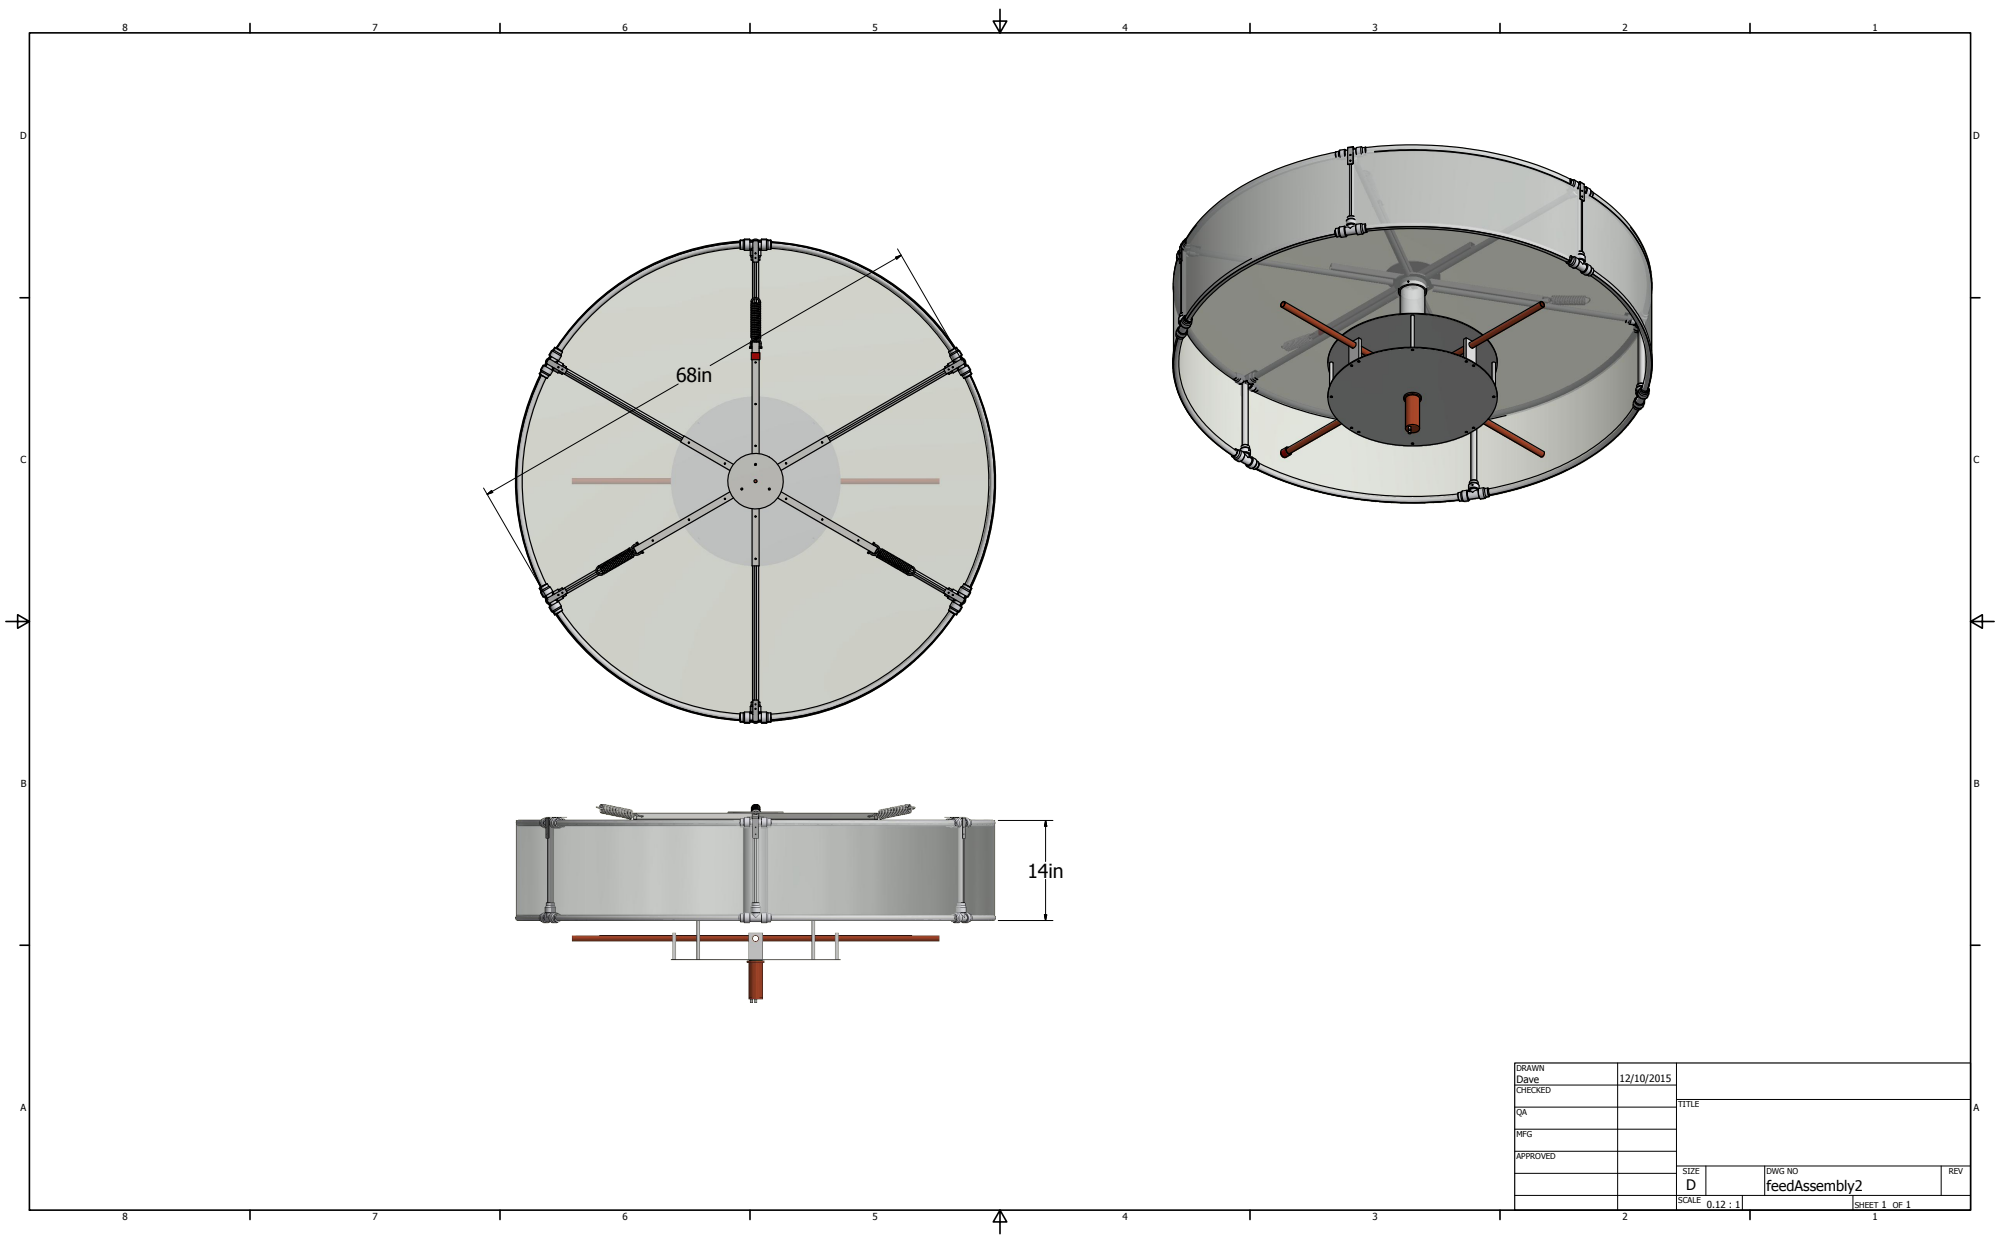
[picture p136: page 1]
SHEET 1 OF 1; DRAWN; CHECKED; MFG; APPROVED; Dave; DWG NO feedAssembly2; TITLE; SIZE D; SCALE; REV
