david-deboer/hera-cad/Node/Concept-ICTS/ICTS-20170411/ssl-version/panel_waveguide.pdf

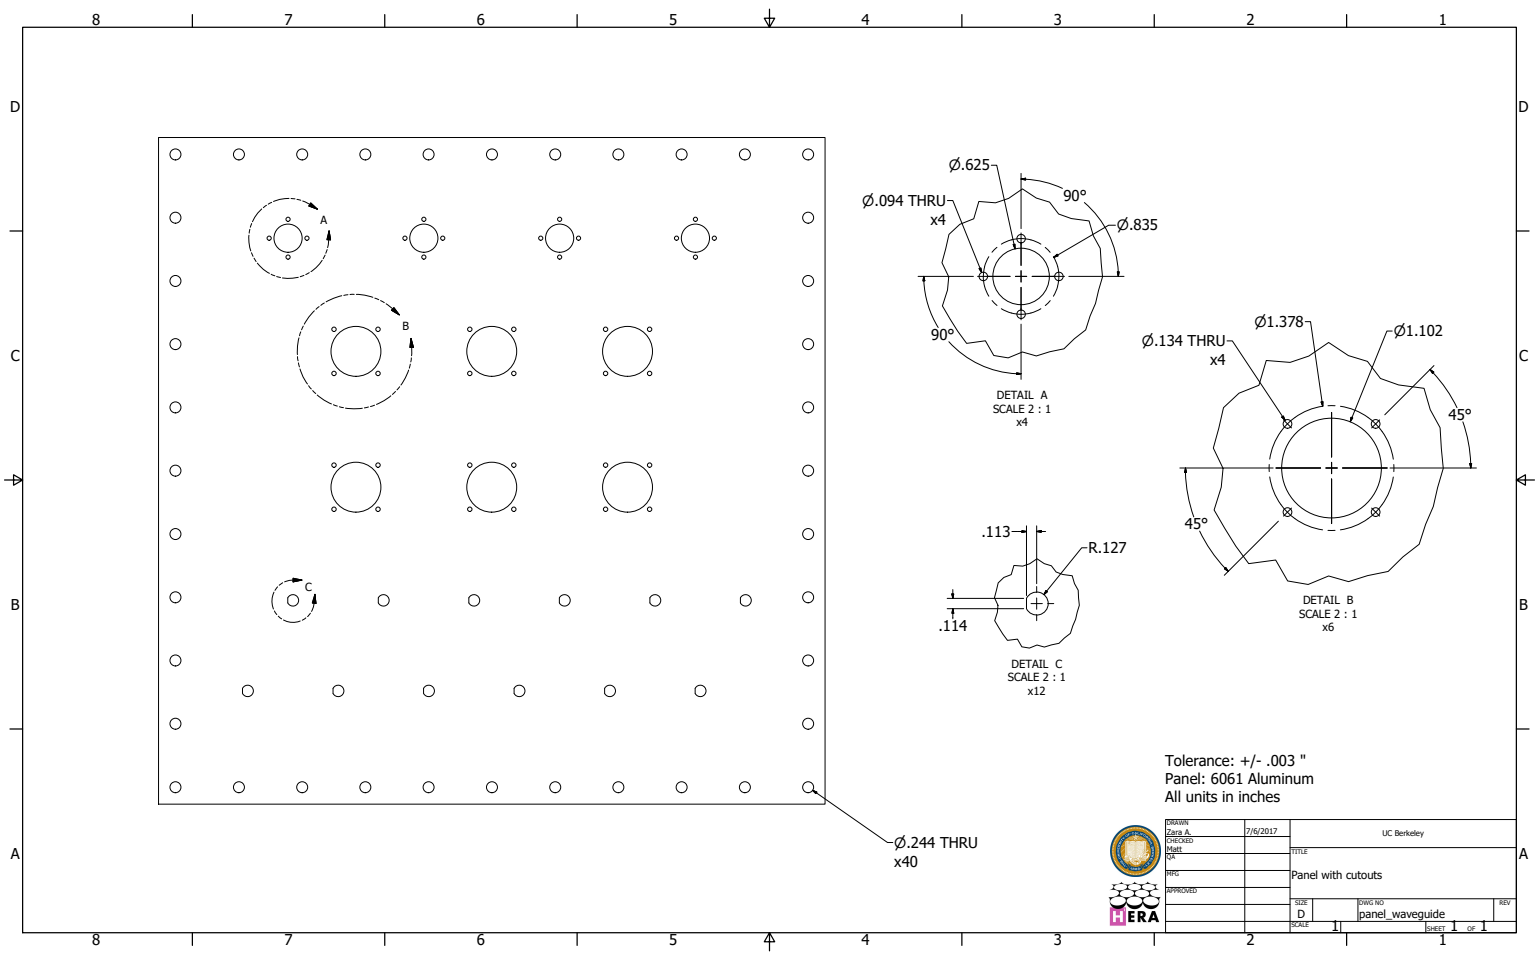
[picture p137: page 1]
DETAIL A SCALE 2 : 1 x4; DETAIL B SCALE 2 : 1 x6; DETAIL C SCALE 2 : 1 x12; SHEET 1 OF 1; DRAWN; CHECKED; MFG; APPROVED; Zara A.; Matt; DWG NO panel_waveguide; TITLE; SIZE D; SCALE; UC Berkeley; REV; P.134 THRU; P.094 THRU; P.244 THRU

Tolerance: +/- .003 "
Panel: 6061 Aluminum
All units in inches

Panel with cutouts
