david-deboer/hera-cad/Node/Concept-ICTS/ICTS-20170411/ssl-version/panel_waveguide_page2.pdf

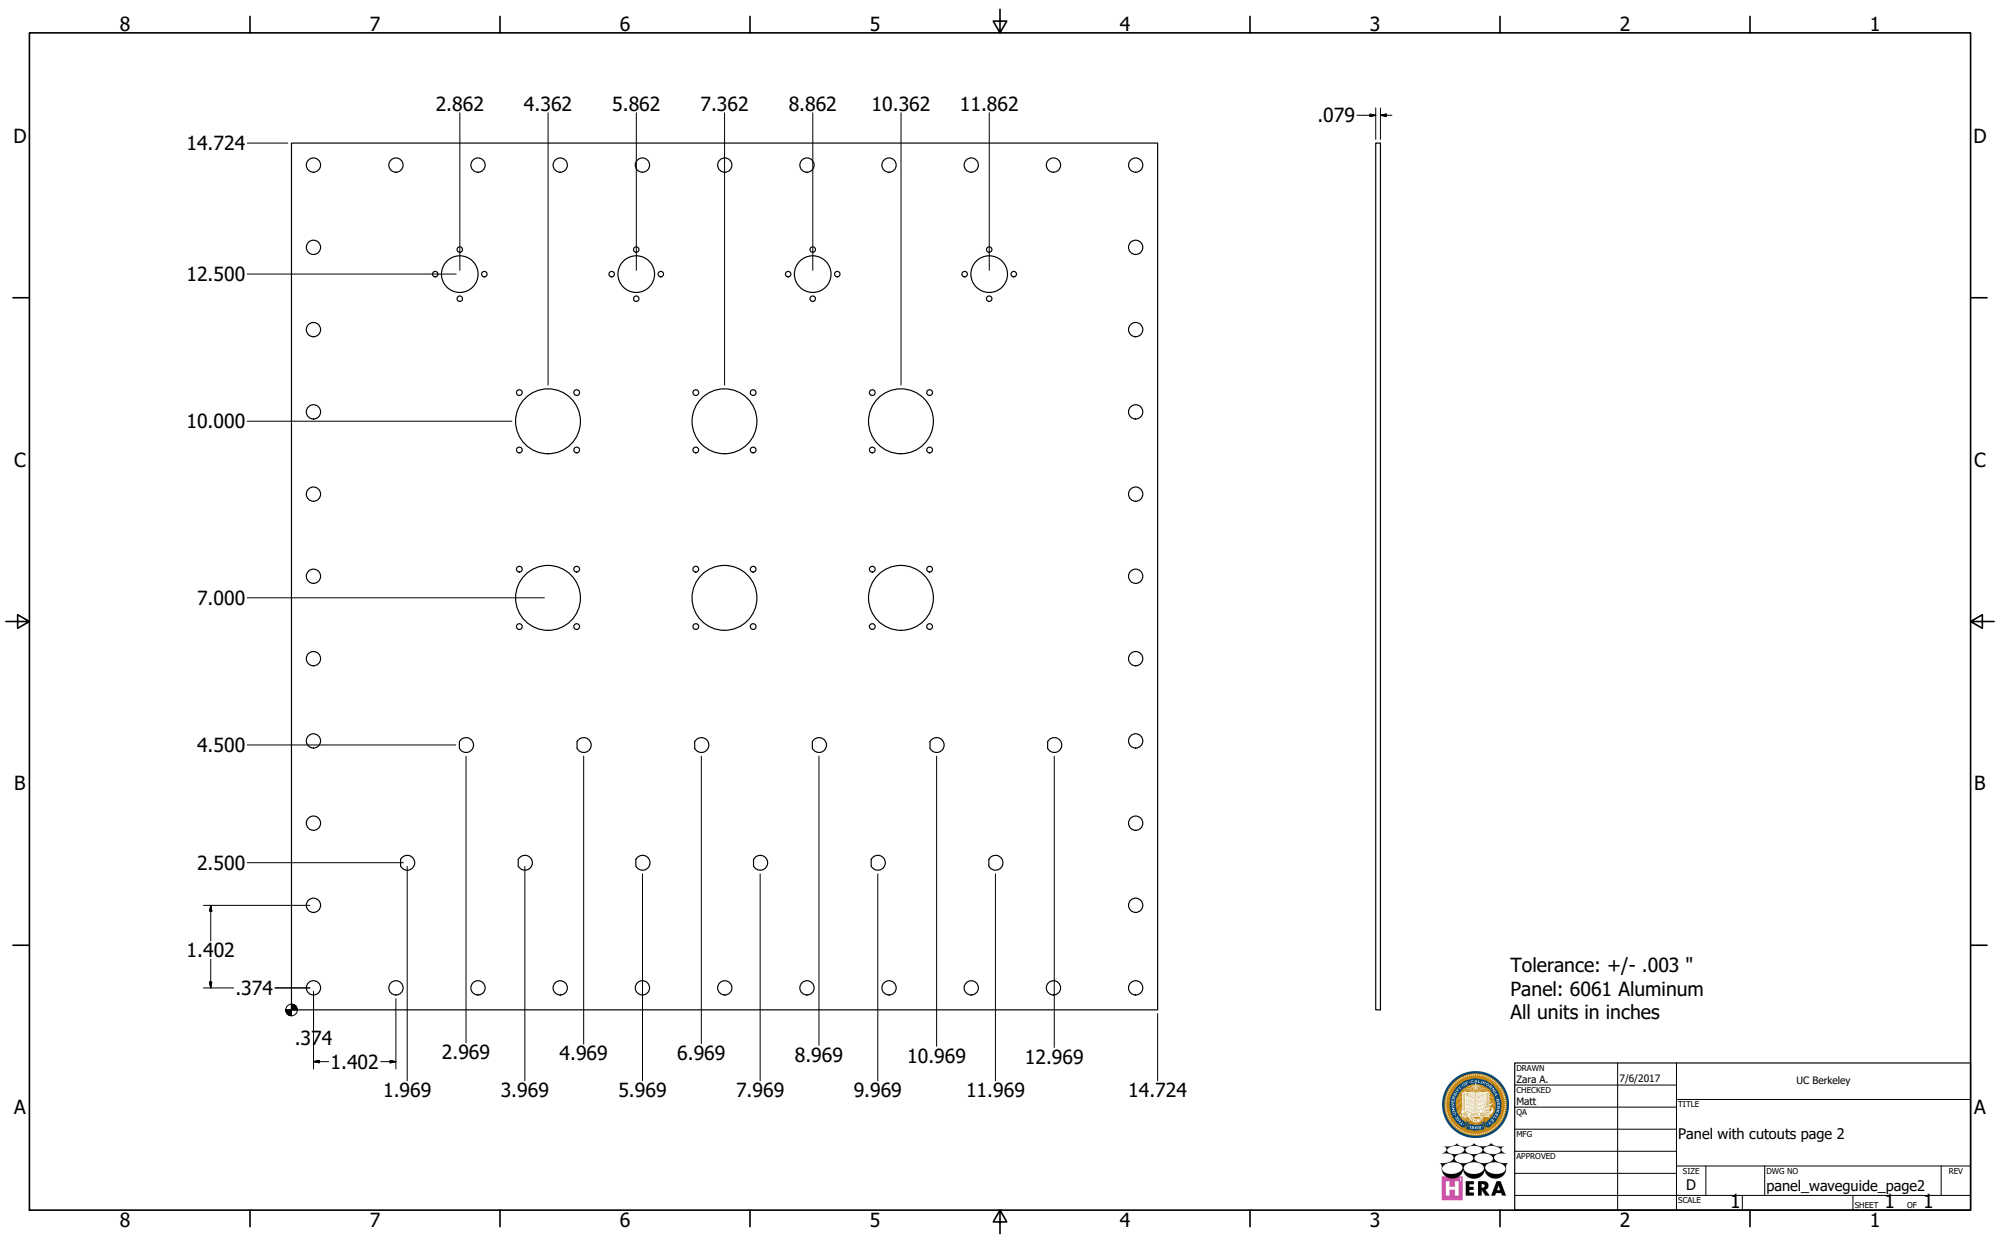
[picture p138: page 1]
SHEET 1 OF 1; DRAWN; CHECKED; MFG; APPROVED; Zara A.; Matt; DWG NO panel_waveguide_page2; SIZE D; SCALE; UC Berkeley; REV

Tolerance: +/- .003 "
Panel: 6061 Aluminum
All units in inches

TITLE
Panel with cutouts page 2
