david-deboer/hera-cad/Node/SNAP_V2/Workspaces/Workspace/components/dsub37bracket_redraw_left.pdf

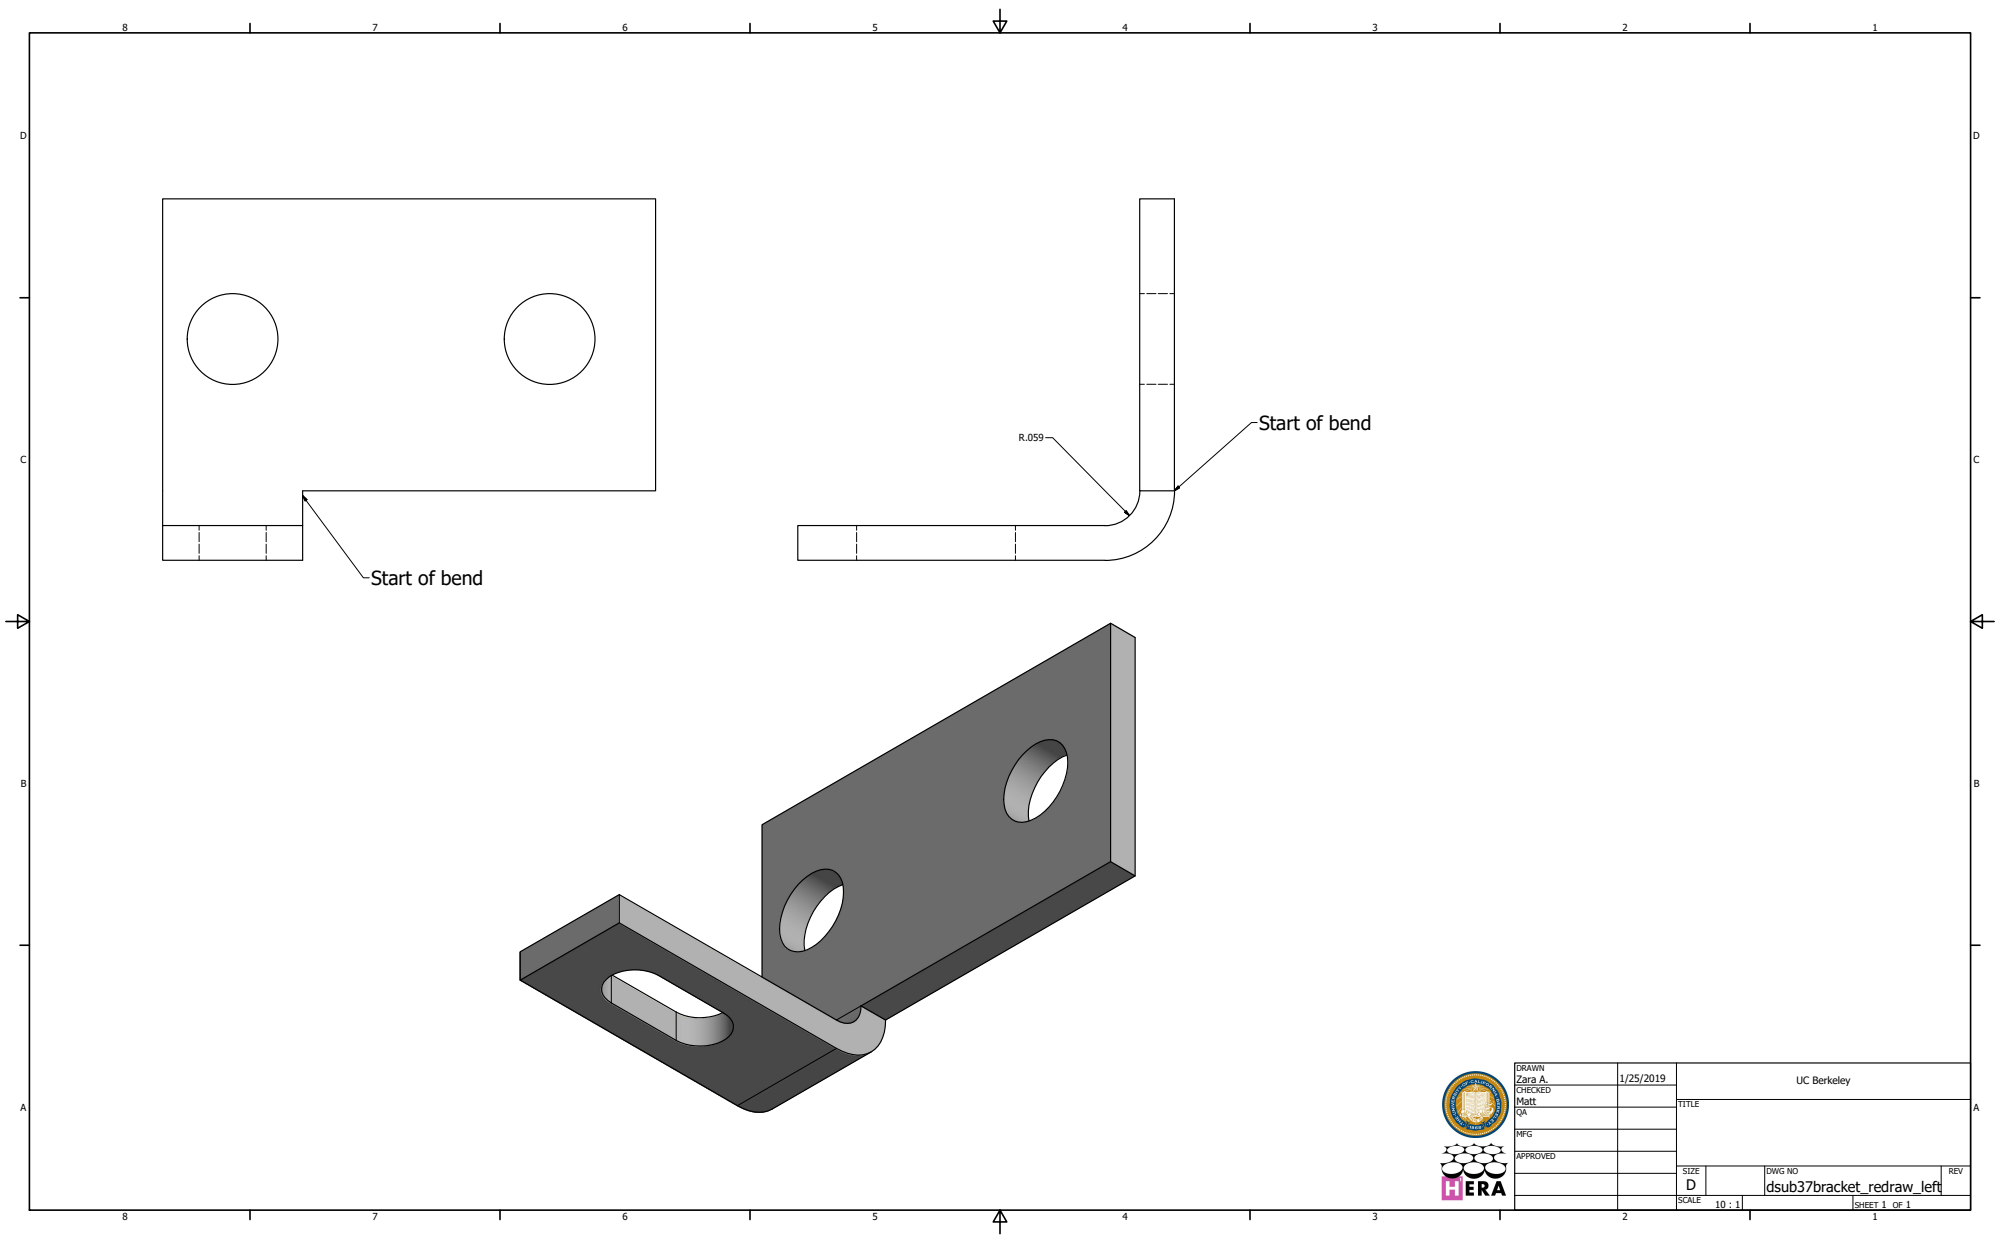
[picture p140: page 1]
SHEET 1 OF 1; DRAWN; CHECKED; MFG; APPROVED; Zara A.; Matt; DWG NO dsub37bracket_redraw_left; TITLE; SIZE D; SCALE; UC Berkeley; REV

Start of bend
