david-deboer/hera-cad/Node/FEM_PSU.pdf

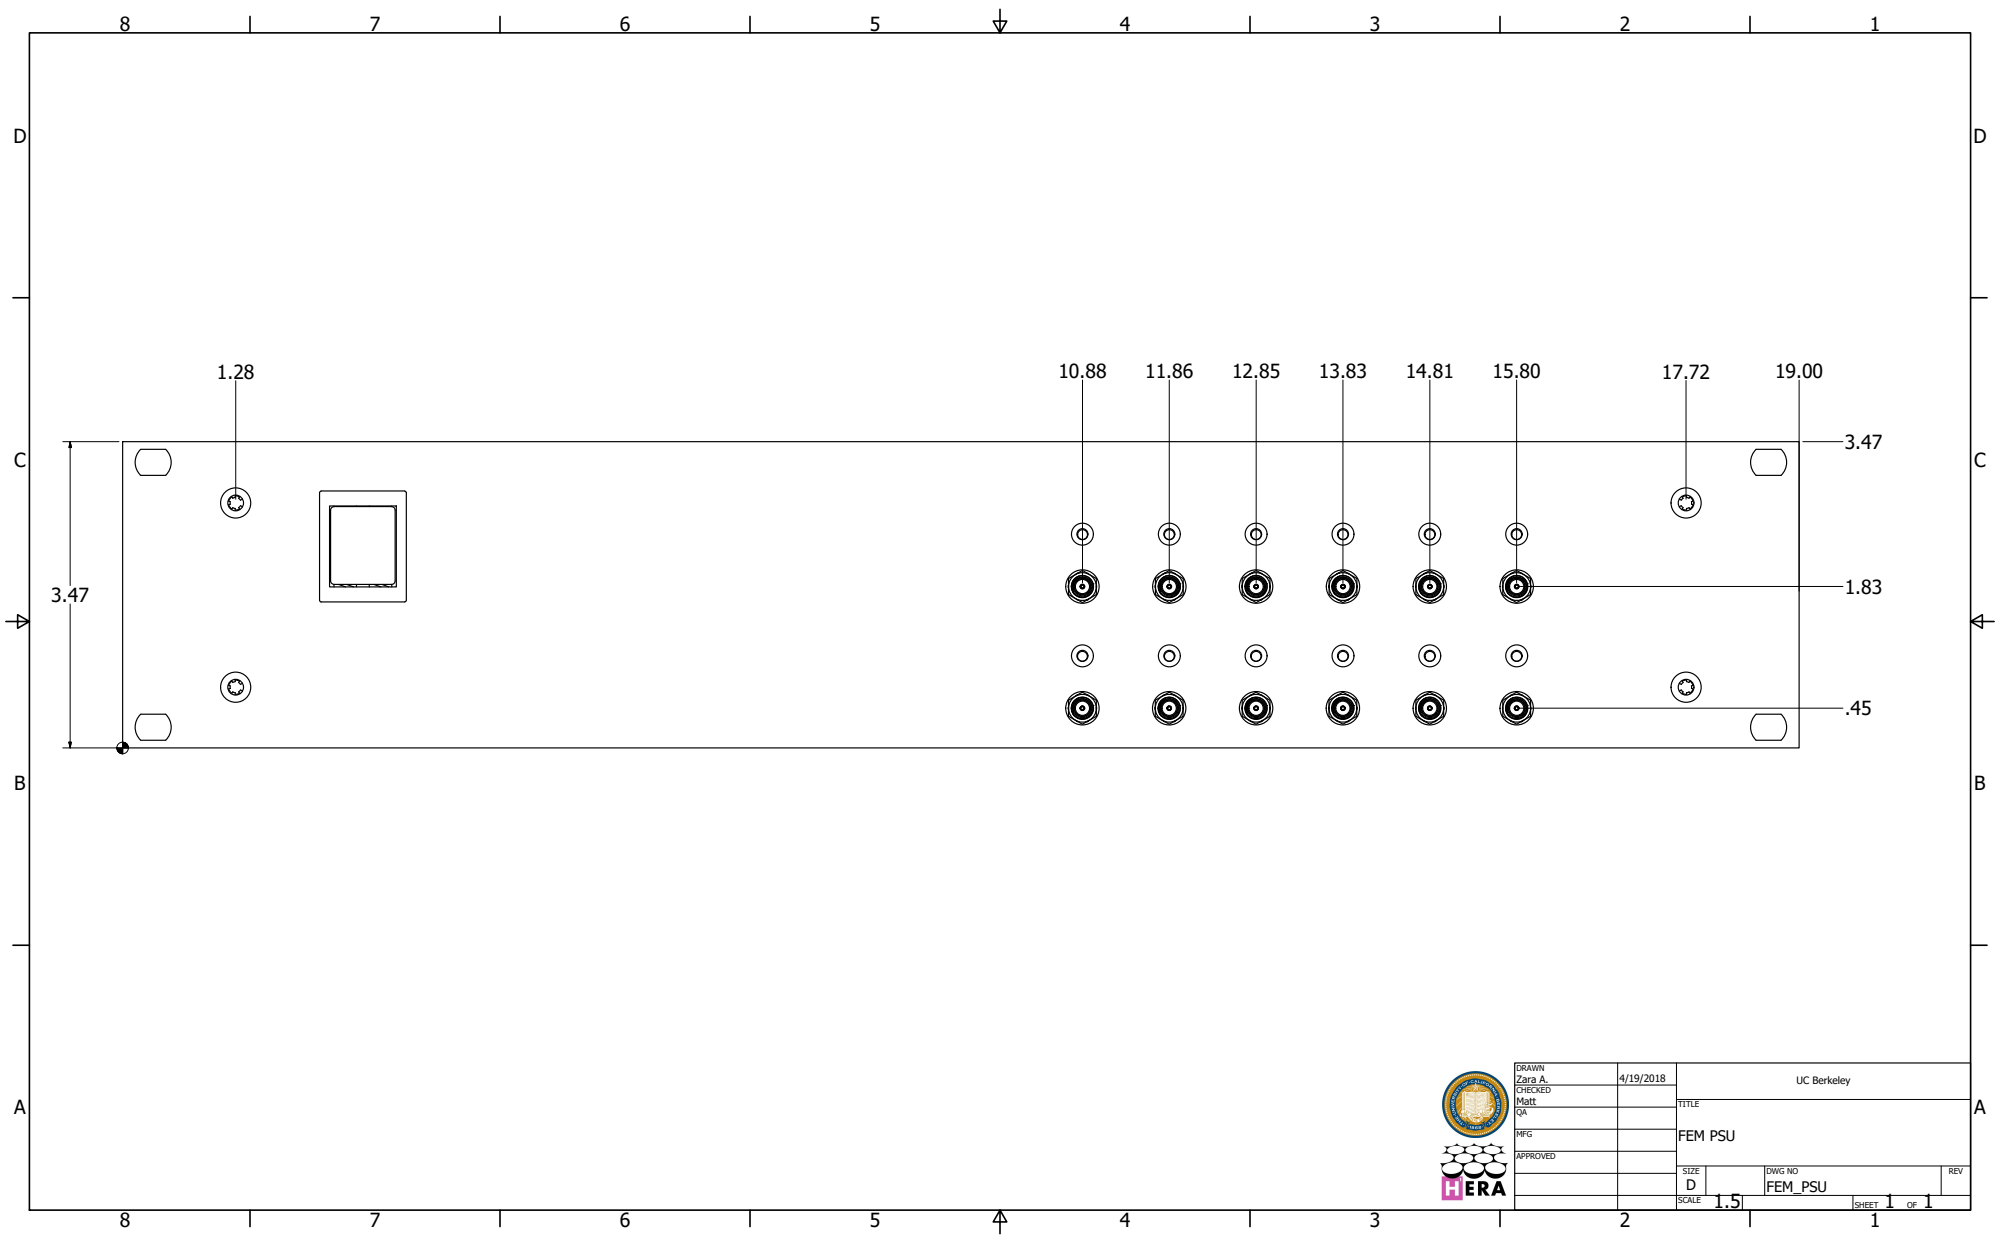
[picture p142: page 1]
SHEET 1 OF 1; DRAWN; CHECKED; MFG; APPROVED; Zara A.; Matt; DWG NO FEM_PSU; TITLE; FEM PSU; SIZE D; SCALE; UC Berkeley; REV
