david-deboer/hera-cad/Node/Bajog_Flansch_M20.pdf

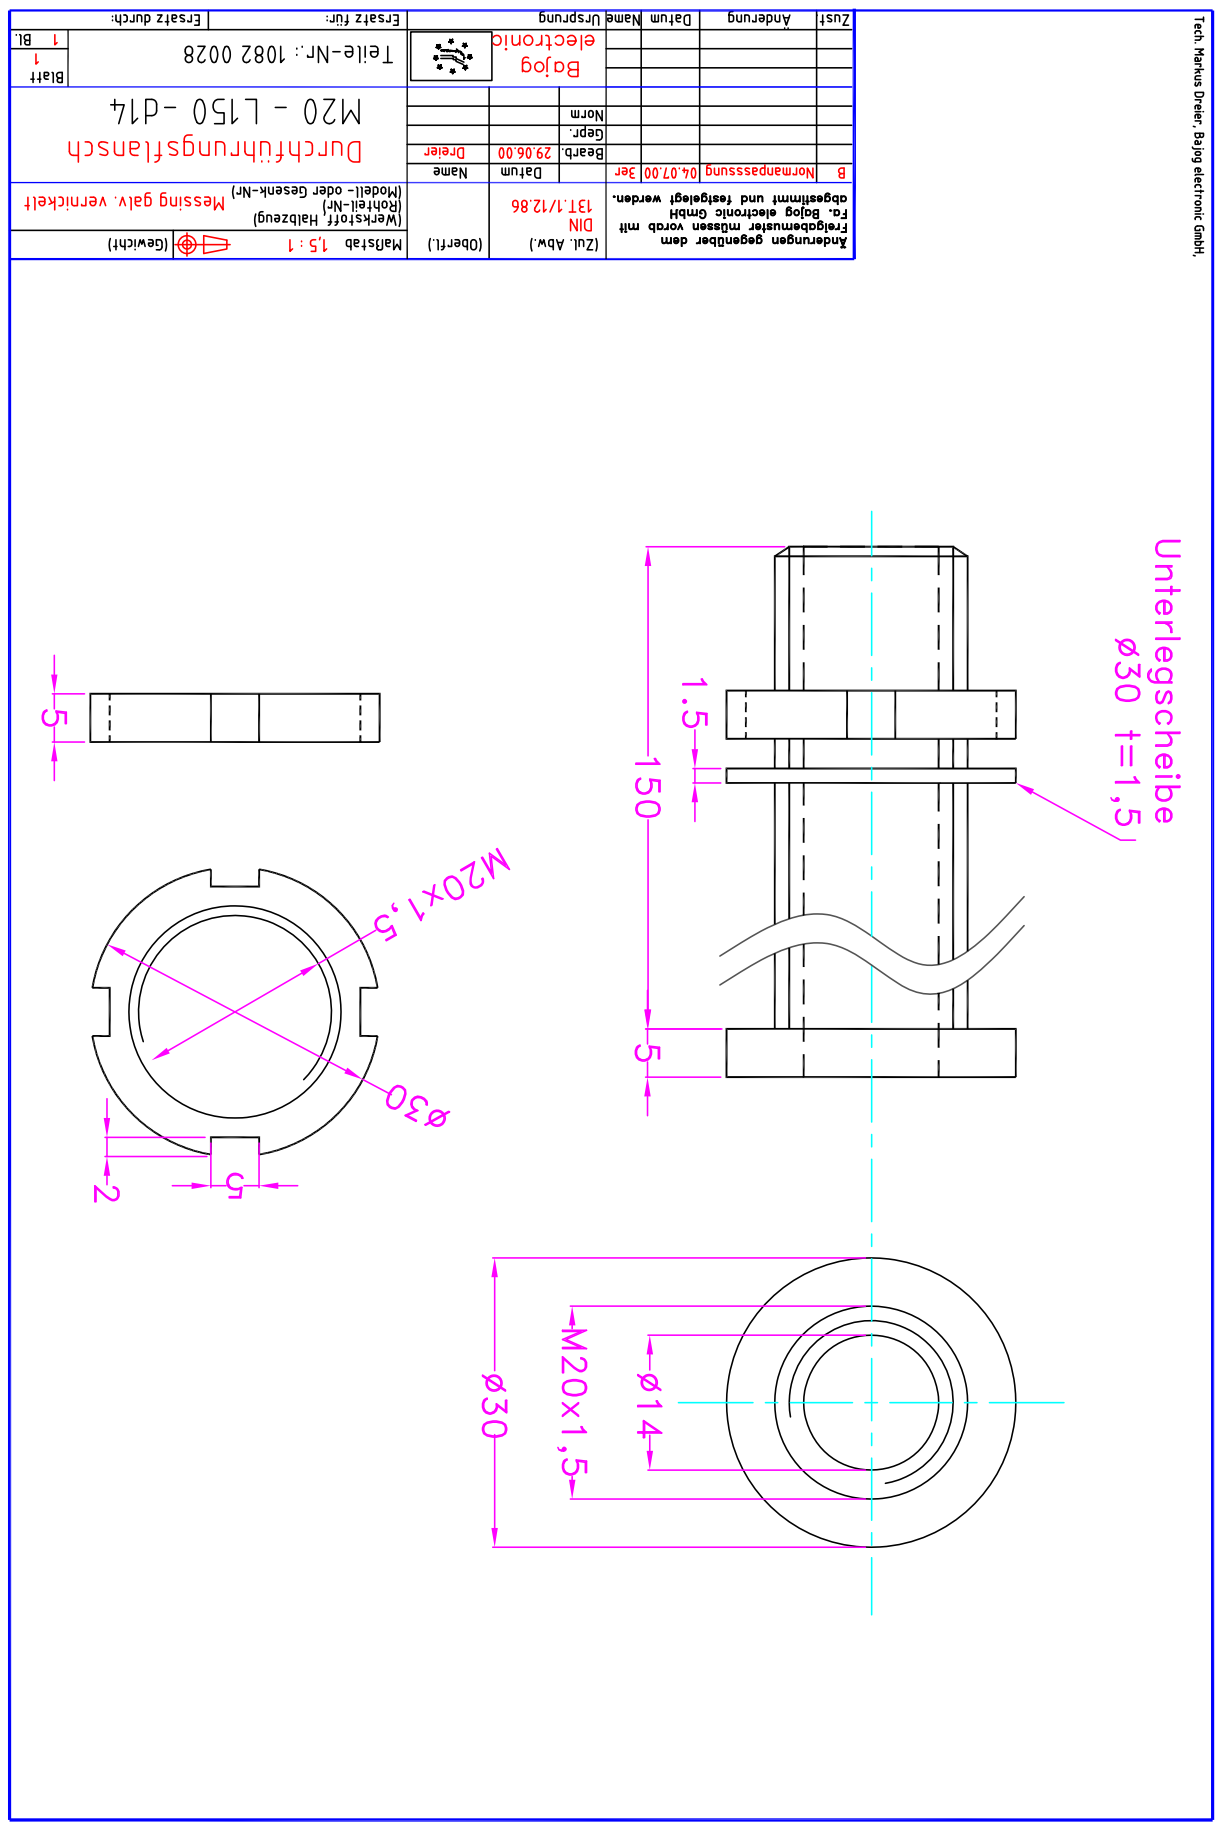
[picture p143: page 1]
