david-deboer/hera-cad/feed/H2bs-cA-bpSupArc.pdf

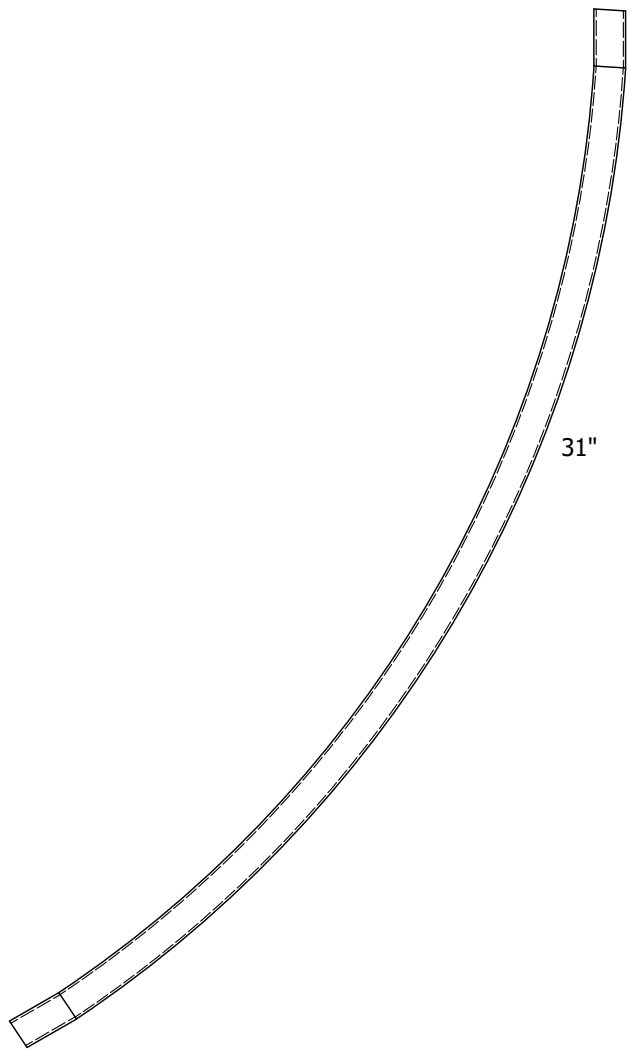
[picture p144: page 1]
SHEET 1 OF 1; DRAWN; CHECKED; MFG; APPROVED; Dave; DWG NO bpSupArc; TITLE; SIZE D; SCALE; REV
