david-deboer/hera-cad/feed/H2bs-hA-bpSupArm.pdf

1

2

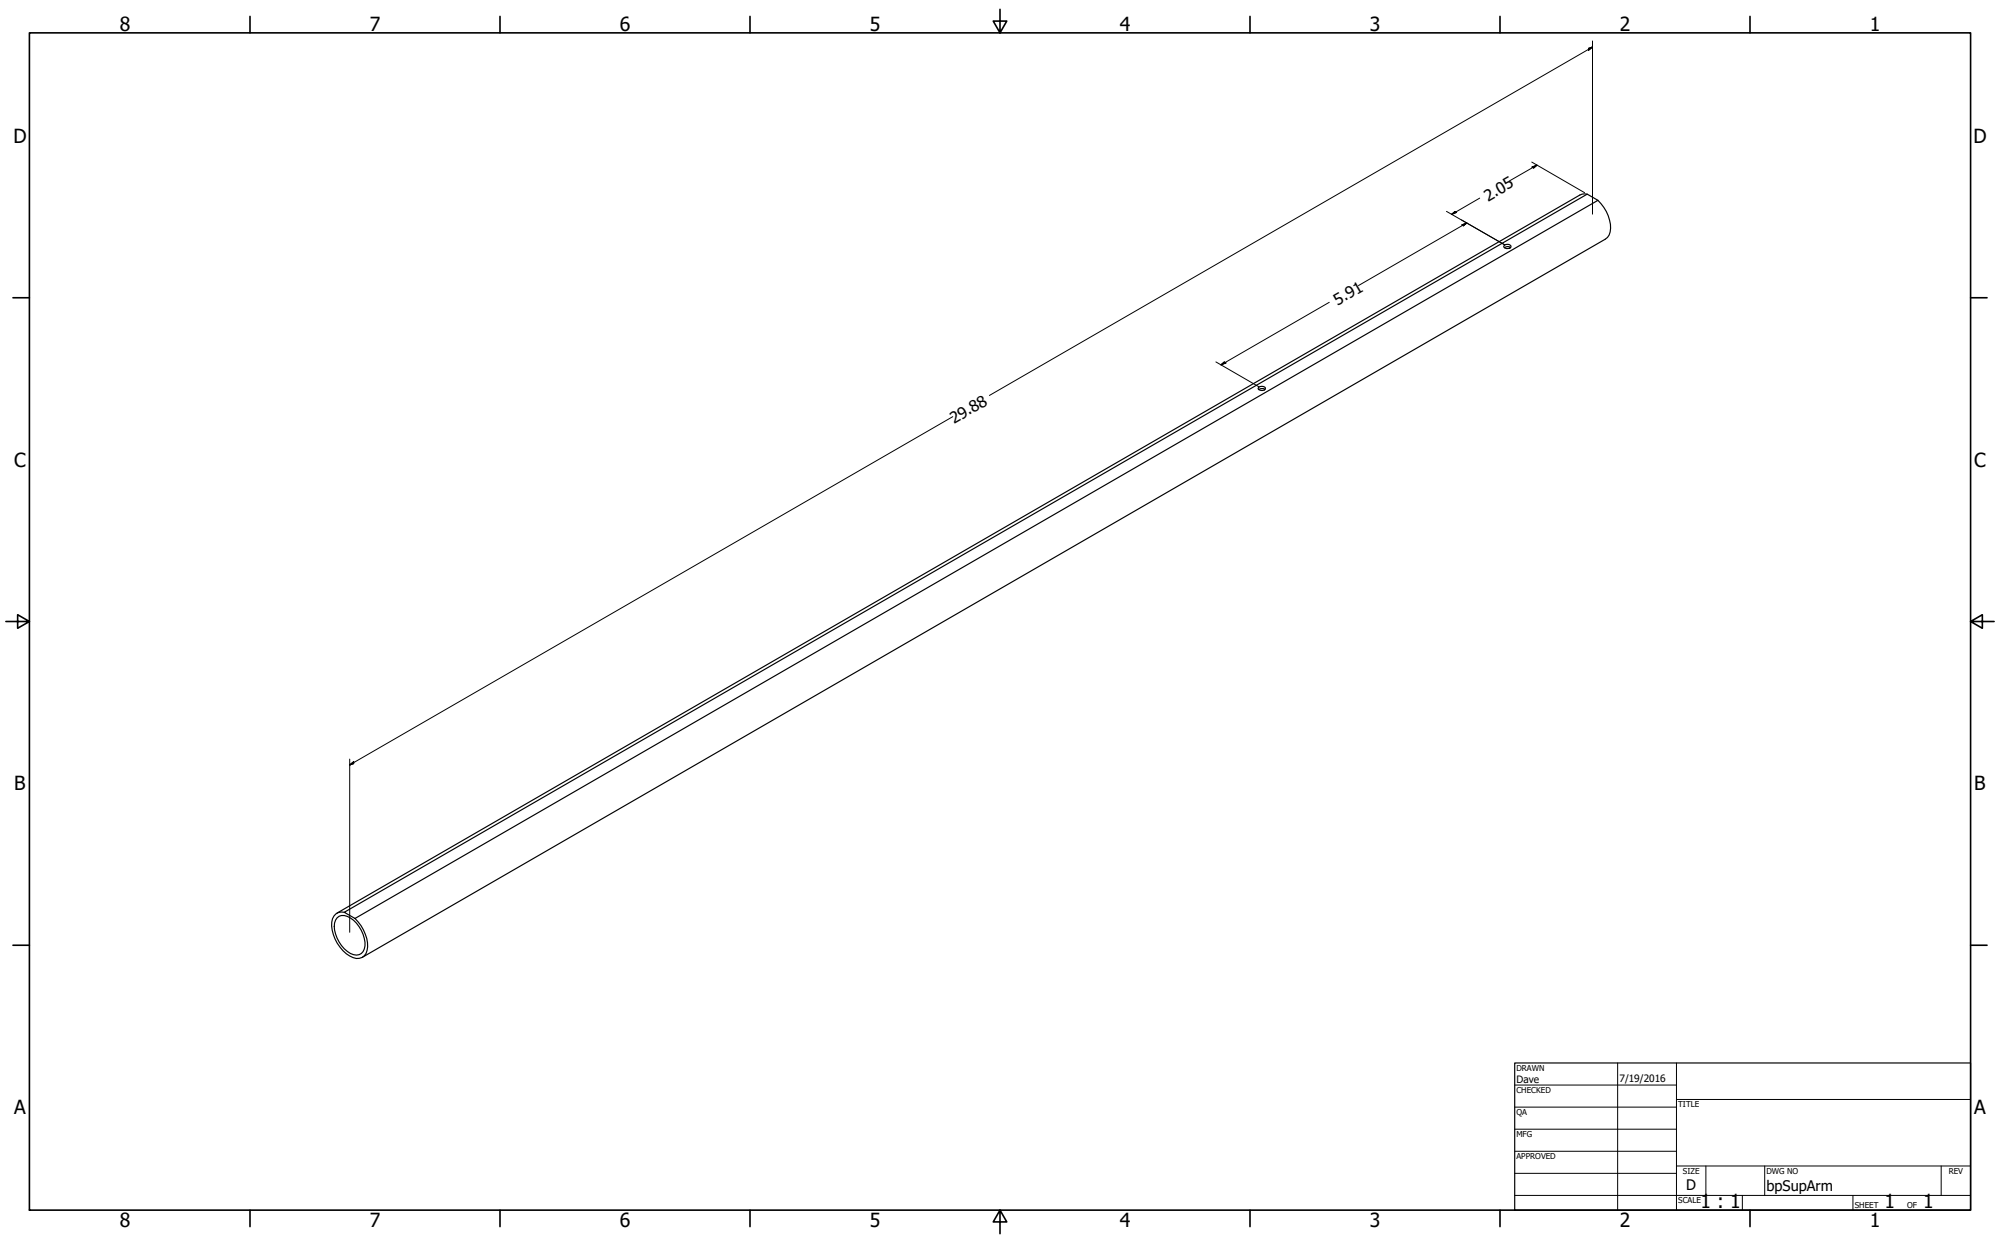
[picture p145: page 1]
SHEET 1 OF 1; DRAWN; CHECKED; MFG; APPROVED; Dave; DWG NO bpSupArm; TITLE; SIZE D; SCALE; REV
