david-deboer/hera-cad/data/hubdims.pdf

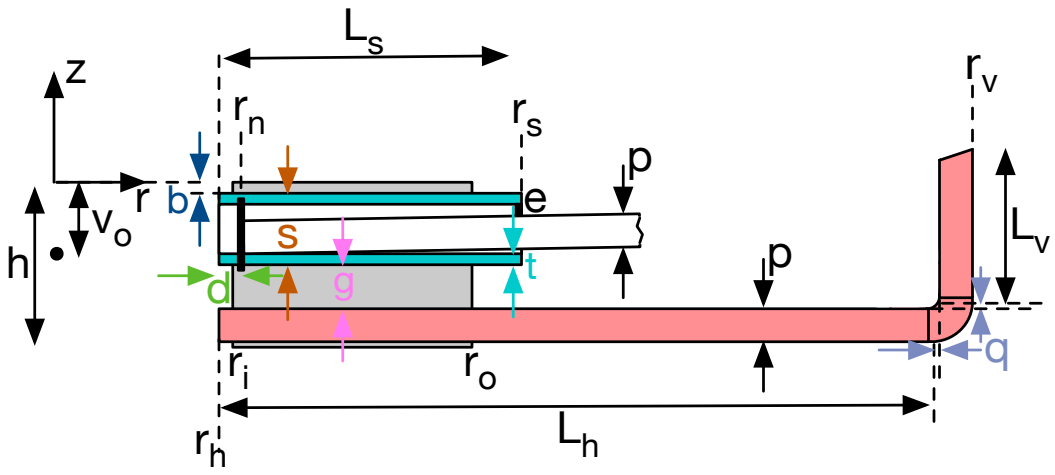
[picture p146: page 1]
