david-deboer/hera-cad/data/panels_annot.pdf

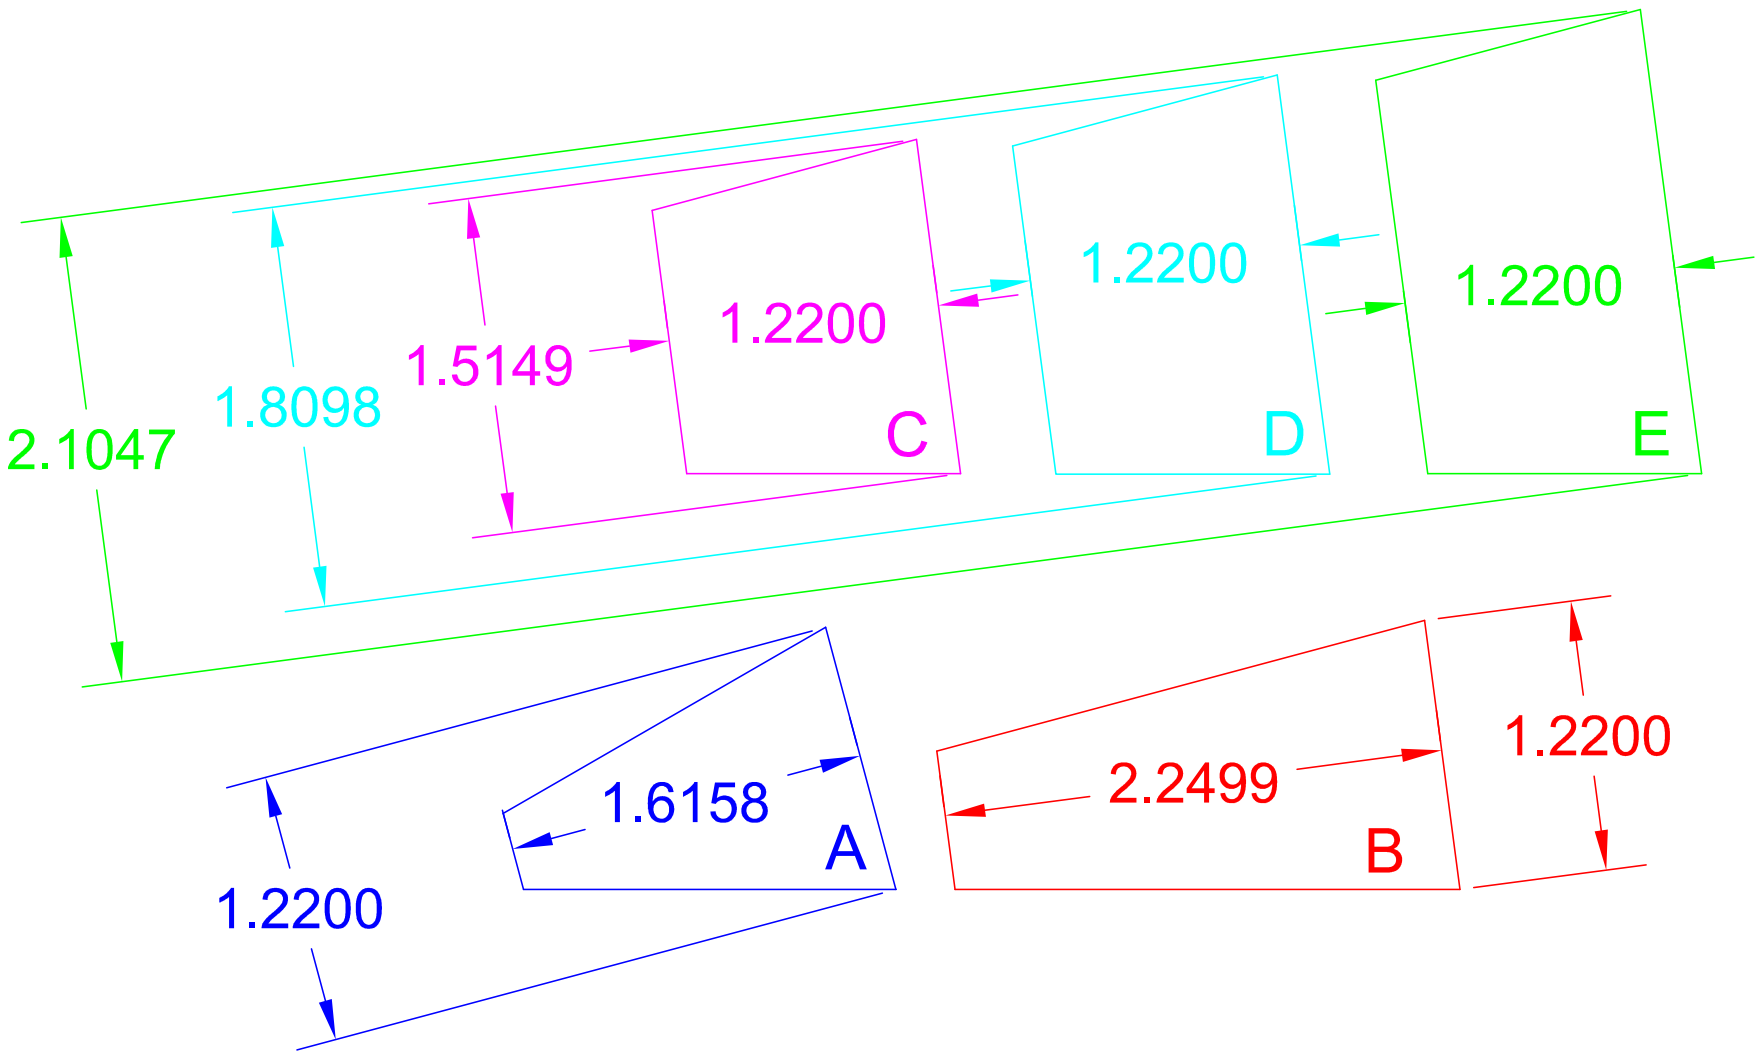
[picture p147: page 1]
