david-deboer/hera-cad/feed/H2dtAU_a_dipoleTopDisc.pdf

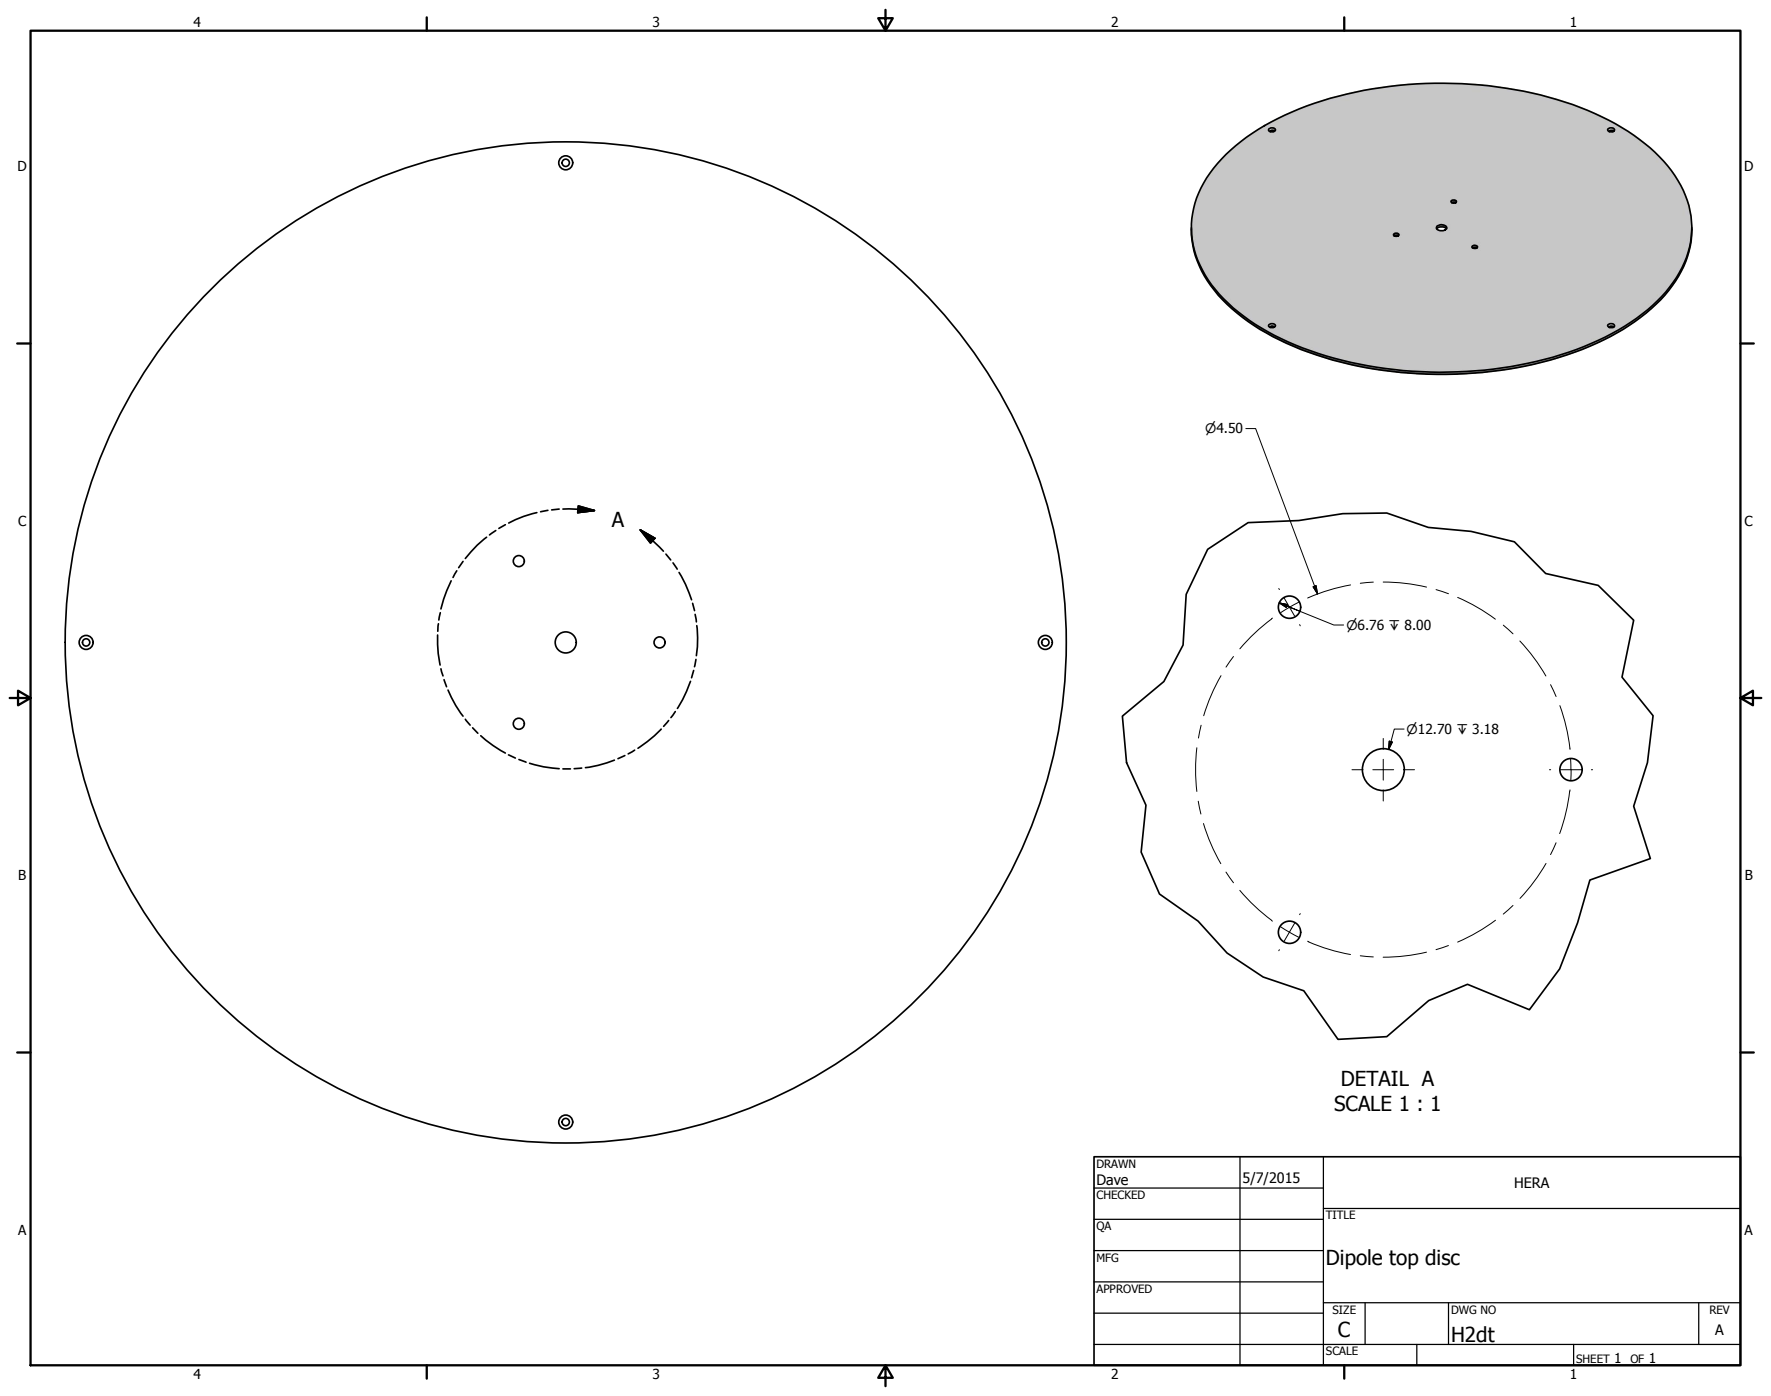
[picture p148: page 1]
DETAIL A SCALE 1 : 1; SHEET 1 OF 1; DRAWN; CHECKED; MFG; APPROVED; Dave; DWG NO H2dt; TITLE; SIZE C; SCALE; HERA; REV A

Dipole top disc
