david-deboer/hera-cad/feed/H2dtB_a_dipoleTopDisc.pdf

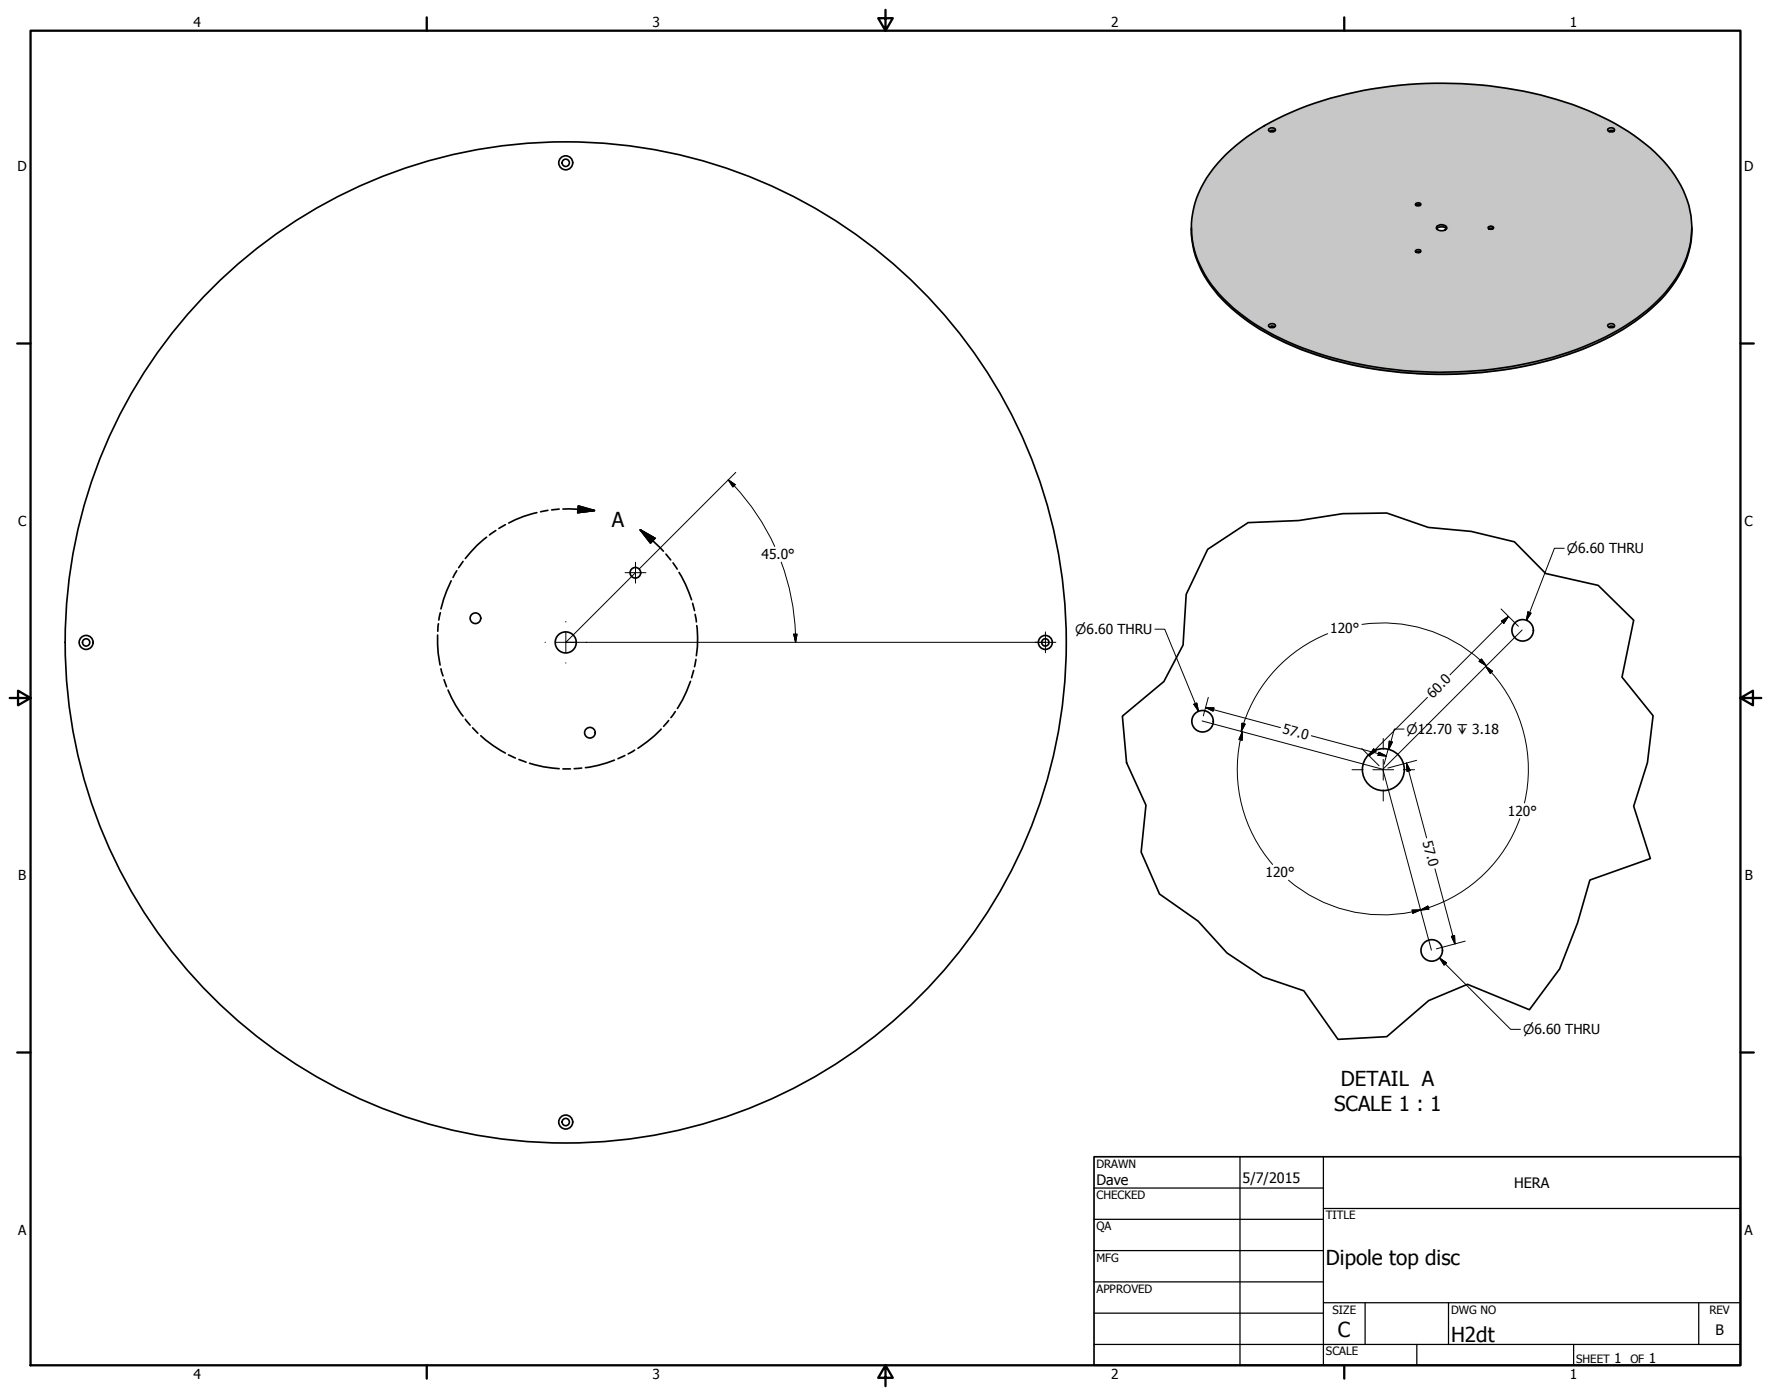
[picture p149: page 1]
DETAIL A SCALE 1 : 1; SHEET 1 OF 1; DRAWN; CHECKED; MFG; APPROVED; Dave; DWG NO H2dt; TITLE; SIZE C; SCALE; HERA; REV B; P6.60 THRU

Dipole top disc
