david-deboer/hera-cad/jigs/H7b-A_bottom_bridge.pdf

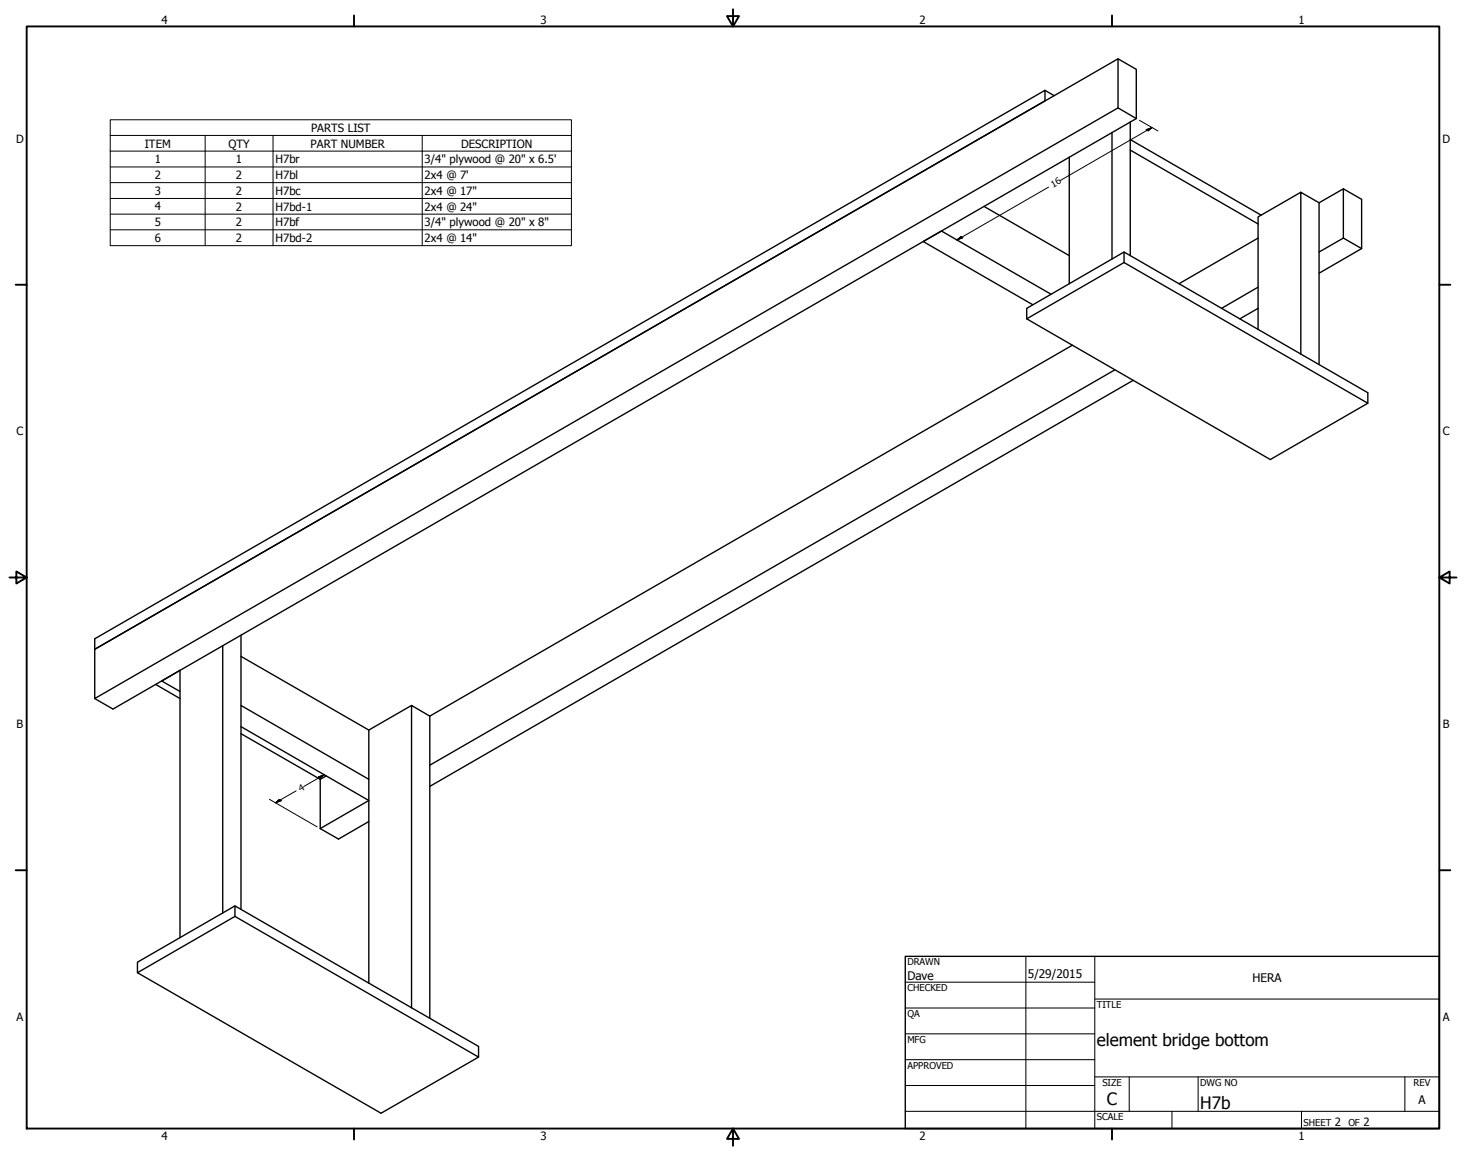
[picture p150: page 1]
PARTS LIST; ITEM; QTY; PART NUMBER; DESCRIPTION; 3/4" plywood @ 20" x 6.5'; 3/4" plywood @ 20" x 8"; SHEET 2 OF 2; DRAWN; CHECKED; MFG; APPROVED; Dave; DWG NO H7b; SIZE C; SCALE; HERA; REV A

TITLE
element bridge bottom
