david-deboer/hera-cad/jigs/H7b-A_top_bridge.pdf

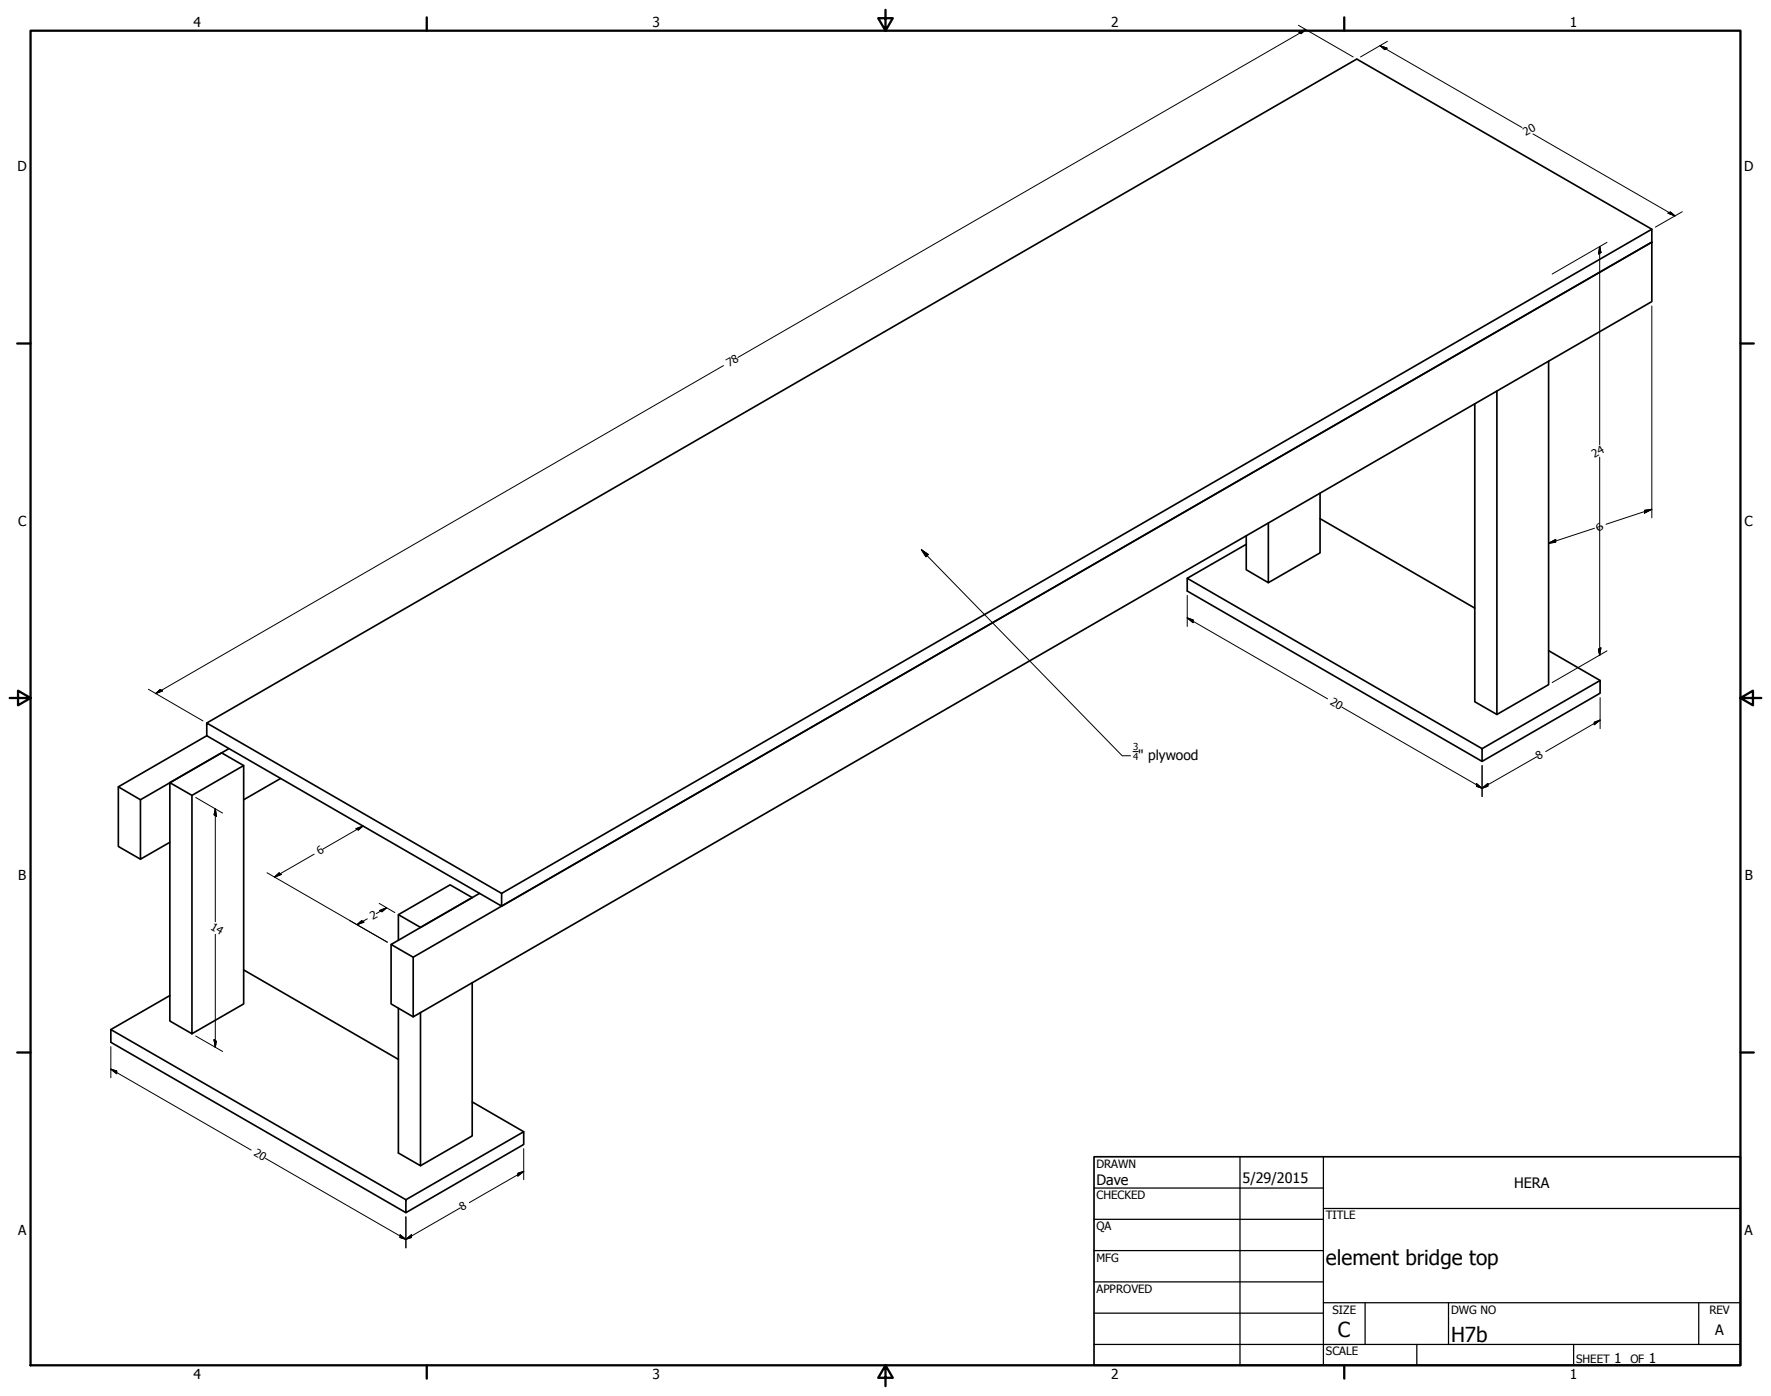
[picture p151: page 1]
SHEET 1 OF 1; DRAWN; CHECKED; MFG; APPROVED; Dave; DWG NO H7b; SIZE C; SCALE; HERA; REV A; 3 4" plywood

TITLE
element bridge top
