david-deboer/hera-cad/support/H1pr-sBU_a_rimIntermediateSparHolder.pdf

# Notes:

Not shown as standard 2x4, but use standard 2x4.

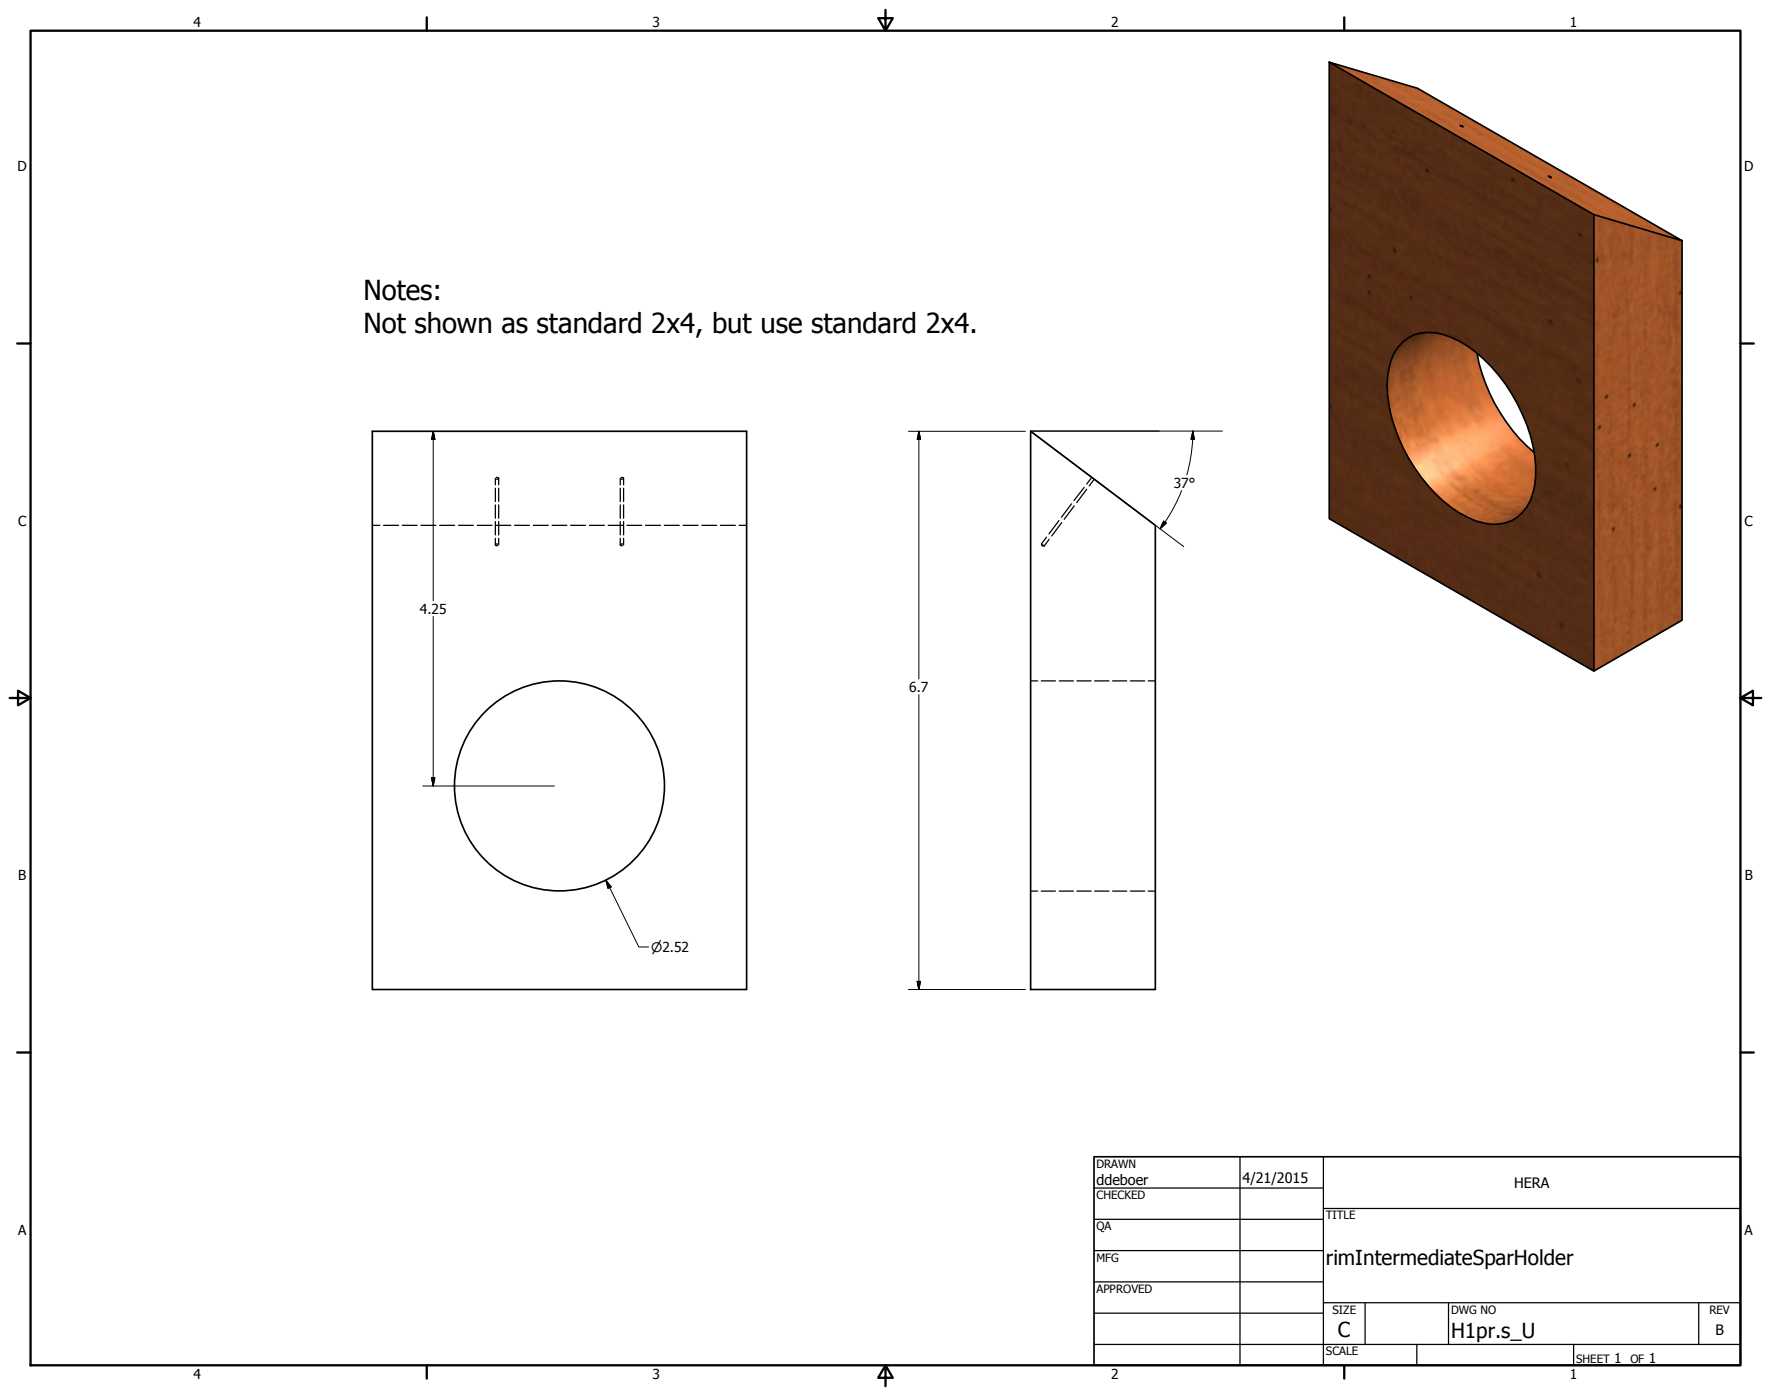
[picture p152: page 1]
SHEET 1 OF 1; DRAWN; CHECKED; MFG; APPROVED; ddeboer; DWG NO H1pr.s_U; TITLE; rimIntermediateSparHolder; SIZE C; SCALE; HERA; REV B
