david-deboer/hera-cad/surface/overlapCrossSection.pdf

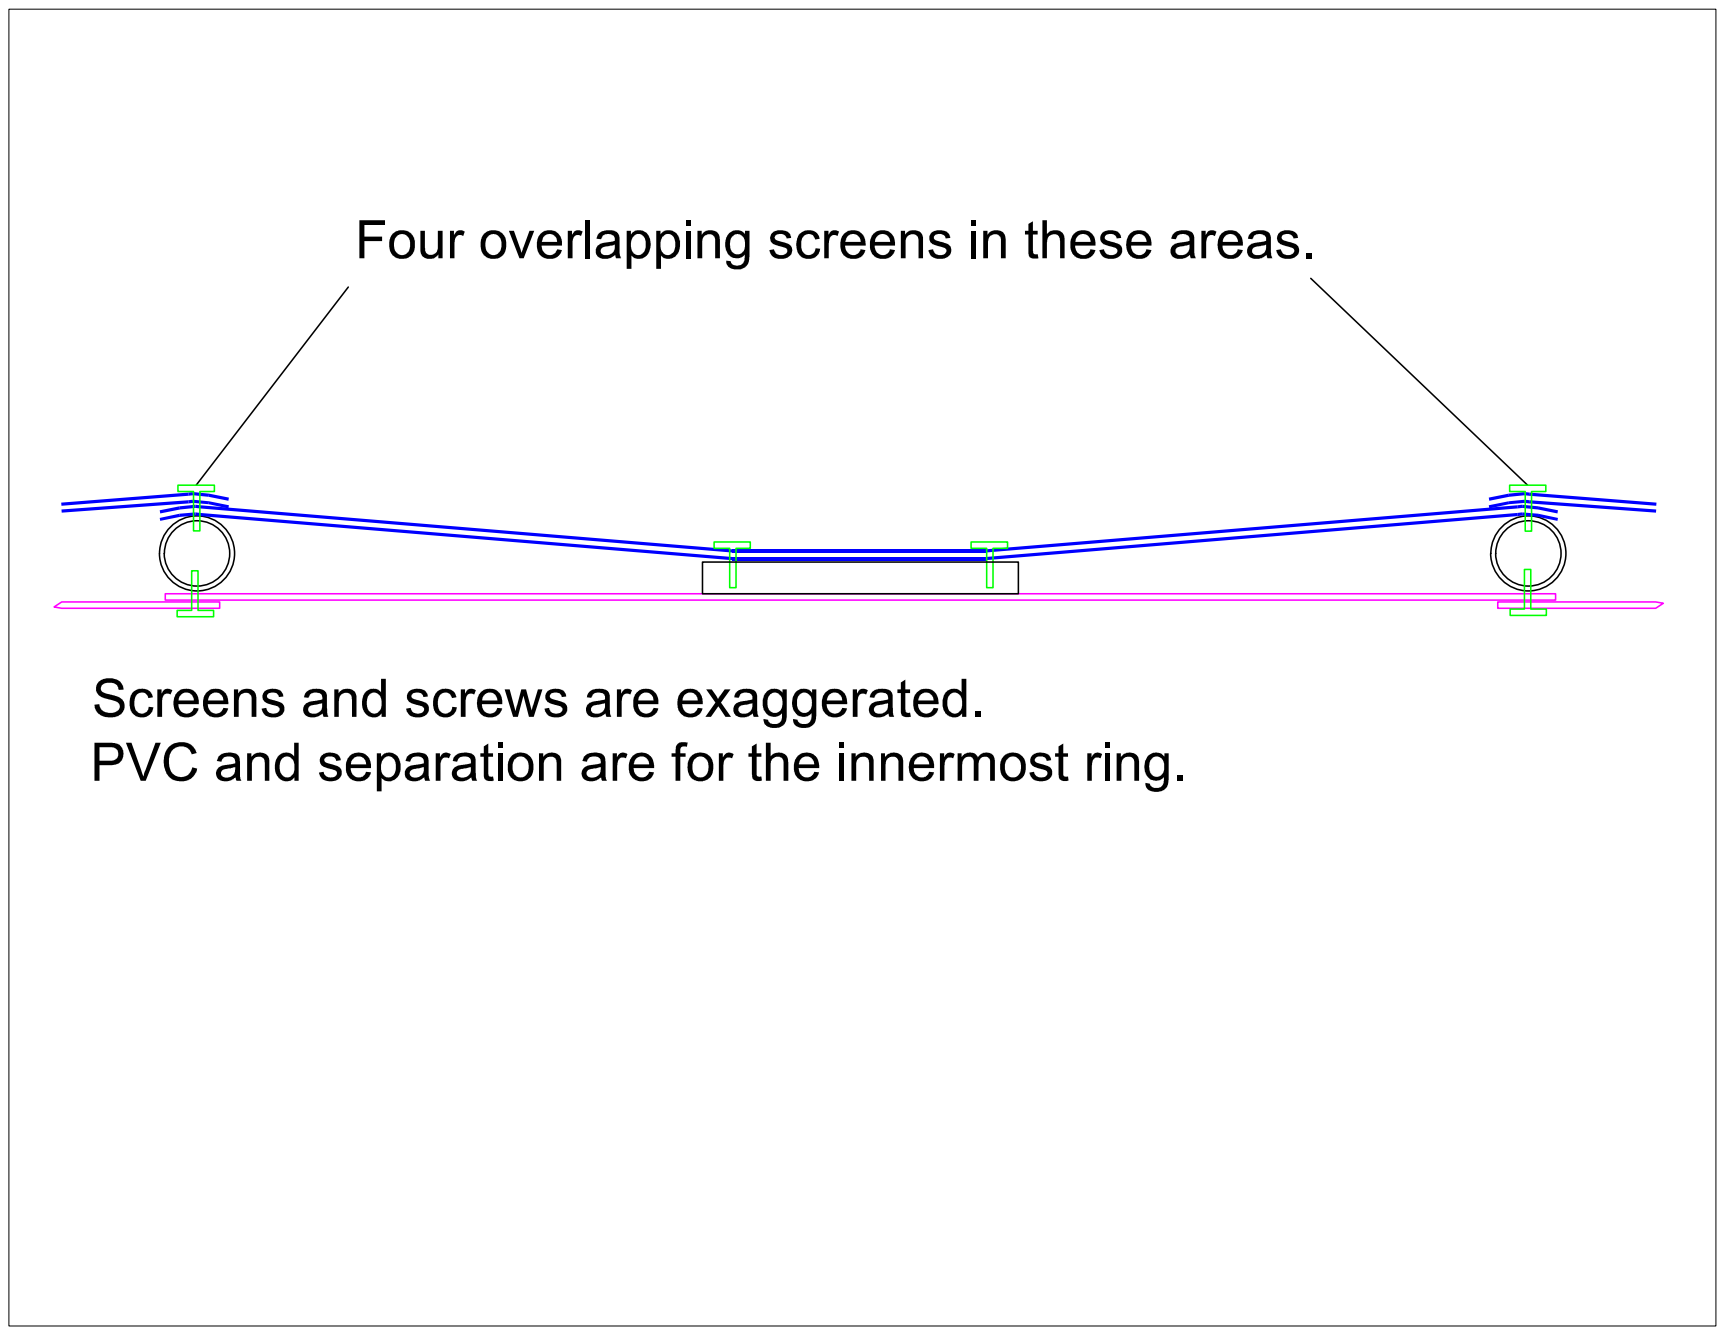
[picture p153: page 1]
