david-deboer/hera-cad/support/H1pr-hA_a_rimHoriz.pdf

Use standard 2x4.

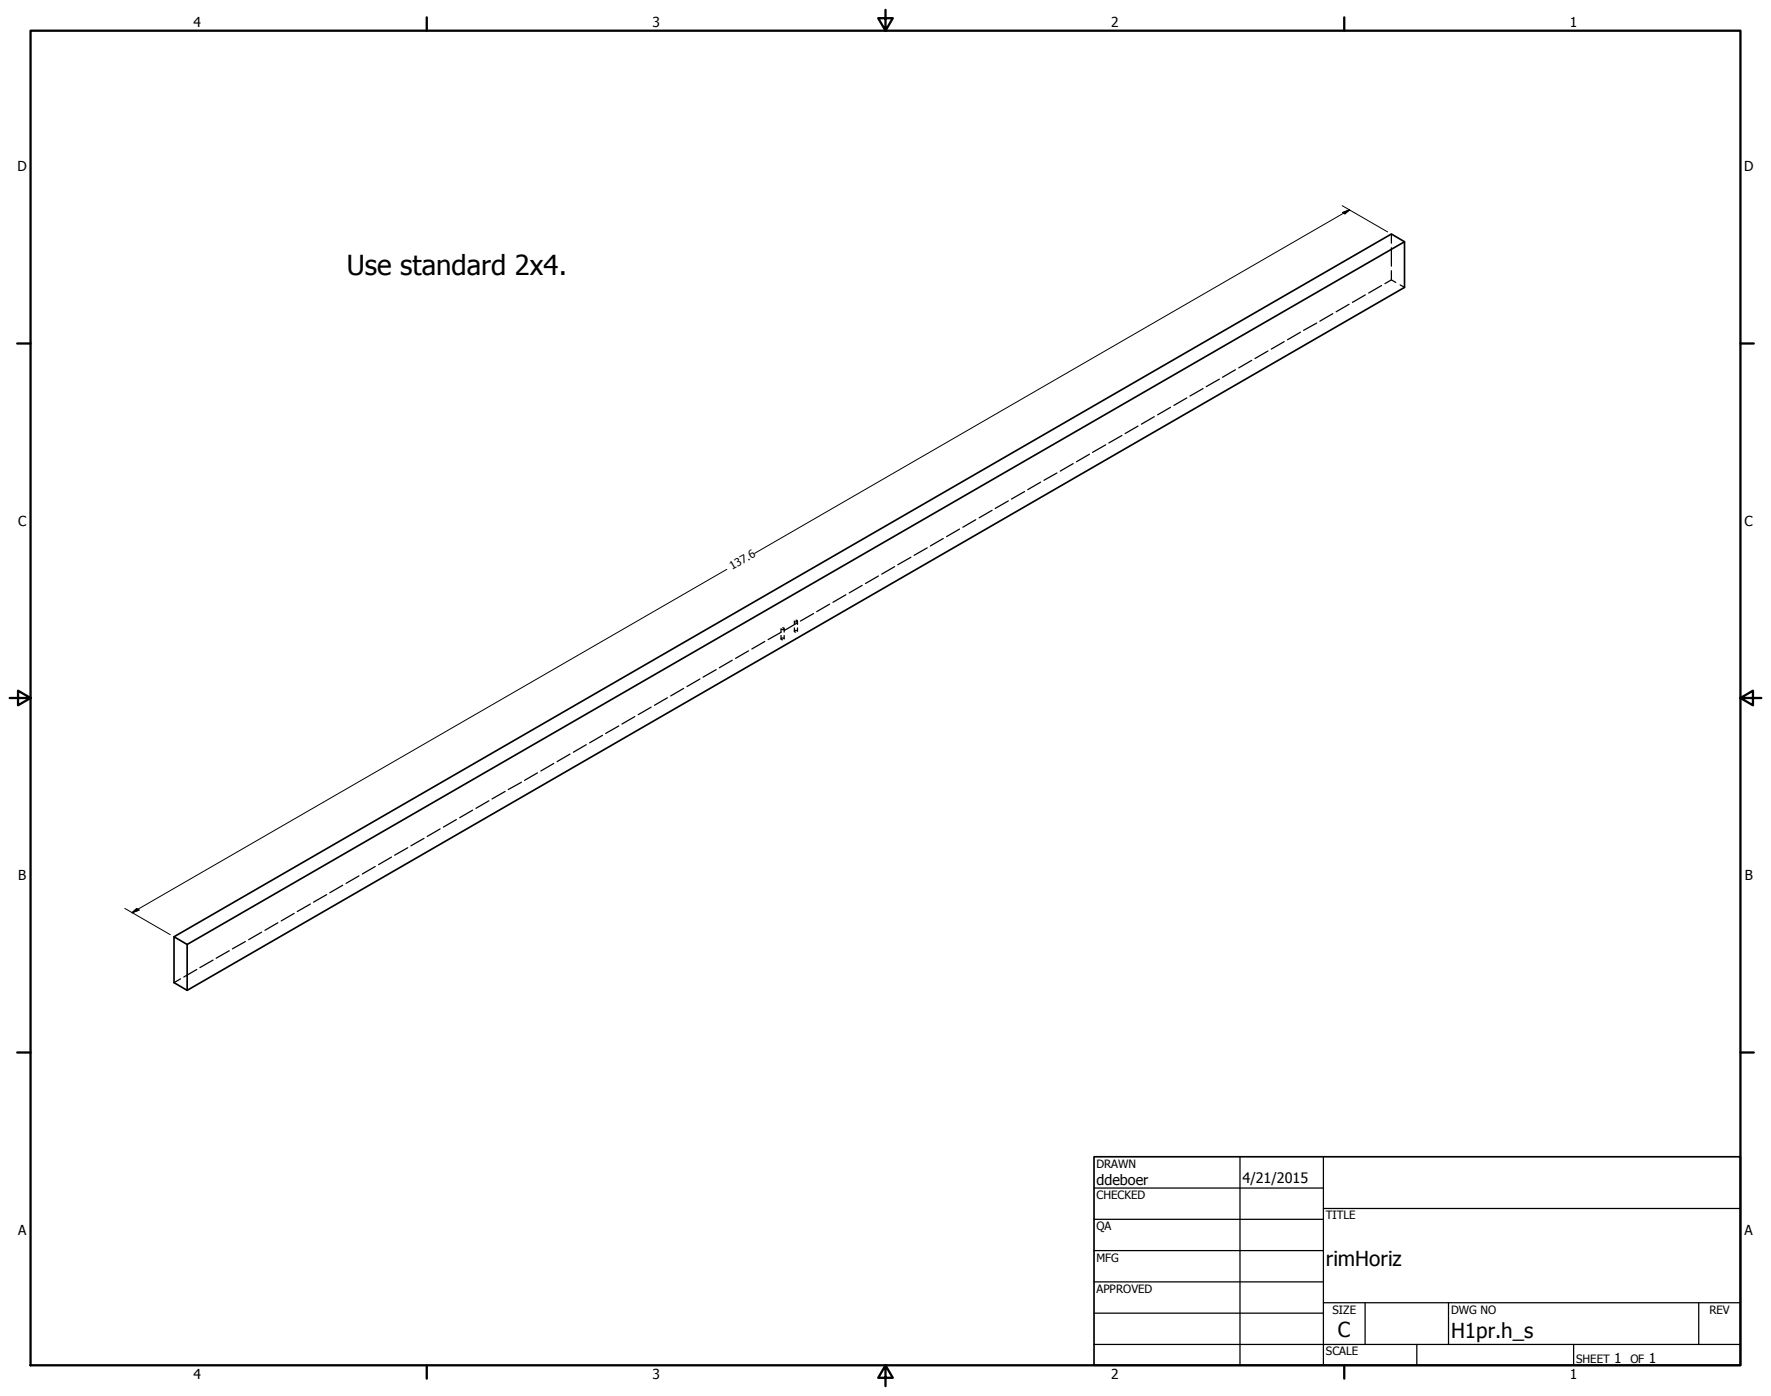
[picture p154: page 1]
SHEET 1 OF 1; DRAWN; CHECKED; MFG; APPROVED; ddeboer; DWG NO H1pr.h_s; TITLE; rimHoriz; SIZE C; SCALE; REV
