david-deboer/hera-cad/(commit log)

2013-12-03 initial commit - incomplete
    [cement.ipt, conduit.ipt, element.iam, end37.ipt, endAssembly.iam, endHoriz.ipt, endVert.ipt, hub.iam]
2013-12-04 added most of support and surface
    [cross.ipt, crossAssembly.iam, element.iam, end37channel.ipt, endAssembly.iam, endVert.ipt, endVert1.ipt, endVert2.ipt]
2013-12-04 added feed and most everything (not cone)
    [D.ipt, WashingtonMonument.ipt, bpScreen.ipt, bpSupArc.ipt, bpSupArm.ipt, bpSupAssembly.iam, bpSupCross.ipt, bpSupInner1.ipt]
2013-12-04 hadnt closed program on last push
    [element.iam, poleAssembly.iam, rimAssembly.iam]
2013-12-10 added collar drawing
    [collar.idw, collar.ipt]
2013-12-11 changed collar screw and added spring
    [bpSupAssembly.iam, collar.idw, collar.ipt, dipole.iam, feedAssembly.iam, spring.ipt]
2013-12-12 updated feed and added wireRope, kevlar, furring strips and screen
    [bpScreen.ipt, bpSupAssembly.iam, dipole.iam, element.iam, feedAssembly.iam, furringStrip1.ipt, furringStrip2.ipt, kevlarFeed.ipt]
2013-12-13 added total station retro holder on endAssembly
    [element.iam, endAssembly.iam, endHoriz.ipt, poleAssembly.iam, poleStand.iam, postAssembly.iam]
2013-12-16 added new screen and winch
    [element.iam, screen.ipt, screenInt.ipt, winch.ipt, winchAssembly.iam]
2013-12-17 added screen -- first approximately complete element!
    [element.iam, screenLeft.ipt, screenRight.ipt, winch.ipt, winchAssembly.iam]
2013-12-17 added bom
    [bom.idw, bom.xls, element.iam, elementOverview.idw]
2013-12-17 added splash plus pulley
    [element.iam, kevlarDown.ipt, pulley.ipt, splashAssembly.iam, splash_base.ipt, splash_shortPVC.ipt, splash_top.ipt, winchAssembly.iam]
2013-12-17 updated bom
    [bom.idw, bom.xls, element.iam, elementOverview.idw]
2013-12-19 minor mod for fasteners
    [bom.idw, bom.xls, element.iam, plat.ipt]
2013-12-19 fixed screen issues
    [screenInt.ipt, screenLeft.ipt]
2013-12-20 worked on BOM, costing and part numbers
    [bom.idw, bpBOM.idw, bpSupArm.ipt, bpSupAssembly.iam, bpSupCross.ipt, bpSupInner1.ipt, bpSupInner2.ipt, bpSupOuter.ipt]
2013-12-30 finished part numbers
    [D.ipt, bom.idw, bom.xls, bpScreen.ipt, bpSupArc.ipt, bpSupAssembly.iam, centralLine.ipt, cross.ipt]
2014-01-02 updated 2e p/n to 2p0
    [bom.idw, element.iam, end37.ipt, end37channel.ipt, endHoriz.ipt, endVert1.ipt, endVert2.ipt]
2014-01-02 updated xls too
    [bom.idw, bom.xls, element.iam]
2014-01-03 update to bom
    [bom.idw, bom.xls, element.iam, nut_ss_375.ipt, splash_top.ipt]
2014-01-04 updated part numbers
    [bom.idw, bom.xls, bomHierarchical.idw, bomHierarchical.xls, bpScreen.ipt, bpSupAssembly.iam, cement.ipt, conduit.ipt]
2014-01-04 updated partnumbers.txt
    [bom.xls]
2014-01-04 had to add bom.xls in again
    [bom.idw, bom.xls, element.iam]
2014-01-24 updated partNumbers based on new architecture in PB - need to propagate through cad etc!
2014-02-25 update
    minor changes to bom and element
    [bom.idw, element.iam]
2014-02-27 hera 331
    [Part1.ipt, container.ipt, element.iam]
2014-03-11 added node
    [housing.ipt, node.iam, plinth.ipt, snap.ipt]
2014-03-12 added to node, include air/ground exchange
    [Acopian-M13-Case.iam, airgnd_exchange.ipt, node.iam]
2014-03-12 added underground pipe
    [airgnd_exchange.ipt, dcps_mcpc.ipt, housing.ipt, housingLid.ipt, node.iam, sweep.ipt, undergndPipe.iam]
2014-04-30 Updated endcaps and screen
    [element.iam, elementNEWINCOMPLETE.iam, elementOverview.idw, end37channel.ipt, endAssembly.iam, endVert1.ipt, endVert2.ipt, poleAssembly.iam]
2014-05-01 Update to splash cone
    added furring base and discs
    [splashAssembly.iam, splashBase.iam, splashBaseDisc.ipt, splashFurring.ipt, splashTopDisc.ipt]
2014-05-03 update to construction constraints
    [element.iam, plat.ipt, poleAssembly.iam, poleStand.iam]
2014-05-07 update of poles/posts/endcaps/etc
    [element.iam, end37.ipt, endAssembly.iam, endHoriz.ipt, endVert1.ipt, endVert1_MIR.ipt, hub.iam, poleAssembly.iam]
2014-05-07 now a nearly fully constrained version
    [Part1.ipt, element.iam, end37.ipt, end37channelNOTUSED.ipt, endAssembly.iam, endVert1.ipt, endVert1_MIR.ipt, endVert1_MIR1.ipt]
2014-05-07 additional constraining
    [element.iam, panelB.ipt, panelE.ipt, ramp.ipt, sparFull.ipt]
2014-05-19 added bolt/woodblock feature to endcap
    [element.iam, end37.ipt, endAssembly.iam, endWoodblock.ipt, poleAssembly.iam, poleStand.iam, postAssembly.iam, sparFull.ipt]
2014-05-20 changes to node and endcap
    [airgnd_exchange.ipt, cross.ipt, crossAssembly.iam, element.iam, end37.ipt, endAssembly.iam, endChannel.ipt, endHoriz.ipt]
2014-05-21 Full design rev 1.0
    full design (but still need intermediate-spar-to-rim attachment detail)
    [cross.ipt, crossAssembly.iam, element.iam, hub.iam, plat.ipt, poleAssembly.iam, pvc_T_2in_modSplit.ipt, sleeve.ipt]
2014-05-21 small tweaks
    [element.iam, endAssembly.iam, endHoriz.ipt, poleAssembly.iam, poleStand.iam, postAssembly.iam]
2014-05-22 added ground and chimney to node
    [Ground.ipt, chimneyCap.ipt, ductFan.ipt, filter.ipt, node.iam, pipe0.75m.ipt, pipe0.85m.ipt, undergroundPipe.iam]
2014-05-23 update to node
    [Ground.ipt, chimney.ipt, dcps_mcpc.ipt, frameAssembly.iam, frame_angle_horiz.ipt, frame_angle_horiz_short.ipt, frame_uni_vert.ipt, housing.ipt]
2014-07-14 updated feed
    updated new feed drawing
    [balun.ipt, bpSupAssembly.iam, centralLine.ipt, collar.ipt, dipole.iam, dipoleArmHold.ipt, dipoleArmRest.ipt, dipoleBottomDisc.ipt]
2014-07-22 update to endcap and horiz support and feed assy
    Most of the feed update already submitted
    [dipole.iam, element.iam, endAssembly.iam, endChannel.ipt, feedAssembly.Harness1.iam, feedAssembly.Harness1.ipt, feedAssembly.iam, pvc_T_2in_modPipe.ipt]
2014-08-18 Changed endcap and fixed spar-end dims
    The endcap is a bit better and now the spars land correctly.
    [element.iam, end37.ipt, endAssembly.iam, endBlock.ipt, endChannel.ipt, endChannel_MIR.ipt, endChannel_OLD.ipt, endHoriz.ipt]
2014-08-22 more node update
    [chimney.ipt, chimneyCap.ipt, groundMesh.ipt, housing.ipt, housingLid.ipt, housingLidAssembly.iam, inlineFan.ipt, node.Harness.iam]
2014-08-25 Updated pole assembly
    [dipole.iam, element.iam, feedAssembly.Harness1.iam, feedAssembly.RFcable.iam, feedAssembly.RFcable.ipt, feedAssembly.ShortRF.iam, feedAssembly.ShortRF.ipt, feedAssembly.iam]
2014-08-26 update install procedure
    [bom.xls]
2014-08-26 Fairly major update for construction etc
    [element.iam, end37.ipt, endAssembly.iam, endChannel.ipt, endChannel_MIR.ipt, endHoriz.ipt, feedAssembly.iam, hub.iam]
2014-08-27 Fully constrained/fixed drawing set!
    [cross - OLD.ipt, cross.ipt, crossAssembly - OLD.iam, crossAssembly.iam, element.iam, hub.iam, panelBdoor.ipt, plat.ipt]
2014-08-28 fixed up feed support stuff
    [feedAssembly.iam, kevlarDown.ipt, kevlarFeed.ipt, poleAssembly.iam, pulley.ipt, spring.ipt, winchAssembly.iam]
2014-08-29 more cleanup and adding jigs
    [angleBracket.ipt, centering.iam, centeringKevlar.ipt, centeringRing.ipt, element.iam, end37.ipt, endAssembly.iam, endChannel_OLD.ipt]
2014-08-29 added jig material
    [element.iam, feedCableStay.iam, hubjig.iam, hubjig_block.ipt, hubjig_cross.ipt, hubjig_side1.ipt, hubjig_side2.ipt, hubjig_spacer.ipt]
2014-08-29 fixed hub jig issue
    [element.iam, hubjig.iam, hubjig_side1.ipt, hubjig_side2.ipt]
2014-09-04 worked on bom
    [bom.xls, procurement.xls]
2014-09-04 update to new spar sleeves and propagate that through
    [D.0002.ipt, Ground.0005.ipt, airgnd_exchange.0003.ipt, bom.0022.idw, bomHierarchical.0002.idw, bpBOM.0001.idw, bpScreen.0012.ipt, bpSubAssembly.0013.iam]
2014-09-06 moved procurement to xlsx
    [procurement.xls, procurement.xlsx]
2014-09-15 New hub support and start new feed supprot
    [bpSupAssembly.0023.iam, bpSupAssembly.0024.iam, bpSupAssembly.iam, cement.0014.ipt, cement.0015.ipt, cement.ipt, element.0143.iam, element.0145.iam]
2014-09-16 first pass on feed support
    Needs detail.
    [bpPlate.ipt, bpSupAssembly.0024.iam, bpSupAssembly.0026.iam, bpSupAssembly.iam, bpSupCross.0014.ipt, bpSupCross.0019.ipt, bpSupCross.ipt, bpSupInner1.0017.ipt]
2014-11-07 updated procedure
    [procurement.xlsx]
2014-12-02 added sheet metal hub cylinders
    [ringInner.ipt, ringOuter.ipt]
2014-12-02 redo sa hub
    [hubRings.iam, ringInner.ipt, ringOuter.ipt]
2014-12-02 hub work
    [cement.0015.ipt, cement.ipt, hubRings.iam, ringInner.ipt, ringInnerFlat.ipt, ringOuter.ipt, ringOuterFlat.idw, ringOuterFlat.ipt]
2014-12-02 hub ring drawings
    [ringInner.idw, ringInner.ipt, ringInnerFlat.ipt, ringOuter.ipt, ringOuterFlat.idw, ringOuterFlat.ipt]
2014-12-02 Added start of hubRingJig
    [hubRingJig.iam, hubRingJig45.ipt, hubRingJigCross.ipt, hubRingJigCrossShort.ipt, hubRingJigEdgeVert.ipt, hubRingJigOuter.ipt, ringInner.idw, ringInnerFlat.idw]
2014-12-03 added parameters.txt files for hub and jigs
    [parameters.txt]
2014-12-03 update to hub jig and added parameters
    [hubRingInnerWoodFull.ipt, hubRingJig.iam, hubRingJig45.ipt, hubRingJigCross.ipt, hubRingJigCrossShort.ipt, hubRingJigEdgeVert.ipt, hubRingJigInnerVert.ipt, hubRingJigOuter.ipt]
2014-12-03 make hub jig drawings
    [hubRingJig.iam, hubRingJig.idw]
2014-12-04 changed angle thickness parameter in jigs/parameters.txt
    [parameters.txt]
2014-12-04 changed angle thickness to 3mm
    [hubRingJig.iam, hubRingJig45.ipt, hubRingJigCross.ipt, hubRingJigCrossShort.ipt, hubRingJigEdgeVert.ipt, hubRingJigInnerVert.ipt]
2014-12-05 update to parameters.txt
    [parameters.txt]
2014-12-05 split outer part of hub
    Split the outer hub into two. For inner could split (which would allow
    better utilization of the sheet) or not (which would be less labor).
    [hubGuideRingOuter.ipt, hubRingJig.iam, hubRings.iam, ringOuterFlat.idw, ringOuterFullVer.ipt, ringOuterPanel.ipt, ringOuterPanel_MIR.ipt]
2014-12-05 Finished split outer hub ring and made drawing
    [conduit.ipt, hubGuideRingInner.ipt, hubGuideRingOuter.ipt, hubRings.iam, ringOuterPanel.idw, ringOuterPanel.ipt, ringOuterPanel_MIR.ipt, sleeve_spar.ipt]
2014-12-11 added dim to ring drawing
    [conduit.0008.ipt, ringOuterPanel.idw, sleeve_spar.0026.ipt]
2014-12-11 add dwg files and fixed dim on outer ring panel
    [ringInnerFlat.dwg, ringOuterPanel.dwg, ringOuterPanel.idw]
2014-12-11 update to node power/fiber ingress/egress
    [node.0019.iam, node.Power.0001.iam, node.Power.0002.iam, node.Power.iam, node.Power_3.ipt, node.iam, plinth.0005.ipt, plinth.ipt]
2014-12-12 Lots of changes to node
    [Ground.0005.ipt, Ground.ipt, groundingPerimeter.ipt, node.Power.iam, node.Power_3.ipt, node.iam, pipe_100mm_0.5m.ipt, pipe_100mm_0.75m.ipt]
2014-12-12 slight update to foundation dims
    [node.Power.iam, node.Power_3.ipt, node.iam, plinth.ipt]
2015-01-13 added stl file
2015-01-15 update to hub jig and add step file
    [hubRingJig.iam, hubRingJig.idw, hubRingJig.stp]
2015-01-30 update to hub drawing for fab
    [element.0147.iam, element.iam, hub.0041.iam, hub.iam, ringInnerFlat.dwg, ringInnerFlat_dxf.dwg, ringOuterFlat_dxf.dwg, ringOuterPanel.dwg]
2015-01-30 trying to get a standard dwg file...
    [ringInnerFlat.dwg, ringInnerFlat.idw]
2015-01-30 still trying to convert to readable format...
    [ringInnerFlat.dwg, ringInnerFlat.stp, ringInnerFlat_dxf.dwg, ringOuterFlat.stp, ringOuterFlat_dxf.dwg, ringOuterPanel.dwg]
2015-01-30 cleaned up hub outer ring stuff and make step files
    [hubRings.iam, ringOuterFlat.stp, ringOuterPanel_MIR.ipt, ringOuter_Full.ipt, ringOuter_Full_Flat.ipt, ringOuter_Split.idw, ringOuter_Split.ipt, ringOuter_Split_Flat.iam]
2015-01-30 clean up for inner ring
    [ringInner_Flat.idw, ringInner_Flat.ipt, ringInner_Flat.stp, ringOuter_Split_Flat.ipt]
2015-02-09 tweaked node appearance
    [Ground.ipt, node.iam]
2015-02-10 added collar for Rich interface
    [collar.0001.idw, collar.idw]
2015-02-10 added plinth drawing
    [plinth.idw, plinth.ipt]
2015-02-13 drawing flat panels
    [panelAFrame.ipt, panelA_onFrame.iam, panelAflat.ipt, panelB_onFrame.iam, panelBflat.ipt, panelBframe.ipt, panelC_onFrame.iam, panelCflat.ipt]
2015-02-20 update to cross-spar attachment - need to finish and update vertical spar attachment as well
    [cross - v1.ipt, cross - v2.ipt, cross.0024.ipt, cross.ipt, crossAssembly - v1.iam, crossAssembly - v2.iam, crossAssembly.0018.iam, crossAssembly.iam]
2015-02-27 update to crossassembly (not complete)
    [crossAssembly.iam, element.iam]
2015-02-27 made feed support assembly drawing
    [bpSupAssembly.0026.iam, bpSupAssembly.iam, bpSupAssembly.idw]
2015-03-02 update to feed backplane support
    [bpScreen.0012.ipt, bpScreen.ipt, bpSupArc.0005.ipt, bpSupArc.ipt, bpSupArm.0009.ipt, bpSupArm.ipt, bpSupAssembly.iam, bpSupAssembly.idw]
2015-03-02 minor screen update
    [bpScreen.ipt, bpSupAssembly.iam, element.iam, feedAssembly.0026.iam, feedAssembly.iam]
2015-03-09 removed conduit holes in hub
    [hub.iam, ringInner.ipt, ringInner_Flat.idw, ringInner_Flat.ipt, ringOuter_Split.ipt, ringOuter_Split_Flat.ipt]
2015-03-12 updated hubRingJig and drew components
    [hubRingJig.iam, hubRingJig45.idw, hubRingJigCross.idw, hubRingJigCross.ipt, hubRingJigCrossShort.idw, hubRingJigEdgeVert.idw, hubRingJigEdgeVert.ipt, hubRingJigInnerVert.ipt]
2015-03-17 update to hub pvc
    [element.iam, furringStrip1.0004.ipt, furringStrip1.ipt, furringStrip2.0004.ipt, furringStrip2.ipt, hub.iam, sleeve_spar.ipt, sparHoriz.0016.ipt]
2015-03-18 added dwgs from ACTUAL
    [hera352.dwg, panels.dwg]
2015-03-18 changed full spar with new connections and overlap strips
    [element.iam, furringStrip1.ipt, furringStrip2.ipt, hub.iam, overlapStrip1.ipt, overlapStrip2.ipt, overlapStrip3.ipt, parameters.txt]
2015-03-20 update to cross ass'y and culled some old files
    [cross - v1.ipt, cross - v2.ipt, cross.ipt, crossAssembly - v1.iam, crossAssembly - v2.iam, crossAssembly.iam, element.iam, joinerBracket.0001.ipt]
2015-03-21 minor updates to element and sparfull
    [element.iam, sleeve_supNOTUSEDNOW.ipt, sparFull.ipt]
2015-03-23 still converting over to actual pvc dims and clean-up
    [conduit.ipt, crossAssembly.iam, hub.iam, parameters.txt, ringInner.ipt, ringInner_Flat.idw, ringInner_Flat.ipt, ringInner_Flat.stp]
2015-03-23 add'l minor hub/spar updates
    [hub.iam]
2015-03-23 still fixing up hub
    [hub.iam, hubRings.iam, rebarbar.0005.ipt, rebarbar.ipt, ringInner.ipt, ringInner_Flat.idw, ringInner_Flat.ipt, sonotubeInner.ipt]
2015-03-24 new version of hub
    [hub.iam, sonotubeInner.ipt]
2015-03-24 added joinerBracket
    [joinerBracket.ipt, joinerBracketAB.ipt]
2015-03-24 getting close to good new sa version...
    [elbow_90deg_63mm.ipt, element.iam, poleAssembly.0034.iam, poleAssembly.iam, postAssembly.0055.iam, postAssembly.iam, rimAssembly.0015.iam, rimAssembly.iam]
2015-03-24 GOOD VERSION OF SA DISH - need to put in new endcaps then mesh and feed
    [element.iam, overlapStrip1.ipt, overlapStrip2.ipt, overlapStrip3.ipt, poleAssembly.iam, postAssembly.iam]
2015-03-24 added step file
    [element.stp]
2015-03-25 modified overlapStrips
    [overlapStrip1.ipt, overlapStrip2.ipt, overlapStrip3.ipt]
2015-03-25 tweaked overlapStrips and added endcap files (but not incorporated into element)
    [Hera End Cap Left.idw, Hera End Cap right.idw, Horizontal channel left and right.idw, Horizontal channel left.ipt, Horizontal channel right.ipt, angle channel.idw, angle channel.ipt, compare.iam]
2015-03-25 releasable version with new endcaps some errors corrected and some fine adjustment
    [HERA_end_cap_left.iam, HERA_end_cap_left.idw, HERA_end_cap_right.iam, HERA_end_cap_right.idw, Hera End Cap Left.idw, Hera End Cap right.idw, Horizontal channel left.ipt, cross.ipt]
2015-03-26 removed old endcap
    [element.iam, end37.ipt, endAssembly.iam, endAssembly.idw, endBlock.ipt, endChannel.ipt, endChannel_MIR.ipt, endHoriz.ipt]
2015-03-27 started to add in flat spar assembly
    [coupler_2in.ipt, pvcSection_2in.ipt, pvcSection_2in_cut4full.ipt, pvc_15deg_2in.ipt, pvc_30deg_2in.ipt, pvc_T_2in_modSplit.ipt, sparFullFlat_US.iam]
2015-03-27 flat spars
    [pvcSection_2in_cut4intermed.ipt, sparFullFlat_US.iam, sparFullFlat_US.idw, sparIntermediateFlat_US.iam]
2015-03-27 added spar (full and intermediate) drawings
    [sparFullFlat_US.iam, sparFullFlat_US.idw, sparIntermediateFlat_US.idw]
2015-03-27 added pdfs for US version and started 63mm version
    [coupler_63mm.ipt, pvcSection_63mm.ipt, pvcSection_63mm_cut4full.ipt, sparFullFlat.iam, sparFullFlat.idw]
2015-03-27 added crossAssembly drawing
    [crossAssembly.idw]
2015-03-27 added overlap strips
    [crossAssembly.idw, overlapStrip1.ipt, overlapStrip2.ipt, overlapStrip3.ipt, overlapStrips.idw, sparFullFlat_US.idw, sparIntermediateFlat_US.idw]
2015-03-27 update drawing annoations
    [crossAssembly.idw, overlapStrips.idw, sparFullFlat_US.idw, sparIntermediateFlat_US.idw]
2015-03-30 added end-hole on spars
    [sparFullFlat_US.iam, sparFullFlat_US.idw, sparIntermediate.ipt, sparIntermediateFlat_US.iam, sparIntermediateFlat_US.idw]
2015-03-30 add drawings for poles, posts, pvc and directory restructure
    [H1pl.h_Ufa-poleStandHorizAssy.idw, H1pl.v_Ufa-poleStandVertAssy.idw, H1pl_Ufa-poleAssembly.idw, H1po_m-overlapStrips.idw, H1ps_Ufa-postAssembly.idw, H1rc_Ufa-crossAssembly.idw, H1rf_Ufa-sparFullFlat_US.idw, H1ri_Ufa-sparIntermediateFlat_US.idw]
2015-03-30 added vert support
    [H1pv_Ufa-sparAssembly.idw, element.iam, poleAssembly.iam, postAssembly.iam, sparHoriz.ipt]
2015-03-31 updating pvc drawing for SA
    [H1rc_Ufa-crossAssembly.idw, H1rc_Ufa-crossAssembly_US.idw, H1rf_Sfa-sparFullFlat_SA.idw, H1ri_Ssa-sparIntermediateFlat_SA.idw, coupler_63mm.ipt, crossAssembly.iam, crossAssembly_SA.iam, crossAssembly_US.iam]
2015-03-31 tweaked cross spar for SA dims and added SA drawing
    [H1rc_Sfa-crossAssembly_SA.idw, crossAssembly_SA.iam, cross_SA.ipt, element.iam]
2015-04-15 fixed feed terminals
    [element.iam, feedAssembly.Harness1.0001.ipt, feedAssembly.Harness1.0002.iam, feedAssembly.Harness1.iam, feedAssembly.Harness1.ipt, feedAssembly.RFcable.iam, feedAssembly.RFcable.ipt, feedAssembly.ShortRF.iam]
2015-04-22 updated rim drawing
    [H1pl.v_Ufa-poleStandVertAssy.idw, H1pl_Ufa-poleAssembly.idw, H1pr.h_s-rrimHoriz.idw, H1pr.s_s-rimIntermediateSparHolder.idw, poleAssembly.iam, poleStandHoriz3.ipt, poleStandHorizAssy.iam, poleStandVert.ipt]
2015-04-27 update before syncing from GB trip
    [element.iam, feedAssembly.Harness1.iam]
2015-04-27 added new node scheme
    [hera352.dwg]
2015-04-28 updated nodes in the site drawing
    [hera352.dwg]
2015-04-28 update to element for crossassembly install
    [H1rc_Ufa-crossAssembly_US.idw, crossAssembly_US.iam]
2015-04-28 updated panel frames
    [H7jp.A_UfaA-panelAframe.idw, H7jp.B_UfaA-panelBframe.idw, element.idw, panelAFrame.ipt, panelA_onFrame.iam, panelBframe.ipt]
2015-04-28 update to hera352 and partnumbers
    [hera352.dwg]
2015-04-29 Added holes and made dwg package for left endcap
    [H1pe.l_SCa-endCapLeft.dwg, HERA_end_cap_left.iam, Horizontal channel left.ipt, angle channel.ipt, ring support left.ipt, side plate.ipt]
2015-04-29 added panel frame drawings
    [H7jp.A_UfaA-panelAframe.idw, H7jp.B_UfaA-panelBframe.idw, H7jp.C_UfaA-panelCframe.idw, H7jp.D_UfaA-panelDframe.idw, H7jp.E_UfaA-panelEframe.idw, panelB_onFrame.iam, panelCframe.ipt, panelDframe.ipt]
2015-04-29 added panels D/E on frame
    [panelD_onFrame.iam, panelE_onFrame.iam]
2015-04-29 began to fix backplane
    [bpMechSupAssembly.iam, bpPlate.ipt, bpSupAssembly.iam, bpSupCross.ipt, bpSupInner1.ipt, bpSupInner2.0015.ipt, bpSupInner2.ipt, collar.0004.ipt]
2015-04-30 updated site drawing based on new nodes
    [hera352.dwg]
2015-05-01 update to nodes in dwg -- optimized with two different avoidance constraints
    [hera352.dwg]
2015-05-05 added new feed backplane
    [bpCylinder.ipt, bpSupArm.ipt, bpSupAssembly.iam, dipole.0030.iam, dipole.iam, element.iam, feedAssembly.iam, hub.iam]
2015-05-05 updated mesh frame drawing to include dirction of unroll
    [H7jp.A_UfaA-panelAframe.idw, H7jp.B_UfaA-panelBframe.idw, H7jp.C_UfaA-panelCframe.idw, H7jp.D_UfaA-panelDframe.idw, H7jp.E_UfaA-panelEframe.idw]
2015-05-07 update to panel.dwg
    [panels.dwg]
2015-05-07 mechanical backplane drawings added
    [H2f2.c_U-bpSupCross.idw, H2f2.d_U-bpPlate.idw, H2f2.i1_U-bpSupInner1.idw, H2f2.i2_U-bpSupInner2.idw, H2f2_U-bpMechSupAssembly.idw, bpMechSupAssembly.iam, bpPlate.ipt, bpSupArm.ipt]
2015-05-07 updated panels and mech bp pdfs
    [panels.dwg]
2015-05-07 renamed to account for collar
    [H2f2.c_U-bpSupCross.idw, H2f2.c_U-collar.idw, H2f2.l_U-bpSupCross.idw, collar.idw]
2015-05-07 more frontend file renaming
    [H2f2.d_U-bpPlate.idw, H2f2.i1_U-bpSupInner1.idw, H2f2.i2_U-bpSupInner2.idw, H2f2.l_U-bpSupCross.idw, H2f2.m_U-bpMechSupAssembly.idw, H2f2.md_U-bpPlate.idw, H2f2.mi1_U-bpSupInner1.idw, H2f2.mi2_U-bpSupInner2.idw]
2015-05-07 lots of renaming!
    [H2b_U-bpSupAssembly.idw, H2bm.i_U-bpSupInner1.idw, H2bm.l_U-bpSupCross.idw, H2bm.p_U-bpPlate.idw, H2bm.s_U-bpSupInner2.idw, H2bm_U-bpMechSupAssembly.idw, H2c_U-collar.idw, H2dt_U-dipoleTopDisc.idw]
2015-05-08 updated rim spar holder
    [H1pr.s-rimIntermediateSparHolder.idw, H1pr.s_s-rimIntermediateSparHolder.idw, rimIntermediateSparHolder.ipt]
2015-05-18 fixed Dennis line issue
    [H2bm_U-bpMechSupAssembly.idw]
2015-05-18 changing feed over to SA units
    [H2bm-bpMechSupAssembly.idw, H2bm.i_Sa-bpSupInner1.idw, H2bm.l_Sa-bpSupCross.idw, H2bm.p_Sa-bpPlate.idw, H2bm.s_Sa-bpSupInner2.idw, H2bm_U-bpMechSupAssembly.idw, H2c_Sa-collar.idw, bpMechSupAssembly.iam]
2015-05-19 renamed idw/pdf for new pn naming
    [H1pl-AU_a_poleAssembly.idw, H1pl-hAU_a_poleStandHorizAssy.idw, H1pl-vAU_a_poleStandVertAssy.idw, H1po-mA_a_overlapStrips.idw, H1pr-hA_a_rimHoriz.idw, H1pr-sA_a_rimIntermediateSparHolder.idw, H1psAU_a_postAssembly.idw, H1pvAU_a_sparAssembly.idw]
2015-05-20 updating feed
    [angleBracketB.ipt, bpCylinder.ipt, bpScreen.ipt, bpScreenAssembly.iam, bpSparJig.ipt, bpSupArc.ipt, bpSupArm.ipt, bpSupVertArm.ipt]
2015-05-21 continued with feed update
    [D.0002.ipt, D.ipt, angleBracketB.ipt, bpScreenAssembly.iam, bpSupAssembly.iam, bpSupVertArm.ipt, centralLine.0003.ipt, centralLine.ipt]
2015-05-22 added clocking to orient the feed north
    [H2bm-lB_a_bpSupCross.idw, H2bm-pB_a_bpPlate.idw, H2cB_a_collar.idw, H2dtB_a_dipoleTopDisc.idw, bpMechSupAssembly.iam, bpPlate.ipt, bpSupAssembly.iam, bpSupCross.ipt]
2015-05-29 added bridge and tweaked feed bp assembly
    [bpScreenAssembly.iam, bpSupAssembly.iam, bridge.iam, bridge.idw, element.iam, w2x4_bridgeCross.ipt, w2x4_bridgeDown.ipt, w2x4_bridgeDown2.ipt]
2015-05-29 fixed feed bp drawing
    [H2bAU_a_pSupAssembly.idw, bpScreenAssembly.iam, bpSupArm.ipt]
2015-06-04 added rebar central spike
    [bpScreenAssembly.iam, bpSupAssembly.iam, bridge.iam, centerSpike.ipt, element.iam, feedAssembly.iam]
2015-06-08 added paper config
    [config_psa128.dwg, hera352.dwg]
2015-06-19 updated overlap strips and added pins for hub spars
    [element.iam]
2015-07-05 moved trench that crept in with new nodes away from H19
    [hera352.dwg]
2015-07-07 Changed grounding loop below node
    [groundingPerimeter.ipt, node.iam]
2015-07-13 deleted unused file (psa128)
    [config_psa128.dwg]
2015-07-15 update to feed
    [bpScreenAssembly.iam, dipole.iam, feedAssembly.iam]
2015-07-23 Node layout mods; rim assembly WIP
    [element.iam, node.iam, pipe_50mm_0.5m.ipt, pipe_50mm_Long.ipt, pipe_6in_0.5m.ipt, pipe_6in_0.85m.0001.ipt, pipe_6in_0.85m.ipt, pipe_6in_1.5m.ipt]
2015-07-29 update to feed stuff
    [H2bAU_a_pSupAssembly.idw, bpScreenAssembly.iam, bpSupArc.ipt, bpSupAssembly.iam, feedAssembly.iam]
2015-08-14 added paper mast and collar as well as updated the dipoleMast
    [collar_paper.ipt, dipoleMast.0003.ipt, dipoleMast.0004.ipt, dipoleMast.ipt, element.iam, mast_paper.ipt]
2015-08-22 added cross-hatch to hera352.dwg
    [hera352.dwg]
2015-08-31 indeterminate changes...
    [dipole.iam, feedAssembly.iam]
2015-09-03 add H127 to .dwg
    [hera352.dwg]
2015-09-29 Mostly node layout and pipe size update
    [element.iam, hera352.dwg, node.iam, pipe_50mm_0.5m.ipt, pipe_50mm_Long.ipt, pipe_6in_0.5m.ipt, pipe_6in_0.85m.ipt, pipe_6in_1.5m.ipt]
2015-10-15 updated feed central line assembly
    [bpCylinder.ipt, bpScreen.ipt, bpSupArc.ipt, bpSupArm.ipt, element.iam, feedAssembly.iam, poleAssembly.iam, poleStandHorizAssy.iam]
2015-10-19 copied endcap folder to new endcapsChannelVersion folder so current endcap folder can be overwritten as needed
    [H1pe.l_SCa-endCapLeft.dwg, HERA_end_cap_left.iam, HERA_end_cap_left.idw, HERA_end_cap_right.iam, HERA_end_cap_right.idw, Horizontal channel left and right.idw, Horizontal channel left.ipt, Horizontal channel right.ipt]
2015-10-19 SA version endcaps
    [EndcapSpacer.ipt, H1pe.l_SCaC-endCapLeft.idw, H1pe.r_SCaC-endCapRight.idw, endCapOptionRight.iam, endcapOptionLeft.ipt, endcapOptionLeftAngle.ipt, endcapOptionRight.ipt, endcapOptionRightAngle.ipt]
2015-10-19 SA version endcaps, fixed file ref
    [H1pe.l_SCaC-endCapLeft.idw, endcapLeft.iam]
2015-10-19 Feed cage and collar changes
    [bpCylinder.ipt, bpScreen.ipt, bpScreenAssembly.iam, bpSparJig.ipt, bpSupArc.ipt, bpSupArm.ipt, bpSupAssembly.iam, bpSupVertArm.ipt]
2015-10-22 added new central line
    [centralLineAssy.iam, centralLineLower.ipt, centralLineSplitter.ipt, centralLineUpper.ipt]
2015-10-22 making new endcap channels for UK - step 1
    [HERA_end_cap_left.iam, Horizontal channel left.ipt, Horizontal channel right.ipt, angle channel.ipt]
2015-10-22 convert to UK endcaps step 2
    [HERA_end_cap_right.iam, side plate.ipt]
2015-10-22 convert to UK endcaps step 3
    [HERA_end_cap_right.iam, Horizontal channel right.ipt]
2015-10-22 completed RHS of new UK endcaps
    [H1pe.l_SCa-endCapLeft.dwg, HERA_end_cap_left.iam, HERA_end_cap_left.idw, HERA_end_cap_right.dwg, HERA_end_cap_right.iam, HERA_end_cap_right.idw, Horizontal channel left and right.idw, Horizontal channel left.ipt]
2015-10-22 updated central line drawing 1
    [bpScreenAssembly.iam, bpSupAssembly.iam, centralLineLower.ipt, centralLineSplitter.ipt, dipole.iam, feedAssembly.iam]
2015-10-29 Pole layout for 127 antennae, and more container
    [hera352.dwg]
2015-10-29 added outer antennas to numbering and nodes in hera352.dwg
    [hera352.dwg]
2015-10-29 Some feed mods, incomplete
    [bpScreenAssembly.iam, bpSupAssembly.iam, dipole.iam, feedAssembly.iam]
2015-10-29 Small feed mods
    [angleBracketB.ipt, bpSupArc.ipt, pvc_T_0.75in.ipt, sweep_6in.0001.ipt]
2015-10-30 Feed cage - South African version
    [bpScreenAssembly.iam, bpSupArc.ipt, bpSupArm.ipt, bpSupAssembly.iam, element.iam, feedAssembly.iam]
2015-11-09 SA post bases
    [element.iam, postAssembly.iam, postCement.ipt, postRebar.ipt]
2015-11-19 Node assembly reconfig to H-19 version
    [node.iam, pipe_50mm_0.5m.ipt, pipe_50mm_Long.ipt, plinth.ipt, pullBoxPower.iam, pullboxFiber.iam, pullboxFiber.ipt, pullboxFiberLid.ipt]
2015-11-19 Confirming SA duct size
    [pipe_50mm_0.5m.ipt]
2015-11-19 pole support mod to installed SA version
    [bpScreenAssembly.iam, centralLineAssy.iam, feedAssembly.iam, node.iam, poleAssembly.iam, poleStandVert.ipt, poleStandVertAssy.iam, postAssembly.iam]
2015-11-19 overlooked files from last commit
    [centralLineLower.ipt, element.iam, pullBoxPower.iam]
2015-12-10 updated feed-cage
    [bpCylinder.ipt, bpScreen.ipt, bpScreenAssembly.iam, bpSupAssembly.iam, bpSupVertArm.ipt, dipole.iam, dipoleMast.ipt, feedAssembly.iam]
2015-12-10 fixed mast insertion and added quickie feed assembly drawing
    [feedAssembly.iam, feedAssembly2.dwg]
2016-01-15 updated hera352.dwg, but more importantly changed to heraSite.dwg
    [heraSite.dwg]
2016-01-16 put in poles for new split core config
    [heraSite.dwg]
2016-01-22 New Pulldown Assembly with manufacturing instructions
    [CentralLine.iam, CentralLine.idw, CentralLine.ipt, SingleUpperLine.ipt, Splitter.ipt, bpMechSupAssembly.iam, bpPlate.ipt, bpSupArm.ipt]
2016-01-27 reconcile with K
    [feedAssembly.iam]
2016-02-03 Outer hub as-built with dxfs
    [H1HI-B_a_hub_inner_sheetmetal.dxf, H1HO-B_a_hub_outer_sheetmetal.dxf, hub_outer_sheetmetal.ipt]
2016-02-03 Inner hub ring as-built update
    [ringInner_revB.ipt]
2016-02-03 Outer hub added to assembly
    [hub.iam, hub_outer_sheetmetal.ipt]
2016-02-03 added hub pdfs
    [heraSite.dwg]
2016-03-11 added new antenna numbers to heraSite.dwg
    [heraSite.dwg]
2016-03-11 misc assembly relation updates + hub dwg
    [CentralLine.iam, element.iam, feedAssembly.iam, hub.iam, hub_outer_sheetmetal.ipt]
2016-03-11 Trench mods for new node positions
    [heraSite.dwg]
2016-03-11 tweaks to herasite trenching
    [heraSite.dwg]
2016-03-30 40mm node flange part added
    [40mm_flange.ipt]
2016-04-14 added one floating SNAP to node
    [132143_iges_file.ipt, 171-015-103.ipt, BGA676C100P26X26_2700X2700X260_U25.ipt, BOARD.ipt, Bot Heat Sink.ipt, CAPAE830X1050D995DD305L335N_C191.ipt, CAPAE830X1050D995DD305L335N_C230.ipt, CAPAE830X1050D995DD305L335N_C237.ipt]
2016-04-21 Post base parts update
    [ConcreteFormwork.ipt, ConcreteFormwork2.ipt, PostBaseJigs.iam, element.iam, postAssembly.iam, postRebar.ipt, postRebarRadial.ipt]
2016-04-21 New container location
    [heraSite.dwg]
2016-04-28 Container layout modification
    [heraSite.dwg]
2016-05-12 Location of container pad added, some cooling trenches added.
    [heraSite.dwg]
2016-05-31 moved everything by a massive 3cm
    [hera352.dwg, heraSite.dwg]
2016-06-06 Update to hub assembly, prior to messing with fullSpar assembly
    [cement.ipt, hub.iam, sonotubeInner.ipt, sparHoriz_B.ipt, sparVert_C.ipt]
2016-06-06 Updated fullSpar definition and propagated nailHead value change
    [element.iam, sleeve_spar.ipt, sparAssembly.iam, sparFull.ipt, sparVert_C.idw]
2016-06-06 Feed mechanical backplane hole drill size change
    [bpMechSupAssembly.iam, bpSupAssembly.iam, bpSupCross.ipt, bpSupInner1.ipt, bpSupInner2.ipt, feedAssembly.iam]
2016-06-06 Backplane and collar dwgs added
    [H2BM-B_a_bpMechSupAssembly.idw, H2C-D_a_collar.idw]
2016-06-08 Panel drawings
    [H1RS-B_Sa-PanelB.dwg, H1RS-C_Sa-PanelC.dwg, H1RS-D_Sa-PanelD.dwg, H1RS-E_Sa-PanelE.dwg, H1RS.A_SSA-PanelA.dwg]
2016-06-20 Adding enclosureNode cad
    [enclosureNode.ipt]
2016-06-21 enclosure step file
    [enclosureNode.stp]
2016-06-23 converted enclosureNode to 2016
    [enclosureNode.ipt, enclosureNode.stp]
2016-06-27 heraSite node location update with utility boxes added in
    [heraSite.dwg]
2016-06-28 added missing stackbox and cooling loop to node layer
    [heraSite.dwg]
2016-06-28 node #3 stackbox moved
    [heraSite.dwg]
2016-06-28 Node plinth part and drawings updated for new power layout
    [H3P-Ca.idw, plinth.ipt]
2016-07-04 Node plinth and general arrangement drawings updated
    [H3P-Ca.idw, H3_trench_elevation.dwg, plinth.ipt]
2016-07-14 updated node dimensions
    [enclosureNode.ipt]
2016-07-19 adding node placement on plinth and rack component diagram
    [node_outline.dwg, node_outline.ipt, node_outline.stp]
2016-07-19 node enclosure to autodesk 2016
    [enclosureNode.ipt]
2016-07-19 updated feed backplane
    [H2bs-cA-bpSupArc.idw, H2bs-hA-bpSupArm.idw, bpSupArm.ipt]
2016-07-20 first panel version
    [panel.ipt]
2016-08-01 commitment issues
    [crossAssembly_SA.iam, cross_SA.ipt, element.iam, heraSite.dwg, hub.iam, nail_20d.ipt, node.iam, parameters.txt]
2016-08-05 Added a rack frame, sliding shelf and relevant assemblies
    [enclosureNode.ipt, enclosureRackPlinth.iam, nodechimneypanels.iam, panel.ipt, rackAssembly.iam, rackBase.ipt, rackTop.ipt, slidingShelf.ipt]
2016-08-08 preamp beginnings
    [preamp.ipt]
2016-08-18 enclosureRackPlinth with pam,monitor control and power
    [DB15_F.ipt, PAMz.iam, SMA Jack Bulkhead small nut.ipt, SMA Jack Bulkhead small nut.step, enclosureRackPlinth.iam, monitorControl.iam, monitorControl.ipt, panel.ipt]
2016-08-18 HeraSite update with as-dug stackbox locations and Node 3 centre
    [heraSite.dwg]
2016-08-18 updated config and cleaned up heraSite.dwg
    [heraSite.dwg]
2016-08-26 adding most recent NRAO SNAP enclosure design in pack and go folder
    [132143_iges_file.ipt, 171-015-103.ipt, ANSI (in).dwg, ANSI (in).idw, ANSI (mm).dwg, ANSI (mm).idw, BGA676C100P26X26_2700X2700X260_U25.ipt, BOARD.ipt]
2016-08-30 Added STEP file of assembly in Workspaces folder
    [SNAP 8x10x1.75 Ver1.stp]
2016-09-09 mezzanine board and actual PAM chassis from vendor files
    [24563142.iam, 24563142_01.ipt, 24563142_02.ipt, 24563142_03.ipt, 24563142_04.ipt, 24563142_05.ipt, 24563142_06.ipt, 24563142_07.ipt]
2016-09-17 Schroff PAM assembly, power rating for PAM and SNAP
    [24563142_01.ipt, 24563142_02.ipt, 24563142_03.ipt, 24563142_04.ipt, 24563142_05.ipt, 24563142_06.ipt, 24563142_07.ipt, 24563142_08.ipt]
2016-10-05 new db37 in mezzanine, backup for snapv2, WR_LEN
    [132143_iges_file.ipt, 171-015-103.ipt, 173-E37-113.STEP, 173-E37-113.ipt, ANSI (in).dwg, ANSI (in).idw, ANSI (mm).dwg, ANSI (mm).idw]
2016-10-06 Added d sub 9 power on snap enclosure and moved files
    [173-E37-113.ipt, Assembly1.iam, D-SUB_9.SLDPRT, D-SUB_9.ipt, R58010-175-with SNAP V2 features.ipt, SNAP 8x10x1.75 Ver1.A.iam, Thermal pad .100.ipt, dsub37Bracket.ipt]
2016-10-20 new feed cage for hera-37
    [FeedHoop37.ipt, FlatTee.ipt, bpMechSupAssembly.iam, bpScreen.ipt, bpScreenAssembly.iam, bpSupArm37.ipt, bpSupAssembly.iam, bpSupAssy37.iam]
2016-10-23 DB37 and DB9 cutouts on SNAP enclosure and mezzanine card assembly
    [173-E37-113.ipt, 174E-037-213.STEP, 174E-037-213.ipt, 37 female face.ipt, 37 gender changer middle.ipt, 37 male face.ipt, D-SUB_9.SLDPRT, D-SUB_9.ipt]
2016-10-24 deleted backup and fixed SNAP assembly
    [132143_iges_file.ipt, 171-015-103.ipt, 22-0365-0100(18).ipt, 22-0375-1301(1).ipt, 22-0375-2501(1).ipt, 22-0405-00(30).ipt, 26-0024-0502(1).ipt, ANSI (in).dwg]
2016-10-28 quote enclosure drawings
    [Bot Heat Sink.ipt, R58010-175-with SNAP V2 features.ipt, R58010-175_ALL.dwg, R58010-175_FRONT.dwg, R58010-175_LEFT.dwg, R58010-175_REAR.dwg, R58010-175_RIGHT.dwg, SNAP 8x10x1.75 Ver1.A.iam]
2016-10-31 Dsub37 added dimensions
    [Bot Heat Sink.ipt, R58010-175-with SNAP V2 features.ipt, R58010-175_ALL.dwg, R58010-175_FRONT.dwg, R58010-175_LEFT.dwg, R58010-175_REAR.dwg, R58010-175_RIGHT.dwg, Top Heat Sink.ipt]
2016-11-03 Rearranged folders, shortened names, cleaned up old files
    [132143_iges_file.ipt, 171-015-103.ipt, 173-E37-113.ipt, 174E-037-213.STEP, 174E-037-213.ipt, 22-0365-0100(18).ipt, 22-0375-1301(1).ipt, 22-0375-2501(1).ipt]
2016-11-14 Node - added constraingts, flanges, changed plinth to prototype version
    [RFI_power_filter.ipt, plinth_RevA-prototype.ipt]
2016-11-29 Proper element view restoration
    [element.iam]
2016-11-30 Node Enclosure detail modes, recast into an Enclosure Assy
    [EnclosureAssy.iam, EnclosureDetail.ipt, EnclosureDoor.ipt, nodechimneypanels.iam, panel.ipt, powerBox.ipt, rackAssembly.iam]
2016-11-30 plinth screen added and constraints fixed
    [EnclosureDetail.ipt, enclosureNode.ipt, nodechimneypanels.iam, panel.ipt, plinthScreen.ipt]
2016-11-30 Added panel with cutouts
    [BOARD.ipt, COMPONENTS.iam, SNAP 8x10x1.75 Ver1.A.iam, enclosureNode.ipt, panelWithCutouts.ipt]
2016-12-02 Node Enclosure Complete Design Rev A
    [CoolingSleeve.ipt, EnclosureAssy.iam, EnclosureDetail.ipt, RFI_power_filter.ipt, chimneyAssy.iam, chimneyHousing.ipt, chimneyRoof.ipt, enclosureFloorFlange.ipt]
2016-12-02 checked out enclosureNode.ipt and enclosureRackPlinth.iam from daves repo
    [enclosureNode.ipt, enclosureRackPlinth.iam]
2016-12-03 Grounding lug nut added
    [EnclosureDetail.ipt, enclosureRackPlinth.iam]
2016-12-04 Minor hole detailing and assy changes, added node encl. assy drawings
    [8-32ventScrew.ipt, EnclosureAssy.iam, EnclosureAssy.idw, EnclosureBody.idw, EnclosureDetail.ipt, EnclosureDoor.ipt, FloorFrame.idw, SidePanelBlank.idw]
2016-12-04 Line filter interface modify
    [EnclosureAssy.iam, EnclosureAssy.idw, EnclosureBody.idw, EnclosureDetail.ipt, panel.ipt, panelFrame.ipt]
2016-12-04 EnclosureBody mop-up save
    [EnclosureBody.idw]
2016-12-04 Notes added to Enclosure Body dwg.
    [EnclosureBody.idw]
2017-01-31 Node enclosure concept from ICTS added
    [HERA_NODE_SHIELDED_ENCLOSURE_ITC_CONCEPT.iam, HERA_NODE_SHIELDED_ENCLOSURE_ITC_CONCEPT1.ipt, HERA_NODE_SHIELDED_ENCLOSURE_ITC_CONCEPT10.ipt, HERA_NODE_SHIELDED_ENCLOSURE_ITC_CONCEPT11.ipt, HERA_NODE_SHIELDED_ENCLOSURE_ITC_CONCEPT12.ipt, HERA_NODE_SHIELDED_ENCLOSURE_ITC_CONCEPT13.ipt, HERA_NODE_SHIELDED_ENCLOSURE_ITC_CONCEPT14.ipt, HERA_NODE_SHIELDED_ENCLOSURE_ITC_CONCEPT15.ipt]
2017-03-08 updated dwg for new nodes
    [heraSite.dwg]
2017-03-08 moved one node
    [heraSite.dwg]
2017-03-09 cleaned up heraSite.dwg
    [heraSite.dwg]
2017-03-10 conflict res on heraSite.dwg
    [heraSite.dwg]
2017-03-15 General measurement layers added
    [heraSite.dwg]
2017-03-17 Node 26 27 28 Placement
    [heraSite.dwg]
2017-03-25 PDU and NMT parts and drawings
    [Bot Heat Sink.stp, GCLP37M37F.iam, PDU_chassis.DXF, PDU_chassis.dwg, PDU_chassis.ipt, PDU_chassis.stp, PDU_chassis_back.DXF, PDU_chassis_back.dwg]
2017-03-27 Added HERA-61 layer
    [heraSite.dwg]
2017-04-12 Altered rack diagram layout
    [Bot Heat Sink.stp, R58010-175-with SNAP V2 features.stp, RFT 8x10 Cover-alt-base.stp, RFT 8x10 Cover.stp, Top Heat Sink.stp, mezzanineBracketLeft.stp, mezzanineBracketRight.stp, mounting rail 7.0 x.250 x .250.stp]
2017-05-02 commit to merge with krosie
    [heraSite.dwg]
2017-05-02 MEasuring circles, some node movement
    [heraSite.dwg]
2017-06-01 ITCS Prototype Node Manufacturing Assy
    [EYE-BOLT FREE ISSUE.ipt, P-FHS-M6-18.ipt, RD-A001-P001-REV0.ipt, RD-A001-P002-REV0.ipt, RD-A001-P003-REV0(Default).ipt, RD-A001-P003.iam, RD-A001-P003_1.iam, RD-A001-P004-REV0.ipt]
2017-06-09 Node position and trench adjustments
    [heraSite.dwg]
2017-06-09 Node placement
    [heraSite.dwg]
2017-06-13 Core node positions finalised
    [heraSite.dwg]
2017-06-13 Trench lengths corrected
    [heraSite.dwg]
2017-09-29 Added drawings for Production Robotics and production files for assembly instructions
    [132143_iges_file.ipt, 174E-037-213.ipt, 22-0365-0100(18).ipt, 22-0375-1301(1).ipt, 22-0375-2501(1).ipt, 22-0405-00(30).ipt, 26-0024-0502(1).ipt, 37 female face.ipt]
2017-11-21 adding intense amounts of files
    [Bot Heat Sink_092717.ipt, HERA_NODE_SHIELDED_ENCLOSURE_ITC_CONCEPT.iam, PDU_NMT_bottom.dwg, PDU_NMT_bottom.ipt, PDU_NMT_front.dwg, PDU_NMT_front.dxf, PDU_NMT_front.ipt, PDU_NMT_front_origin.dwg]
2017-11-21 ssl version files
    [panel.dwg, panel.stp, panel_waveguide.stp, panel_waveguide_assembly.dwg, panel_waveguide_page2.dwg, waveguide.dwg, waveguide.stp]
2017-12-15 updated node rack assembly
    [24563142_01.ipt, 24563142_02.ipt, 24563142_03.ipt, 24563142_04.ipt, 24563142_05.ipt, 24563142_06.ipt, 24563142_07.ipt, 24563142_08.ipt]
2018-01-24 FEM 2U power supply first commit
2018-02-26 cleaned up nmt_pdu merge directory and renamed it to PCB
    [PCB_NMT_bottom.dwg, PCB_NMT_front.dwg, PCB_assembly.iam, PCB_bottom.ipt, PCB_chassis_back.dwg, PCB_chassis_back.ipt, PCB_front.ipt, PCB_front_origin.dwg]
2018-03-07 updated dsub9 hole sizes, added bracket holes, changed layout
    [PCB_NMT_bottom.dwg, PCB_NMT_front.dwg, PCB_assembly.iam, PCB_back.dwg, PCB_back.ipt, PCB_bottom.dwg, PCB_bottom.ipt, PCB_bracket.dwg]
2018-03-07 Changed dsub9 hole size
    [Bot Heat Sink_092717.ipt, R58010-175-with SNAP V2 features.dwg, R58010-175-with SNAP V2 features_092717.ipt, R58010-175-with SNAP V2 features_pr.dwg, R58010-175_ALL.dwg, R58010-175_LEFT_pr.dwg, R58010-175_REAR_pr.dwg, R58010-175_RIGHT_pr.dwg]
2018-03-14 updated 3/14/18
    [PCB_back.dwg, PCB_back.ipt, PCB_back.stp, PCB_bottom.dwg, PCB_bottom.stp, PCB_bracket.dwg, PCB_bracket.ipt, PCB_bracket.stp]
2018-04-02 updated 4/2/18
    [PCB_bracket.dwg, PCB_metalplate.dwg, PCB_metalplate.ipt, PCB_metalplate.stp, node_layout_birdeye.dwg, outer_heatsink.ipt, panel_waveguide_assembly.dwg, snap_mount.iam]
2018-04-09 updated ubracket holes for snap mount
    [PCB_front.ipt, node_layout_birdeye.dwg, snap_mount.iam, ubracket.dwg, ubracket.ipt, uchannel.ipt]
2018-04-13 white rabbit hole pattern
    [PCB_bottom.ipt, node_layout_birdeye.dwg, white_rabbit_bottom_holes.dwg]
2018-04-13 reduced markings upon ink police suggestion
    [white_rabbit_bottom_holes.dwg]
2018-04-18 changed file names for consistency
    [Bot Heat Sink.ipt, R58010-175-with SNAP V2 features.dwg, R58010-175-with SNAP V2 features.ipt, R58010-175_ALL_pr.dwg, RFT 8x10 Cover-alt-base.ipt, RFT 8x10 Cover.ipt, Top Heat Sink.ipt, mounting rail 7.0 x.250 x .250.ipt]
2018-04-18 cover files
    [R58010-175-with SNAP V2 features.dwg]
2018-04-19 fem psu drawing and pdf
    [FEM_PSU.dwg, FEM_PSU.iam, SK47_Black Anodized 75mm.ipt, c1550al.ipt, fem_psu_base.ipt, fem_psu_cover.ipt, fem_psu_side.ipt, fn9260-x-06.iam]
2018-04-23 updated 4-23-18 with more dimensions
    [FEM_PSU.dwg]
2018-04-27 not sure what probaby just a view changed
    [HERA_NODE_SHIELDED_ENCLOSURE_ITC_CONCEPT.iam]
2019-01-26 added new dsub37 bracket
    [dsub37bracket_redraw.dwg, dsub37bracket_redraw.ipt, dsub37bracket_redraw_left.dwg, dsub37bracket_redraw_left.ipt, dsub37bracket_redraw_right.dwg, dsub37bracket_redraw_right.ipt]
